andreika-git/hellen-one/modules/readme.md

This folder contains KiCAD footprints/gerbers/PDFs which hellen-one framework would merge into your frame design.

See https://github.com/andreika-git/hellen-one/wiki for module documentation
