andreika-git/hellen-one/modules/wbo/readme.md

[Source files](../../kicad/modules/hellen1-wbo)

## Changelog

0.6:
  - removed external MOSFET
  - reduced 3mm length
  - removed BIG thermal via
  - SOT-223 MOSFET

0.4:
  - two side assembly
  - BUG: CANH/CANL traces are flipped

0.3: 
  - MOSFET through-hole option 
  - https://github.com/andreika-git/hellen-one/blob/master/modules/wbo/wbo-0.3-migration.png remove one track and refill zones
     
0.3 v2:
  - 1mm vias under MOSFET for hand soldering

## Hardware Index
