andreika-git/hellen-one/modules/power_12and5V/readme.md

See https://github.com/andreika-git/hellen-one/wiki/module-power12-and-5

0.3
	- Vbat reverse diode on RTC LDO output

0.2
	- diodes silk fix
	- VIGN LED fix
