andreika-git/hellen-one/modules/power12/readme.md

See [power_12and5V](../power_12and5V) for a more integrated option.
