andreika-git/hellen-one/modules/vr-discrete/readme.md

See https://github.com/andreika-git/hellen-one/wiki/module-vr-discrete

[Source files](../../kicad/modules/hellen1-vr-discrete)
