andreika-git/hellen-one/modules/power5/0.2/power5-pcb3d.pdf

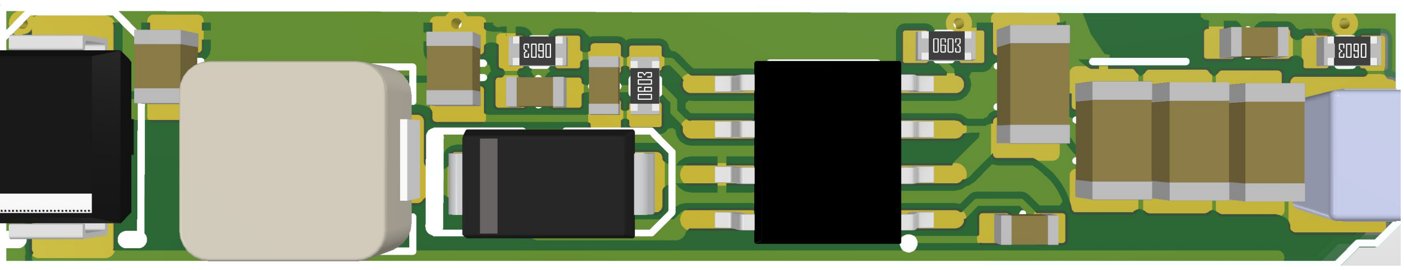
[picture p2: figure]
