andreika-git/hellen-one/modules/lin/0.1/lin-pcb3d.pdf

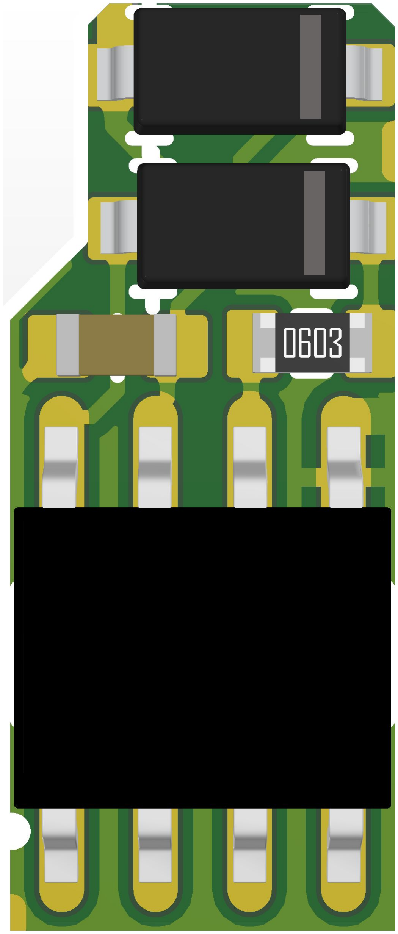
[picture p3: figure]
