andreika-git/hellen-one/modules/vr-max9924/0.1/vr-max9924-BOM.csv

Comment | Designator | Footprint | LCSC Part #
1n | C771 | C0603 | C1588
100n | C772 | C0603 | C14663
22u | C773 | C0603 | C59461
LED-GREEN-0603 | D771 | LED-0603 | C72043
Module:vr-max9924/0.1 | M771 | vr-max9924
4.7k | R771 | R1206 | C17936
4.7k | R772 | R1206 | C17936
4.7k | R773 | R1206 | C17936
4.7k | R774 | R1206 | C17936
DNP | R775 | R0603
10k | R776 | R0603 | C25804
10k | R777 | R0603 | C25804
MAX9924UAUB+ | U771 | MSOP-10_3x3mm_P0.5mm | C143633
