andreika-git/hellen-one/modules/knock/0.2/knock-BOM.csv

Comment | Designator | Footprint | LCSC Part #
100n | C470 | C0402 | C307331
3.3n | C471 | C0402 | C26404
330p | C472 | C0402 | C13533
47p | C473 | C0402 | C1567
680p | C474 | C0603 | C1630
Module:knock/0.2 | M470
470k | R470 | R0402 | C25790
100k | R471, R473 | R0402 | C25741
12k | R472 | R0402 | C25752
33k | R474 | R0402 | C25779
LMV321IDBVR | U470, U471 | SOT23-5 | C7972
