andreika-git/hellen-one/modules/sd/0.1/sd-BOM.csv

Comment | Designator | Footprint | LCSC Part #
22u | C450, C451 | C0603 | C59461
Molex MicroSD 47219-2001 | J450 | SDAMB-012 | C164170
Hellen One : microSD Module interface | M450
33k | R450 | R0603 | C4216
