andreika-git/hellen-one/modules/lin/0.1/lin-BOM.csv

Comment | Designator | Footprint | LCSC Part #
100n | C440 | C0603 | C14663
B5819W | D440, D441 | SOD-123 | C8598
Hellen One : LIN Module interface | M440
1k | R440 | R0603 | C21190
TJA1021T/20/CM | U440 | SO8 | C128810
