andreika-git/hellen-one/tests/boards.EXAMPLE/hellen1test-a/frame/1test-BOM.csv

Comment | Designator | Footprint | LCSC Part #
Module:can/0.1 | M1 | can
Pad | P1 | PAD-TH
Pad | P2 | PAD-TH
Pad | P3 | PAD-TH
Pad | P4 | PAD-TH
Pad | P5 | PAD-TH
Pad | P6 | PAD-TH
Pad | P7 | PAD-TH
