andreika-git/hellen-one/tests/gerber/hellen1test.csv

Comment | Designator | Footprint | LCSC Part #
Module-can-0.1 | M1 | hellen-one-can-0.1:can
Pad | P1 | hellen-one-common:PAD-TH
Pad | P2 | hellen-one-common:PAD-TH
Pad | P3 | hellen-one-common:PAD-TH
Pad | P4 | hellen-one-common:PAD-TH
Pad | P5 | hellen-one-common:PAD-TH
Pad | P6 | hellen-one-common:PAD-TH
Pad | P7 | hellen-one-common:PAD-TH
