andreika-git/hellen-one/modules/uaefi/0.2/uaefi-BOM.csv

Comment | Designator | Footprint | LCSC Part #
Conn_01x05_Pin | J801 | Molex_SPOX_5267-05A_1x05_P2.50mm_Vertical | C492404
Conn_01x03_Pin | J802 | 1x3_2.54 | C49257
Conn_02x02_Odd_Even | J803 | 2x2_2.54 | C492419
Conn_02x02_Odd_Even | J804 | 2x2_2.54 | C492419
Conn_02x02_Odd_Even | J805 | 2x2_2.54 | C492419
Conn_02x02_Odd_Even | J806 | 2x2_2.54 | C492419
Conn_02x02_Odd_Even | J807 | 2x2_2.54 | C492419
Conn_02x02_Odd_Even | J808 | 2x2_2.54 | C492419
Conn_02x02_Odd_Even | J809 | 2x2_2.54 | C492419
Conn_02x02_Odd_Even | J810 | 2x2_2.54 | C492419
Conn_02x02_Odd_Even | J811 | 2x2_2.54 | C492419
Conn_02x02_Odd_Even | J812 | 2x2_2.54 | C492419
Conn_02x02_Odd_Even | J813 | 2x2_2.54 | C492419
Conn_02x02_Odd_Even | J814 | 2x2_2.54 | C492419
Conn_02x02_Odd_Even | J815 | 2x2_2.54 | C492419
Conn_02x02_Odd_Even | J816 | 2x2_2.54 | C492419
Module:uaefi/0.2 | M801 | uaefi
Conn_01x01_Pin | P801 | 1x1 | C81276
Conn_01x01_Pin | P802 | 1x1 | C81276
Conn_01x01_Pin | P803 | 1x1 | C81276
Conn_01x01_Pin | P804 | 1x1 | C81276
Conn_01x01_Pin | P805 | 1x1 | C81276
RT-01T-1.0B | P806 | RT-01T-1.0B | C265321
RT-01T-1.0B | P807 | RT-01T-1.0B | C265321
RT-01T-1.0B | P808 | RT-01T-1.0B | C265321
RT-01T-1.0B | P809 | RT-01T-1.0B | C265321
RT-01T-1.0B | P810 | RT-01T-1.0B | C265321
RT-01T-1.0B | P811 | RT-01T-1.0B | C265321
RT-01T-1.0B | P812 | RT-01T-1.0B | C265321
RT-01T-1.0B | P813 | RT-01T-1.0B | C265321
RT-01T-1.0B | P814 | RT-01T-1.0B | C265321
RT-01T-1.0B | P815 | RT-01T-1.0B | C265321
RT-01T-1.0B | P816 | RT-01T-1.0B | C265321
RT-01T-1.0B | P817 | RT-01T-1.0B | C265321
RT-01T-1.0B | P818 | RT-01T-1.0B | C265321
RT-01T-1.0B | P819 | RT-01T-1.0B | C265321
RT-01T-1.0B | P820 | RT-01T-1.0B | C265321
RT-01T-1.0B | P821 | RT-01T-1.0B | C265321
RT-01T-1.0B | P822 | RT-01T-1.0B | C265321
RT-01T-1.0B | P823 | RT-01T-1.0B | C265321
RT-01T-1.0B | P824 | RT-01T-1.0B | C265321
RT-01T-1.0B | P825 | RT-01T-1.0B | C265321
RT-01T-1.0B | P826 | RT-01T-1.0B | C265321
RT-01T-1.0B | P827 | RT-01T-1.0B | C265321
RT-01T-1.0B | P828 | RT-01T-1.0B | C265321
RT-01T-1.0B | P829 | RT-01T-1.0B | C265321
RT-01T-1.0B | P830 | RT-01T-1.0B | C265321
RT-01T-1.0B | P831 | RT-01T-1.0B | C265321
RT-01T-1.0B | P832 | RT-01T-1.0B | C265321
RT-01T-1.0B | P833 | RT-01T-1.0B | C265321
RT-01T-1.0B | P834 | RT-01T-1.0B | C265321
RT-01T-1.0B | P835 | RT-01T-1.0B | C265321
RT-01T-1.0B | P836 | RT-01T-1.0B | C265321
RT-01T-1.0B | P837 | RT-01T-1.0B | C265321
RT-01T-1.0B | P838 | RT-01T-1.0B | C265321
RT-01T-1.0B | P839 | RT-01T-1.0B | C265321
RT-01T-1.0B | P840 | RT-01T-1.0B | C265321
RT-01T-1.0B | P841 | RT-01T-1.0B | C265321
RT-01T-1.0B | P842 | RT-01T-1.0B | C265321
RT-01T-1.0B | P843 | RT-01T-1.0B | C265321
RT-01T-1.0B | P844 | RT-01T-1.0B | C265321
RT-01T-1.0B | P845 | RT-01T-1.0B | C265321
RT-01T-1.0B | P846 | RT-01T-1.0B | C265321
RT-01T-1.0B | P847 | RT-01T-1.0B | C265321
RT-01T-1.0B | P848 | RT-01T-1.0B | C265321
RT-01T-1.0B | P849 | RT-01T-1.0B | C265321
RT-01T-1.0B | P850 | RT-01T-1.0B | C265321
RT-01T-1.0B | P851 | RT-01T-1.0B | C265321
RT-01T-1.0B | P852 | RT-01T-1.0B | C265321
RT-01T-1.0B | P853 | RT-01T-1.0B | C265321
RT-01T-1.0B | P854 | RT-01T-1.0B | C265321
RT-01T-1.0B | P855 | RT-01T-1.0B | C265321
RT-01T-1.0B | P856 | RT-01T-1.0B | C265321
RT-01T-1.0B | P857 | RT-01T-1.0B | C265321
RT-01T-1.0B | P858 | RT-01T-1.0B | C265321
RT-01T-1.0B | P859 | RT-01T-1.0B | C265321
RT-01T-1.0B | P860 | RT-01T-1.0B | C265321
RT-01T-1.0B | P861 | RT-01T-1.0B | C265321
RT-01T-1.0B | P862 | RT-01T-1.0B | C265321
RT-01T-1.0B | P863 | RT-01T-1.0B | C265321
RT-01T-1.0B | P864 | RT-01T-1.0B | C265321
RT-01T-1.0B | P865 | RT-01T-1.0B | C265321
RT-01T-1.0B | P866 | RT-01T-1.0B | C265321
RT-01T-1.0B | P867 | RT-01T-1.0B | C265321
RT-01T-1.0B | P868 | RT-01T-1.0B | C265321
RT-01T-1.0B | P869 | RT-01T-1.0B | C265321
RT-01T-1.0B | P870 | RT-01T-1.0B | C265321
RT-01T-1.0B | P871 | RT-01T-1.0B | C265321
RT-01T-1.0B | P872 | RT-01T-1.0B | C265321
RT-01T-1.0B | P873 | RT-01T-1.0B | C265321
