andreika-git/hellen-one/kicad/models/DPAK-5.STEP

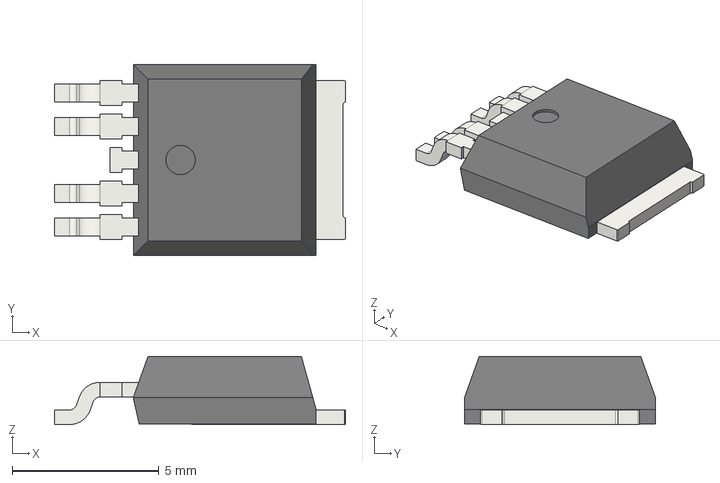
[picture p6: CAD file, 2022-02-14]
kicad/models/DPAK-5.STEP
9.90 x 6.50 x 2.32 mm
