andreika-git/hellen-one/kicad/models/SOT-23.STEP

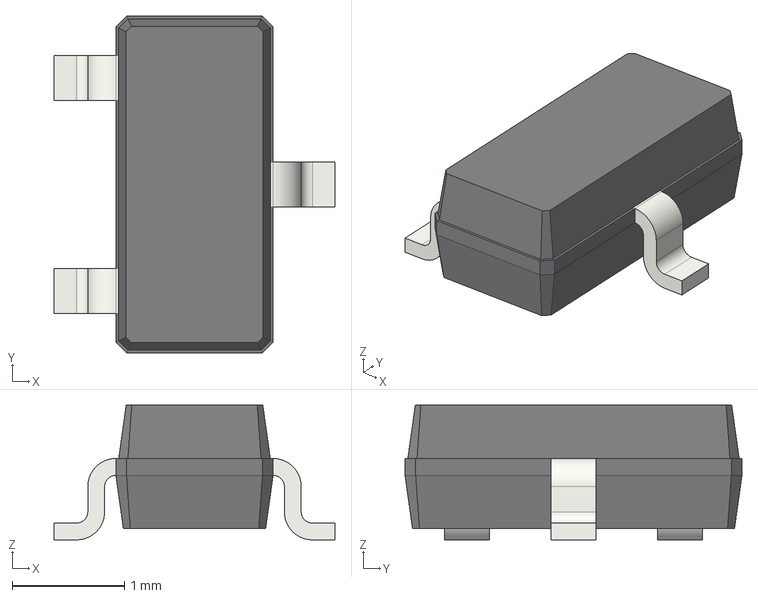
[picture p7: CAD file, 2021-12-24]
kicad/models/SOT-23.STEP
2.50 x 3.00 x 1.20 mm
