andreika-git/hellen-one/kicad/models/DPAK.STEP

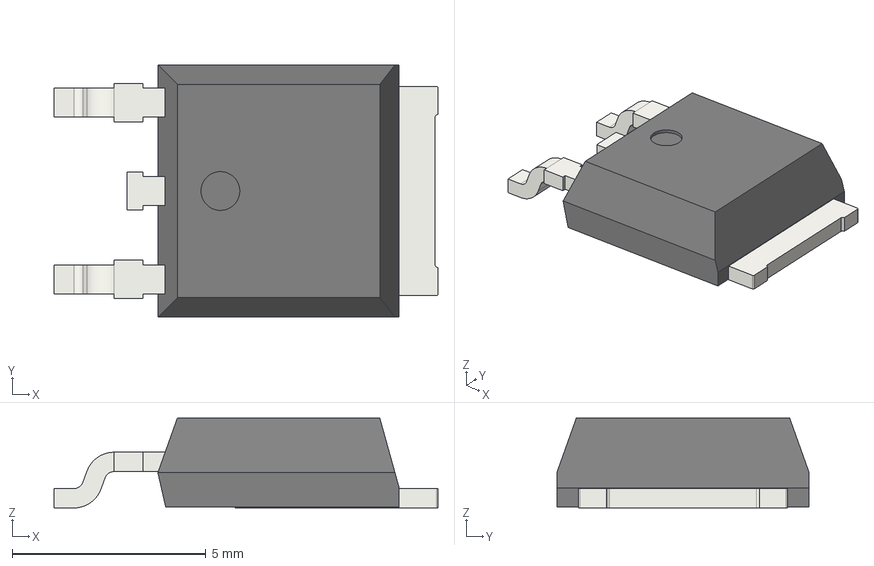
[picture p8: CAD file, 2021-12-24]
kicad/models/DPAK.STEP
9.90 x 6.50 x 2.32 mm
