andreika-git/hellen-one/kicad/models/PG-DSO-8.STEP

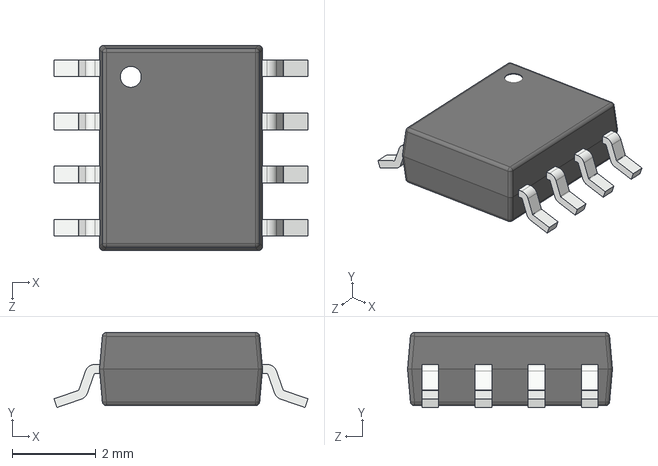
[picture p9: CAD file, 2021-12-20]
kicad/models/PG-DSO-8.STEP
6.07 x 1.79 x 4.90 mm
