andreika-git/hellen-one/kicad/models/PinHeader_2x05_P1.27mm_Vertical_SMD.STEP

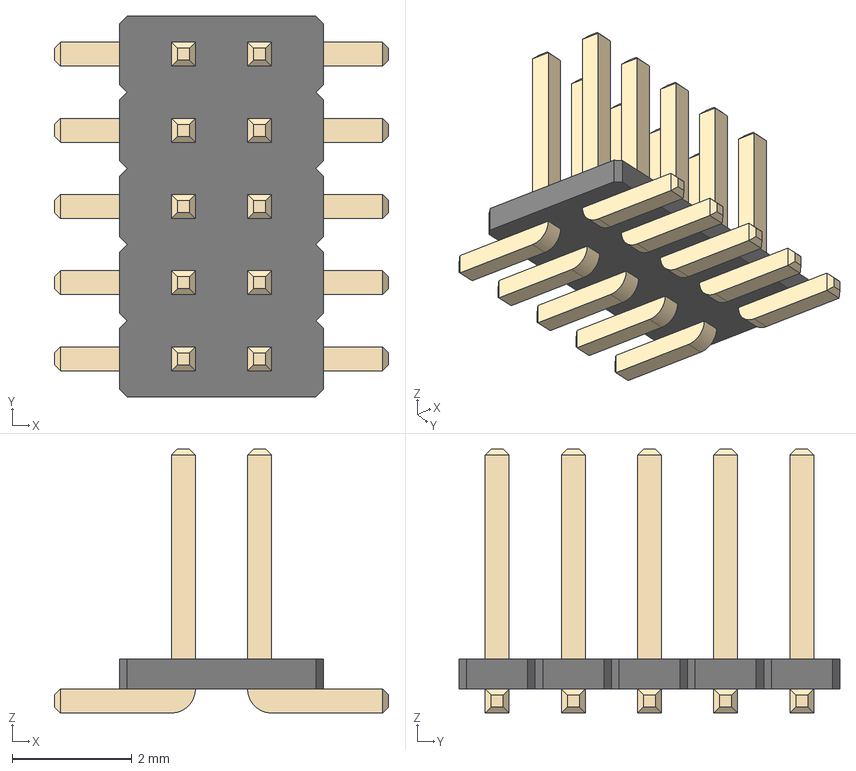
[picture p11: CAD file, 2021-12-20]
kicad/models/PinHeader_2x05_P1.27mm_Vertical_SMD.STEP
5.57 x 6.35 x 4.40 mm
