andreika-git/hellen-one/kicad/models/PinHeader_1x06_P2.54mm_Vertical.STEP

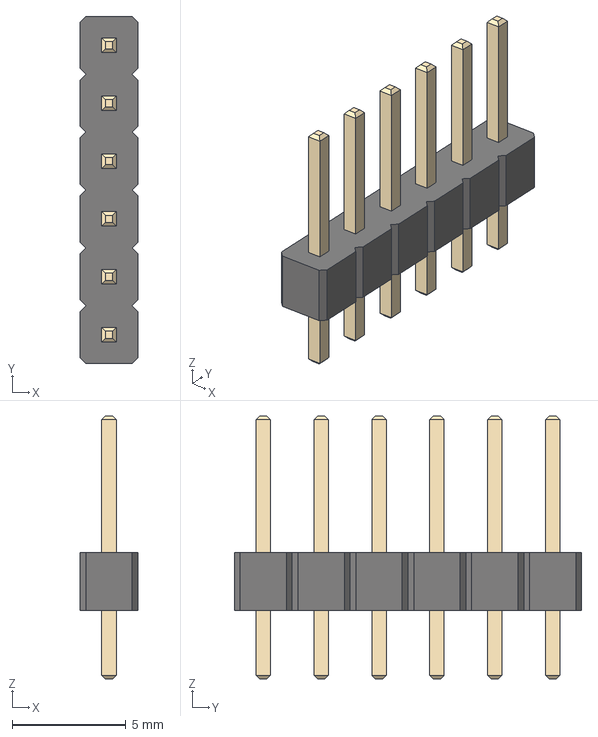
[picture p12: CAD file, 2021-12-20]
kicad/models/PinHeader_1x06_P2.54mm_Vertical.STEP
2.54 x 15.2 x 11.5 mm
