andreika-git/hellen-one/kicad/models/MPXH6400A.STEP

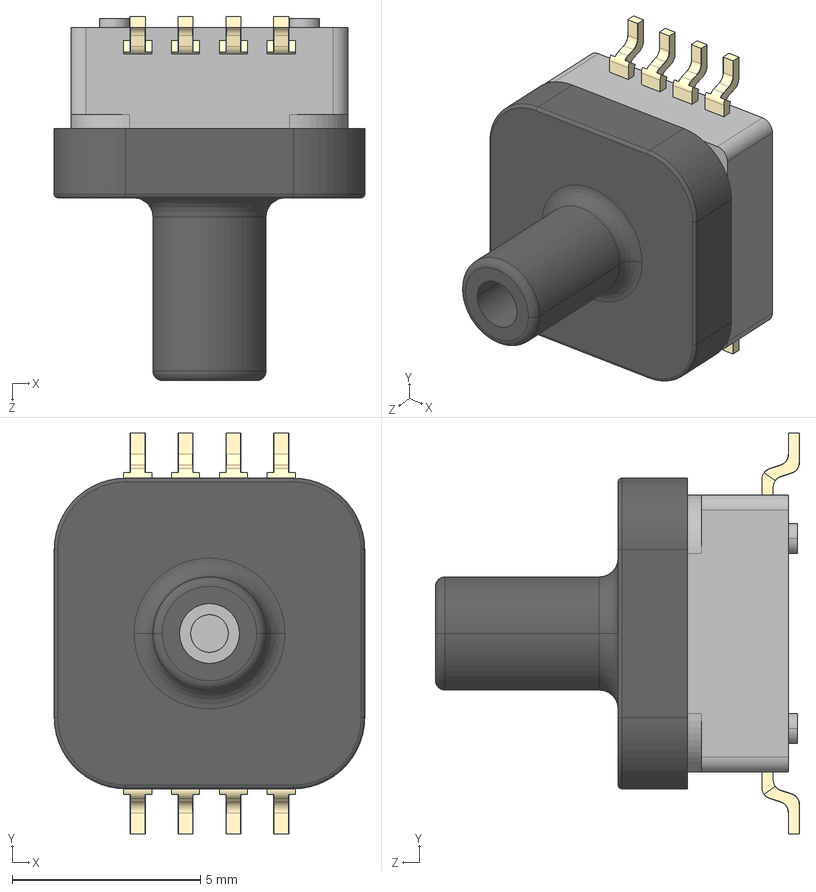
[picture p13: CAD file, 2021-12-20]
kicad/models/MPXH6400A.STEP
8.25 x 10.7 x 9.67 mm
User Library-ZlozenieMPXH6400A_Komin
User Library-ZlozenieMPXH6400A_podstawa
User Library-ZlozenieMPXH6400A_NOGA x 8
