andreika-git/hellen-one/kicad/models/USB-Mini-B-Horizontal.STEP

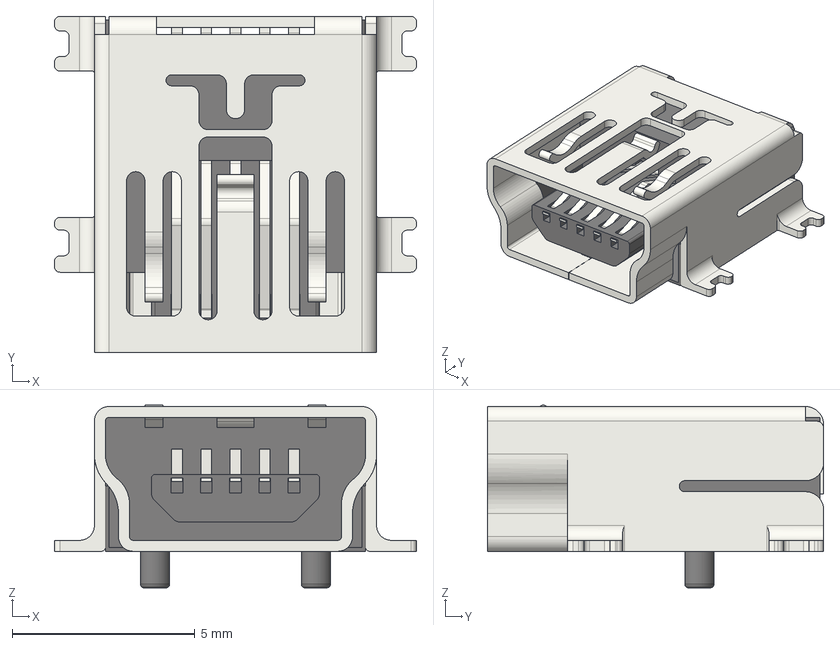
[picture p14: CAD file, 2021-12-19]
kicad/models/USB-Mini-B-Horizontal.STEP
9.90 x 9.20 x 5.00 mm
