andreika-git/hellen-one/kicad/models/SOD123F.STEP

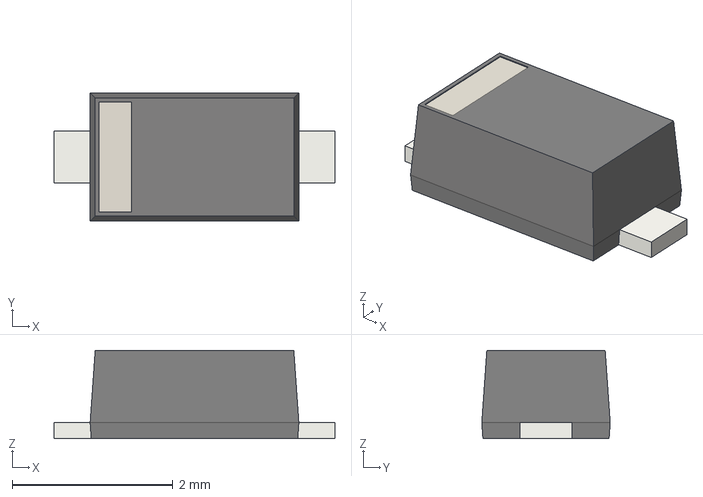
[picture p15: CAD file, 2021-09-09]
kicad/models/SOD123F.STEP
3.50 x 1.60 x 1.10 mm
