andreika-git/hellen-one/kicad/models/DO-214AA(SMB).STEP

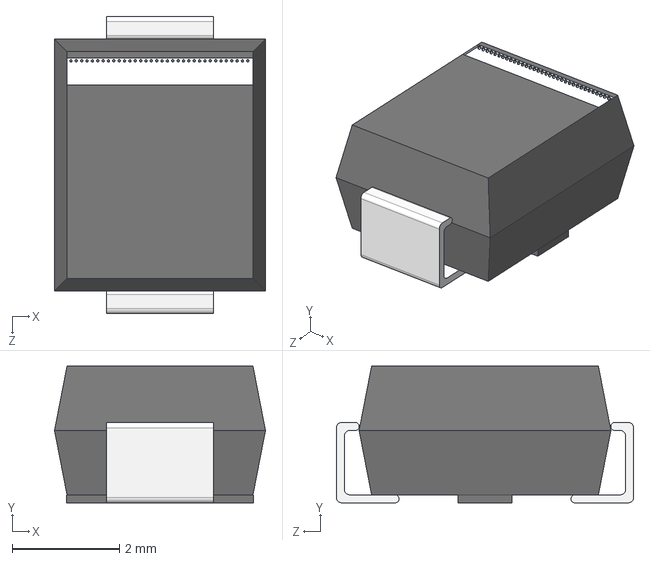
[picture p16: CAD file, 2021-05-19]
kicad/models/DO-214AA(SMB).STEP
3.94 x 2.55 x 5.55 mm
