andreika-git/hellen-one/kicad/models/0603 cap.STEP

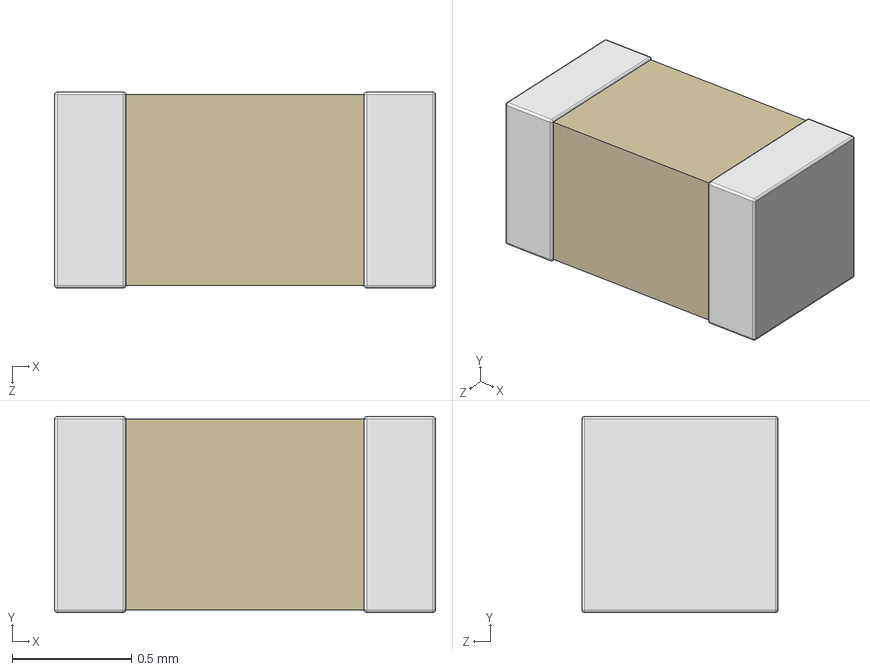
[picture p17: CAD file, 2021-05-19]
kicad/models/0603 cap.STEP
1.60 x 0.824 x 0.824 mm
