andreika-git/hellen-one/kicad/models/SOIC16 narrow.STEP

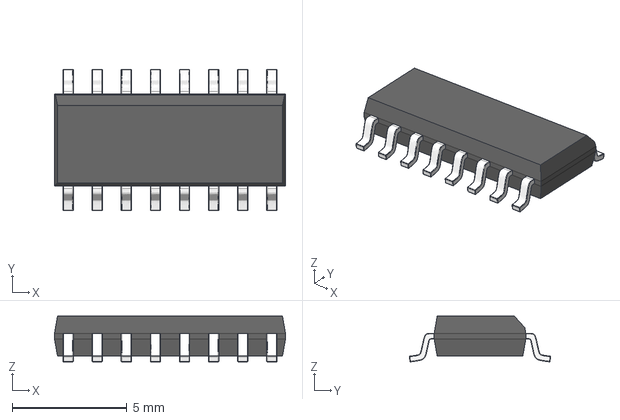
[picture p18: CAD file, 2021-05-19]
kicad/models/SOIC16 narrow.STEP
10.1 x 6.16 x 2.00 mm
