andreika-git/hellen-one/kicad/models/sot-23-6.stp

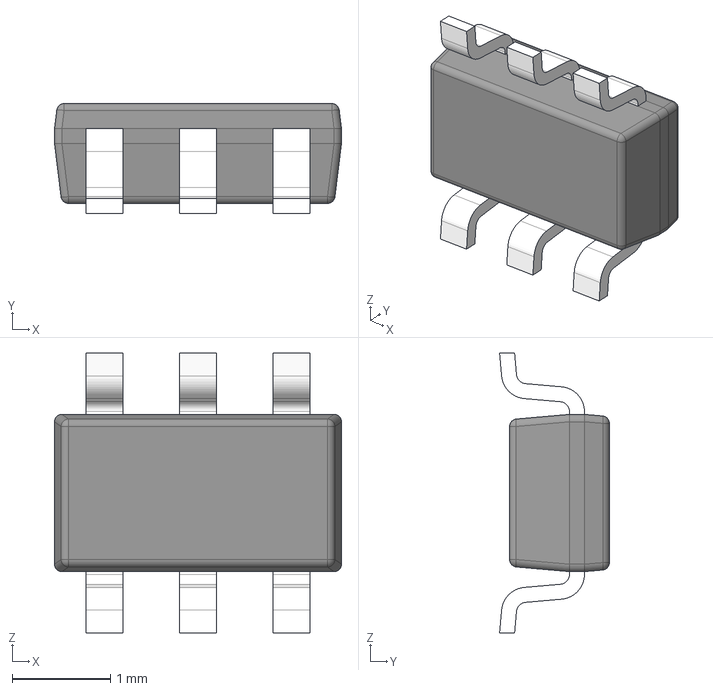
[picture p19: CAD file, 2021-05-19]
kicad/models/sot-23-6.stp
2.92 x 1.12 x 2.84 mm
BODY_MF06A
LEAD_MF06A x 6
