andreika-git/hellen-one/kicad/models/LED0805-YELLOW.STEP

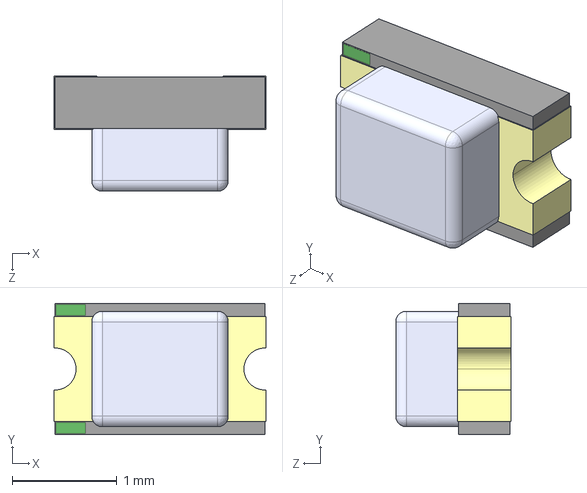
[picture p20: CAD file, 2021-05-19]
kicad/models/LED0805-YELLOW.STEP
2.02 x 1.25 x 1.10 mm
