andreika-git/hellen-one/kicad/models/DO-215AD.stp

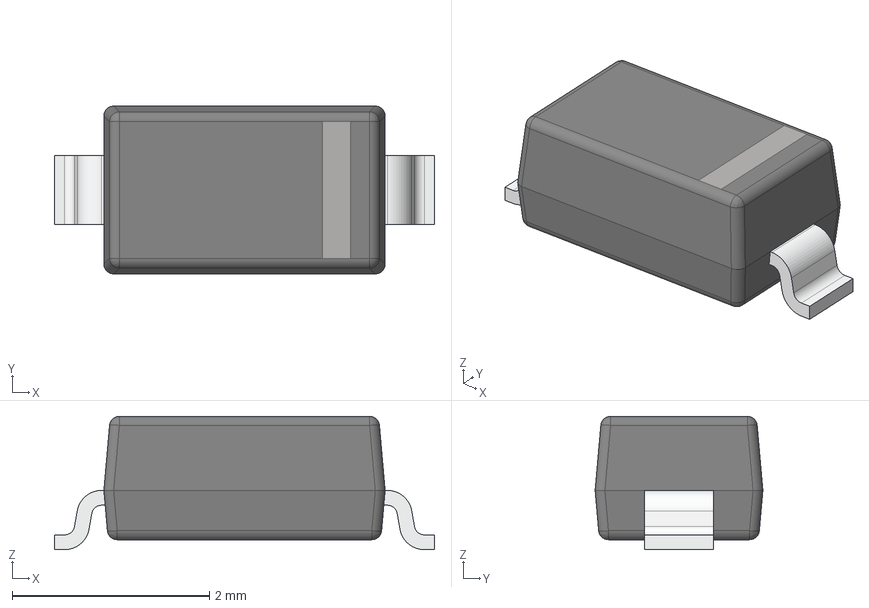
[picture p21: CAD file, 2021-05-19]
kicad/models/DO-215AD.stp
3.85 x 1.70 x 1.35 mm
