andreika-git/hellen-one/kicad/models/1206 resistor.STEP

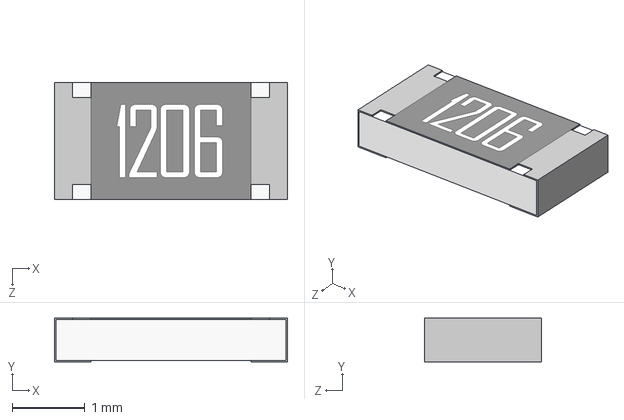
[picture p22: CAD file, 2021-05-19]
kicad/models/1206 resistor.STEP
3.20 x 0.6 x 1.60 mm
