andreika-git/hellen-one/kicad/models/CAY16-F4.STEP

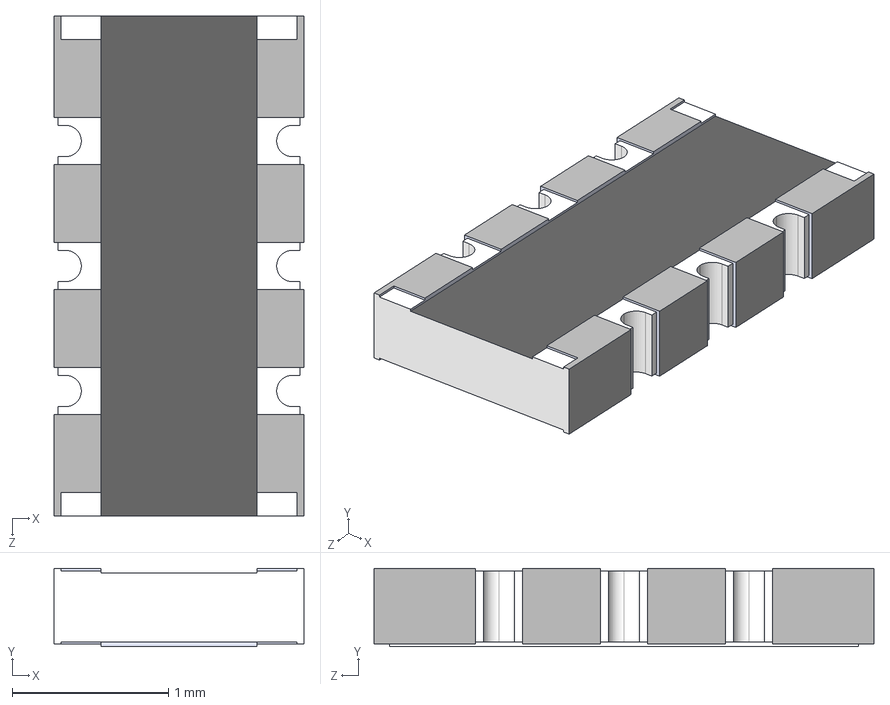
[picture p23: CAD file, 2021-05-19]
kicad/models/CAY16-F4.STEP
1.60 x 0.5 x 3.20 mm
