andreika-git/hellen-one/kicad/models/MPX4250AP.STEP

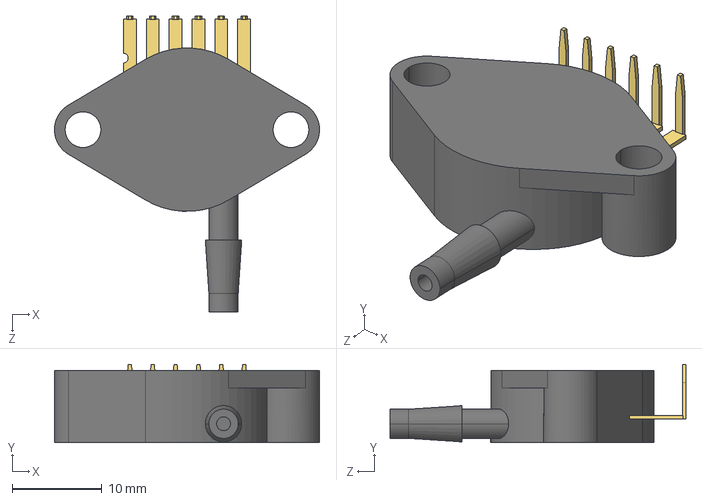
[picture p24: CAD file, 2021-05-19]
kicad/models/MPX4250AP.STEP
29.5 x 8.72 x 32.9 mm
