andreika-git/hellen-one/kicad/models/SOD323F.STEP

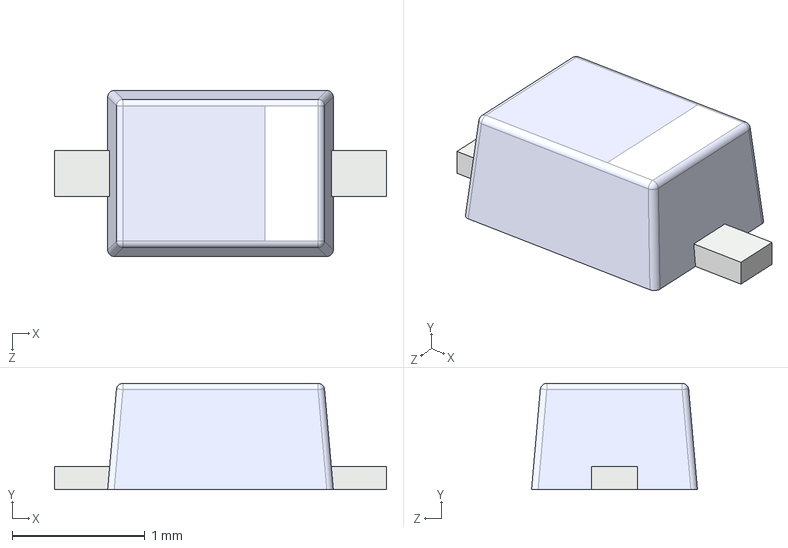
[picture p25: CAD file, 2021-05-19]
kicad/models/SOD323F.STEP
2.50 x 0.8 x 1.25 mm
