andreika-git/hellen-one/kicad/models/SOIC08 narrow.STEP

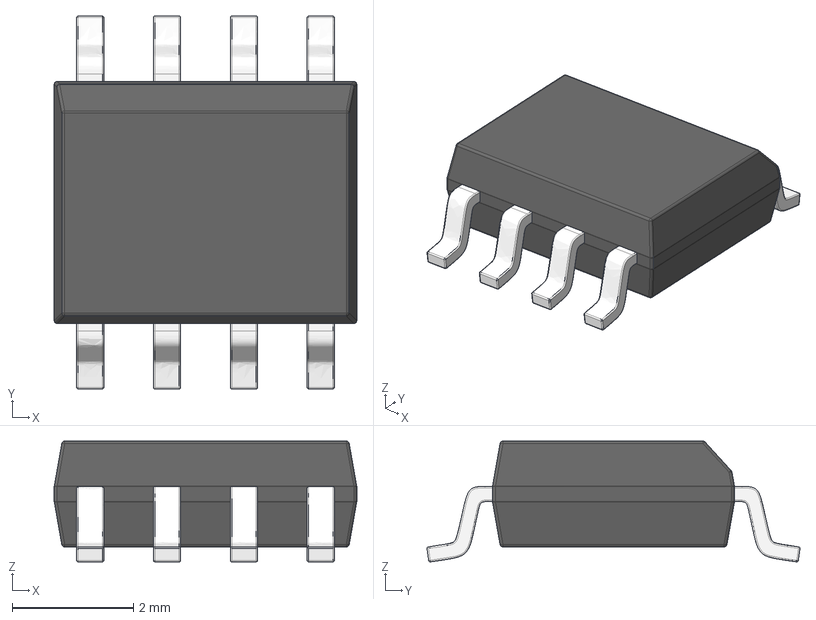
[picture p26: CAD file, 2021-05-19]
kicad/models/SOIC08 narrow.STEP
5.00 x 6.16 x 2.00 mm
