andreika-git/hellen-one/kicad/models/USB-B-Vertical.step

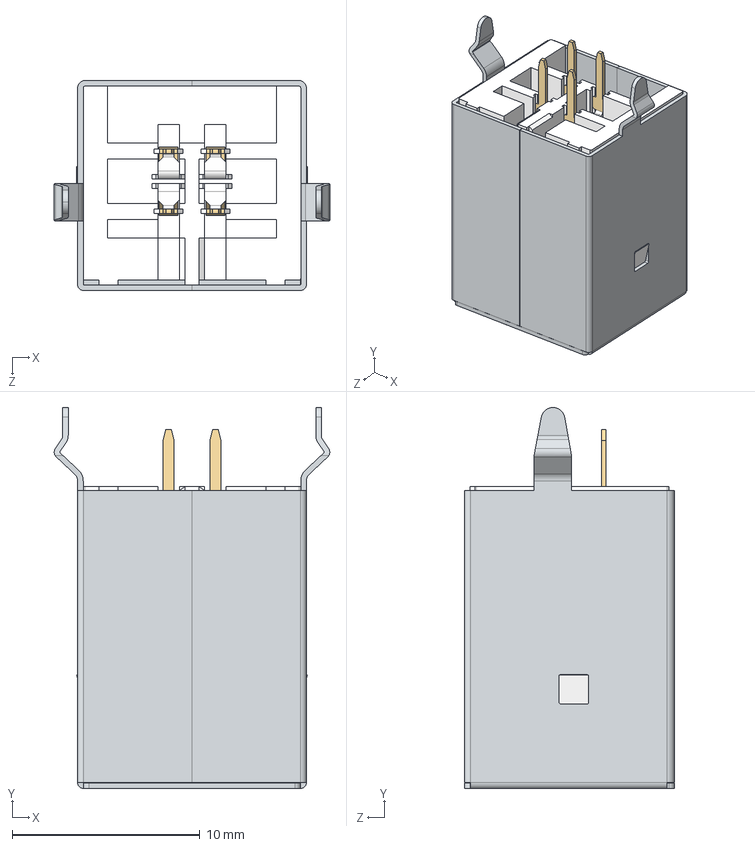
[picture p27: CAD file, 2021-05-19]
kicad/models/USB-B-Vertical.step
14.7 x 20.3 x 11.2 mm
DEFAULT-0.STEP
DEFAULT-1.STEP x 2
DEFAULT-2.STEP x 2
DEFAULT-3.STEP
