andreika-git/hellen-one/kicad/models/0603 resistor.STEP

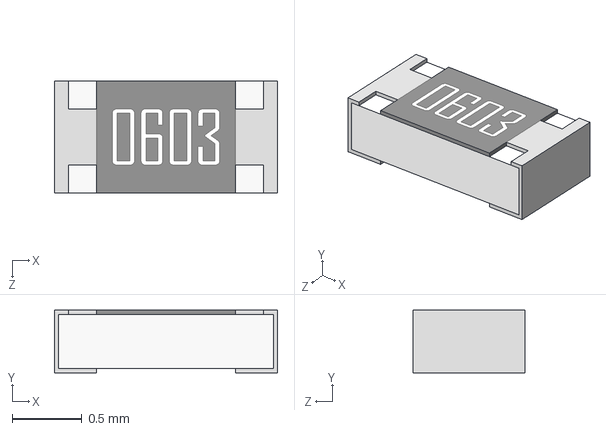
[picture p28: CAD file, 2021-05-19]
kicad/models/0603 resistor.STEP
1.60 x 0.45 x 0.8 mm
