andreika-git/hellen-one/kicad/models/0805 cap.STEP

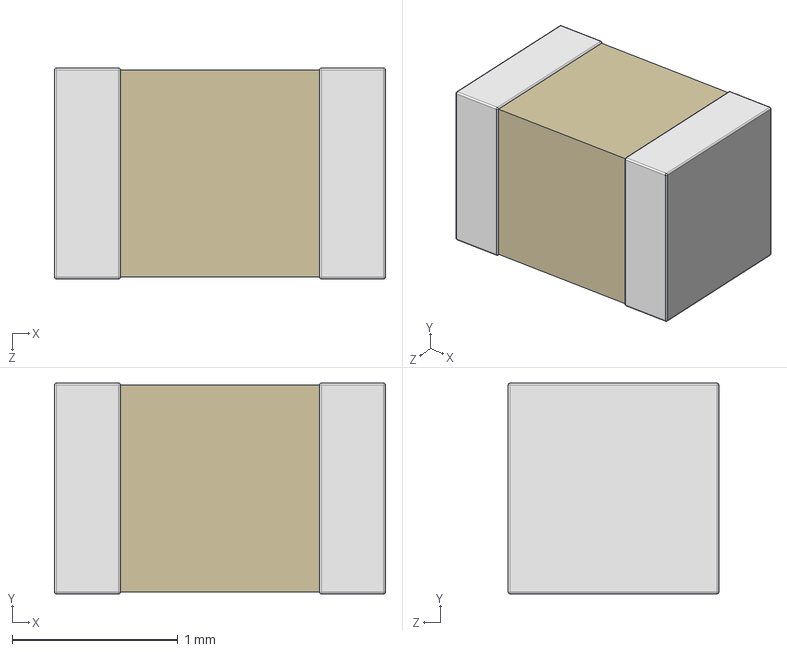
[picture p29: CAD file, 2021-05-19]
kicad/models/0805 cap.STEP
2.00 x 1.27 x 1.27 mm
