andreika-git/hellen-one/kicad/models/0805 resistor.STEP

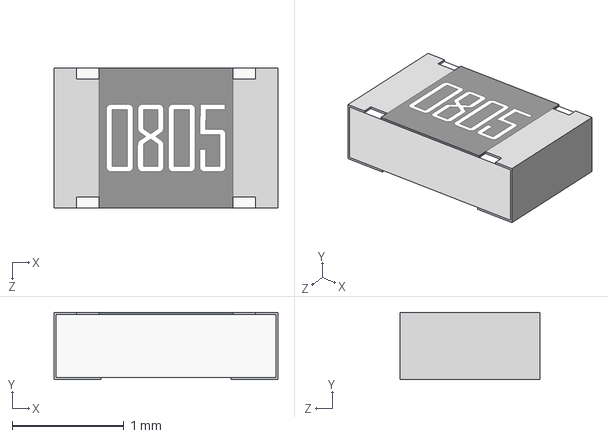
[picture p30: CAD file, 2021-05-19]
kicad/models/0805 resistor.STEP
2.00 x 0.6 x 1.25 mm
