andreika-git/hellen-one/kicad/models/0402 resistor.STEP

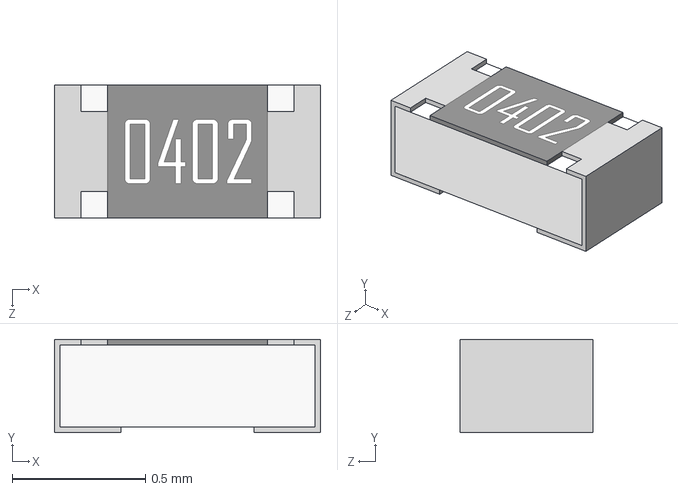
[picture p31: CAD file, 2021-05-19]
kicad/models/0402 resistor.STEP
1.00 x 0.35 x 0.5 mm
