andreika-git/hellen-one/kicad/models/SKRKAHE020.STEP

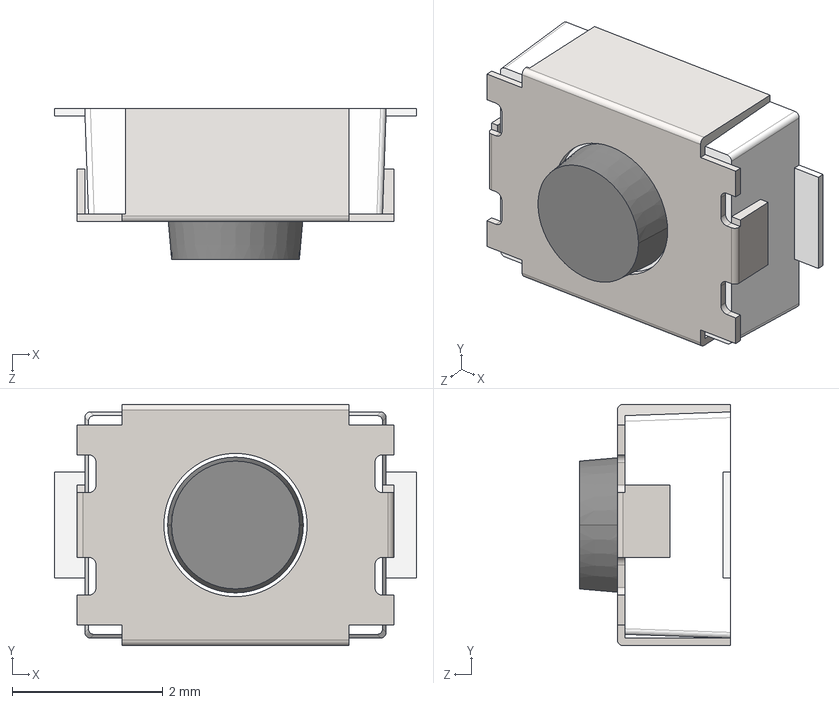
[picture p32: CAD file, 2021-05-19]
kicad/models/SKRKAHE020.STEP
4.80 x 3.20 x 2.00 mm
