andreika-git/hellen-one/kicad/models/SOT-363.STEP

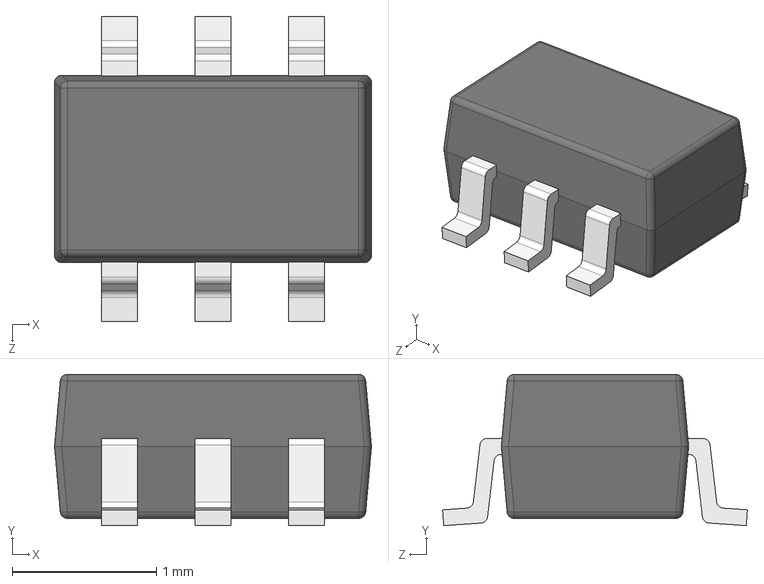
[picture p33: CAD file, 2021-05-19]
kicad/models/SOT-363.STEP
2.20 x 1.05 x 2.12 mm
