andreika-git/hellen-one/kicad/models/SOT-223.STEP

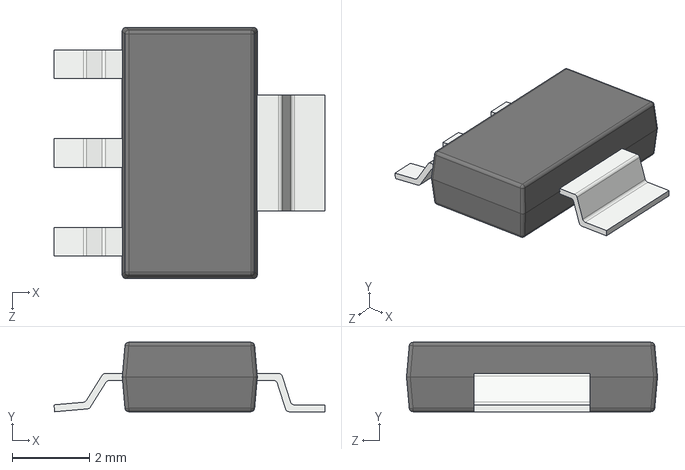
[picture p34: CAD file, 2021-05-19]
kicad/models/SOT-223.STEP
7.02 x 1.80 x 6.50 mm
