andreika-git/hellen-one/kicad/models/TSSOP14.STEP

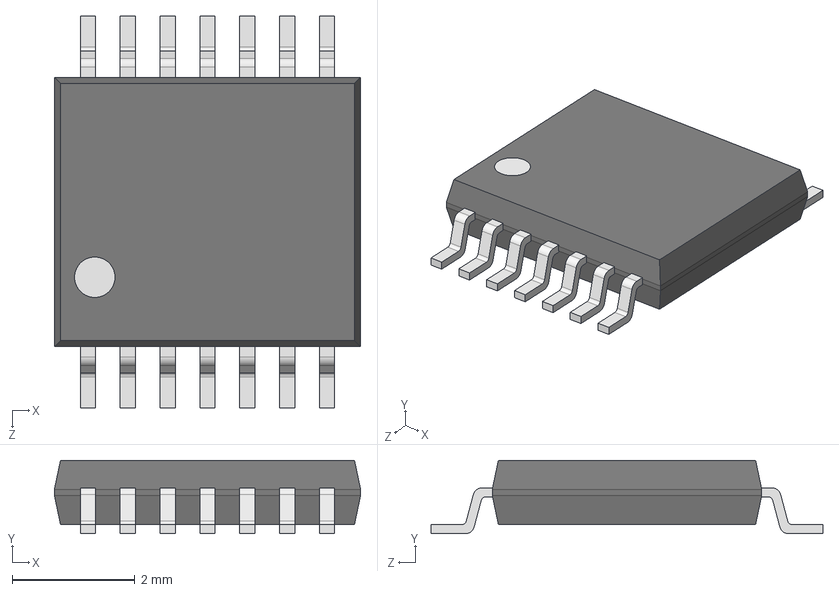
[picture p35: CAD file, 2021-05-19]
kicad/models/TSSOP14.STEP
5.00 x 1.20 x 6.40 mm
User Library-TSSOP-14__X2_041A043E0440043F04430441_X0_
User Library-TSSOP-14__X2_041C04350442043A0430_X0_
User Library-TSSOP-14__X2_041D043E0436043A0430_X0_ x 7
