andreika-git/hellen-one/kicad/models/PowerSO20.STEP

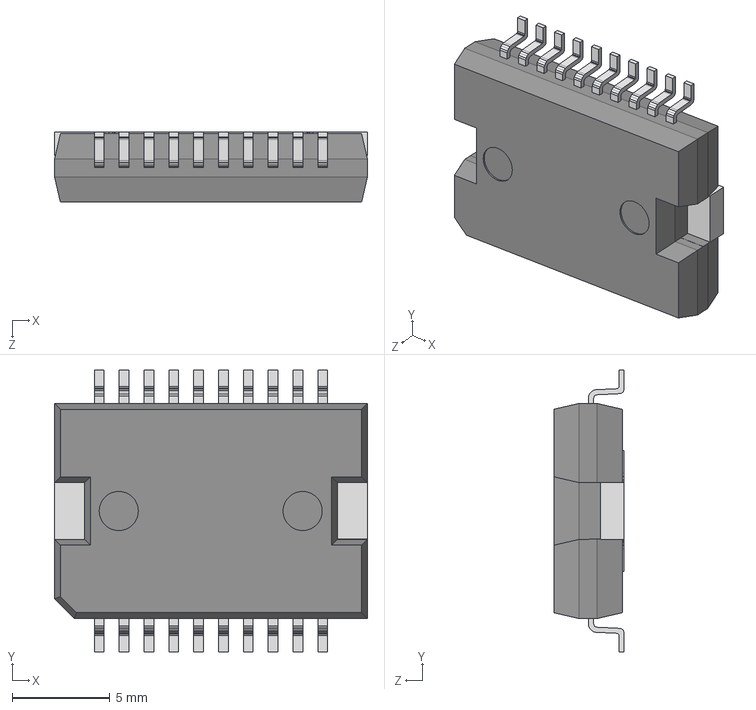
[picture p36: CAD file, 2021-05-19]
kicad/models/PowerSO20.STEP
16.0 x 14.4 x 3.60 mm
Fusion_(Solid)
Fusion001_(Solid)
