andreika-git/hellen-one/kicad/models/LGA-12-2x2x0_9.STEP

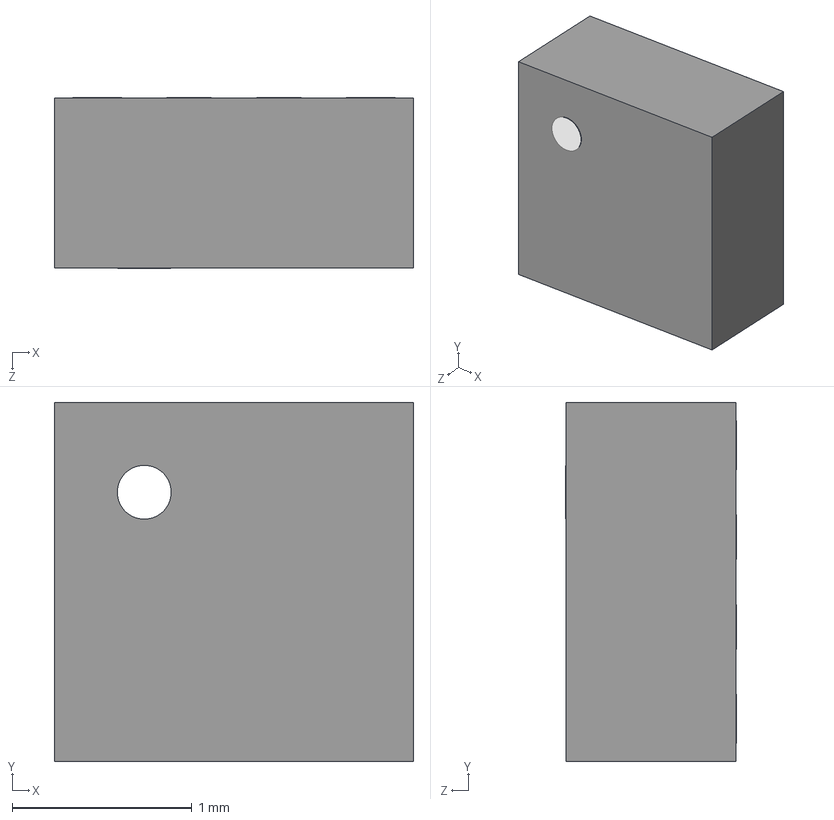
[picture p37: CAD file, 2021-05-19]
kicad/models/LGA-12-2x2x0_9.STEP
2.00 x 2.00 x 0.955 mm
