andreika-git/hellen-one/tests/boards.EXAMPLE/hellen1test-a/board/hellen1test-a.png

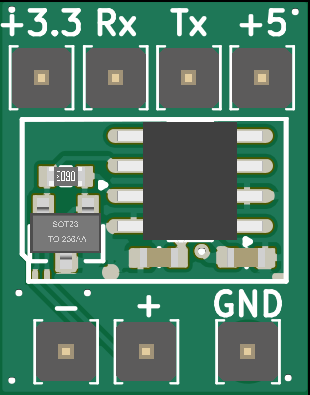
tests/boards.EXAMPLE/hellen1test-a/board/hellen1test-a.png
