andreika-git/hellen-one/tests/boards.EXAMPLE/hellen1test-a/board/misc/hellen1test-a-bottom.png

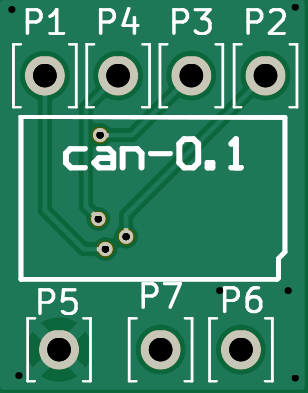
tests/boards.EXAMPLE/hellen1test-a/board/misc/hellen1test-a-bottom.png
