andreika-git/hellen-one/(threads)

Thread 1 (2021-02-16):

DFU does not work on a brand new board

rusefillc, 2021-02-16:
See https://rusefi.com/forum/viewtopic.php?p=39808#p39808 for a theory

rusefillc, 2021-02-16:
@andreika-git is there a resistor we can remove from hellen72b to try the fix? would it be a useful test?

andreika-git, 2021-02-16:
The only fix for Hellen72b I can think of is to carefully cut a trace between A22 and PB2 here:
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

andreika-git, 2021-02-16:
The solution for the next module rev: add a track jumper to the MCU module near the R128 to connect A22 and PB2 only for H7 configs. (AUX3 (A22) input cannot have a pull-up because it causes a conflict with BOOT1 on PB2 (COMP1_INP on H7))

Also, for the next Hellen72 revision we can optimize the input connections even further:
IN_CLUTCH -> RES3 (free EXTI5 and use EXTI8)
IN_EGR -> AUX3 (move from ADC3 to ADC12)
IN_NEUTRAL -> SENS3 (use EXTI5)
IN_FUEL_LEVEL -> AUX2 (move from ADC3 to ADC12)

andreika-git, 2021-02-23:
Added a tiny jumper resistor to the MCU module (not populated by default):
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

Closed 2021-03-04.

Thread 2 (2021-02-16):

power off issues including ULN2003 flyback diode: parasitic power from main relay

andreika-git, 2021-02-16:
Problem statement: Unlike TLE6240 and other smart low-side drivers with active clamp protection, ULN2003 has a simple internal flyback diode connected to an external +12V power line. When the ECU power is off, the voltage is still present on the main relay coil (connected to the battery) and thus the V12PROT bus is powered via the flyback diode, causing parasitic power for ECU and also triggering the main relay.
The output module needs to be corrected to solve this issue.

The solution for the next revision: use an additional TVS for clamping the ULN2003 instead of the ECU power.

The temporary solution for Hellen72b:
1) Remove R314 (0.1 Ohms 1206) - to disconnect V12P from V12PROT:
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

2) Remove R310 and R312 - to disconnect push-pull drivers from V12PROT:
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

3) Connect these two pads to +12V - to reconnect the power of push-pull drivers:
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

rusefillc, 2021-02-17:
things are better but still three issues, @stefansf FYI

1) https://youtu.be/OEqeKp4ilVw blink if #3 plugged after #2

2) things light up BRIGHT if #2, #4, #3 inserted & ignition turned on

3) ECU does not turn off on ignition OFF

andreika-git, 2021-02-17:
Hellen72b has an additional issue with D49, you need to remove it too:
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

rusefillc, 2021-02-17:
coil LEDs are ON when they should not be?
ECU does not turn off

https://youtu.be/yGyNm7tmKyg

https://youtu.be/wGY7qok-m8o

https://youtu.be/YMbyt41SUfI

rusefillc, 2021-02-23:
Also related or different issue: random shut-off situation

1) turn IGN on, turn off within next few seconds: ECU shuts down instantaniously

2) turn IGN on, turn of after more than few seconds (still no cranking): ECU takes some time to shut off

3) major cranking attempts / after engine was running: ECU does not turn off

all these tests turning ON and OFF was happening with PC disconnected. there was some hot PC plugging and unplugging in test #3

rusefillc, 2021-05-19:
Done?

Closed 2021-05-19.

Thread 3 (2021-02-17):

hellen72: RED and BLUE LEDs on MCU module constantly ON

rusefillc, 2021-02-17:
With wrong MRE firmware RED "critical" was not ON

With proper Hellen firmware red and blue LEDs are constantly ON while TS and console shows no critical error?

andreika-git, 2021-02-17:
All 4 LEDs work in inverted mode. When the pin is "0", the LED is on.

rusefillc, 2021-02-17:
is that a feature or a bug?

andreika-git, 2021-02-17:
It's more like a taste preference. Or "holy war" :)
It origins from old TTL logic gates, where source current has higher limits than sink current, also it slightly offloads the mcu power and makes it less noisy (the "load" current flows only to the ground).

rusefillc, 2021-02-17:
I hope that's not insanity

rusefillc, 2021-02-18:
fixed in SW

Closed 2021-02-18.

Thread 4 (2021-02-19):

Testing: push-pull outputs as alternator and tachometer on Hellen72

andreika-git, 2021-02-19:
We need to test if current push-pull outputs capable of driving Miata alternator and tachometer.
For Hellen72b, we need a jumper wire for that test:
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

Thread 6 (2021-02-19):

Testing: OUT_COIL_A|B|1|2 as ETB (and EGR Valve on Hellen72)

andreika-git, 2021-02-19:
We need to test whether high-power push-pull drivers are capable of:
1) driving an external ETB (this is needed for future boards, not Hellen72, but we can test it on the current hw)
2) driving the Miata's EGR Valve solenoids.
  * Note that for EGR Valve the coil LEDs are "inverted"
  * Also we need to find a better name for the outputs instead of just "COIL" to avoid confusing with ignition coils. Maybe "solenoid"?

andreika-git, 2021-05-29:
https://youtu.be/CDnJQ1TCQ6s

mck1117, 2021-05-29:
Not sure I love the little heat sink, but it does work.

Thread 7 (2021-02-19):

More testing for VR sensor

andreika-git, 2021-02-19:
We need to find the way to continue testing of Hellen inputs for VR sensors (not only Hall). Needed by future boards, not Hellen72. We know that it works, but more thorough testing won't hurt.
Also we need to determine if we can process 2 VR sensors simultaneously (requires some fw coding).

Thread 9 (2021-02-19):

Test mini-USB adapter board for Hellen72

andreika-git, 2021-02-19:
We have an alternative USB routed for a small adapter board near the main ECU connector. We need to test it:
- does it fit at all?
- does it work?
- can we still use both USB connectors or they interfere with each other?

rusefillc, 2021-02-20:
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

rusefillc, 2021-02-20:
@andreika-git what do you mean "can we still use both USB connectors or they interfere with each other?"

two cables into same PC? two cables at the same time into different PCs?

andreika-git, 2021-02-20:
Not two cables, but just one cable into any of two connectors without desoldering them

rusefillc, 2021-02-20:
that works

Closed 2021-02-20.

Thread 10 (2021-02-21):

3D Render drama: kicad VRML not happy with AD VRML

rusefillc, 2021-02-21:
https://github.com/rusefi/hellen121vag/tree/main/boards/hellen121vag-a/board is affected

rusefillc, 2021-05-16:
@andreika-git says that this is about NodeJS and VRML file sizes and maybe else

Thread 11 (2021-02-21):

andreika-iBom issue with Hellen121

rusefillc, 2021-02-21:
JS issue?

Actually depends on #10

rusefillc, 2021-02-21:
See https://github.com/andreika-git/hellen-boards/blob/master/create_hellen121vag.sh

rusefillc, 2021-05-05:
https://github.com/andreika-git/hellen-one/blob/master/bin/gen_iBOM.py can handle Altium Designed gerbers but things go south the moment we have some kicad gerbers

https://rusefi.com/docs/ibom/hellen72b-ibom.html was happy until kicad WBO was added https://rusefi.com/docs/ibom/hellen72-c-ibom.html

Closed 2021-05-19.

Thread 12 (2021-02-21):

kicad version of the logo

rusefillc, 2021-02-21:
https://rusefi.com/forum/viewtopic.php?p=39595#p39595 shows the logo

https://github.com/rusefi/hellen121vag/tree/main/boards/hellen121vag-a/board does not show the logo since it was not converted yet

rusefillc, 2021-02-21:
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

rusefillc, 2021-02-21:
@andreika-git do we have any vector source file?

Closed 2021-05-19.

Thread 13 (2021-03-03):

create WBO module

rusefillc, 2021-03-03:

rusefillc, 2021-03-08:
@andreika-git please provide a status update

andreika-git, 2021-03-09:
Status update: The initial files for the WBO module were generated and uploaded to the repo.
Also we need to create AD symbol+footprint for this module.
Also we need to add it to _any_ board and test if it merges correctly.
Finally, we'll need to test it on a real hw.

andreika-git, 2021-03-21:
Exported CPL coords for WBO module are wrong (non-zero offset).

andreika-git, 2021-03-21:
Fixed in Kicad by doing this:
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

Closed 2021-05-19.

Thread 14 (2021-03-04):

create MAX992x module

rusefillc, 2021-03-04:
We need a single channel VR decoder module based on MAX992x

Let's reuse a piece of https://github.com/mck1117/proteus/ if MAX9924 or Frankenso is MAX9926 as a reference schematics

rusefillc, 2021-03-04:
@andreika-git  shall we name this module 'vr-max9924" or something else?

andreika-git, 2021-03-04:
I think we should name it "vr".
We will have 2 options for vr sensors: the built-in one already used in Hellen81 (tested on a real car, but needs more testing) and this new module "vr", that's enough IMHO.

rusefillc, 2021-03-04:
there is a chance of 9926 later if we need dual channel VR
how do we distinguish between MAX and adc-based?

andreika-git, 2021-03-04:
1) Then why not use 9926 instead of 9924 in "vr" module and make it dual-channel by default, like it was in many previous boards (Frankenso, Prometheus)?
2) Or we can use two 9924 modules for 2 channels
3) adc-based means no "vr" modules, and max-based means "vr" module - it's easy to distinguish

andreika-git, 2021-03-04:
Frankenso schematic:
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

rusefillc, 2021-03-04:
Let's go with 9926

rusefillc, 2021-03-08:
@andreika-git what is the status of this issue?

rusefillc, 2021-03-09:
https://github.com/andreika-git/hellen-one/commit/1248a41075824e934b88539bab09130ec319cad4 could be related

andreika-git, 2021-03-09:
The vr module was created (https://github.com/andreika-git/hellen-one/commit/1248a41075824e934b88539bab09130ec319cad4) but not used in any of the boards yet, and neither verified nor tested.

Closed 2021-03-15.

Thread 15 (2021-03-07):

random notes about LS pinout

rusefillc, 2021-03-07:
I am not sure you have the LS gen3 stuff entirely right.

10:42
I know there are 3.5 incompatible ECMs.
New

Matthew Kennedy  10:45 PM
But most of them are nearly the same, no?

Dave B.  10:48 PM
97-98 LS1 (oddball, shitty, DBC only)
99-02 LS1/truck (12880411 512k PCM, both DBW and DBC, "red-blue" ECM named after connectors.  These were very popular for swaps because all ECMs were electrically identical and could be adapted for either an idle valve or DBW throttle body with nothing more than a software change)
03-08 LS/truck (there are 3 different model ECMs there, don't know part numbers off head.  one has drivers for IAC, one has H bridge for DBW, one has both sets of drivers.  You must be much more careful when swapping these ECMs because of hardware differences.  Known as "blue-green" ECMs after connector colors)
10:48
I am POSITIVE that #1, 2 and 3 represent three incompatible pin arrangements
10:49
I am relatively certain that 1, 2, and 3 also use 3 different keyed connectors which prevent a #1 harness plugging into a #2 ECM and vise versa

Matthew Kennedy  10:49 PM
I thought that some ecus were missing some hw, but were the same
10:49
The green plug ones are different
10:49
But all blue/red ones are the same pinout

Dave B.  10:49 PM
green plugs have same PCB with 3 different BOMs
10:50
blue-red are all 100% identical inside
10:50
the pinouts are the same within each group
10:50
just some will use pins 1223455 for iac and others will use 12432453252 for Dbw

Matthew Kennedy  10:51 PM
I thought some blue red were missing the iac chip if they came on a truck with the external throttle module

Dave B.  10:51 PM
the IAC+DBW "green plug" ECM is the universal swapper.  It can be used in any green plug harness
10:52
AFAIK, the green are the only ones that sometimes have missing hardware.  Blue-red are 100% universal, at least the 12880411 part number is
10:53
Gen4 LS has E38 and E67 but pinouts are pretty much identical among all use cases of each ECM
10:53
and also crossover usage for v6 applications

Thread 16 (2021-03-12):

Module rotation

andreika-git, 2021-03-12:
Some boards may require module rotation. We need to implement it in our board merging script (see gerbmerge: *rotated90)

andreika-git, 2021-03-21:
https://github.com/andreika-git/hellen-one/commit/8dc935c2d491ab26e5ff0778f1e41fcedcf005dd

andreika-git, 2021-03-21:
It seems that module rotation now works for WBO gerbers!
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

Still need to implement VRML rotation, though.

rusefillc, 2021-04-11:
The critical part of this change is done, VRML is not on the critical path

Closed 2021-04-11.

Thread 17 (2021-03-21):

Non-consistent comments and footprints for AD and Kicad modules

andreika-git, 2021-03-21:
We need more consistency for footprint names and values (comments) for the same components.
For example, currently we have "R0603" footprint for most modules but "Resistor_SMD:R_0603_1608Metric" for WBO.
Or we have a 0603 red LED (LCSC #: C2286), which is "0603-Red" or "RED" or "LED-RED". We need to make sure it's the same part all over.

andreika-git, 2021-03-21:
Now we have a mechanism to solve this issue: hellen-one/kicad/footprints.csv
At least no more conflicts with WBO module for now.

Thread 18 (2021-03-21):

power5-0.2 module wrong gerbers (top layer) after merge

andreika-git, 2021-03-21:
Somehow gerbmerge doesn't work for 0.2 version of power5 module:
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

andreika-git, 2021-03-22:
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

Closed 2021-03-22.

Thread 19 (2021-03-22):

chip shortage

rusefillc, 2021-03-22:
We have three tracks to address chip shortage risk

0) panic buy at least some chips?

1) develop a F469 version of module: support F469 pinpout hoping that STM32F469IIT6 is more available due to smaller demand

2) develop 144 version of module: STM32F429ZGT6 is a bit more available _so far_

3) GD does not have 176 produces, GD 144 availability is extremely low :(

144 availability
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

GD

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

rusefillc, 2021-03-22:
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

rusefillc, 2021-03-23:
H743 could be the winner

https://octopart.com/search?q=STM32H743IIT6

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

rusefillc, 2021-03-25:
Minor update:

STM32F429IIT6 down 20%
STM32F469IIT6 down 0%, i.e. no one uses those? :)

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

STM32H743IIT6 availability way down

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

rusefillc, 2021-03-25:
https://jlcpcb.com/parts/componentSearch?searchTxt=stm32%20144

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

rusefillc, 2021-03-25:
Dave says https://www.win-source.net/hot-sales-and-eol-components-stm32f429zgt6.html

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

rusefillc, 2021-03-25:
Mouser has 144 pin chip

STM32F429ZGT6TR
https://www.mouser.com/ProductDetail/STMicroelectronics/STM32F429ZGT6TR?qs=5aG0NVq1C4wyZFvgyK4GFw%3D%3D

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

rusefillc, 2021-03-27:
JLC 176 change: less F4 a bit H7

https://jlcpcb.com/parts/componentSearch?searchTxt=stm32%20176

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

rusefillc, 2021-03-28:
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

rusefillc, 2021-04-10:
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

rusefillc, 2021-04-10:
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

rusefillc, 2021-04-13:
great news
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

rusefillc, 2021-04-14:
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

rusefillc, 2021-04-14:
I forgot about another option @andreika-git

https://jlcpcb.com/parts/componentSearch?searchTxt=stm32%20208

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

rusefillc, 2021-04-16:
yday @andreika-git has photoshopped H7 availability but JLC tells us otherwise today

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

rusefillc, 2021-04-16:
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

rusefillc, 2021-04-19:
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

rusefillc, 2021-04-19:
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

rusefillc, 2021-04-19:
Well, even 208 goes down pretty quickly :(

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

rusefillc, 2021-04-21:
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

rusefillc, 2021-04-22:
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

rusefillc, 2021-04-23:
And price tripling has started :)

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

rusefillc, 2021-04-27:
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

rusefillc, 2021-04-29:
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

rusefillc, 2021-05-05:
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

still no 208

rusefillc, 2021-05-08:
Minor 176 availability increase

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

@andreika-git we have 208 back in stock!

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

rusefillc, 2021-05-20:
A lot of 144, a bit of 208 and

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

rusefillc, 2021-06-15:
oh boy :(

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

rusefillc, 2021-06-15:
144 same BAD

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

rusefillc, 2021-06-15:
208 is the winner today

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

rusefillc, 2021-06-17:
I've ordered x5 Nissan and 176 is down to qty 44. We have to start monitoring daily @BeerMoneyMotorsports

rusefillc, 2021-06-18:
:(

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

rusefillc, 2021-06-18:
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

rusefillc, 2021-06-19:
#70 created

rusefillc, 2021-06-24:
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

rusefillc, 2021-06-24:
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

rusefillc, 2021-06-24:
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

rusefillc, 2021-08-07:
back in stock!

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

rusefillc, 2021-08-24:
Got some 176 chips for $56.25 per piece :(

rusefillc, 2021-11-06:
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

rusefillc, 2021-11-07:
puff reminds about

https://jlcpcb.com/parts/componentSearch?isSearch=true&searchTxt=GD32

rusefillc, 2021-12-28:
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

rusefillc, 2022-02-01:
mixed news

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

rusefillc, 2022-03-31:
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

but

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

rusefillc, 2022-03-31:
144 is doing pretty well

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

rusefillc, 2022-04-06:
-100 is better today

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

rusefillc, 2022-05-15:
a few LOLs in the 176 department

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

BeerMoneyMotorsports, 2022-07-07:
i wish all were this cheap

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

Thread 23 (2021-04-09):

schematics usability

rusefillc, 2021-04-09:
its hard for me to read hellen schematics

i am not 100% sure i van explain why but i know its harder than others

andreika-git, 2021-04-24:
As for PDF text replacements.
https://stackoverflow.com/questions/41769120/search-and-replace-for-text-within-a-pdf-in-python
I've tried it, and it kinda works... but net names are weirdly encoded: OUT_INJ5 is "NLOUT0INJ5", OUT_IO10 is "NLOUT0IO10" (yes, two zero characters) - so that all underscores are completely messed up! Maybe it's some sophisticated glyph mapping, maybe it's PyPDF2 bug or else, I don't know...
For now, it doesn't seem to be easy...

Thread 24 (2021-04-10):

Minor Bike Shed Improvement: command line gerber export?

rusefillc, 2021-04-10:
How much effort is it to export gerbers from KiCAD 5.99+ via command line?

chuckwagoncomputing, 2021-04-10:
https://electronics.stackexchange.com/questions/390135/command-line-interface-for-kicad

rusefillc, 2021-04-16:
I believe that the 7 step manual https://github.com/andreika-git/hellen-one/wiki/kicad-export-frame tells us that we really should automate the process

I've contributed first 20 bytes need help moving this forward

https://github.com/rusefi/hellen121vag/blob/main/boards/hellen121vag-a/kicad6/export_gerbers.py
https://github.com/rusefi/hellen121vag/blob/main/boards/hellen121vag-a/kicad6/step_0_export_gerbers.sh

chuckwagoncomputing, 2021-04-23:
https://github.com/JoanTheSpark/kicad-tools-1/blob/master/plot-pcb.py

Timbelom, 2021-06-02:
Two pieces of valuable info at
https://forum.kicad.info/t/command-line-to-plot-pdf/4779/11

1) there are demo scripts in kicad install folder
2) there is an example of a script which plots multiple layers while iterating over an array of parameters

Timbelom, 2021-06-02:
more examples of gerbers export https://gist.github.com/spuder/4a76e42f058ef7b467d9

Timbelom, 2021-06-02:
https://kicad-python.readthedocs.io/en/latest/ hehe

rusefillc, 2021-06-12:
@mck1117 @dron0gus can you help please? that's an important one for Hellen

chuckwagoncomputing, 2021-06-22:
Is anyone working on this? If not, I'll dig in.

rusefillc, 2021-06-22:
@chuckwagoncomputing please please please dig into! No one is working on this.

chuckwagoncomputing, 2021-06-23:
OK so the Gerbers, drill files, and VRML look like they'll be easy. I think the BOM should be easy too. I'm not sure yet about the PDF. One script I found used xdotool to automate it, as there isn't a python library to do it.

chuckwagoncomputing, 2021-06-23:
https://docs.kicad.org/doxygen-python/
https://github.com/obra/kicad-automation-scripts
https://github.com/INTI-CMNB/KiBot

rusefillc, 2021-06-23:
lets start by having 80% of the value with 20% of the effort?

chuckwagoncomputing, 2021-07-24:
https://github.com/INTI-CMNB/KiBot/issues/78

rusefillc, 2021-08-19:
@Come1LLF00 can you please start downloading https://kicad-downloads.s3.cern.ch/windows/nightly/kicad-msvc.r23615.dfacac5eb6-x86_64.exe from https://kicad-downloads.s3.cern.ch/index.html?prefix=windows/nightly/

rusefillc, 2021-08-19:
C:\Program Files\KiCad\5.99\share\kicad\demos\python_scripts_examples\gen_gerber_and_drill_files_board.py

chuckwagoncomputing, 2023-03-15:
I've made some progress:
https://github.com/chuckwagoncomputing/hellen121vag/tree/export-script
I added some scripts that I suppose should end up in this repo once they're fully working.
https://github.com/chuckwagoncomputing/hellen121vag/blob/export-script/export.sh
https://github.com/chuckwagoncomputing/hellen121vag/blob/export-script/fill-zones.py
https://github.com/chuckwagoncomputing/hellen121vag/blob/export-script/export-vrml.py
They produce all the correct files now, but I'm not sure yet if they produce them correctly.
This requires Kicad 7.0.1. I'm using kicad-cli, which was introduced in 6.99/7, and one of the necessary flags was broken until 7.0.1.

chuckwagoncomputing, 2023-03-17:
Current status is: wait for https://gitlab.com/kicad/code/kicad/-/merge_requests/1562 to be accepted and released.

rusefillc, 2023-03-17:
Wow.

chuckwagoncomputing, 2023-03-17:
Fun fact, in Gitlab, CI jobs for merge requests run on whatever runners the requester has set up.
Kicad self-hosts runners that build in about 10 minutes. (probably because they don't do a full rebuild)
The default Gitlab runners seem to take somewhere close to three hours. When creating a merge request, one of the stated prerequisites is to increase the build time limit in the settings of your for to >3h, from the default 1h.

chuckwagoncomputing, 2023-03-22:
Kicad change has been merged, should come out in 7.0.2 which is scheduled to be released April 13.

rusefillc, 2023-03-22:
@chuckwagoncomputing I would say proper location for those is not in the individual board repo but in the toolset hellen-one repo, something like hellen-one/kicad/bin?

chuckwagoncomputing, 2023-03-22:
Yes, there are nightly KiCad builds. However, I think we should wait to transition to KiCad 7 until 7.0.2 is available as a stable release.

I've put the scripts in hellen-one/bin
https://github.com/chuckwagoncomputing/hellen-one/tree/export-scripts/bin

Should I PR now? It shouldn't hurt anything having the scripts present.

rusefillc, 2023-03-22:
Yes happy to merge as is

rusefillc, 2023-06-01:
@chuckwagoncomputing looks like KiCad Stable Release Current Version: 7.0.5

Still very interested in all this!

chuckwagoncomputing, 2023-06-02:
Why does the create-board.yaml workflow use a Docker image, and should the new scripts be run in the same Docker container?

rusefillc, 2023-06-02:
@chuckwagoncomputing docker was a wah to address fragile setup - without it we were in dependencies management hell.

I would like to have scripts run both ways: no docker so that we can test and troubleshoot and docker for... actually not sure if we need docker for export phase maybe we fire docker only for Gerber merge later

chuckwagoncomputing, 2023-06-03:
Well apparently my change is somehow not in the release version of Kicad. I don't know what's up with that.

rusefillc, 2023-06-08:
Could be up a month or more until next 7 release :( see https://www.kicad.org/blog/

@chuckwagoncomputing has been added as a collaborator with write permissions on the https://github.com/rusefi/build_support/ repository.

@chuckwagoncomputing shall we push any nightly into usefi/build_support/ or else if that would help to move forward?

rusefillc, 2023-07-13:
https://github.com/andreika-git/hellen-one/issues/307 created to discuss that specific detail

rusefillc, 2023-07-13:
https://github.com/andreika-git/hellen-one/issues/308 created for a usability improvement

rusefillc, 2023-07-15:
FYI, low priority: trying to use the script just to export gerbers and got seg fault invalid input parameters https://github.com/rusefi/rusefi-hardware/actions/runs/5559501944/jobs/10155684390

rusefillc, 2023-07-23:
I forgot about BOM https://github.com/andreika-git/hellen-one/issues/313

rusefillc, 2023-07-23:
> BOM

https://github.com/andreika-git/hellen-one/issues/313

rusefillc, 2023-08-02:
@chuckwagoncomputing FYI usability improvement ask #317 - not really important but might be an easy fix

rusefillc, 2023-08-02:
@chuckwagoncomputing one more #320

Thread 26 (2021-04-10):

h64 CPL rotation

rusefillc, 2021-04-10:
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

andreika-git, 2021-04-11:
https://github.com/andreika-git/hellen-one/commit/6ed466df55011effc9942c4281bbaf00b0e35188
https://github.com/andreika-git/hellen-one/commit/46ce17a2ef54e39abf2cab8c6a52183a04fd5818

It's better now but still needs more thorough check:
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

When reloaded, it shows overlay with the board image, but with some vertical offset:
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

The whole component layer is shifted:
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

I don't know whether it's the JLC's bug or our bug...

Also the USB connector is shifted horizontally (upper corner) - possibly wrong CPL origin set in the Kicad footprint.

andreika-git, 2021-04-11:
Status update:
- gerber viewer coordinate test shows there's no noticeable vertical offset. Assuming that's JLC's bug
- USB connector footprint (Hellen-one-common Kicad lib) has wrong origin: it uses 1st pad center instead of component centroid.

Closed 2021-04-11.

Thread 27 (2021-04-10):

JLC op-amp options

rusefillc, 2021-04-10:
@mck1117 says LMV324 is NOT an acceptable substitute for the mcp6004 since output won't go below 50mv or above 4.45 volts

meanwhile the MCP6004 on an older board will go all the way down to ~2mV, and all the way up to ~15mV of the high rail

TP6004 similar to the MCP6004.  6mv at the low end, 8mv at the high end

rusefillc, 2021-12-27:
C50282 MCP6004T-I/ST was in stock I got some into parts library

https://jlcpcb.com/parts/componentSearch?searchTxt=C50282

Closed 2023-07-23.

Thread 28 (2021-04-11):

DC motor driver JLC options

rusefillc, 2021-04-11:
https://jlcpcb.com/parts/componentSearch?searchTxt=motor%20drivers%20STMICROELECTRONI

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

L6234PD013TR C77581 has 4K stock
is any of the other L6xxx pin compatible to increase our changes?

rusefillc, 2021-04-11:
L6234PD013TR is triple 5A
not pin compatible with L6205 double

rusefillc, 2021-04-16:
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

rusefillc, 2021-04-16:
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

rusefillc, 2021-07-08:
We have success with what we use on VAG and Nissan

Closed 2021-07-08.

Thread 29 (2021-04-15):

208 pin MCU module with SDRAM

rusefillc, 2021-04-15:
#19 shows some 208 pin availability

https://docs.rs-online.com/b72f/0900766b815247be.pdf shows https://www.digikey.com/en/products/detail/issi-integrated-silicon-solution-inc/IS42S16400J-7TL/2708623 54-TSOP (0.400", 10.16mm Width)

rusefillc, 2021-04-16:
One of the tactical reasons for SDRAM would be #19

rusefillc, 2021-06-16:
@andreika-git says not for NB1 but ship shortage is pushing us.

rusefillc, 2021-06-27:
I can think of three approaches as long as JLC assembled only one side of the PCB:

1) 100% JLC assembled MCU module with both 208 and RAM on same side - largest footprint most incompatible with our designs

2) only RAM on the back if that makes tracking and/or footprint side fundamentally smaller

3) compatible with 176 Hellen MCU module footprint by means of placing a lot of stuff on the back side of the module

rusefillc, 2021-08-07:
Random reference
[SK-STM32F429_746_V2A.pdf](https://github.com/andreika-git/hellen-one/files/6949518/SK-STM32F429_746_V2A.pdf)

rusefillc, 2021-08-07:
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

Thread 30 (2021-04-20):

h72 LEDs as reference resistor values

rusefillc, 2021-04-20:
all red are perfect
all blue are perfect
all white are too bright need to get much dimmer
12v green is OK-ish, maybe just a bit dimmer please?
3 and 5v greens are too bright, needs to get much dimmer

rusefillc, 2021-04-20:
https://youtu.be/RHhSn1nypz4

Qwerty-OFF, 2021-05-01:
Calculated values

GREEN:
12 V - 5.1 kOhm
5 V - 1.6 kOhm
3.3 V - 750 Ohm

WHITE:
12 V - 19 kOhm
5 V - 5 kOhm
3.3 V - 1.6 kOhm

rusefillc, 2021-06-16:
@andreika-git please move to wiki

andreika-git, 2021-06-16:
Please elaborate - these R values are for 0603 LEDS or 0805 LEDs? They have different Vdrop/intensity.

rusefillc, 2021-06-16:
@Qwerty-OFF please move content to https://github.com/andreika-git/hellen-one/wiki

rusefillc, 2021-10-16:
See also https://github.com/rusefi/hellen154hyundai/issues/33

rusefillc, 2021-10-16:
See also https://github.com/rusefi/hellen154hyundai/issues/34

rusefillc, 2022-04-24:
@Qwerty-OFF status update: nissan rev C

WBO module red is perfect reference point

top side of board red is brighter than WBO module red, could be reduced to WBO level of red

green ones at test point are EXTREMELY bright, needs major reduction

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

Qwerty-OFF, 2022-08-22:
|LED|3v3|5v|12v|Status|
|---|---|---|---|---|
|GREEN 0805 (C2297)|5.1k|20k|100k|Need to check on Hyundai 154|
|RED 0603 (C2286)|1k|   |   |   |
|TBD|   |   |   |   |

Thread 31 (2021-04-21):

h72 schematics usability

rusefillc, 2021-04-21:
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

That's very confusing.

Do we have two different "in_knock" here - module internal "in_knock" pad and h72 frame "in_knock" net?

If those are in fact two different entities having same name I would suggest to change the naming convention to avoid the confusion. I like the "raw" for inputs from connector, maybe "mcu_knock" for all nets between MCU and modules?

andreika-git, 2021-04-21:
IMHO this should belong to https://github.com/rusefi/hellen72/issues/

rusefillc, 2021-04-21:
I bet that's a hellen-one pattern not an issue specific to any board

andreika-git, 2021-04-23:
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

rusefillc, 2021-04-23:
👍

Closed 2021-06-16.

Thread 32 (2021-04-24):

WBO module needs SWD exposed as side pads on the module

rusefillc, 2021-04-24:
very few people have TC2030 plug

to increase usability we would need SWD as a 2.54mm header

we do not want to add  2.54mm header on the WBO module due to space constraints, we want SWD exposed as side pads on the module so that specific board could do whatever

rusefillc, 2021-04-24:
not sure how standard is this https://wiki.paparazziuav.org/wiki/STLink

rusefillc, 2021-04-24:
https://github.com/rusefi/hw_microRusEfi/raw/master/compatible_ST-LINK_V2.jpg is the fake v2 we use on microRusEFI

mck1117, 2021-04-24:
Do we need availability? 99% of people with MRE/Proteus don't have any programmer. We only need programming interface for "factory programming"

rusefillc, 2021-04-24:
A number of boards are open source, also while 042 is poorly available there is too much of a chance of units shipped without 042

rusefillc, 2021-05-19:
Done

Closed 2021-05-19.

Thread 33 (2021-04-27):

Dinput4 merge problem

Qwerty-OFF, 2021-04-27:
hellen121vag board:
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

Dinput4 gerber:
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

andreika-git, 2021-04-30:
The problem was in the module outline layer (.GM15), it was not big enough to keep all gerber objects inside.
Please re-run the create script for all boards using dinput4.

Closed 2021-04-30.

Thread 34 (2021-04-29):

CAN wbo trick did not work

rusefillc, 2021-04-29:
BeerMoney reports that WBO stm32 does not talk to main stm32 until can driver is desoldered

once can driver is desoldered CAN communication is happy

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

mck1117, 2021-04-30:
CAN trick *did* work, it just doesn't work if you also try and connect a real CAN bus to the same fake-CAN bus.

Closed 2023-07-23.

Thread 35 (2021-04-30):

module name and version silkscreen

rusefillc, 2021-04-30:
While top side of all modules is pretty busy we have the rear side very very empty

Shall we name and version all modules on the back of the PCB?

rusefillc, 2021-05-19:
@andreika-git poke :)

andreika-git, 2021-05-19:
How do we implement this? We don't want to increase the revision number for all the modules just for that, right?

rusefillc, 2021-05-19:
correct, no rev change for silk change

rusefillc, 2021-06-16:
Let's at least start. Shall we get this done for first three modules?

andreika-git, 2021-06-23:
TODO:
- vr-discrete
- wbo

Thread 36 (2021-04-30):

alternatives to QMA7981 accelerometer

rusefillc, 2021-04-30:
QMA7981 not in stock

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

is KXTJ3-1057 or KX023-1025 pin compatible?

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

not sure if LIS2DW12TR is compatible pinout

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

andreika-git, 2021-04-30:
LIS2DW12TR is used for Hellen81a and Hellen72d

Closed 2021-04-30.

Thread 37 (2021-04-30):

USB does not connect with just three wires

rusefillc, 2021-04-30:
I am trying to get a SBC talking to Hellen72 and H64

I have a spliced mini USB cable with GND/D+/D- no VSS

that works with this exact cable and this SBC nanopi taking to an MRE

does not work with H72 in Miata or H64 on a bench

Could this be a HW or SW problem?

rusefillc, 2021-04-30:
I do see
```
// Ignore USB VBUS pin (we're never a host, only a device)
#define BOARD_OTG_NOVBUSSENS TRUE
```

in some hellen config files

rusefillc, 2021-05-02:
MRE
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

rusefillc, 2021-05-02:
Hellen
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

rusefillc, 2021-05-02:
Not a schematics issue - just got nanopi to talk to hellen64

rusefillc, 2021-05-02:
looks like it's about nanopi start-up issues totally not a hellen issue

Closed 2021-05-02.

Thread 38 (2021-05-03):

high side outputs current limiting resistor

rusefillc, 2021-05-03:
Do we need more current limiting resistors to increate the changes of survival in case of output short to GND or 5v or 12v?

Thread 39 (2021-05-04):

NB2 tach HW magic. Maybe related to alternator.

rusefillc, 2021-05-04:
Someone please write this up?

rusefillc, 2021-05-04:
CrazyStriker says remove Q313, R313 and D304

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

rusefillc, 2021-05-05:
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

rusefillc, 2021-05-05:
Q313 removal has returned tachometer into my life

https://youtu.be/WFEwe_KtHW4

Qwerty-OFF, 2021-05-05:
Maybe fix protection like it made in power12 module?
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

mck1117, 2021-05-05:
Either fix it like that, or just remove it entirely.  I don't understand the reasoning to keep it around if the one in power12 exists too.

Closed 2021-06-16.

Thread 40 (2021-05-05):

diode for vvt and idle outputs

rusefillc, 2021-05-05:
Matthew Kennedy  4:48 AM
wait, vvt uses a single auips2041?

andreika  4:49 AM
yes

Matthew Kennedy  4:49 AM
did we quantify how much current the vvt solenoid pulls

CrazyStriker  4:49 AM
With clamping diode?

Matthew Kennedy  4:49 AM
no diode

andreika  4:49 AM
yes we did but I don't remember the numbers

Matthew Kennedy  4:49 AM
it needs one

CrazyStriker  4:50 AM
Oh shit
4:50
I see 1.4 amps continuous operation for the driver

Andrey  4:50 AM
vvt resistance was 7?

Matthew Kennedy  4:50 AM
yeah, that's what I saw
4:50
14 volts 7 ohms -> 2 amps
4:51
add that to the list of "did we even try"

andreika  4:51 AM
what's the duty cycle for vvt?

Matthew Kennedy  4:52 AM
iirc around 50% will hold cam position
4:52
then advance/retard either side

CrazyStriker  4:52 AM
That would explain why some chips whine

Matthew Kennedy  4:52 AM
what else is powered by your fuel pump relay

andreika  4:52 AM
then vvt should be fine

Matthew Kennedy  4:52 AM
is that also the vvt by chance?

CrazyStriker  4:52 AM
34% for hold and +-15% dynamic
4:53
The FP relay only powers FP
4:53
VVT goes through main relay

Matthew Kennedy  4:53 AM
ok
4:53
it probably does need the diode though
4:53
it active clamps, but that's very different for a fine-control solenoid like this

CrazyStriker  4:53 AM
It definitely needs the diode. It has been specified since frankenso

andreika  4:53 AM
AUIPS2041 has a pretty decent active clamp, I tried to kill it but couldn't

CrazyStriker  4:54 AM
Diode for VVT and idle valve

Matthew Kennedy  4:54 AM
@andreika the point is not that you'll hurt the chip (I don't think it will), but that you want nice linear current control

CrazyStriker  4:54 AM
At the cost of diodes it doesn't hurt to put on a big one. I did for the NB2 PnP board

Matthew Kennedy  4:54 AM
active clamp's job is to collapse the field as fast as possible
4:54
we want to maintain field as long as possible

andreika  4:56 AM
good point. Maybe we should add it
4:57
And for idle solenoid too, yep

CrazyStriker  4:59 AM
If you can put one on next rev it would be cool, for idle too

andreika  5:00 AM
sure

CrazyStriker  5:00 AM
In the meantime I can bodge one big unit on each
5:00
Between +12 and output

CrazyStriker, 2021-05-07:
Temporary bodge

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

I can confirm IAC and VVT are now working as expected

Closed 2021-06-16.

Thread 41 (2021-05-06):

Hellen64 No Silkscreen ID for jumpers

BeerMoneyMotorsports, 2021-05-06:
Previously the MRE48 pnp and Hellen72 had Jumper IDs printed on the board for quick and Easy Identification. H64 does not have those. Picture below is example.

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

Qwerty-OFF, 2021-05-06:
Designators is disabled in the export settings guide. We need to add silk manually or enable designators
https://github.com/andreika-git/hellen-one/wiki/kicad-export-frame
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

rusefillc, 2021-07-08:
I assume this is done

Closed 2021-07-08.

Thread 42 (2021-05-06):

don't use LEDs as a pullup

mck1117, 2021-05-06:
If you want an LED and a pullup, wire both.  Do not rely on the LED as a pullup.  Using the LED in series with the pullup may not have the desired effect.

For example, in the VR module:

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

andreika-git, 2021-05-06:
We do not rely on LED resistors for pull-ups. We do have pull-ups in both input and dinput4 modules (for all required inputs including VR):
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

mck1117, 2021-05-06:
Then what's going on in the VR module?

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

andreika-git, 2021-05-06:
What exactly is wrong in the VR module? The "true" pull-up resistors are not in the VR module, they are in the input module because the VR module is not the only source of VR signal - Hellen One has a working software VR processing capability.

mck1117, 2021-05-06:
> The "true" pull-up resistors are not in the VR module

this is antithetical to the whole point of a modular design

> VR module is not the only source of VR signal

If you are suggesting connecting more than one source to the same net (then connecting to a single MCU pin), why? We can switch inputs in software.  One source.  One sink.  One pullup, located on the schematic of the SOURCE.

> Hellen One has a working software VR processing capability

I'll believe it when I see it

mck1117, 2021-05-13:
this has now caused confusion in #49 - this module really does need internal pullup so that use of an extra module isn't needed.

Closed 2021-05-06.

Thread 43 (2021-05-06):

[power5] revise input capacitors

mck1117, 2021-05-06:
At 50-60% of the rated voltage (12-15v on a 25v rated cap), a typical x5r/x7r ceramic loses 50-70% of the rated capacitance.  That means the spec'd 40uF ends up closer to 10-15uF.

One of the following needs to happen:
- Replace ceramics with a single aluminum polymer electrolytic (bonus: the ESR will probably reduce conducted emissions)
- Add significantly more capacitors to have enough capacitance when at 12-15v.

As an aside, 25v rated caps really aren't appropriate here.  A load dump could result in more than that (even with the clamping circuits in place), and the failure mode of ceramics is generally to fail short, which will cause secondary failures.

andreika-git, 2021-05-06:
We do not use 25v rated caps, we do use 50v rated caps:  CL31A106KBHNNNE 10uF 50V 1206 (C13585).
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

mck1117, 2021-05-06:
Ah, ok, I was looking at the wrong BOM line.  Even then - it still loses ~25% of the capacity at 12-15v, so it's still worth adding one or two more caps.

Closed 2021-05-06.

Thread 44 (2021-05-06):

[output] clamp V12FLYBACK to supply rail

mck1117, 2021-05-06:
Clamping energy should be dumped back to the supply rail.   Dumping it in to a TVS is asking for the TVS to overheat and fail, which then leaves them unclamped, which will cause the driver chip to fail.

andreika-git, 2021-05-06:
How exactly we should dump the energy back to the supply rail? We already had it connected to the supply rail for Hellen72 rev.A - it was an obvious but *wrong* solution.
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

mck1117, 2021-05-06:
Why was it a wrong solution? Dump it back to the main relay switched pin.

andreika-git, 2021-05-06:
It's wrong because we have a situation when the voltage is present on output pins through the relay coils ("hot at all times"), but not on the board power rail (the ignition is turned off). So we had a parasitic power through the flyback diode.

mck1117, 2021-05-06:
why is there a connection between the main relay supply pin (switched by the main relay) and input to the regulator?

mck1117, 2021-05-06:
Actually, why not dump back in to the 12V_PERM net? That's not switched anyway, so it's guaranteed to be unable to keep the ECU on.

andreika-git, 2021-05-06:
Because one of the use-case configurations is to power the ecu board from the main relay supply (eg. finish some work even after the ignition switch is off).
Yes, we can add a diode to 12V_PERM, but it's not a universal solution (and thus unsafe): 12V_PERM is not guaranteed to be present on all car pinouts.

mck1117, 2021-05-06:
> but it's not a universal solution (and thus unsafe)

therefore the solution shouldn't be inside the module - the module should expose as its API a pin for "this pin may need the car's implementation to sink current", which could be a diode to some supply pin, or could be a TVS.

Closed 2021-05-06.

Thread 45 (2021-05-06):

[sd] add decoupling cap for SD card

mck1117, 2021-05-06:
SD card should have a decoupling cap across the power rails near the socket.  I've heard stories (not our boards) of people having SD card unreliability due to no decoupling caps near the card.

andreika-git, 2021-05-06:
We already have more than enough decoupling caps for the sd card on the sd module:
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

mck1117, 2021-05-06:
Apparently my eyes can't read the monochrome schematics from Altium.

22u is pretty big.  Absolutely worth replacing one of the 22u with a 1u or even 100n.

Closed 2021-05-06.

Thread 46 (2021-05-06):

consider revising vbat supply

mck1117, 2021-05-06:
2 problems observed:

1. the zener diode based shunt regulator isn't particularly accurate, since the current passed is relatively low.  The chosen zener is specified at 5mA - while the stm32's vbat pin draws 3 orders of magnitude less current.  This is probably actually okay, since the STM32's vbat pin operates at 1.65-3.3 volts.
2. Since it is a simple zener-based shunt, the power consumption is very high for a standby circuit.  Typical industry standby current for an ECU is on the order of 50-100uA.  The current standby circuit draws several times more than this: 280uA estimated, 296uA measured on h72b at 12.5 volts supply.

Both the accuracy and power consumption can be solved by using a standard linear regulator instead, essentially all of which have a quiescent current consumption far less than 100uA.  The STM32 only draws 5-10uA for the RTC, a rounding error compared to the shunt.

Switching to a proper regulator will also allow for eliminating the relatively large and expensive 100uF tantalum capacitor.

Closed 2021-05-24.

Thread 47 (2021-05-06):

h72 fails short circuit at 22v supply

mck1117, 2021-05-06:
Some background:
- I once saw 19 volts on a real car with a failing alternator.
- Three additional volts is not out of the question.

I connected h72b to a bench supply (with current limiting set to ~1A), and slowly increased the supply voltage.  At around 22 volts, I heard a pop, and the supply went in to limiting.  Turning the voltage down, the resistance of the fault was on the order of 0.5-0.7 ohm.  Removed the TVS, TVS measured fine.  Removed one of the crowbar mosfets, worked fine.  Removed the other, short circuit!

Last time we visited load dump protection, you said:

> This is a basic built-in solution which protects only from “Test B" (ISO 16750-2), i.e. with centralised load dump suppression.

But test B specifies 35 volts for 10-100ms.  So does Hellen expect to survive 16750-2 test B or not?

ps: did that issue get deleted? I still have it in email 🙂

rusefillc, 2021-05-06:
h72c uses a PS much closer to proteus

mck1117, 2021-05-06:
> h72c uses a PS much closer to proteus

yes - the power5 module should be ok, the problematic crowbar is in the power12 module, which is essentially the same between b and c

rusefillc, 2021-05-06:
> ps: did that issue get deleted? I still have it in email 🙂

old issue was removed while this hellen-one repository was re-created. @mck1117 please copy-paste anything useful from https://github.com/andreika-git/hellen-one-old/issues/3

Qwerty-OFF, 2021-05-06:
It seems the Hellen 72 does not contain a fuse. Since a limited current PSU was used, the 5 amp fuse would not blow even if it was installed. The transistor will work as a zener diode dissipating power P = (Vin-20V) * I, i.e. about 2W in the above situation. This is a lot for the sot-23 case.

We have the following solutions:
- Do nothing, assuming the faulty alternator is supplying enough current to blow the fuse (and add the fuse to h72).
- Replace the protective transistor with a more powerful and heat-intensive one, so that the fuse burns out earlier than the transistor.
- Implement non-"crowbar" overvoltage protection.

If we want to pass the test described above, we must select one of the first two options. If we really want to survive a faulty generator, the last option is most likely worth choosing.

mck1117, 2021-05-06:
> The transistor will work as a zener diode dissipating power P = (Vin-20V) * I, i.e. about 2W in the above situation.

It's even worse than this.  At 22v the drop thru the tvs is ~19 volts plus the plain reverse protection diode, leaving ~2 volts on the gate of the transistor - according to the datasheet that's enough to support 15-20 amps of drain current, more like 350 watts peak.  A SOT23 will tolerate 2W for a pretty long time - the AO3400 is even rated for that dissipation for multiple seconds.  But at 350 watts, the limit is something like 10 microseconds (though 350 watts is also awfully close to the "never exceed for any period of time" dissipation).

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

> Replace the protective transistor with a more powerful and heat-intensive one, so that the fuse burns out earlier than the transistor.

yes, this is what I was getting at - paralleling mosfets doesn't really work (variation in gate voltage means a single transistor takes the full hit), so the mosfet will weld itself in to a short long before a 3/5/10 amp fuse pops.  It will then blow the fuse, but is still shorted.  Replace the fuse, ECU is still shorted.

As for what solution to implement:  The power12 module already has a TVS rated for 1500 watts peak, which is PLENTY of power to pop probably even a 20 or 30 amp fuse.  With the revised power5 module tolerant of up to 40v input, it's fine to just remove the crowbar entirely.

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

It is designed to tolerate massive single-event pulses, like the one required to blow a fuse.  At the same 350 watts, the maximum pulse is tens of milliseconds - plenty of time to blow a fuse.

Qwerty-OFF, 2021-05-07:
Output module contains RZ7899 (25V max), TC4427 (22V max) and high-side:
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
Did I understand correctly that this high-side should not survive more than 12V?

Closed 2021-05-24.

Thread 49 (2021-05-06):

PWM vr-interface module

rusefillc, 2021-05-06:
Let's try https://github.com/mck1117/vr-interface as an untested-on-real-vehicle alternative to MAX9926 VR conditioner

Is that vr-interface large enough for a module or do we copy/paste it as is?

rusefillc, 2021-05-06:
@mck1117 would you be interested to practice your Hellen module skills?

mck1117, 2021-05-06:
I think it warrants a module, yes.  Go ahead and assign to me.

rusefillc, 2021-05-06:
I am hoping that we are 1 week from sending hellen-mercedes to the fab. I guess technically we can totally skip PWM vr-interface in rev A but see what you can do please?

mck1117, 2021-05-11:
yes, that looks OK to me.  The unwritten (in the schematic) part of the NOR gate that we need is that it must allow you to sink current out of the input pins - using the diode from GND -> input.  However, the replacement chip allows this in the datasheet, so everything looks OK.

rusefillc, 2021-05-13:
@mck1117 which of the three outputs do we want to feed into Hellen?

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

mck1117, 2021-05-13:
"Output" = digital output, conditioned VR signal, actual trigger input.
"Analog out" = if we want an oscilloscope trace of the trigger
"Thresh in" = pwm output from stm32

rusefillc, 2021-05-13:
sounds like "Analog out" is good to have a via on the PCB for just in case but not route to MCU

mck1117, 2021-05-13:
I want to route it to ADC3 so we can do this: http://www.maxxecu.com/webhelp/settings-diagnostics-trigger_oscilloscope.html

rusefillc, 2021-05-13:
The knock ADC3? :)

mck1117, 2021-05-13:
Yes, that ADC3 🙂

We don't ever need knock and trigger scope at the same time.  Trigger scope with some free revving to check the trigger threshold, then knock once you're actually driving around.

rusefillc, 2021-05-13:
@Qwerty-OFF @andreika-git  ^^^

Qwerty-OFF, 2021-05-13:
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
Is it ok?

mck1117, 2021-05-13:
@andreika-git does `vr-0.1` need external pullup resistor? This is exactly the confusion in #42.

mck1117, 2021-05-17:
@andreika-git ping

andreika-git, 2021-05-17:
>
> Is it ok?

Yes, it's ok, no additional pullups needed.

mck1117, 2021-05-17:
No pullup or not? Because in #42 you said the VR module requires an external pullup.

andreika-git, 2021-05-17:
I didn't say anything about "external" pullup. I said that the required pullup for crank-vr input is already in the respective module. No additional pullups required for the schematics done by @Qwerty-OFF.

rusefillc, 2021-05-19:
Created!

Closed 2021-05-19.

Thread 50 (2021-05-07):

H64 NA6 VIGN input wrong

BeerMoneyMotorsports, 2021-05-07:
The current H64 board uses pin 1C as the input for VIGN.  1C is a 12v starter signal which means it only has voltage in the starting position.  We need to utilize 1B which is ignition acc, on and start,  I have tested it with 1A as well but that leaves the board powered at all times.

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

Closed 2021-05-25.

Thread 51 (2021-05-11):

Hellen64 wrong voltage for Tach Out pullup

BeerMoneyMotorsports, 2021-05-11:
miata requires 12v pullup for tachout to function as it should.  Currently the board is applying 5v as shown below. We have a good square wave but is low voltage.

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

Closed 2021-05-25.

Thread 52 (2021-05-11):

Hellen64 TPS jumpers

BeerMoneyMotorsports, 2021-05-11:
Hellen 64 has two ways to get TPS input depending on model year.  When upgrading the 90-93 manual trans cars to VTPS, in the current format it prompts you to install R25 which is for Injector 4.  This would seem to show that the ecu would need to use that for the tps input.  That will not work as the sequential injection upgrade is common and needed.  There should be a jumper to select between 3M or 3L for tps input.  3L is the factory wire for the TPS and is traditionally used for VTPS applications.  Connecting 3M to 3L with a jumper is needed as drawn below.  For 90-93 manual with VTPS, remove jumper for 3M and keep Jumper for 3L

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

BeerMoneyMotorsports, 2021-05-11:
90-93 Manual Trans VTPS pinout
1N- 5v
3L- tps sig
3C- GND

Remove R11, leave R10
remove R22(10k) and put in a jumper(this should proved +5v to 1N, correct?)
Remove R47
Leave new Jumper that will be added from 3L to tps IN.

Closed 2021-05-25.

Thread 54 (2021-05-14):

which Honda first Hellen Honda

rusefillc, 2021-05-14:

rusefillc, 2021-05-14:
Dave is this relevant for us?
1.5L

JHMEG854х0Sхххх94

https://auto.ria.com/auto_honda_civic_29783131.html

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

blundar, 2021-05-15:
88-91
92-95
96-98
99-01
Those are all going to be very common in terms of sensors but there are 4 independent pinouts (two of which share the same connector)
92-95 is arguably the "gold standard" but no one in their right mind cares about a 1.5 non vtec

rusefillc, 2021-05-15:
@blundar woukd that 1.5 non Vtec be 95% same hw as whatever people care about?

blundar, 2021-05-15:
mostly.

Thread 55 (2021-05-15):

H72: confirm that we have jumpers/vias for Lewis J

rusefillc, 2021-05-15:
This could be a matter of adding more of h72 repurposing documentation since that clearly lacks at the moment

Lewis J  11:26 PM
I've got the 4.9 already in
I do have some weird OEM wiring repurposes... For example, two of the stock MAF eires are now the boost control solenoid

11:29
Front narrowband O2 sensor wires are becoming ign 3&4, rear is becoming flex fuel, and maybe the weird EGR sensor thing will be repurposed for ethrottle wiring

Closed 2021-06-16.

Thread 56 (2021-05-19):

Wbo index hardware selection

rusefillc, 2021-05-19:
We need to sync up module with https://github.com/mck1117/wideband/issues/11 changes to get different pull-up/down on wbo 1 and 2

mck1117, 2021-05-28:
I would recommend not putting pullup/down inside the module, but instead just breaking out the SEL1/SEL2 pins to the module API.  That way, the board can just wire a trace to vcc/gnd/float to select ID of each wideband on the board.

Thread 61 (2021-05-28):

Make all modules 4 layer compatible

rusefillc, 2021-05-28:
Two sided modules should have prohibition in middle layers

Single sided modules are probably fine as is

rusefillc, 2021-08-19:
we have a couple of 4 layer boards now

Closed 2021-08-19.

Thread 63 (2021-05-28):

opamps should prefer MCP6004

mck1117, 2021-05-28:
TSSOP14 opamps should prefer MCP6004T-I/ST (C50282) over LMV324, as the DC performance of the MCP is better.  In particular, the LMV can't get within ~0.5v of the positive rail, which is required for some OEM TPS sensors (et al)

rusefillc, 2021-06-21:
See #27

rusefillc, 2021-07-08:
We need new revisions of both Hellen MCU 144 and 176 with C398929 and LMV324 completely wiped out TODAY

Very disappointing that we have not handles this better and now we have at least 10 boards full of LMV324, this was very preventable.

andreika-git, 2021-07-08:
https://github.com/andreika-git/hellen-one/commit/6e68005fa9b13a718671ad632f19f5b2b39c0ed1

andreika-git, 2021-07-29:
Another advantage is that MCP6004T can withstand up to -1V negative input, but LMV324 is limited to only -0.2V, which is less than SRV05-4 limiter can guarantee. LMV324 saturates output for even slightly negative input voltages.

mck1117, 2021-07-29:
lmv even saturates the output with 0v input

Closed 2021-07-08.

Thread 66 (2021-06-14):

Dangerous module pads

Qwerty-OFF, 2021-06-14:
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
Most of the modules pads are opened from the solder mask for debugging purposes. It seems that the solder can short the contact pad of the IC and the pad of the module.

Thread 67 (2021-06-16):

Injector Driver - yet another option is out of stock

rusefillc, 2021-06-16:
AUIPS2041L $3 very little availability

ZXMS6005SGTA C174042 good option is out of stock

is BSP76E6433_C152392 an option or too slow?

@mck1117 @andreika-git

mck1117, 2021-06-16:
ouch

I /think/ that should be ok, if a little slow

rusefillc, 2021-06-17:
@blundar what's your take on https://datasheet.lcsc.com/lcsc/1810172210_Infineon-Technologies-BSP76E6433_C152392.pdf as injector driver?

rusefillc, 2021-06-20:
@mck1117 says he is aware of more legit options

rusefillc, 2021-08-19:
1000 purchased for NRS

rusefillc, 2021-11-07:
#111

rusefillc, 2022-01-01:
is IRF7301TRPBF a good chip for us? we have not used this pinout so far but on the bright side very available

https://octopart.com/search?q=IRF7301TRPBF&currency=USD&specs=0

blundar, 2022-01-01:
That looks like a standard, unprotected MOSFET.  It's not a protected
driver and shouldn't be used as such.  Depending on use case, may or may
not be fine.

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

blundar, 2022-01-01:
If you're not going to be using a protected driver, I'd be looking at more
like 50-100Vds rated parts and adding an active clamp circuit to the base
of the FET with clamp voltage 2/3 to 3/4 the rated Vds.  If you need short
circuit protection, you'd also need to additionally either add a shunt
resistor or use the Rds(on) of the FET in addition to a current sense
amplifier.
-D

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

Closed 2021-08-19.

Thread 70 (2021-06-19):

mcu 100

rusefillc, 2021-06-19:
would 100 lqfp stm32 be enough for Miata NA6? NB1?

rusefillc, 2021-06-21:
@andreika-git from pinout perspective would LQFP-100 be enough for Hellen-NA6? Hellen-NB2? 121-Volkswagen with up to 8 cylinders?

Thread 71 (2021-06-20):

What chips should go into NRS

rusefillc, 2021-06-20:
We need National Rusefi Stockpile

Just ordered x25 of STM32F427ZIT6 since newark still had some stock

what are the next chips to go into NRS?

injector driver? what PN from mouser digiket?
what else is weird and will get harder to get?

rusefillc, 2021-06-20:
See #19

andreika-git, 2021-06-20:
**Short list:**
STM32F042K6T6 (C69216)
LMR14030SDDAR (C182078)
AP2337SA-7 (C150497)
AUIPS2041LTR (C113610)
BTS3028SDR (C112639)
L6205PD (C36543)
LPS25HBTR (C87898)
***

**Long list (sorted by JLC stock):**
LIS2DW12TR (C189624) 111
TJA1051T/3/1J (C38695) 631
PESD1CAN (C343993) 798
AD8628ARTZ (C29309) 1114
SMCJ30A (C310046) 1315
MCP6004T-I/ST (C50282) 1925
TC4427AEOA713 (C20551) 2162
REF3033AIDBZR (C36658) 3741
MIC5205-3.3YM5 (C37970) 3953
RZ7899 (C92373) 16298
PSM712-LF (C32677) 28098
XC6206P332MR (C5446) 25601

rusefillc, 2021-06-20:
I am super confused

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

rusefillc, 2021-06-20:
@andreika-git @qwerty-off LMR14030SDDAR is less available but is LMR14030SSQDDAQ1 is more available

what's the difference?

Qwerty-OFF, 2021-06-21:
ISL9V3040S3S (coil IGBT)
MAX9926 (VR)

rusefillc, 2021-08-10:
ordered LMR14030SDDAR  and ISL9V3040S3S

rusefillc, 2022-03-04:
@andreika-git @Qwerty-OFF I've just ordered some BM2LC105FJ-CE2

those are compact two channel injector drivers could be useful on our smaller boards like Harley or alpha etc

Thread 72 (2021-06-20):

Chip Shortage: Transceiver CAN

rusefillc, 2021-06-20:
TJA1051T/3/1J https://lcsc.com/product-detail/CAN-ICs_NXP-Semicon-TJA1051T-3-1J_C38695.html says bye-bye

@mck1117 says MCP2551T-I/SN https://jlcpcb.com/parts/componentSearch?isSearch=true&searchTxt=C49558

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

rusefillc, 2021-06-20:
@mck1117 is mcp2551 pin compatible?

rusefillc, 2021-06-20:
@andreika-git @qwerty-off

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

rusefillc, 2021-06-20:
@mck1117 says
C49558 That's what's on latest proteus
Works fine
Used to have tja

Qwerty-OFF, 2021-06-21:
The MCP2551 has no Vio pin. Is our STM32 5V-tolerant on CAN_RX pin?

mck1117, 2021-06-21:
yes

Closed 2021-08-19.

Thread 75 (2021-06-26):

JLCPCB fab drama: hardware arcs vs software arcs

rusefillc, 2021-06-26:
TODO follow up with kicad forum/issue tracker else

rusefillc, 2021-06-26:
Random links

https://forum.kicad.info/t/jlcpcb-gerber-preview-issue/20524
https://lists.launchpad.net/kicad-developers/msg15258.html

rusefillc, 2021-06-26:
So far Vlad was unable to produce a small/minimal PCB which breaks JLCPCB. As of today it looks like total count/total size or else matters, this is less of a functional bug more like performance issue / timeout issue / overflow.

Thread 76 (2021-06-28):

AP2331W-7 alternatives

rusefillc, 2021-06-28:
U103 is AP2337SA-7 or AP2331W-7

I have the last 62 available for sale on this small green Earth.

Are there alternatives?

rusefillc, 2021-06-28:
Merc uses two "U103, U480"
H72 NB2 uses same two

rusefillc, 2021-06-29:
@andreika-git please clarify
```
AP233* is not required, it's optional. The board runs just fine without it.
let's confirm that this applies to both part numbers since some board have two of it
```

andreika-git, 2021-06-29:
U103 (mcu) AP233* is not required, it's optional. The only reason for AP233* is to have a "close-to-5V voltage" when powered from USB-only. Otherwise we have a diode D101 which is a backup replacement in case of AP233* is not populated, but at the cost of voltage drop. The same applies to U480 (stlink) and D480 backup.
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

rusefillc, 2021-06-29:
@mck1117 would be interested to find an alternative part anyway just for fun?

Thread 77 (2021-06-30):

No R7 on hellen nissan ibom

rusefillc, 2021-06-30:
Some resistors are missing on nissan https://rusefi.com/docs/ibom/hellen121nissan-b-ibom.html

See https://github.com/rusefi/hellen121nissan-issues/issues/3

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

Thread 78 (2021-07-11):

issues with Kicad BOM plugin and DNPs

rusefillc, 2021-07-11:
What is the root cause of https://github.com/rusefi/hellen121vag/issues/36?

rusefillc, 2021-07-11:
@qwerty-off FYI

rusefillc, 2021-10-01:
Poke @andreika-git how is this related https://github.com/rusefi/hellen121vag/issues/36 ?

Thread 79 (2021-07-11):

inconsistent DFU

rusefillc, 2021-07-11:
We have reports of two or three kinds of Hellen boards failing to reboot into DFU via "reboot_dfu" command

Same reboot to DFU procedure could be initiated by rusEFI console using "Program" button while "Automatic DFU" is selected

This issue is NOT about "reset" or "PROD" button, the scope of this issue is ONLY software-based reboot to DFU

Steps to reproduce:
1) have a Hellen board with 407 chip
2) have Hellen board with 407 blink blue LED
3) connect via USB
4) hit "automatic DFU" in rusEFI console

expected result: DFU process starts

actual result: board reboots into normal operation

BeerMoneyMotorsports, 2021-07-11:
Auto DFU tests USB power only

H72c w/F429- Pass-5 Fail- 0
H64a w/F407- Pass-0 Fail- 5
H64b w/f407- Pass-1 Fail- 4

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

BeerMoneyMotorsports, 2021-07-11:
H72c
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

H64a
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

H64b
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

rusefillc, 2021-07-11:
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

not hellen with old 407 SW dfu jump works!

that's inconclusive

i also have 2nd 176 407 from same pack of samples

that opens many possibilities but i would compare designs arounds caps etc before we go swapping parts

maybe up some caps?

@dron0gus

mck1117, 2021-07-12:
With the PROG button held (ie, MCU always enters system ROM at reset), the reset line is triggering every exactly 1 second, so something is triggering a hardware reset after ~1 second

Reset is low, not reset is high:

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

The large period at the left is me pressing the physical reset button, then the ~1 second spaced blips are the MCU resetting itself.

mck1117, 2021-07-12:
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

mck1117, 2021-07-12:
When attaching a debugger to a completely blank chip when boot looping the bootloader, it says the software reset bit is set in RCC register CSR.

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

mck1117, 2021-07-12:
Here are an old MRE (f407), f4 disco, and hellen probed at the OSCOUT (PH1) pin:

hellen:

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

microRusEfi:

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

F4 discovery:

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

rusefillc, 2021-07-12:
OMG

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

rusefillc, 2021-07-12:
```
I replaced $0.2 part with a "crystal and caps" that is guaranteed to oscillate well within the allotted time (edited)
the bootloader waits 800us for the clock to start
if the clock doesn't start in 800us, it triggers a system reset
our clock is locking in ~900us or so
```

mck1117, 2021-07-12:
The above photo is injecting an 8mhz sine wave in to the OSC_IN pin - so that we can guarantee the "crystal" will have locked

mck1117, 2021-07-12:
Evidently the F42x bootloader waits longer, because on a random proteus board it takes even longer, but the bootloader still works perfectly

mck1117, 2021-07-12:
With the F407 discovery's oscillator transplanted on to the hellen121a PCB:

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

andreika-git, 2021-07-12:
There are some JLC drop-in alternatives to consider:
* C122522
* C172361
* C111120
* C90881

andreika-git, 2021-07-12:
Here's a similar topic already discussed:
https://community.st.com/s/question/0D53W000004lc5NSAQ/dfu-over-usb-not-working-hse-not-detected

mck1117, 2021-07-12:
This will add support for alternate crystal speeds without different firmware: https://github.com/rusefi/rusefi/pull/2952

rusefillc, 2021-07-12:
520-200-12-30-AEM-TR

rusefillc, 2021-07-12:
Maybe this is linked to the embedded bootloader version:

V3 on STM32F407 and STM32F401
V7 on STM32F427
V9 on STM32F446

Check AN2606 for details

https://www.st.com/resource/en/application_note/cd00167594-stm32-microcontroller-system-memory-boot-mode-stmicroelectronics.pdf

rusefillc, 2021-07-12:
digikey stuff in stock

H130A-8.000-8-2030-TR‎ 8 MHz
‎2845-WTL5G60390VH-ND‎ 8 MHz
535-9105-1-ND (20 MHz ESR 30 Ohm)
CTX1436CT-ND (16 MHz, ESR 40 Ohm)
644-1037-1-ND (16 MHz, ESR 120 Ohm)

mck1117, 2021-07-12:
Ordered a stack of 16 and 20MHz options from digikey, will test soon on 121vw

rusefillc, 2021-07-14:
@BeerMoneyMotorsports please order qty 20 of

ABM3-20.000MHZ-B2-T  535-9105-1-ND 20 MHz ESR 30 Ohm

I believe that we have major improvement in Hellen72 rev D behavior

rusefillc, 2021-07-15:
@mck1117 says that 20MHz crystal ABM3-20.000MHZ-B2-T starts in ~250us

looks like minimal fix for Hellen MCU is to jump from 8MHz to 20MHz and move on?

@andreika-git @mck1117

Closed 2021-08-19.

Thread 80 (2021-07-16):

SPI vs SPI1

rusefillc, 2021-07-16:
we have an inconsistency:

SPI2 and SPI3 have "2" and "3" on both sides of N9 and N20

but SPI1 is "SPI1_SCK" on the left while "SPI_SCK" on the right, without "1"

I believe it would be better to rename SPI_SCK to SPI_SCK1 and same for MISO and MOSI

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

rusefillc, 2021-07-16:
Somewhat of a different note - wat about CS which I assume are "chip select"? those should not really be linked to specific SPI since those are 100% flexible and could be use for any SPI device?

rusefillc, 2021-07-16:
related to #23?

Thread 81 (2021-07-23):

Dual CAN hardware

rusefillc, 2021-07-23:
which Hellen board would have two CAN routed to stm32

rusefillc, 2021-07-23:
See also https://github.com/mck1117/atlas/issues/16

rusefillc, 2021-10-06:
Hellen-154-Hyundai has dual CAN

Closed 2021-10-06.

Thread 82 (2021-08-06):

VAG ibom rendering issue

rusefillc, 2021-08-06:
good example https://rusefi.com/docs/ibom/hellen81-a-ibom.html rendered from https://github.com/andreika-git/hellen81/
good example

problem statement https://rusefi.com/docs/ibom/hellen121vag-b-ibom.html

just a theory: kicad export VRML - maybe in case of large connector we have broken zero point reference and we have offsets drama?

ibom-data folder the NOT kicad folders maybe we are not handling great? maybe improvements for error handling?

andreika-git, 2021-09-13:
We have a temporary solution for the "component offset" drama:
https://github.com/andreika-git/hellen-one/commit/5dd37131639f241db01b9e4a0ce3106a9ebd4e90

rusefillc, 2021-09-14:
We are affected by KiCAD VRML export ignoring "do not show 3D model"

IMHO the proper thing to do would be to create an issue at https://gitlab.com/kicad/code/kicad/-/issues

@andreika-git can you please create an issue at https://gitlab.com/kicad/code/kicad/-/issues let's see how that goes

andreika-git, 2021-09-14:
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

andreika-git, 2021-09-14:
Do we need to check on more recent Kicad version?
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

rusefillc, 2021-09-14:
https://gitlab.com/kicad/code/kicad/-/issues/9166

andreika-git, 2021-09-14:
Here's why the h128merc board image is dark:
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

rusefillc, 2023-03-07:
Let's revisit with KiCAD 7?

andreika-git, 2023-03-20:
Changed board thickness to 1.6 mm hoping to resolve the issue.

Thread 83 (2021-08-12):

explicit success or failure last line message

rusefillc, 2021-08-12:
```
Traceback (most recent call last):
  File "bin/process_board.py", line 289, in <module>
    append_bom(module_path + "/" + module_name + "-BOM.csv", board_bom, module_suffix)
  File "bin/process_board.py", line 143, in append_bom
    des = row[1]
IndexError: list index out of range
All done!
```

we need explicit success or failure last line message

andreika-git, 2021-09-22:
Done.

Closed 2021-09-22.

Thread 86 (2021-08-14):

better error handling:

rusefillc, 2021-08-14:
need explicit "unknown component" error?

```* G?
Traceback (most recent call last):
  File "./bin/copy_from_Kicad.py", line 157, in <module>
    if bom[des]:
KeyError: 'G?'```

rusefillc, 2021-08-14:
#83

Thread 87 (2021-08-14):

better error handling: out of bounds

rusefillc, 2021-08-14:
See #83
```
Traceback (most recent call last):
  File "bin/process_board.py", line 289, in <module>
    append_bom(module_path + "/" + module_name + "-BOM.csv", board_bom, module_suffix)
  File "bin/process_board.py", line 143, in append_bom
    des = row[1]
IndexError: list index out of range
```

Thread 93 (2021-09-19):

Something about GND

rusefillc, 2021-09-19:
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

Qwerty-OFF, 2021-09-19:
We need to reduce the chance of a human error. It is necessary to prevent the user from routing tracks inside the modules where it is unallowable. It is necessary to add GND pads or configure the keepout zones so that the user cannot make a mistake that the DRC will miss in the frame.

It can also be combined with the modification of modules for 4 layers, where on the inner layers there will be GND pads and a polygon.

Thread 94 (2021-09-21):

Better error handling of specific case

rusefillc, 2021-09-21:
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

У меня падает replace. Кажется проблема в частичном совпадении десигнатора. Я меняю U3, но есть еще куча строк типа MMCU3. Если строки с MMCU3 удалить из файлов вручную replace работает. Попробовать можно в 88бмв
"MMCU","MMCU3","Connector_PinHeader_1.00mm:PinHeader_1x01_P1.00mm_Vertical",""
"MMCU","MMCU30","Connector_PinHeader_1.00mm:PinHeader_1x01_P1.00mm_Vertical",""
"MMCU","MMCU31","Connector_PinHeader_1.00mm:PinHeader_1x01_P1.00mm_Vertical",""
"MMCU","MMCU32","Connector_PinHeader_1.00mm:PinHeader_1x01_P1.00mm_Vertical",""
"MMCU","MMCU35","Connector_PinHeader_1.00mm:PinHeader_1x01_P1.00mm_Vertical",""
"MMCU","MMCU38","Connector_PinHeader_1.00mm:PinHeader_1x01_P1.00mm_Vertical",""
"MMCU","MMCU40","Connector_PinHeader_1.00mm:PinHeader_1x01_P1.00mm_Vertical",""
и
"LIS2DW12TR","U3","hellen-one-common:LGA-12_2x2mm_P0.5mm","C189624"

Closed 2021-09-21.

Thread 97 (2021-09-28):

WBO module: through-hole option for MOSFET

rusefillc, 2021-09-28:
JLC does not have SMD WBO MOSFET options, let's make module dual-option with through-hole

@mck1117 FYI if you would be interested to back-port into original module

rusefillc, 2021-09-28:
closed by https://github.com/andreika-git/hellen-one/commit/fbb81e625d6785b877d6fde05a8ff4b707ec4615

rusefillc, 2021-09-28:
VNP28N04-E (C263002) is a candidate

mck1117, 2021-09-29:
euh, I don't really like through hole.  Big vibration problems with a TO220 flapping around.

Closed 2021-09-28.

Thread 101 (2021-10-09):

L6205N PowerDIP not PowerSO

rusefillc, 2021-10-09:
We have exhausted L6205PD stock at JLCPCB
While I am trying to snatch remaining tube packaged L6205PD we have to consider the L6205N PowerDIP option for two reasons

1) JLCPCB might be able to acquire L6205N for us
2) if not, PowerDIP would be 400 times simpler to solder on US soil

See https://datasheet.lcsc.com/lcsc/1810241722_STMicroelectronics-L6205PD013TR_C36543.pdf

rusefillc, 2021-10-09:
@blundar @mck1117 @andreika-git opinions?

blundar, 2021-10-09:
When you have shit to deal with, remember that it is s fertilizer and plant
crops.

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

andreika-git, 2021-10-09:
@andreika-git suggests real-life testing on a prototype board

rusefillc, 2021-10-09:
wow mouser has a few of EVAL6205N

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

blundar, 2021-10-10:
Thermal performance is going to be shit compared to powerso.  They do make
heatsinks that can be used, both clip on and glue on.  Id probably
recommend a thermal adhesive for this because vibration.  The #1 case where
problems will occur is not a current RE test vehicle: centrifugal blower
(vortec and procharger) at medium (25-50%) throttle with a large throttle
plate.  In this murder case, you have the worst case high velocity airflow
and the case where you’re trying to maintain a steady throttle with strong
forces (from air velocity).  You’re going to be at significant duty for
sustained periods of time.  Duty x time = thermal load.

I’m 100% convinced you will be able to make this chip run an ETB.  You’re
going to run into trouble on the endurance race.  You’re going to run into
trouble with demanding ETB applications like my 102mm TB + D1sc SC
nightmare example.  Does this matter for what you’re going to use it for?
Maybe.  If you want help torturing your evaluation boards appropriately,
lmk.

Dave

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

Thread 102 (2021-10-09):

ethernet module or reference

rusefillc, 2021-10-09:
We struggle with physical access to USB on the PCB and USB is not great for harsh automotive in terms of EMI noises

Ethernet would be something we can expose on the OEM connector with a much higher level of confidence

Thread 111 (2021-11-07):

BSP75N C114056  SOT-223 POWER DISTRIBUTION SWITCHES ROHS

rusefillc, 2021-11-07:
is BSP75N  an option for us as injector driver?

is it compatible with current injector driver?

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

there are four related lines

https://jlcpcb.com/parts/componentSearch?isSearch=true&searchTxt=BSP75N

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

rusefillc, 2021-11-07:
@andreika-git @mck1117 @qwerty-off?

rusefillc, 2021-11-07:
We've mentioned BSP76 previously but not BSP75N

rusefillc, 2021-11-07:
look they even say solenoid!

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

rusefillc, 2021-11-07:
low current rating? :(

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

mck1117, 2021-11-07:
That's too low for an injector or VVT.

rusefillc, 2022-03-17:
https://github.com/andreika-git/hellen-one/wiki/module-output#parts-options

Closed 2022-03-17.

Thread 112 (2021-11-07):

linux: false "Library ffi NOT FOUND" due to missing pkg-config

rusefillc, 2021-11-07:
Do we depend on pkg-config without checking that dependency?

under linux/debian I get
```

debian@debian:~/hellen121vag$ ./step3_create_hellen121vag.sh
Hellen-One: Starting a board creation...
Checking dependencies...
Checking the environment...
* linux environment detected!
Checking the Python version...
* Python 2.7.16 detected!
Updating git submodules for scripts...
Checking the Python modules...
* Checking Python module 'simpleparse': OK
* Checking Python module 'contextlib2': OK
* Checking Python module 'PyPDF2': OK
* Checking Python module 'configparser': OK
* Checking Python module 'gerber': OK
* Checking Python module 'cairocffi': ERROR!
  Python module 'cairocffi' is required and NOT found!
* Checking ffi...
Error! Library ffi NOT FOUND!
Do you want to install 'libffi-devel' now? (Press 1 or 2)
```

while I actually have the package
```
debian@debian:~/hellen121vag$ sudo apt-get install libffi-dev
Reading package lists... Done
Building dependency tree
Reading state information... Done
libffi-dev is already the newest version (3.2.1-9).
0 upgraded, 0 newly installed, 0 to remove and 60 not upgraded.
```

I was reading implementation and noticed that pkg-config was mentioned
```
debian@debian:~/hellen121vag$ pkg-config
-bash: pkg-config: command not found
```

I've installed it manually and things got a bit better I was able to move one step forward

rusefillc, 2021-11-07:
I've at least made it report
```
* Missing pkg-config
* TODO auto-install that dependency!
```

Thread 114 (2021-11-07):

"Do you want to download and install it now?" without stating WHAT

rusefillc, 2021-11-07:
At some point check_all suggested to install something without calling it by name?

```
debian@debian:~/hellen-one$ bin/check_all.sh
Checking the environment...
* linux environment detected!
Checking the Python version...
* Python 2.7.16 detected!
Updating git submodules for scripts...
Checking the Python modules...
* Checking Python module 'simpleparse': OK
* Checking Python module 'contextlib2': OK
* Checking Python module 'PyPDF2': OK
* Checking Python module 'configparser': OK
* Checking Python module 'gerber': OK
* Checking Python module 'cairocffi': ERROR!
  Python module 'cairocffi' is required and NOT found!
* Checking ffi...
* Library ffi FOUND!
* Checking cairo...
* Library cairo FOUND!
Do you want to download and install it now? (Press 1 or 2)
1) Yes
2) No
#? 1
Collecting cairocffi
  Downloading https://files.pythonhosted.org/packages/62/be/ad4d422b6f38d99b09ad6d046ab725e8ccac5fefd9ca256ca35a80dbf3c6/cairocffi-0.9.0.tar.gz (84kB)
    100% |████████████████████████████████| 92kB 3.9MB/s
Collecting cffi>=1.1.0 (from cairocffi)
  Downloading https://files.pythonhosted.org/packages/26/28/fb01ff898aa7c93e4774799b3dc0a3693cfee48c5ea4e524ce30e6b10e7e/cffi-1.15.0-cp27-cp27mu-manylinux1_x86_64.whl (393kB)
    100% |████████████████████████████████| 399kB 2.9MB/s
Collecting pycparser (from cffi>=1.1.0->cairocffi)
  Downloading https://files.pythonhosted.org/packages/62/d5/5f610ebe421e85889f2e55e33b7f9a6795bd982198517d912eb1c76e1a53/pycparser-2.21-py2.py3-none-any.whl (118kB)
    100% |████████████████████████████████| 122kB 6.9MB/s
Building wheels for collected packages: cairocffi
  Running setup.py bdist_wheel for cairocffi ... done
  Stored in directory: /home/debian/.cache/pip/wheels/3a/2e/92/89e9dcce600a1a78bebe571fdd096669cba354b29c5e1140b9
Successfully built cairocffi
Installing collected packages: pycparser, cffi, cairocffi
Successfully installed cairocffi-0.9.0 cffi-1.15.0 pycparser-2.21
* Checking Python module 'cairocffi': OK
* Checking Python module 'gzip': OK
Checking if Node.js is installed...
Error! This script requires Node.Js installed in PATH!
Please download and install it from here: https://nodejs.org/en/download/
debian@debian:~/hellen-one$

```

Thread 118 (2021-11-23):

resistors around TC4427

rusefillc, 2021-11-23:
there is an opinion that more resistors are needed to save stm32

https://github.com/rusefi/rusefi/issues/3558

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

rusefillc, 2021-11-23:
we suspect that this board had wild alternator spikes due to bad PID settings this might have contributed to problem

rusefillc, 2021-11-25:
@mck1117 do we have similar RC on any other HW?

mck1117, 2021-11-25:
Proteus and MRE both have it on their ignition/pushpull outputs.

mck1117, 2021-11-25:
Actually I take that back - Proteus/MRE have pulldown resistors on the input side, but no series resistor.  They do, however, have a resistor on the output, also absent from Hellen.

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

andreika-git, 2021-11-26:
All Hellen boards also have pull-down resistors:
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
But no series resistors.

andreika-git, 2021-11-26:
Done: output-0.3
https://github.com/andreika-git/hellen-one/commit/520bed03c96fdb8829f21b9a2b18f8b3528e3318
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

Closed 2021-12-02.

Thread 119 (2021-12-02):

do we survive 5va output power to GND?

rusefillc, 2021-12-02:
See https://github.com/rusefi/rusefi/issues/3559

rusefillc, 2021-12-02:
First order of business is to document current state on MCU module wiki page?

rusefillc, 2021-12-03:
I have about 400 of TLS115D0EJXUMA1

let's please move to TLS115D0EJXUMA1 those are cheap and very resilient

rusefillc, 2021-12-13:
Documented on https://github.com/andreika-git/hellen-one/wiki/module-mcu#supply-output

rusefillc, 2022-01-07:
at this point we do NOT have a unified hellen solution - we simply slap TLS115 on all boards individually. maybe that should be revisited but that's the way it is right now

@beermoneymotorsports FYI

rusefillc, 2022-01-07:
reopening:

@andreika-git what do you think about adding TLS115 on the back of MCU module to make a uniform fix for more of hellen boards?

andreika-git, 2022-01-07:
> reopening:
>
> @andreika-git what do you think about adding TLS115 on the back of MCU module to make a uniform fix for more of hellen boards?

Adding TLS115 on the back is hard on its own, but also it requires some additional conditions:
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
Two more capacitors - hand soldering on the back side?
And +12V source which is unobtainable inside the mcu module.

Maybe we can just try replacing the L101 inductor with a resettable PTC 0805 fuse. For example, SMD0805-050_C66452, which has 0.5A hold current rating and low enough resistance - 0.15 Ohms (but only 6V rated, which is fine for normal operation as +5V power line, but maybe not good enough for "shorting to +12V" protection). Maybe I could even try to fit a larger 1206 footprint instead of 0805 (which gives us even better PTC fuses), but I'm not sure.

Closed 2021-12-13.

Thread 120 (2021-12-02):

do we survive 5va output power to +12v?

rusefillc, 2021-12-02:
See https://github.com/rusefi/rusefi/issues/3559

rusefillc, 2021-12-13:
Documented on https://github.com/andreika-git/hellen-one/wiki/module-mcu#supply-output

Closed 2021-12-13.

Thread 121 (2021-12-13):

module-power12 protection documentation

rusefillc, 2021-12-13:
something like or better than https://github.com/andreika-git/hellen-one/wiki/module-mcu#supply-output for https://github.com/andreika-git/hellen-one/wiki/module-power12

Qwerty-OFF, 2021-12-13:
### Inputs

V12_RAW:

- more than 24V may damage module (24V rated internal fuse for 12V output)
- more than 30V blows external fuse or damage module (need experiment, seems we need fast fuse)
- reverse polarity blows external fuse or damage module (need experiment, seems we need fast fuse)

V12_PERM:

- more than 40V may damage module
- reverse polarity protected

IN_VIGN:

- up to 60V
- reverse polarity protected

V5:

- more than 20V may damage module (is it problem? used only inside board)
- reverse polarity protected

### Outputs

V12:

- has no short circuit protection for IN_VIGN->V12 path (is it problem? used only inside board)
- has no overvoltage protection (maximum of V12_RAW and IN_VIGN)
- back-feed protected

VBAT:

- has no short circuit protection (is it problem? used only inside board)
- back-feed protected

VIGN:

- protected logic output
- weak back-feed if applyed voltage to this pin (is it problem? used only inside board)

Thread 123 (2021-12-17):

Flex input

rusefillc, 2021-12-17:
We need flex input on Hellen board

rusefillc, 2021-12-17:
https://github.com/rusefi/rusefi/wiki/Flex-Fuel says "we expect pull up on ECU"
@mck1117 @BeerMoneyMotorsports please spell out resistor range and voltage on https://github.com/rusefi/rusefi/wiki/Flex-Fuel

rusefillc, 2021-12-17:
@BeerMoneyMotorsports does any specific revision of any specific Miata boards support Flex already?

We shall put an explicit note on the PDF if we do!

BeerMoneyMotorsports, 2021-12-18:
Miata models that support Flex input.  To note, this has only been confirmed on the 90-95.  We need users to confirm functionality on the other boards.

Model-- Header Pin    --    MCU     -- Resistor pullup
90/95 -- 2L(In Digital) -- GPIOF_3   -- 2.7k to 5v
96/97 -- 4B(In Digital) -- GPIOE_12 -- ?? to 5v
99/00 -- 4B(In Digital) -- GPIOE_12 -- ?? to 5v

96-00 uses pullup through the digital module.  i cannot identify what resistors are in use.
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

rusefillc, 2021-12-18:
@andreika-git let's put a note at least on 90-95 schematics?

Thread 124 (2021-12-21):

CAM mode for module-vr-discrete

rusefillc, 2021-12-21:
@mck1117 says there is an untested selectable pullup (ie, we can turn it off via another gpio)

@mck1117 can you provide a relevant snip?

@mck1117 what's the way to proceed in your opinion?

rusefillc, 2021-12-21:
Matthew Kennedy  11:20 PM
so cam vs vr

11:20
I think we probably could (edited)
11:20
the VR interface doesn't care
11:20
the problem would come with the pullup resistor used for digital input

andrey  11:46 PM
on 2chan we can have a dip switch
11:46
on other stuff we can solder a resistor

Matthew Kennedy  11:46 PM
I don't like solder

andrey  11:46 PM
define "problem" i guess

Matthew Kennedy  11:46 PM
I designed for atlas an unproven selectable pullup (ie, we can turn it off via another gpio)

andrey  11:47 PM
how do we want to proceed?
11:47
breadboard test?

Matthew Kennedy  11:47 PM
it SHOULD work
11:47
I did ltspice test
11:47
which I probably trust

rusefillc, 2021-12-21:
https://github.com/rusefi/alphax-2chan/issues/9

mck1117, 2021-12-21:
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

mck1117, 2021-12-21:
When PULL_EN is high, IN1 is pulled up to V_PULLUP via the 2.7k resistor.  When PULL_EN is low, Q1002 goes open circuit and disconnects the pullup.

We would need a separate digital input circuit (series R, clamp diodes, etc) attached to the VR+/VR- pins (two digital inputs possible per VR!), with this circuit replacing the plain pullup resistor.

andreika-git, 2021-12-21:
That's exactly the same method we discussed yesterday with Andrey, but we talked about selectable 5v/12v pullups for tachometer!

Are you sure that the separate digital input would be required, and there is no way to use the vr-discrete as a "pass-through"  for hall sensors (with an external disconnectable pull-up)? I mean, we already used MAX992x as a pass-through for halls, right?

mck1117, 2021-12-21:
Max992x as a pass through had some quirks, particularly with the capacitor across the inputs having the potential to cause a bounce in the output on an edge. This has the same risk. It's better to use the proven digital input circuitry instead of trying to pass through the analog VR front end. It's so cheap and so little area.

andreika-git, 2021-12-22:
> We would need a separate digital input circuit (series R, clamp diodes, etc) attached to the VR+/VR- pins (two digital inputs possible per VR!), with this circuit replacing the plain pullup resistor.

We need to select the series resistance so that it wouldn't clamp the vr signal below zero. If the resistance isn't big enough, then the signal may become unsymmetrical... @mck1117 Do you think 20k is enough?

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

mck1117, 2021-12-22:
VR module already has its own clamps.

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

Since it's a "true" differential input, R758 pictured will pull both inputs (weakly) toward VCC/2, preventing asymmetric clipping.

mck1117, 2021-12-22:
tl;dr a single 10k will be just fine.  We could even use VR+ and VR- *both* as digital inputs.

mck1117, 2021-12-22:
Also, just to confirm, those buffers should be a 74*HC*2G17, not 74*LVC*2G17, since only the HC is specified for both input diodes.

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

andreika-git, 2021-12-22:
> tl;dr a single 10k will be just fine.
The IN_CRANK+ is unclamped yet, and can potentially have big voltage spikes.. Do you think that one 1206 resistor voltage rating (200V) is enough? Maybe it's still more safe to put them two in series (4.7k+4.7k)

> We could even use VR+ and VR- _both_ as digital inputs.
Yes, but not on my current project - I'm afraid the board is too small to fit another disconnectable pullup circuitry for the second input...

> Proteus uses the 'HC2G17, and has been tested
Yep, Hellen uses it too.

mck1117, 2021-12-22:
> The IN_CRANK+ is unclamped yet, and can potentially have big voltage spikes

Huh? It's clamped inside the VR module already. A single 1206 is plenty. I've never seen more than tens of volts on a VR.

andreika-git, 2021-12-22:
Did you see the reference schematics for MAX992x?
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
Did you see the schematics of the Frankenso?
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
Did you see the schematics of the vr module?
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

The signal is clamped inside the vr-discrete module, but that's after the R752&R753 resistors, not before.
Let me also quote the Infineon paper (eg. for TLE4922): "_The output voltage of a VR-sensor can range from only a few Millivolts going up **to several hundreds of Volts** depending on air gap and tooth-frequency in front of the sensor._ "

Thread 125 (2021-12-27):

stop mode considerations

rusefillc, 2021-12-27:
Placeholder for MCU wake up hardware changes if any would be required

Placeholder for overall low current consumption stop mode on Hellen if any would be required overall

rusefillc, 2021-12-27:
As of today I have not seen stop/wake up in software unfortunately

rusefillc, 2021-12-27:
turn off BT module?
turn off IAT/CLT/TPS sensors +5v? Looks like at 1K per sensor that's 5mA per sensor?

NMSTEC, 2021-12-29:
Have entire 5v/12v rail shutdown completely anyway upon sleep. Only communication is required anyway during ign off.

Thread 126 (2021-12-31):

TJR1443 schematics

rusefillc, 2021-12-31:
TJR1443
https://octopart.com/search?q=TJR1443&currency=USD&specs=0
is the best of available transceivers with wake-up feature, we shall try it on some of our designs

rusefillc, 2021-12-31:
Do we have space on alpha-x? Maybe on back side since that's a one-time test?

andreika-git, 2022-01-01:
Maybe we can try TJR1442AT first? It's the same [TJR114x family](https://www.nxp.com/products/interfaces/can-transceivers/can-with-flexible-data-rate/automotive-can-fd-transceiver-family:TJA144x), but in a SO8 package - pin compatible with our existing CAN module.

rusefillc, 2022-01-01:
https://octopart.com/search?q=TJR1442AT&currency=USD&specs=0 shows no availability comparing with https://octopart.com/search?q=TJR1443&currency=USD&specs=0

rusefillc, 2022-01-08:
@andreika-git can we test TJR1443 on alphax-4chan?

Thread 128 (2022-01-04):

input module symbol usability

rusefillc, 2022-01-04:
can we add any useful info right on input module on top page of schematics like

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

for instance resistor values. Do we use same value for all pull-downs? Do we always use same value for all pull-ups?

andreika-git, 2022-01-04:
Explain this:
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

andreika-git, 2022-01-07:
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

Thread 129 (2022-01-14):

alphax-2 chan ibom issue

rusefillc, 2022-01-14:
https://rusefi.com/docs/ibom/alphax_2ch-a-ibom.html is not well at least in terms of jumpers and Q* in the corner

rusefillc, 2022-01-14:
Side note https://gitlab.com/kicad/code/kicad/-/issues/10427

andreika-git, 2022-01-15:
Some improvements were made: https://github.com/rusefi/alphax-2chan/commit/abc5a8ebcc6c41277835404d8beb879a369020f5
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
But still the "pcb" mode needs a solution for wrong VRML export...

andreika-git, 2022-01-15:
These commits contain the fix:
https://github.com/rusefi/alphax-2chan/commit/92fd5b5673dd5f4d12652d63d3fbda9657d96fd1
https://github.com/rusefi/alphax-2chan/commit/91e5ef016314e5647f6cc83b78ca2cee16ba263e
https://github.com/rusefi/alphax-2chan/commit/e9ce4495ee0449a3d88da4ec8a895c0278310a68
https://github.com/andreika-git/hellen-one/commit/f4a77038f289d80cee1175e8621dbb18583f7e1a
https://github.com/andreika-git/hellen-one/commit/87ed08e89f21c9c0805b78007eb04ac6608884f4
https://github.com/andreika-git/hellen-one/commit/15edebca0159f1d3145b61e1e0d41f87b1c1dd0e
https://github.com/andreika-git/hellen-one/commit/fcb62a786cf2ece60d0c5d966575e693b0ccbd8e
https://github.com/andreika-git/hellen-one/commit/8a70b219a5906cba4a520e92416ce6ff446d2ccc
https://github.com/andreika-git/hellen-one/commit/8cc300512e82af056219ab5d529753e834c27296

rusefillc, 2022-01-29:
progress was made

Closed 2022-01-29.

Thread 130 (2022-01-14):

Migrate to python 3+

rusefillc, 2022-01-14:
We have https://www.kicad.org/blog/2021/12/KiCad-6.0.0-Release/ which uses Python 3

rusefillc, 2022-01-14:
Depends on https://github.com/rusefi/gerbmerge/issues/3

Thread 131 (2022-01-16):

MCU module documentation - LED

rusefillc, 2022-01-16:
i was wondering about LED placement on real PCB and I have no idea what sources of info would be available to me

anyway on the schematics

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

is there any meaning to this order? would it be an improvement for order of LEDs on the schematics to correlate with physical world order?

Thread 132 (2022-01-17):

MCU module needs note about UART8

rusefillc, 2022-01-17:
We have UART8 at least on MCU144 and UART8 is not present at least on stm32f40x not sure about stm32f42x

we need at least a warning right on MCU module symbol

rusefillc, 2022-05-17:
Done see https://github.com/rusefi/alphax-2chan/issues/21#issuecomment-1041841754

Thread 133 (2022-01-17):

UART1 shall we rename to UART8?

rusefillc, 2022-01-17:
mcu module is specific to stm32 MCU

In my opinion it's confusing to refer to UART8 as UART1 for whatever numbering logic

on this snipped names on left and right should be same
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

rusefillc, 2022-01-17:
I see some similarity to #134

Thread 135 (2022-01-26):

JLC is not happy with ign8

abelom, 2022-01-26:
See https://github.com/rusefi/hellen128merc-issues/issues/51 there is a report of single holes becoming slightly offset pairs of holes

rusefillc, 2022-05-17:
@andreika-git was this fixed by https://github.com/andreika-git/hellen-one/commit/8024162d1d9963e9ef1200ac4bfcfc9189046d0e ?

andreika-git, 2022-05-17:
Yes

Closed 2022-05-17.

Thread 138 (2022-02-14):

Can we power VR discrete from sensor supply +5VA

rusefillc, 2022-02-14:
Since we control +5VA for low consumption sleep would the simplest way to sleep VR discrete be powering it off +5VA?

rusefillc, 2022-02-14:
@mck1117

mck1117, 2022-02-17:
DO NOT power any internal devices off of the external 5V sensor supply bus.  Remember, the external 5v sensor bus has the design specification of allowing short circuits to any external voltage on a car.

rusefillc, 2022-02-17:
@mck1117 says "vr discrete requirement is 5v does not go above 5v"

@andreika-git i think we have the case of me failing to be the messenger. I strongly suspect that at the moment my not great questions is causing @mck1117 not to answer the real question you are after.

@andreika-git would you like to ask a better specific question?

rusefillc, 2022-02-17:
@mck1117 says "the 5v rail does not need to be super duper mega accurate, using a second tls115 for internal 5v things would be fine"

rusefillc, 2023-01-28:
8chan has two different tls115

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

Closed 2023-01-28.

Thread 139 (2022-02-17):

Simplify MCU power supply architecture

mck1117, 2022-02-17:
The MCU module should have the following external power supply pins:
- 5V MCU supply input - powers MCU analog and digital
- V5A "aux" supply input - powers anything not-MCU
- V33 - 3.3v output from MCU module's regulator, supplied via 5V

Internal to MCU module:
- VCC -> 3.3v regulator generates MCU supply voltage
- VCC -> 3.3v reference chip (REF3033 or similar) generates voltage for VREF+. These references are not only more accurate than the regulators we use now, but are also far more stable over temperature changes, since we could realistically see -20 to +70 C
- 3.3v -> 3.3va ferrite bead powers MCU analog rail (not separate regulator)
- V5A powers opamps
- Retain existing VBUS -> VCC architecture

Rough list of changes:
- Remove U111, move L101 ferrite to between 3v rails instead of 5v.
- Do NOT internally power V5A rail, this allows us to turn off opamps externally.
- On "normal" boards, connect V5A to 5V externally.
- On "low power aware" boards, connect V5A to a separate supply that we can turn off at our leisure.

Why?
- More precise 3.3v reference improves analog accuracy and stability
- Using the same regulator for 3v and 3v_analog ensures meeting STM32's power sequencing requirements (today, if 5va is powered externally from a separate regulator, you _will_ violate the power sequencing and risk undefined behavior or damage)
- Externally split rails means it's simpler to do "low power" boards that need to turn off non essential logic

mck1117, 2022-03-17:
@andreika-git the change to use a polyfuse on the mcu module is not good - it means its now easier to exceed the maximum ratings for the STM32.

It doesn't allow a difference in voltage between VDD and VDDA, which is now possible if an external fault causes the polyfuse to trip.

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

Not to mention that losing the VDDA rail will cause the main PLL to unlock, halting the stm32.

mck1117, 2022-03-17:
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

rusefillc, 2022-10-17:
@Qwerty-OFF just a FYI

rusefillc, 2022-10-17:
We have REF3033 on WBO shall we reuse? https://github.com/andreika-git/hellen-one/issues/189

mck1117, 2022-10-17:
@rusefillc we should do it the other way around, put a ref3x33 in the MCU module, then have an INPUT on the wbo module to use the same reference as MCU

rusefillc, 2022-10-17:
Yes absolutely. But in boring real life https://github.com/andreika-git/hellen-one/issues/189 has a chance to happen much sooner.

rusefillc, 2022-12-05:
@Qwerty-OFF it's probably just a bit late to ask about this one?

rusefillc, 2022-12-07:
@Qwerty-OFF says that we have at least three separate reasons to change

* 3.3 precision
* shutdown of op-amps
* fewer components

Since mm-0.1 seems ready my proposal is to implement this ticket within mm-0.2 later this month

mck1117, 2022-12-07:
Yes - those are all good reasons. The opamps right now I think are most why the the "sleep" current is so high.

dron0gus, 2022-12-07:
Few thoughts:
I use 2.5V as ADC reference voltage. Just because 5 / 2.5 = 2, while 5 / 3.3 = 1.51(51). I use same 0.5% resistors in top and bottom half of divider between OpAmps and MCU.
I use -0.6V and 5.5V to supply OpAmp. Not to care how good and linear OpAmps when close to rails. LM7705 for -0.6V and TLE7368E's 5.5V pre-regulator. If you going to have separate controllable supply for OpAmps 5.5V is reasonable.

For analog input diagnostic we should reserve some top ADC values for "short to battery" detection. On Subaru's stock ICU analog inputs have both pull-up and pull-down. Pull-up is something standard 1K and pull-down is hundreds of KOhm. So when sensor is disconnected ADC will see something < 5.0V, bit still out of valid range. And while it is short to battery ADC will see max possible value. This will need some additional support from SW.

mck1117, 2022-12-08:
> Not to care how good and linear OpAmps when close to rails.

The MCP6004/TP6004 are very good down to below 10mv. No sensors I've ever seen go below ~0.2v, so short to ground detection is easy enough. I've never seen it not work on any existing rusEFI board that uses 0v negative amp supply with MCP600x/TP600x. We had a batch accidentally made with LMV324, and those certainly had problems with both rails.

> For analog input diagnostic we should reserve some top ADC values for "short to battery" detection.

We could, yes, but I'm not sure of the value. I think the "separate opamp supply" is actually the "everything but MCU supply", so it probably does have to be 5.0v, not 5.5v/6v.

Besides, do we think there is additional value in detecting "short to 5v" vs "short to 12v"? We can detect that there is _some_ problem either way.

dron0gus, 2022-12-09:
> Besides, do we think there is additional value in detecting "short to 5v" vs "short to 12v"? We can detect that there is _some_ problem either way.

AFAIR none of stock ECU differ short to +12 and short to +5. So everything close to max ADC value is short to battery.
I'll measure pull-up and pull-down on stock Subaru ECU on temperature and MAF inputs and get back.

Qwerty-OFF, 2022-12-27:
@mck1117 please check
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

mck1117, 2022-12-29:
That schematic looks OK to me. Is there a pulldown on PWR_EN? Reminder that the STM32 is effectively under reset while asleep, so the pins could be floating, and static will build up and turn on the aux rails.

rusefillc, 2023-02-11:
Status update: I have https://github.com/rusefi/rusefi/wiki/Hellen-125-Honda-K board based on https://github.com/andreika-git/hellen-one/tree/master/modules/mega-mcu144/0.2 in my hands!

Current state https://github.com/rusefi/hellen125honda-issues/issues/19 and now seems like great time to ask if any software was expected :)

Let's document key points at https://github.com/andreika-git/hellen-one/wiki/module-mega-mcu https://github.com/andreika-git/hellen-one/wiki/module-power12-and-5

like what is PG_5VP? etc

Thread 142 (2022-03-12):

MCU144 schematics usability

rusefillc, 2022-03-12:
on real board blue and yellow are on the edges with red and green in the middle

order of colors on PCB should match order of colors on schematics which it does not at the moment

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

rusefillc, 2022-03-12:
let's fix without MCU module version increase

Thread 143 (2022-03-12):

why is FATAL led green on mcu144 boards?!

rusefillc, 2022-03-12:

rusefillc, 2022-03-12:
PDF says
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

rusefillc, 2022-03-12:
https://rusefi.com/docs/ibom/alphax_2ch-b-ibom.html

ibom says D104 is D104 and D103 is red

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

rusefillc, 2022-03-12:
while we are fixing this I suggest usability improvement:

instead of LED1-4 let's have LEDR LEDG LEDB LEDY

rusefillc, 2022-03-12:
@andreika-git what's your take on this issue? does it look like schematics is wrong while ibom is right?

andreika-git, 2022-03-13:
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

Both the schematics and iBOM are correct. The label positions on schematics are confusing: a designator is on top of a component and value is on bottom.

rusefillc, 2022-03-13:
green LED was a SW issue https://github.com/rusefi/rusefi/commit/9de0c10f24f9f587f0179a4230439f8a1fd08144

Thread 144 (2022-03-14):

outputs using BM2LC105FJ-C

rusefillc, 2022-03-14:
between https://support.jlcpcb.com/article/192-how-to-use-jlcpcb-global-sourcing-parts-service and sometimes availability of BM2LC105FJ-C on mouser what is level of effort to create a compatible version of outputs using BM2LC105FJ-C?

rusefillc, 2022-03-14:
@andreika-git shall I ask one of the freelancers?

it's kind of low priority while BM2LC105FJ-C stock is low on mouser. mouser stock is low because I've consumed it before I've learned about https://support.jlcpcb.com/article/192-how-to-use-jlcpcb-global-sourcing-parts-service

rusefillc, 2022-03-14:
We can revision once those 5000 arrive in stock if Beer is tired of soldering outputs

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

rusefillc, 2023-02-09:
Duplicate #190

rusefillc, 2024-01-28:
BM2LC120FJ-C or BM2LC105FJ-C

Thread 145 (2022-03-23):

Combined footprint for both kinds of TLS115

rusefillc, 2022-03-23:
is it possible to combine TSON-10 TLS115D0LDXUMA1 and SOIC-8 TLS115B0EJXUMA1?

that would be beneficial in current chip shortage times - I can hand solder my SOIC-8 stock while waiting for JLC to get  TSON-10 parts

andreika-git, 2022-03-24:
P.S. https://github.com/andreika-git/hellen-one/blob/master/kicad/footprints/PG-TSON-10-2.kicad_mod

rusefillc, 2022-03-24:
But we can probably use TSON-sized thermal-pad for both? @mck1117 opinions?

I agree that we can manually manage between batches but shared footprint is so much easier on humans!

andreika-git, 2022-03-24:
The SOIC package itself (which is actually "PG-DSO-8 EP" not SOIC) has the big-sized thermal pad on its bottom with would overlay and short the pads of TSON.

mck1117, 2022-03-24:
I would not try to do shared footprint. The pins of the smaller footprint nearly (or do) overlap the exposed pad on the larger footprint - so you'd short out every pin by installing the larger chip.

We can always just put two footprints next to each other...

Closed 2022-12-27.

Thread 149 (2022-04-07):

Improve D420 silkscreen

rusefillc, 2022-04-07:
let's see what could be done about https://github.com/rusefi/alphax-2chan/issues/49

Thread 150 (2022-04-16):

Do we have a problem with gerbers?

rusefillc, 2022-04-16:
low6
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

@mck1117 points at the flipped (?) SD card module
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

this is the low6 net highlighted

that via is INSIDE the sd card module
the thick blue outline is the SD card module
a module that brings along its own full ground plane on the back layer
I bet $1 every other via inside that module is also shorted to ground
including your 3.3v rail

Thread 151 (2022-04-16):

input module footprint/revision inconsistency (internal layers affected!)

andreika-git, 2022-04-16:
We have two versions of input module footprints which belong to the same module revision 0.1, and they are used on numerous Hellen boards.
Some boards use older 2-layer footprint version (input-0.1):
- all Miata boards (including newest hellen72_NB2-e)
- hellen121nissan
But some use newer footprints with "In1.Cu" "In2.Cu" zone exclusions, and can be used in multilayer boards, BUT they still have the same revision 0.1! For example:
- hellen121vag
- hellen88bmw
- hellen128mercedes

rusefillc, 2022-04-16:
What's the way forward? Shall we have a proper 0.2 with definitive number of layers?

Thread 152 (2022-04-16):

Additional frame module constrain validation

rusefillc, 2022-04-16:
For instance frames are not allowed to have vias in specific regions, we shall automatically validate

rusefillc, 2022-05-17:
https://github.com/rusefi/alphax-4chan/commit/b8a7da921f2a3ee6e8ca3c3e1cee54d0250cf79e would be a test case

Thread 154 (2022-05-08):

Schematic note about CAN2

rusefillc, 2022-05-08:
Some of SPI pins have secondary role of CAN2

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

let's add a note right on the kicad symbol to reflect that fact more or less in the uart8 note style

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

Thread 155 (2022-05-12):

We have to rename a lot on input module. A, D, A+D note for kicad MCU symbol

rusefillc, 2022-05-12:
Let's add A, D or A+D which we see on the left as helper right into official MCU module symbol, on the right of the image

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

no need for index in A
we need index into D to avould EXTI implementation detail overlap

since gerbers and copper does not change we can update MCU module without version increment

rusefillc, 2022-08-23:
https://github.com/rusefi/hellen154hyundai/ is now getting same as E67 treatment and this is already very confusing

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

We need to coordinate this change with #175

rusefillc, 2022-08-24:
let's rename *SENS* to
something like IN_DIGITAL_1-2-3-4

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

let's rename IN_CRANK/CAM/VSS to IN_AN_DIG_*? IN_A_D_*?
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

andreika-git, 2022-10-01:
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

andreika-git, 2022-10-01:
https://github.com/andreika-git/hellen-one/commit/7977543e78785a68ced2b9ec68c9ae680e402bd6

rusefillc, 2022-10-03:
@andreika-git i think we can use same treatment for more pins - while we do not need it for ALL pins, we need options still to allow crank and cam on unusual pins in order to free up analog

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

rusefillc, 2022-11-10:
That's PF11 is it? is it digital-only?

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

andreika-git, 2022-11-10:
> That's PF11 is it? is it digital-only?

It's digital-only for F429 (EINT11):
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

rusefillc, 2022-11-10:
Progress!

where is it analog? looks like it's digital only on F407? Is it analog on F7 or H7?

once/if we correct the note I suggest we copy the note to the symbol same was as we have uart8 note

rusefillc, 2024-12-22:
@Qwerty-OFF мы видимо унаследовали этот нюанс в mega-mcu? дырочки для логического анализатора должны быть по уму на digital-but-not-analog каналах?

Qwerty-OFF, 2024-12-22:
У нас есть несколько дырочек в ММ. Для всех-всех каналов места не хватит

Thread 156 (2022-05-16):

E67 step3 fails

rusefillc, 2022-05-16:
[err.txt](https://github.com/andreika-git/hellen-one/files/8701691/err.txt)
[log.txt](https://github.com/andreika-git/hellen-one/files/8701692/log.txt)

rusefillc, 2022-05-16:
```
rusefi@DESKTOP-57S88S8:~/hellen-gm-e67$ pip3 freeze | grep ca
backcall==0.1.0
cairocffi==1.3.0
macaroonbakery==1.3.1
pycairo==1.16.2
pymacaroons==0.13.0
rusefi@DESKTOP-57S88S8:~/hellen-gm-e67$
```

rusefillc, 2022-05-16:
```
* Checking module dependencies: jpeg
* Checking jpeg...
* Library jpeg FOUND!
* Checking Python module 'cairocffi': ERROR!
  Python module 'cairocffi' is required and NOT found!
* Checking module dependencies: ffi and cairo
* Checking ffi...
* Library ffi FOUND!
* Checking cairo...
* Library cairo FOUND!
Do you want to download and install it now? (Press 1 or 2)
1) Yes
2) No
#? 1
* Found python-dev on /usr/include/python3.8
* Installing python module cairocffi using pip 20.0.2 from /usr/lib/python3/dist-packages/pip (python 3.8) and gcc version 9.3.0 (Ubuntu 9.3.0-17ubuntu1~20.04) ...
Processing /home/rusefi/.cache/pip/wheels/f3/97/83/8022b9237866102e18d1b7ac0a269769e6fccba0f63dceb9b7/cairocffi-1.3.0-py3-none-any.whl
Requirement already satisfied: cffi>=1.1.0 in /home/rusefi/.local/lib/python3.8/site-packages (from cairocffi) (1.15.0)
Requirement already satisfied: pycparser in /home/rusefi/.local/lib/python3.8/site-packages (from cffi>=1.1.0->cairocffi) (2.21)
Installing collected packages: cairocffi
Successfully installed cairocffi-1.3.0
* Checking Python module 'cairocffi': OK
* Checking module dependencies: ffi and cairo
* Checking ffi...
* Library ffi FOUND!
* Checking cairo...
* Library cairo FOUND!
* Checking Python module 'gzip': OK
* Checking Python module 'ModernGL': OK
* Checking module dependencies: GL
All checks done!
Processing Hellen board...
Removing old files of the board...
Creating hellen-gm-e67-a...
* appending the CPL with offset (0,0)...
* (skipping M1)ssed...
* (skipping M2)
* (skipping M3)
* (skipping M4)
* (skipping M5)
```

rusefillc, 2022-05-16:
```
Please install it manually using your package manager!
debian@debian:~/hellen-gm-e67$ ./step3_create_hellen-gm-e67.sh
Hellen-One: Starting a board creation...
Checking dependencies...
Checking the environment...
* linux environment detected!
Checking the Python version...
Error! Python 3.5 or later is required. It should be installed and added to the PATH!
Do you want to install 'python3' now? (Press 1 or 2)
1) Yes
2) No
#?

```

rusefillc, 2022-05-16:
this tells me that we need #159

rusefillc, 2022-08-23:
i guess that's taken care of by Docker?

Closed 2022-08-23.

Thread 157 (2022-05-16):

3.5 or 3.8?

rusefillc, 2022-05-16:
```
git clone --recurse-submodules https://github.com/rusefi/alphax-2chan.git
cd alphax-2chan
```

rusefillc, 2022-05-16:
```
debian@debian:~/hellen-gm-e67$ ./step3_create_hellen-gm-e67.sh
Hellen-One: Starting a board creation...
Checking dependencies...
Checking the environment...
* linux environment detected!
Checking the Python version...
Error! Python 3.5 or later is required. It should be installed and added to the PATH!
Do you want to install 'python3' now? (Press 1 or 2)
1) Yes
2) No
#? 1
Reading package lists... Done
Building dependency tree
Reading state information... Done
The following packages were automatically installed and are no longer required:
  accountsservice bolt distro-info-data espeak-ng-data fonts-dejavu fwupd fwupd-amd64-signed gedit-plugins-common gir1.2-accountsservice-1.0 gir1.2-atspi-2.0 gir1.2-caribou-1.0 gir1.2-dazzle-1.0 gir1.2-gck-1 gir1.2-gcr-3 gir1.2-gdm-1.0
  gir1.2-ggit-1.0 gir1.2-gmenu-3.0 gir1.2-gnomebluetooth-1.0 gir1.2-grilo-0.3 gir1.2-gucharmap-2.90 gir1.2-ibus-1.0 gir1.2-mediaart-2.0 gir1.2-mutter-3 gir1.2-nm-1.0 gir1.2-nma-1.0 gir1.2-notify-0.7 gir1.2-packagekitglib-1.0
  gir1.2-polkit-1.0 gir1.2-rb-3.0 gir1.2-rsvg-2.0 gir1.2-totem-1.0 gir1.2-totemplparser-1.0 gir1.2-upowerglib-1.0 gir1.2-vte-2.91 gir1.2-wnck-3.0 gnome-session-bin gnome-session-common gnome-shell-common gnome-software-common
  libaccountsservice0 libappstream-glib8 libblkid-dev libbrlapi0.6 libcairo-script-interpreter2 libcaribou-common libcaribou0 libdotconf0 libespeak-ng1 libexpat1-dev libfontconfig1-dev libfreetype6-dev libfwupd2 libgcab-1.0-0 libgdm1
  libgit2-27 libgit2-glib-1.0-0 libgnome-menu-3-0 libgpod-common libgpod4 libgucharmap-2-90-7 libhttp-parser2.8 libibus-1.0-5 liblirc-client0 liblouis-data liblouis17 liblzo2-2 libmbedcrypto3 libmbedtls12 libmbedx509-0 libmount-dev
  libmtp-common libmtp-runtime libmtp9 libpcaudio0 libpcre16-3 libpcre3-dev libpcre32-3 libpcrecpp0v5 libpixman-1-dev libpng-dev libpng-tools libpython3-dev libpython3.7-dev libselinux1-dev libsepol1-dev libsgutils2-2 libsmbios-c2
  libsonic0 libspeechd2 libtss2-esys0 libtss2-udev libwnck-3-0 libwnck-3-common libxcb-render0-dev libxcb-shm0-dev libxext-dev libxmlb1 libxrender-dev libxres1 libyelp0 libzeitgeist-2.0-0 python-apt-common python-pip-whl python3.7-dev
  sound-icons speech-dispatcher speech-dispatcher-audio-plugins speech-dispatcher-espeak-ng switcheroo-control tpm2-abrmd tpm2-tools uuid-dev x11proto-xext-dev xbrlapi xwayland yelp-xsl
Use 'sudo apt autoremove' to remove them.
Suggested packages:
  python3-doc python3-tk python3-venv
The following NEW packages will be installed:
  python3
0 upgraded, 1 newly installed, 0 to remove and 4 not upgraded.
Need to get 61.5 kB of archives.
After this operation, 191 kB of additional disk space will be used.
Get:1 http://debian.uchicago.edu/debian buster/main amd64 python3 amd64 3.7.3-1 [61.5 kB]
```

rusefillc, 2022-05-16:
prior to that push ^^^

```
Please install it manually using your package manager!
debian@debian:~/hellen-gm-e67$ ./step3_create_hellen-gm-e67.sh
Hellen-One: Starting a board creation...
Checking dependencies...
Checking the environment...
* linux environment detected!
Checking the Python version...
Error! Python 3.5 or later is required. It should be installed and added to the PATH!
Do you want to install 'python3' now? (Press 1 or 2)
1) Yes
2) No
#?

```

rusefillc, 2022-05-16:
@andreika-git I took the liberty to make a trivial change

Closed 2022-05-16.

Thread 158 (2022-05-16):

3.5 or 3.8?

rusefillc, 2022-05-16:
```
Please install it manually using your package manager!
debian@debian:~/hellen-gm-e67$ ./step3_create_hellen-gm-e67.sh
Hellen-One: Starting a board creation...
Checking dependencies...
Checking the environment...
* linux environment detected!
Checking the Python version...
Error! Python 3.5 or later is required. It should be installed and added to the PATH!
Do you want to install 'python3' now? (Press 1 or 2)
1) Yes
2) No
#?

```

Closed 2022-05-16.

Thread 161 (2022-05-18):

Actually use Docker

rusefillc, 2022-05-18:
Current status: we have self-contained docker sets up all dependencies and runs a functional test see happy https://github.com/andreika-git/hellen-one/blob/master/.github/workflows/test-check-all.yaml

Next step: we need some sort of file integration/mount external file system/volume in order to invoke https://github.com/rusefi/alphax-2chan/blob/main/step2_copy.sh and https://github.com/rusefi/alphax-2chan/blob/main/step3_create_board.sh within docker maybe using https://github.com/andreika-git/hellen-one/blob/master/step2-run-docker.sh

ZHoob2004, 2022-05-18:
https://github.com/ZHoob2004/alphax-2chan/commit/7b87e7bb00ba92284ece0bde7cd8459fdaad8c2e

example implementation to use existing container as a build tool

In short, it mounts alphax-2chan at /alphax-2chan in the container then uses the --entrypoint parameter to run either bash or python depending on the task required

[step1_build_hellen-one_docker.sh](https://github.com/ZHoob2004/alphax-2chan/blob/main/step1_build_hellen-one_docker.sh) could be removed if we push hellen-one to docker hub. (like using GHA)

In that case, later commands would need minor revision to use (for example) andreika/hellen-one instead of the locally tagged builds

rusefillc, 2022-05-18:
thank you @ZHoob2004 !!!

rusefillc, 2022-05-21:
Wow, just wow.

Closed 2022-05-21.

Thread 163 (2022-05-18):

option not to render 3D

rusefillc, 2022-05-18:
At the moment docker fails to render 3D

between all the papercuts of 3D can we please have a configuration option not to render 3D?

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

rusefillc, 2022-05-19:
Life is pain so for right now we can disable ibom as well since it's broken anyway

rusefillc, 2022-05-21:
abort since works on docker with frame buffer https://github.com/andreika-git/hellen-one/commit/7ef7b566ddc6f19a3a39695ce322ff604ca7e039

Closed 2022-05-21.

Thread 165 (2022-05-21):

Hellen MCU VR test plan

rusefillc, 2022-05-21:
What's the simpest way to try hellen mcu VR without a complete hellen ECU on the vehicle? Maybe toggling output on VR front change?

andreika-git, 2022-06-15:
Maybe hellen88bmw?
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

Thread 166 (2022-06-06):

typo? high1 shared pin with what low?

rusefillc, 2022-06-06:
https://github.com/andreika-git/hellen-one/wiki/module-output

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

andreika-git, 2022-06-06:
Fixed:
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

Closed 2022-06-06.

Thread 167 (2022-06-10):

TLS115 is important but chip shortage is forcing us to have both packages supported

rusefillc, 2022-06-10:
Right now TLS115D0LDXUMA1 in TSON-10 package is more available than TLS115D0EJXUMA1 in PG-DSO-8 package

flexibility of ordering is desired, please investigate if a hellen module for just one part with two variations is a way to achieve

rusefillc, 2022-06-11:
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

rusefillc, 2022-07-25:
See https://github.com/andreika-git/hellen-one/commit/0fe5bfe417e1f6757a138ce7c60db6277b0a5df2

rusefillc, 2022-08-23:
Looks like we are just handling this manually for now and hellen module is not needed?

@Qwerty-OFF any opinions?

Qwerty-OFF, 2022-08-23:
Not much work here, perhaps we should make a double-sided hellen module in which two footprints will be compactly combined.

rusefillc, 2022-08-23:
I like this idea!

hand-assembled SOIC should be on the back and TSON-10 should be on top side

Thread 168 (2022-06-18):

huge via for WBO mosfet chip

rusefillc, 2022-06-18:
Same as https://github.com/rusefi/hellen88bmw-issues/issues/48 etc etc

let's assume that it's a safe change and adjust gerbers WITHOUT increasing module version

Qwerty-OFF, 2022-06-19:
Updated WBO. Let's close the ticket after the successful export of bmw88.

Closed 2022-12-27.

Thread 170 (2022-07-24):

vr-discrete says MAX9142ESA+T is no more

rusefillc, 2022-07-24:
https://github.com/andreika-git/hellen-one/wiki/module-vr-discrete is asking for MAX9142ESA+T which seems to no longer exists

do we have JLC or findchips.com alternatives in stock? would we have to adjust gerbers for an alternative part?

rusefillc, 2022-07-24:
@Qwerty-OFF can you please help?

@mck1117 FYI

rusefillc, 2022-07-24:
Actually I can totally order more just not on JLC, so the priority goes down - still, would be nice to find a JLC alternative even if that would mean gerber adjustment

Qwerty-OFF, 2022-07-24:
@mck1117 please check
TLV3202AIDR_C129325
TLV3702ID_C133808 (too slow?)

rusefillc, 2022-07-25:
@mck1117 says

TLV3202 looks ok

TLV3702 is too slow

Closed 2022-07-25.

Thread 171 (2022-07-26):

Expose more stm32 pins on mcu-144

rusefillc, 2022-07-26:
How come we have a few unconnected pins

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

rusefillc, 2022-07-26:
@andreika-git can you please remind? is this related to 2 layer limitation of the module or else?

andreika-git, 2022-07-30:
> @andreika-git can you please remind? is this related to 2 layer limitation of the module or else?

Related to very dense component layout and lots of vias (which are pass-through all layers).
4 layers version *could* possibly help to expose some of the hidden pins, but no guarantees...

rusefillc, 2022-07-30:
https://github.com/rusefi/alphax-4chan/issues/51

rusefillc, 2022-10-05:
[8chan ](https://github.com/rusefi/alphax-8chan/issues/22) is asking for this change on MCU 0.7

andreika-git, 2022-10-20:
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

The new exposed pins are:
- IO5 = PG15
- IO6 = PD8
- IO7 = PF15
- IO8 = PE10
- IO9 = PF2 (not recommended! reserved for future Board-ID expansion)

Currently all 144 pins are used!

The mcu-0.7 module (176-pin) was also modified to support the new symbol/footprint (and the same pins).

rusefillc, 2022-10-20:
or even remove it from footprint?

Closed 2022-10-20.

Thread 173 (2022-07-31):

Fun ticket to track mc33810 availability

rusefillc, 2022-07-31:
mouser has some but not many

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

newark has just recieved a shipment?!

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

rusefillc, 2022-07-31:
also digikey has it and JLC is happy to solder for us

@eldominio @dron0gus @andreika-git I wonder if we should use this one on 8chan?!

rusefillc, 2022-08-19:
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

rusefillc, 2022-10-12:
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

rusefillc, 2022-11-23:
@dron0gus says to use FGD3440G2-F085

rusefillc, 2023-02-02:
by the way М74 CAN uses that chip

rusefillc, 2023-11-16:
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

Thread 175 (2022-08-06):

double-sided version of input module

rusefillc, 2022-08-06:
problem statement: fit more stuff by using double-sided assembly

would input module be most space reduction with least effort by going double sided?

rusefillc, 2022-08-24:
@Ringenium is working on this

Closed 2022-12-27.

Thread 176 (2022-08-06):

double-sided version of WBO with integrated CAN and option for external REF

rusefillc, 2022-08-06:
problem statement: fit more stuff by using double-sided assembly

WBO always goes with CAN

https://github.com/andreika-git/hellen-one/tree/master/kicad/modules/hellen1-wbo
combined with CAN transiever - see for instance https://github.com/rusefi/hellen154hyundai/
See https://github.com/andreika-git/hellen-one/tree/master/modules/can/0.1

can we reduce combined space by going double-sided?

Qwerty-OFF, 2022-08-06:
Without changes in WBO module it is impossible, bottom side occupied by tracks.

rusefillc, 2022-08-06:
Right, i mean to change the module

Qwerty-OFF, 2022-08-07:
Is only CAN move to bottom or other WBO components also for minimization?

rusefillc, 2022-08-07:
any component where it's reasonable for electrical reasons could go on the back side in order to reduce total rectangle size

@mck1117 FYI

mck1117, 2022-08-08:
do we want to change random things, or seek some stability in the world?

rusefillc, 2022-08-08:
@mck1117 please reduce noise.

if are looking for a clarification on reasons beyond what should already be available to you and obvious please just ask explicitly.

rusefillc, 2022-10-12:
@Nadezhda-n можешь попробовать?

rusefillc, 2022-10-17:
See also https://github.com/andreika-git/hellen-one/issues/189

rusefillc, 2022-10-24:
@Nadezhda-n получается первый шаг - это к kicad схеме WBO добавить AD схему CAN?

Nadezhda-n, 2022-10-25:
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
We need to add CANL, CANH, CANVIO on the module

Nadezhda-n, 2022-10-27:
ok
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

Closed 2022-12-27.

Thread 177 (2022-08-06):

double-sided version of output module

rusefillc, 2022-08-06:
problem statement: fit more stuff by using double-sided assembly

would output module be most space reduction with least effort by going double sided?

rusefillc, 2022-08-24:
@Ringenium is working on this

Thread 179 (2022-09-01):

JLC has touched outputs a bit

rusefillc, 2022-09-01:
JLC has moved a few parts on the outputs module maybe gaps are too tight maybe they see alternative placement as a safer option?

I think it's worth checking at https://github.com/rusefi/hellen154hyundai/tree/main/boards/hellen154hyundai-c.fab/board "before" / "after" images

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

Thread 180 (2022-09-01):

placement file generator should fail instead of producing invalid file

rusefillc, 2022-09-01:
https://github.com/rusefi/hellen-gm-e67/ rev B board is invalid because of https://github.com/rusefi/hellen-gm-e67/issues/81

Current behavior: hellen framework has successfully generated a partial placement file https://github.com/rusefi/hellen-gm-e67/blob/main/boards/hellen-gm-e67-b.fab/board/hellen-gm-e67-b-CPL.csv - all the components below R54 in BOM are missing in placement file :(

Expected behavior: hellen framework should fail to generate board when PCB has components not present in schematics

rusefillc, 2022-09-02:
Let's test on e67

so test of this #180 depends on #181

andreika-git, 2022-09-10:
Now the board files won't be created if any of the designators are absent.
Also added an error message:

"Error! Designator XXX was not found in the BOM file!
Error: Process completed with exit code 2."

rusefillc, 2022-10-23:
Not sure if related but still some issues on E67 https://github.com/andreika-git/hellen-one/issues/191

Closed 2022-09-10.

Thread 182 (2022-09-07):

Analog Switch $

rusefillc, 2022-09-07:
2chan order
C87403
NC7SB3157P6X

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

rusefillc, 2022-09-07:
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

rusefillc, 2022-09-07:
oh https://github.com/rusefi/alphax-4chan/issues/28

rusefillc, 2022-09-07:
Sounds like C213161 is much cheaper

Closed 2022-09-07.

Thread 183 (2022-09-07):

DC-DC cost reduction

rusefillc, 2022-09-07:
At the moment we use extended part C187824 for $2 that's the 5th most expensive components on some boards (well, it's also only $2 with one per board so low priority)
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

Would basic TPS54331DR C9865 https://jlcpcb.com/partdetail/TexasInstruments-TPS54331DR/C9865 $0.3 get the job done or is it inferior in any way we care about?

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

Thread 185 (2022-10-11):

Супермодуль

Qwerty-OFF, 2022-10-11:
Что сложить в супермодуль:
- mcu
- input  (и светодиоды индицирующие состояния входов?)
- ignition (и его светодиоды?)
- can
- sd наверно тоже всегда должен быть?
- засунуть туда же барометр и акселерометр?
- кнопки boot и reset чтобы больше не помнить о том, что их нужно ставить
- может быть еще и dinpu4, если вдруг покажется что у нас есть много места

Посмотрел на мультиплексирование аналоговых входов в 8chan, это уже обдуманное решение что нужно три мультиплексора 2:1? В природе существуют другие варианты, в том числе когда сразу несколько мультиплексоров в одной микросхеме чуть-чуть экономят место.

По поводу формы, размещения падов модуля и всего такого:
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
1, 2. - пады от модулей input и ign должны быть со стороны основного разъема
3. CAN и возможно SD въезжают внутрь супермодуля, почти все hellen платы скомпонованы как на этой картинке, соответственно высоту супермодуля можно увеличивать вплоть до суммы высот input + mcu + sd. За счет двухстороннего монтажа должно получиться сэкономить высоту. В 2chan и 4chan по высоте сейчас влезет только супермодуль размером input + mcu.
4. Пады которые предназначаются для модуля output можно сдвинуть немного ниже, чтобы соединяющие линии шли горизонтально, а не по диагонали как на картинке.
5. Все прочие пады вынести в сторону правого нижнего угла (stlink, "лишние" ноги для прототипирования, шины spi и i2c), либо верхнего правого угла (горстку ног для подключения ETB, USB, может еще что-то). Нижнюю сторону хочется освободить от падов вообще, чтобы смело размещать под ней всякие вещи типа зоны прототипирования, WBO и т.п.
В общем и целом расстановка на платах hellen выглядит так, что у нас мало места по вертикали и чуть больше по горизонтали, т.е. приоритетно уменьшать сначала высоту, а потом ширину.
Само собой это просто хотелки, а не требования, надо смотреть насколько грустно будет делать трассировку.

Другие идеи не касающиеся непосредственно супермодуля:
- объединить Power12, Power5 и TLS115 в одном модуле, кажется по одиночке они нигде не встречаются;
- двухсторонний output, в котором пады будут расположены чуть более удобно (сейчас часть падов предназначенных для основного разъема смотрит в сторону mcu)
- подумать о желании сделать двухсторонние WBO+CAN, VR-discrete, knock, что-нибудь еще

rusefillc, 2022-10-12:
* Внешний st-link в реальности не использовался ни разу вообще, TC2030 в кризисной ситуации хватит

* двухсторонние WBO+CAN
* VR-discrete
* knock

точно хочется и видимо стоит начинать просить Надю попробовать

Qwerty-OFF, 2022-10-12:
Кстати, можно компоненты размера 0603 менять на 0402 в тех местах где их точно никто и никогда не трогает паяльником вручную.

rusefillc, 2022-11-11:
Новая версия списка

* mcu
* aux mux
* input без светодиодов
* can
* sd
* кнопка boot точно
* dinpu4, в котороый нужно добавить https://github.com/andreika-git/hellen-one/issues/193 и тестовые площадки
* тестовые площадки?

* кнопка reset под вопростом
* барометр и акселерометр точно нет
* ignition всё-таки нет

rusefillc, 2022-11-14:
@Qwerty-OFF точно без VR и точно без защиты от высокого напряжение

rusefillc, 2022-11-26:
Secret preview

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

rusefillc, 2023-02-09:
@qwerty-off time to close?

Closed 2023-05-05.

Thread 187 (2022-10-12):

Double-sided hellen1-vr-discrete

rusefillc, 2022-10-12:
Take https://github.com/andreika-git/hellen-one/tree/master/kicad/modules/hellen1-vr-discrete module style

re-trace as 4 layer double sided assembly rectangle

create matching footprint

rusefillc, 2022-10-18:
@mck1117 if you are available to have a look https://github.com/Nadezhda-n/hellen-one/tree/master/kicad/modules/hellen1-vr-discrete

rusefillc, 2022-10-18:
@Qwerty-OFF says

Двухсторонние модули будут четырехслойные, один из внутренних слоев нужно полностью залить землей и не использовать под другую трассировку. Пусть это будет первый внутренний слой. Второй внутренний слой тоже залить землей, при желании можно убрать туда часть трассировки (например питание +5 и vref) если это позволит уменьшить габариты модуля или сделать лучше и красивее. В модулях мы максимально боремся за уменьшение размеров, чтоб потом счастливо ими пользоваться.

Можно заглянуть сюда https://jlcpcb.com/capabilities/pcb-capabilities и увидеть там что можно использовать отверстия 0.2/0.45, проводники 0.1, может быть еще что-то полезное. Злоупотреблять таким хождением по краю не надо, но там где это полезно стоит пользоваться.

Светодиод D751 отправить на верхнюю сторону.

У входных цепей VR- и VR+ нужно сделать зазор 0.4мм до всего вокруг

0.4mm around VR lines is about 100ish Volts on these line in theory

rusefillc, 2022-10-18:
Еще надо постараться поставить конденсаторы по питанию рядом с теми микросхемами с которыми они нарисованы на схеме

Closed 2022-12-17.

Thread 189 (2022-10-17):

WBO two modules to reuse voltage reference REF3033

rusefillc, 2022-10-17:
C130016 is one of the most expensive chips, when we have dual WBO can we share one REF3033 for two modules?

rusefillc, 2022-10-17:
@mck1117 opinions?

mck1117, 2022-10-17:
Sure, break out the vref pin to the module outside, tie them together, and omit all but one module's REF3x33.  BTW, REF3333 will also work in place of REF3033.

rusefillc, 2022-12-09:
@Qwerty-OFF @Nadezhda-n I assume we have not done that yet? Is this a quick change to make to include into 8chan?

With MegaModule only MM would have REF while all WBO would not have REF.

Nadezhda-n, 2022-12-09:
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

Closed 2022-12-09.

Thread 191 (2022-10-23):

ibom issue with GM-E67

rusefillc, 2022-10-23:
hellen-gm-e67-c-ibom.html does not handle R65 as expected

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

rusefillc, 2022-11-02:
@andreika-git at the moment we read packages from static folder in hellen-one

maybe smaller effort change: can you please hard-code a couple of more well-known folders like most usual kicad6 library or private libabry?

maybe better change: can you please allow adding package folders via replacement configuration file similar to how we include  board ID file dynamically?

Thread 192 (2022-11-02):

ibom nissan

rusefillc, 2022-11-02:
https://rusefi.com/docs/ibom/hellen121nissan-d-ibom.html

rusefillc, 2022-11-02:
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

rusefillc, 2022-11-02:
compare with much less broken https://rusefi.com/docs/ibom/hellen154hyundai-c-ibom.html

rusefillc, 2022-11-02:
@Qwerty-OFF

```
* Reading ./ibom-data/BATTERY-2032.kicad_mod
* Reading ./ibom-data/C0805.kicad_mod
* Reading ./ibom-data/C0603.kicad_mod
* Reading ./ibom-data/SOD-323.kicad_mod
* Reading ./ibom-data/LED-0603.kicad_mod
* Reading ./ibom-data/LED-0805.kicad_mod
* Reading ./ibom-data/SOD-123.kicad_mod
* Reading ./ibom-data/PAD-1206-PAD.kicad_mod
* Reading ./ibom-data/Off_Road_Disclaimer.kicad_mod
* Error! Footprint NOT FOUND! Skipping G1
* Reading ./ibom-data/LOGO.kicad_mod
* Error! Footprint NOT FOUND! Skipping G2
* Reading ./ibom-data/LOGO.kicad_mod
* Error! Footprint NOT FOUND! Skipping G3
* Reading ./ibom-data/PROTO_AREA.kicad_mod
* Error! Footprint NOT FOUND! Skipping G4
* Reading ./ibom-data/PROTO_AREA.kicad_mod
* Error! Footprint NOT FOUND! Skipping G5
* Reading ./ibom-data/PROTO_AREA.kicad_mod
* Error! Footprint NOT FOUND! Skipping G6
* Reading ./ibom-data/PROTO_AREA.kicad_mod
* Error! Footprint NOT FOUND! Skipping G7
* Reading ./ibom-data/PROTO_AREA.kicad_mod
* Error! Footprint NOT FOUND! Skipping G8
* Reading ./ibom-data/Jack_3.5mm_PJ-3250-5A.kicad_mod
* Reading ./ibom-data/PinHeader_1x04_P2.54mm_Vertical.kicad_mod
* Error! Footprint NOT FOUND! Skipping J7
* Reading ./ibom-data/PinHeader_1x04_P2.54mm_Vertical.kicad_mod
* Error! Footprint NOT FOUND! Skipping J8
* Reading ./ibom-data/Molex_SPOX_5267-05A_1x05_P2.50mm_Vertical.kicad_mod
* Error! Footprint NOT FOUND! Skipping J9
* Reading ./ibom-data/PinHeader_1x06_P2.54mm_Vertical.kicad_mod
* Reading ./ibom-data/XH-8A_SMD.kicad_mod
* Error! Footprint NOT FOUND! Skipping J16
* Reading ./ibom-data/XH-8A_SMD.kicad_mod
* Error! Footprint NOT FOUND! Skipping J18
* Reading ./ibom-data/USB_B_OST_USB-B1HSxx_Horizontal.kicad_mod
* Error! Footprint NOT FOUND! Skipping J20
* Reading ./ibom-data/Molex_Mini-Fit_Jr_5566-12A_2x06_P4.20mm_Vertical.kicad_mod
* Error! Footprint NOT FOUND! Skipping J21
* Reading ./ibom-data/368255-2.kicad_mod
* Error! Footprint NOT FOUND! Skipping P1
* Reading ./ibom-data/PAD-TH.kicad_mod
* Reading ./ibom-data/SOT-23.kicad_mod
* Reading ./ibom-data/DPAK.kicad_mod
* Reading ./ibom-data/PAD-0805-PAD.kicad_mod
* Reading ./ibom-data/R0603-4.kicad_mod
* Reading ./ibom-data/R0603.kicad_mod
* Reading ./ibom-data/SMD-2_2.9x3.9x1.7.kicad_mod
* Reading ./ibom-data/SO20POWER.kicad_mod
* Reading ./ibom-data/SO8.kicad_mod
* Reading ./ibom-data/LGA-12_2x2mm_P0.5mm.kicad_mod
* Error! Footprint NOT FOUND! Skipping U3
* Reading ./ibom-data/HLGA-10L.kicad_mod
* Error! Footprint NOT FOUND! Skipping U4
* Reading ./ibom-data/TSON-10.kicad_mod
* Error! Footprint NOT FOUND! Skipping U6
* Reading ./ibom-data/C1206.kicad_mod
* Reading ./ibom-data/SOT23-5.kicad_mod
* Reading ./ibom-data/SMC.kicad_mod
* Reading ./ibom-data/F1206.kicad_mod
* Error! Footprint NOT FOUND! Skipping F410
* Reading ./ibom-data/SMA.kicad_mod
* Reading ./ibom-data/L1210.kicad_mod
* Reading ./ibom-data/SOP8.kicad_mod
* Reading ./ibom-data/SMB.kicad_mod
* Reading ./ibom-data/MWSA0503.kicad_mod
* Reading ./ibom-data/SOT23-6.kicad_mod
* Reading ./ibom-data/R0805.kicad_mod
* Reading ./ibom-data/F1206.kicad_mod
* Error! Footprint NOT FOUND! Skipping F300
* Reading ./ibom-data/SOIC16.kicad_mod
* Reading ./ibom-data/SOT-223.kicad_mod
* Reading ./ibom-data/TSSOP24.kicad_mod
* Reading ./ibom-data/SMD1206.kicad_mod
* Reading ./ibom-data/SMD2012.kicad_mod
* Reading ./ibom-data/TSSOP14.kicad_mod
* Reading ./ibom-data/SMD5032.kicad_mod
* Reading ./ibom-data/LQFP144.kicad_mod
* Reading ./ibom-data/SDAMB-012.kicad_mod
* Reading ./ibom-data/HDR2x5-F-TH-SMD.kicad_mod
* Error! Footprint NOT FOUND! Skipping P480
* Reading ./ibom-data/C0402.kicad_mod
* Reading ./ibom-data/R0402.kicad_mod
* Reading ./ibom-data/TSOT23-5.kicad_mod
* Reading ./ibom-data/LQFP32.kicad_mod
* Reading ./ibom-data/SOT-23-3.kicad_mod
* Error! Footprint NOT FOUND! Skipping U603
* Reading ./ibom-data/SOT-23-3.kicad_mod
* Error! Footprint NOT FOUND! Skipping U603_2
* Skipping DNP component: DISCLAIMER
* Skipping DNP component: LOGO
* Skipping DNP component: LOGO
* Skipping DNP component: PROTO_AREA
* Skipping DNP component: PROTO_AREA
* Skipping DNP component: PROTO_AREA
* Skipping DNP component: PROTO_AREA
* Skipping DNP component: PROTO_AREA
* Skipping DNP component: Conn_01x01
* Skipping DNP component: Conn_01x01
* Skipping DNP component: Conn_01x01
* Skipping DNP component: Conn_01x01
* Skipping DNP component: Conn_01x01
* Skipping DNP component: Conn_01x04
* Skipping DNP component: Conn_01x04
* Skipping DNP component: Conn_01x05_Male
```

Thread 194 (2022-11-03):

WBO STM32 GPIO for GND routing

Qwerty-OFF, 2022-11-03:
@mck1117
We connected two unused GPIO pins (PF0, PF1) to ground to improve the routing.
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

mck1117, 2022-11-03:
Looks OK to me. Those pins are already configured to be floating by the software.

rusefillc, 2022-11-03:
@Qwerty-OFF let's add a comment on the schematic clarifying why GND

Qwerty-OFF, 2022-11-10:
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

Closed 2022-11-10.

Thread 197 (2022-11-11):

Merge Power12, Power5 и TLS115

rusefillc, 2022-11-11:
TLS115 minor drama:

please use PG-DSO-8 version of TLS115

rusefillc, 2022-11-16:
@Nadezhda-n let's actually ask @Qwerty-OFF to take care of the  PG-DSO-8 version of TLS115 part since that's not a module

rusefillc, 2022-11-16:
https://github.com/rusefi/alphax-4chan кажется использует обе версии? у нас фокус на PG-DSO-8

Closed 2022-12-17.

Thread 198 (2022-11-12):

R132 is tricky let's persist knowledge

rusefillc, 2022-11-12:
@andreika-git
Он для более правильного делителя напряжения, чтобы центральный уровень (2.5В) после делителя был на уровне центра

Есть это CRANK "сырой" VR, то тогда это важно. А если это выход с модуля vr-discrete, то тогда всё равно

Резистор хорош именно там где сейчас, потому что у нас есть программный детектор VR-сигнала, который и аналоговый, и цифровой (переключается)

Qwerty-OFF, 2022-11-12:
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

Closed 2022-11-12.

Thread 200 (2022-11-20):

Megamodule: SENT considerations around MCU

rusefillc, 2022-11-20:
https://en.wikipedia.org/wiki/SENT_(protocol) is the future, while it's pretty far Hellen should definitely support at least one input maybe two

on the software side at the moment we use STM32 ICU (input capture unit) of TIMER, ChibiOS limitation is that we can only use channels 1 and 2

At the moment the only proven hardware combination is MRE with C54 removed see https://github.com/rusefi/rusefi/tree/master/firmware/hw_layer/drivers/sent

rusefillc, 2022-11-20:
@dron0gus FYI

https://github.com/rusefi/rusefi/pull/4270

rusefillc, 2022-11-20:
following pins where channel is 0 or 1 are best candidates. Not sure why A5 is not on the list but this list is probably mostly correct

```
static expected<stm32_pwm_config> getConfigForPin(brain_pin_e pin) {
	switch (pin) {
#if STM32_PWM_USE_TIM1
	case Gpio::A8:  return stm32_pwm_config{&PWMD1, /*channel*/0, /*AF*/1};
	case Gpio::A9:  return stm32_pwm_config{&PWMD1, /*channel*/1, /*AF*/1};
	case Gpio::A10: return stm32_pwm_config{&PWMD1, 2, 1};
	case Gpio::A11: return stm32_pwm_config{&PWMD1, 3, 1};

	case Gpio::E9:  return stm32_pwm_config{&PWMD1, 0, 1};
	case Gpio::E11: return stm32_pwm_config{&PWMD1, 1, 1};
	case Gpio::E13: return stm32_pwm_config{&PWMD1, 2, 1};
	case Gpio::E14: return stm32_pwm_config{&PWMD1, 3, 1};
#endif
#if STM32_PWM_USE_TIM2
	case Gpio::A15: return stm32_pwm_config{&PWMD2, 0, 1};
	case Gpio::B3:  return stm32_pwm_config{&PWMD2, 1, 1};
	case Gpio::B10: return stm32_pwm_config{&PWMD2, 2, 1};
	case Gpio::B11: return stm32_pwm_config{&PWMD2, 3, 1};
#endif
#if STM32_PWM_USE_TIM3
	case Gpio::B4:  return stm32_pwm_config{&PWMD3, 0, 2};
	case Gpio::B5:  return stm32_pwm_config{&PWMD3, 1, 2};

	case Gpio::C6:  return stm32_pwm_config{&PWMD3, 0, 2};
	case Gpio::C7:  return stm32_pwm_config{&PWMD3, 1, 2};
#endif
#if STM32_PWM_USE_TIM4
	case Gpio::B6:  return stm32_pwm_config{&PWMD4, 0, 2};
	case Gpio::B7:  return stm32_pwm_config{&PWMD4, 1, 2};
	case Gpio::B8:  return stm32_pwm_config{&PWMD4, 2, 2};
	case Gpio::B9:  return stm32_pwm_config{&PWMD4, 3, 2};

	case Gpio::D12: return stm32_pwm_config{&PWMD4, 0, 2};
	case Gpio::D13: return stm32_pwm_config{&PWMD4, 1, 2};
	case Gpio::D14: return stm32_pwm_config{&PWMD4, 2, 2};
	case Gpio::D15: return stm32_pwm_config{&PWMD4, 3, 2};
#endif
#if STM32_PWM_USE_TIM5
	case Gpio::A0:  return stm32_pwm_config{&PWMD5, 0, 2};
	case Gpio::A1:  return stm32_pwm_config{&PWMD5, 1, 2};
	case Gpio::A2:  return stm32_pwm_config{&PWMD5, 2, 2};
	case Gpio::A3:  return stm32_pwm_config{&PWMD5, 3, 2};
#endif
#if STM32_PWM_USE_TIM8

#if !STM32_PWM_USE_TIM3
	// If TIM3 is not used, put these pins on TIM8 instead..
	// See https://github.com/rusefi/rusefi/issues/639
	// See https://github.com/rusefi/rusefi/pull/3032
	case Gpio::C6:  return stm32_pwm_config{&PWMD8, 0, 3};
	case Gpio::C7:  return stm32_pwm_config{&PWMD8, 1, 3};
#endif

	case Gpio::C8:  return stm32_pwm_config{&PWMD8, 2, 3};
	case Gpio::C9:  return stm32_pwm_config{&PWMD8, 3, 3};
#endif
#if STM32_PWM_USE_TIM9
	case Gpio::E5:  return stm32_pwm_config{&PWMD9, 0, 3};
	case Gpio::E6:  return stm32_pwm_config{&PWMD9, 1, 3};
#endif
	default: return unexpected;
	}
};
```

Qwerty-OFF, 2022-11-20:
Supported inputs:
AUX2
AUX4
O2S
O2S2
Supported outputs:
OUT_IO2
OUT_IO12
OUT_PWM1
OUT_PWM2
OUT_PWM3
OUT_PWM8
Other supported IO:
SPI3_CS

rusefillc, 2022-11-20:
Let's only mark on the symbol to see which ones are ICU, looks like we have options for later

Thread 207 (2022-12-03):

mcz33810 module

rusefillc, 2022-12-03:
Definitely no IGBT on-board, maybe provisions for external?

rusefillc, 2022-12-03:
@dron0gus my KIT33810EKEVME order from 10 days ago is in a very unclear state :(

@dron0gus can you cut relevant portion of your PDF to give @Nadezhda-n a head start?

See also https://github.com/rusefi/rusefi-hardware/tree/main/quad-igbt

dron0gus, 2022-12-04:
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

rusefillc, 2022-12-05:
@dron0gus Question on C5 see https://github.com/rusefi/rusefi-hardware/issues/159#issuecomment-1336579958

rusefillc, 2023-02-02:
Depends on https://github.com/rusefi/kicad6-libraries/issues/9

rusefillc, 2023-02-09:
Oh this one is used by https://github.com/mck1117/atlas

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

rusefillc, 2023-11-16:
depends on https://github.com/rusefi/rusefi-hardware/issues/255

Thread 209 (2022-12-05):

CPL format check

rusefillc, 2022-12-05:
At the moment we fail to handle the following CPL file https://github.com/andreika-git/hellen-one/blob/master/modules/vr-discrete/0.2/vr-discrete-CPL.csv

```
Designator,Val,Package,Mid X,Mid Y,Rotation,Side
C752,470n,C_0402_1005Metric,-13.750000,4.850000,180.000000,bottom
C753,100n,C_0402_1005Metric,-13.725000,2.925000,0.000000,bottom
C755,1u,C_0402_1005Metric,-11.725000,8.050000,0.000000,bottom
```

with
```
3 parts processed...
4 parts processed...
  ** Inserting Module:vr-discrete/0.2 into M8...
  ** adding vr-discrete_2/0.2 on Top, coords: 0.2905511811023622", 2.977952755905512" (7.38 mm, 75.64 mm)
* appending the CPL with offset (7.38,75.64)...
Traceback (most recent call last):
  File "bin/process_board.py", line 321, in <module>
    append_cpl(module_path + "/" + module_name + "-CPL.csv", board_cpl, x, y, rot, isBottom, module_suffix)
  File "bin/process_board.py", line 126, in append_cpl
    cx = float(cxmm.replace("mm", ""))
ValueError: could not convert string to float: '470n'
ABORTING!
Error: Process completed with exit code 3.
```

question: should we fail with a message "Val column not supported" or "Please have exactly columns X, Y, Z" or shall we simply handle this CPL?

rusefillc, 2022-12-05:
@Nadezhda-n please match https://github.com/andreika-git/hellen-one/blob/master/modules/vr-discrete/0.1/vr-discrete-CPL.csv

rusefillc, 2022-12-06:
Looks great!

``Error! Wrong format of CPL file modules/vr-discrete/0.2/vr-discrete-CPL.csv``

Thread 224 (2022-12-07):

vr discrete .wrl file

rusefillc, 2022-12-07:
https://github.com/andreika-git/hellen-one/tree/master/kicad/modules/hellen1-vr-discrete/gerber has new wrl under one name

https://github.com/andreika-git/hellen-one/tree/master/modules/vr-discrete/0.2 does not have new file but has old file with a different name

do we have one or two issues here?

Thread 229 (2022-12-07):

2chan job did not fail but no PNG

rusefillc, 2022-12-07:
```
* Skipping DNP component: Conn_01x01
* Skipping DNP component: Conn_01x01
* Skipping DNP component: Conn_01x01
* Skipping DNP component: 33311-24AW-2
* Skipping DNP component: JDY-33
* Compressing the data...
* Adding the pcb image...
* Adding the BOM data...
* Writing the output BOM file...
Done!
Cleaning up...
Creating a zip-archive with gerbers...
Board processing done!
All done!
```

https://github.com/rusefi/alphax-2chan/actions/runs/3643069574/jobs/6150887711

https://github.com/rusefi/alphax-2chan/tree/main/boards/alphax_2ch-e/board

rusefillc, 2022-12-09:
not an issue, looks like the file did in fact just not change

Closed 2022-12-09.

Thread 233 (2022-12-10):

three pad jumper

rusefillc, 2022-12-10:
We have a footprint for 0R resistor and two holes for wires

We have multiple cases where only one of two fuses or only one of two 0R jumpers could be populated

Can we have a three pad reusable component for those cases?

three pads in line would probably not be useful since usually alternative sources are on same side and shared output is on the other side

shall we do 90 degrees angles three pads?

rusefillc, 2022-12-10:
https://github.com/rusefi/rusefi/wiki/Hellen121VAG#vehicle-specific-jumpers is a typical example

rusefillc, 2022-12-10:
problem statement:

* space usage
* safety - making sure only one connection is happening not both

Thread 237 (2022-12-13):

WBO-0.4

Qwerty-OFF, 2022-12-13:
@Nadezhda-n
Сборка 8chan сломалась из-за R620 в wbo-0.4
`* Error! Comment mismatch for the part #C17168: 0 != DNP`
Поломка происходит когда в проекте есть компоненты с одинаковым LCSC кодом и разным поле Value.

Переходное отверстие земли попадает на дорожку WBO- при слиянии герберов, нужно исправить:
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

rusefillc, 2022-12-15:
Fixed by https://github.com/andreika-git/hellen-one/pull/239

Closed 2022-12-15.

Thread 238 (2022-12-13):

VR-discrete 0.2 Gerber edge

Qwerty-OFF, 2022-12-13:
@Nadezhda-n В герберах непонятный прямоугольник вокруг модуля
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

rusefillc, 2022-12-15:
https://github.com/andreika-git/hellen-one/pull/242

rusefillc, 2022-12-15:
> Получается, что это лишнее

спасибо сделал https://github.com/andreika-git/hellen-one/issues/243

Closed 2022-12-15.

Thread 240 (2022-12-14):

SDIO not SPI SD card for mm-0.2

rusefillc, 2022-12-14:
@Qwerty-OFF how much pin conflict would be get if we switch SD card from SPI interface to SDIO interface?

Sample board with SDIO see https://rusefi.com/forum/download/file.php?id=4174

Qwerty-OFF, 2022-12-15:
Сломается:

- OUT_IO5 идущий на output, его сможем заменить свободным IO-выводом,
- также придется использовать SPI3_MOSI что лишит нас всего SPI3
- OUT_PWM5, возможно можно починить так как от SPI3 освободится нога с TIM2_CH1 если его можно использовать

Если использовать 4х-битный SDIO потратится еще:

- пара ног от SPI3
- OUT_PWM4, свободных аппаратных PWM для его замены не нашел

Thread 243 (2022-12-15):

Root cause of VR-discrete 0.2 Gerber edge maybe documentation issue?

rusefillc, 2022-12-15:
See https://github.com/andreika-git/hellen-one/issues/238#issuecomment-1353523007

Nadezhda-n, 2022-12-15:
Полагаю, что для модулей это не нужно, но, на самом деле, не понимаю, зачем это нужно для любых других плат :)
А так, да "Root cause of VR-discrete 0.2 Gerber edge maybe documentation issue?" - прямоугольник на всех герберах и есть край модуля, на пред версии, как и в других платах, его нет :)

Qwerty-OFF, 2022-12-15:
Кикад когда-то переименовал эту галочку с "не рисовать край платы на всех слоях" на "рисовать край платы на всех слоях". Видимо из-за этого возникла путаница. В руководстве по сути все правильно, но не соответствует свежему кикаду.
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

Nadezhda-n, 2022-12-16:
> Кикад когда-то переименовал эту галочку с "не рисовать край платы на всех слоях" на "рисовать край платы на всех слоях". Видимо из-за этого возникла путаница. В руководстве по сути все правильно, но не соответствует свежему кикаду. 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

Ха-ха
Спасибо :)

Closed 2022-12-17.

Thread 244 (2022-12-15):

Explicit error in case of duplicated designator

rusefillc, 2022-12-15:
Hellen-one automation should fail if for instance two R100 are present between frame and modules

Thread 245 (2023-01-03):

VR discrete issues

mck1117, 2023-01-03:
https://github.com/rusefi/rusefi/issues/4874
https://github.com/rusefi/rusefi/issues/4922
and maybe https://github.com/rusefi/alphax-4chan/issues/84

Seems that TLV3202 instead of MAX9142 has slightly different behavior, and is susceptible to oscillation on the falling edge that can cause an early falling edge.

In bench testing, adding a 10nF capacitor across pins 4-5 (pin 5 to ground) solves the issue, but further testing required.  @ElDominio is going to try it on his real engines that have this issue.

mck1117, 2023-01-03:
The bodge I did on the bench:
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

ElDominio, 2023-01-05:
Would I not have to put on at pin3 too? Since I see we're putting a cap across 2IN+ and GND, wouldn't one be needed between 1IN+ and GND too? just for my info

rusefillc, 2023-01-05:
@Qwerty-OFF can you help with ^^^?

ElDominio, 2023-01-05:
Yaris with 10nf cap across 4 and 5 still has issues

ElDominio, 2023-01-05:
[changingtocamactivewithinvertyaaris.zip](https://github.com/andreika-git/hellen-one/files/10355843/changingtocamactivewithinvertyaaris.zip)

I changed from not using cam to using cam

rusefillc, 2023-01-05:
@ElDominio please clarify

"VR discrete issue" not resolved
or
"VR discrete issue" impossible to test because of CAM issue
or
"VR discrete issue" resolved, now separate issue?

mck1117, 2023-01-05:
he forgot to add a second cap to the cam channel, and is going to test on a rev E so he can get an SD log

ElDominio, 2023-01-06:
Yaris
RevE with 10nF capacitors on TLV3202

[OsciLogandNormalLogwithcapsRevE.zip](https://github.com/andreika-git/hellen-one/files/10356445/OsciLogandNormalLogwithcapsRevE.zip)
[re_15.zip](https://github.com/andreika-git/hellen-one/files/10356446/re_15.zip)

ElDominio, 2023-01-06:
![Uploading q4{840dbaa} (dc2579a1-796f-45ee-a709-273b7efd75f1 id=0x7f0a0401 tag=BaseCommentFragment) …]()

mck1117, 2023-01-06:
Cap seems to have made an improvement to crank signal:

before on left, after on right

Left has very not-50% duty cycle, falling edge comes very soon after rising edge. Right has near 50/50 duty, which is expected for VR signal with many teeth (like a 36-2 crank)

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

rusefillc, 2023-01-06:
https://github.com/andreika-git/hellen-one/issues/247 for actual change

let's start by improving newer 2 sided version? we might end up making improved one sided version as well I guess

ElDominio, 2023-01-22:
We might need another cap according to @mck1117 , @rusefillc . Pending testing

mck1117, 2023-01-22:
> We might need another cap according to @mck1117 , @rusefillc . Pending testing

the updated schematic has both caps, like the original little test board I did

Closed 2023-01-22.

Thread 246 (2023-01-05):

power_12and5V/0.1 blue LEDS are too bright

rusefillc, 2023-01-05:
All three blue LEDS are too bright

https://github.com/andreika-git/hellen-one/tree/master/modules/power_12and5V/0.1

can we please drop current by 50% with a replacement file to begin with on whatever board we fabricate next?

Closed 2023-01-18.

Thread 247 (2023-01-06):

vr-discrete 0.4: Add 10nF between GND and 2IN+

rusefillc, 2023-01-06:
Please take vr-discrete)/0.4 add one capacitor and make that vr-discrete)/0.3 (yes, we are skipping 0.3 for now we might use 0.3 for same fix for single sided design later)

See #245 for details, we need one capacitor added to schematics and gerbers

rusefillc, 2023-01-06:
@Nadezhda-n can you take care of this?

mck1117, 2023-01-06:
I am not yet 100% sure that’s the only change required to fix issues. We can go ahead and draft the change, but don’t commit to that yet.

mck1117, 2023-01-07:
Go ahead and add a cap between pin 2 and ground (in addition to pin 5). I've never seen it happen on the top half, but it's theoretically susceptible to the same oscillation.

mck1117, 2023-01-07:
WAIT a second, those caps were already present on the original design, why did they disappear on the hellen module!?!?!

Little test board I made:

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

Hellen module:

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

notice C9/C10 are exactly what we need to add, but were already there

rusefillc, 2023-01-07:
hellen1-vr-discrete is one of the few kicad-based modules https://github.com/andreika-git/hellen-one/tree/master/kicad/modules

rusefillc, 2023-01-22:
@mck1117 please review and confirm if we can fab a batch of boards

mck1117, 2023-01-22:
0.4 schematic looks OK

Closed 2023-01-22.

Thread 248 (2023-01-07):

What's up with pattern of inverted ETB using TLE9201?

rusefillc, 2023-01-07:
See https://github.com/rusefi/hellen154hyundai/issues/65

Now looks like 8chan pos/neg is flipped over https://github.com/rusefi/rusefi/wiki/Vault-Of-Electronic-Throttle-Bodies-ETB pos/neg at least on Nissan ETB

rusefillc, 2023-01-07:
@mck1117 any chance you could have a look?

Thread 249 (2023-01-09):

Reflect substitutions in schematics

rusefillc, 2023-01-09:
mcu module says stm32h743zit while in reality we often assemble stm32f407zgt

Would be great for PDF to reflect actual part number not the original dream part number

Thread 250 (2023-01-10):

A8 intake runner position

rusefillc, 2023-01-10:
@Qwerty-OFF definitely please add a resistor

Tommy is that a switch or analog position? Do we even care for A8 input?

rusefillc, 2023-01-10:
sorry wrong repo

Closed 2023-01-10.

Thread 251 (2023-01-10):

Any chance to make WBO module less weird?

rusefillc, 2023-01-10:
4.9 heater wires are "heater+" and "12 raw" is not that a bit confusing?

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

Snippet of https://github.com/rusefi/rusefi_documentation/blob/master/Hardware/Hellen/hellen125honda-a-schematic.pdf

https://github.com/andreika-git/hellen-one/tree/master/modules/wbo/0.4

rusefillc, 2023-01-10:
@mck1117 @dron0gus any ideas for at least footprint comments to reduce confusion?

rusefillc, 2023-01-11:
Let's make a compatible wbo-0.4 change by adding kicad notes to the symbol:

"LSU_H-" add blue note "power GND"
"GND" add blue note "analog/digital"
"LSU_H+" add blue note "heater negative"

Qwerty-OFF, 2023-01-11:
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

Closed 2023-01-18.

Thread 254 (2023-02-01):

mm-0.2 vs mcu-0.7

rusefillc, 2023-02-01:
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
vs
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

we need to sync up and create the best of both worlds

rusefillc, 2023-02-01:
https://github.com/andreika-git/hellen-one/wiki/module-input is relevant

all three sources are missing on ADC3 usage

rusefillc, 2023-02-01:
@Qwerty-OFF please definitely add EXTI indices into mm-0.2 assuming no one has used mm-0.2 yet

@Qwerty-OFF please add small "adc3" note on relevant pins probably "RES"?

Thread 256 (2023-02-09):

Which way to output

rusefillc, 2023-02-09:
There are at least five paths with output module. Maybe with some integrated LEDs?

* dual side current module
* dual side VND10 would be a crazy option but technically an option
* #144 same package as Proteus there are at least five compatible part numbers
* mcz33810 #207 @dron0gus
* TLE9104 does it have diagnostics? this was the dream for https://github.com/mck1117/atlas @mck1117

rusefillc, 2023-03-26:
for TLE9104 we have https://github.com/mck1117/tle9104-breakout

rusefillc, 2023-10-31:
see also https://github.com/andreika-git/hellen-one/issues/332

Thread 257 (2023-02-11):

mm-0.2 let's dim 3.3v green led by 50+%

rusefillc, 2023-02-11:
Green LED is too bright

let's update BOM without generating new revision

Qwerty-OFF, 2023-02-15:
Done https://github.com/andreika-git/hellen-one/commit/832095bea0c7edab5b63eab13c20408b72367d12

Closed 2023-02-15.

Thread 258 (2023-02-11):

power12and5 let's dim 5v blue

rusefillc, 2023-02-11:
5v is _really_ bright let's dim by 75+%

12v is OK as is

let's update BOM without new revision

rusefillc, 2023-02-13:
Let's actually decide which single LED stays on the power12_5, do we ever have only one emitting light while the other one does not?

rusefillc, 2023-02-14:
PS: just realized that power12_5 has _four_ LEDs and I have three of these on?

Qwerty-OFF, 2023-02-15:
Fixed https://github.com/andreika-git/hellen-one/commit/9e7d30611dde93a8cf39684edd4c8146ee5485af

> PS: just realized that power12_5 has four LEDs and I have three of these on?

5VP disabled by PWR_EN

Thread 262 (2023-02-22):

Both mm boards have SD not working

rusefillc, 2023-02-22:
2chan has mm-01 I have one in NJ https://github.com/rusefi/alphax-2chan/issues/84
honda k has mm-02 I have a couple not yet burned in NJ https://github.com/rusefi/hellen125honda-issues/issues/28

rusefillc, 2023-02-24:
@Qwerty-OFF could the issue be about pull-ups? One level is different between working 4chan and non working 2 chan

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

rusefillc, 2023-02-24:
@Qwerty-OFF @andreika-git looks like it's CS pin which is different

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

rusefillc, 2023-02-24:
Time to hook logic analyzer to CS, MOSI and CSK

rusefillc, 2023-02-24:
4chan just to confirm that toolset works

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

rusefillc, 2023-02-24:
Nothing on 2chan
not a single wire shows expected stuff

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

rusefillc, 2023-02-26:
@dron0gus says https://github.com/rusefi/rusefi/issues/5134

@dron0gus says https://github.com/rusefi/ChibiOS/commit/fd3770d71d6b9dae6185ff7ad32746e88a0a8f1d

rusefillc, 2023-02-26:
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

rusefillc, 2023-02-26:
@timbelom please remove U1001 accelerometer

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

rusefillc, 2023-02-27:
4chan firmware on rusEFI brain board

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

rusefillc, 2023-02-27:
same board now 2chan
it's a software problem reproducible without real hardware

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

rusefillc, 2023-02-27:
update: oh damn I have progress

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

rusefillc, 2023-02-27:
```
2023-02-27_11_38_11_503: EngineState: MMC CS PB6
2023-02-27_11_38_11_504: EngineState: SD enabled=Yes status=MMC_CONNECT_FAILED
2023-02-27_11_38_11_505: EngineState: SD SPI_DEVICE_1 mosi=PB5
2023-02-27_11_38_11_506: EngineState: SD SPI_DEVICE_1 miso=PB4
2023-02-27_11_38_11_514: EngineState: SD SPI_DEVICE_1 sck=PB3
2023-02-27_11_38_11_514: EngineState: confirmation_sdinfo:6
```

rusefillc, 2023-02-27:
PROGRESS

have SD card working on a 2chan board with https://github.com/rusefi/rusefi/commit/326d8d98a424a7054b9c9f99b50ba31f39ce8441 and accelerometer removed

rusefillc, 2023-02-27:
it's a pile of issues is it?

https://github.com/rusefi/rusefi/issues/5136

rusefillc, 2023-02-27:
Fixed https://github.com/rusefi/rusefi/commit/74748f4897dba6b0ed9eac44c5adc91005d98ebb

Closed 2023-02-27.

Thread 266 (2023-02-27):

4chan ibom issues - VR not happy on PCB view

rusefillc, 2023-02-27:
https://rusefi.com/docs/ibom/alphax_4ch-f-ibom.html

two pictures are offset
R753_2 is shifted against both pictures

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

andreika-git, 2023-03-01:
Something wrong with VRML export of vrdiscrete-0.4. Maybe the origin coordinates were wrong. We need to re-export VRML with zero origin.

Closed 2023-04-03.

Thread 267 (2023-02-27):

power12_5 has VIGN led issue

rusefillc, 2023-02-27:
expected:
four LEDs are not annoyingly bright

actual result: VIGN led seems to be off or very very very very dim

Qwerty-OFF, 2023-02-27:
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

Thread 268 (2023-03-14):

Explicitly spell out low side driver large tab flexibility or lack of flexibility

rusefillc, 2023-03-14:
хочется чётко задокументировать на https://github.com/andreika-git/hellen-one/wiki/module-output, какие варианты мы поддерживаем

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

потому что например в наличии дешёвый ZXMS6005DGTA (мы ранее использовали ZXMS6005SGTA)

andreika-git, 2023-03-14:
Done

Closed 2023-03-14.

Thread 269 (2023-03-15):

A dream: split framework and rusEFI application

rusefillc, 2023-03-15:
https://github.com/andreika-git/hellen-one is an amazing tool which should not be so tightly coupled with rusEFI specific application it deserves to fly on it's own!

rusefillc, 2023-03-15:
@chuckwagoncomputing that's one of the things from the phone call

Thread 271 (2023-03-15):

Give unique URL to each specific BOM line

rusefillc, 2023-03-15:
See https://github.com/openscopeproject/InteractiveHtmlBom/issues/206 for problem statement

Somewhat related to https://github.com/andreika-git/hellen-one/issues/270

Thread 275 (2023-03-20):

Automation to catch board thickness issues

rusefillc, 2023-03-20:
Human error like #82 keeps happening

Is it cheap to add safeguard at least for kicad boards at least with kicad?

Thread 280 (2023-03-31):

DNP CAN terminator on WBO

rusefillc, 2023-03-31:
when do we _EVER_ need 120R on hellen-one WBO module?!

rusefillc, 2023-04-01:
@Nadezhda-n 120R between CANH and CANL please leave footprint but mark DNP so that BOM for module does not have it

rusefillc, 2023-04-08:
@Qwerty-OFF are we good to close?

Qwerty-OFF, 2023-04-08:
Yes

Closed 2023-04-08.

Thread 282 (2023-03-31):

backup kicad source while processing stuff

rusefillc, 2023-03-31:
we already have per-revision boards which is kind of replacing git/git tag

for usability can we please copy source kicad files into same export folder effectively making a shortcut for tagging?

open question if that's a great or horrible idea :)

Thread 285 (2023-04-03):

single wire VR/Hall solution

rusefillc, 2023-04-03:
* same wire should support both Hall and VR input
* VR negative wires should not be needed, signal GND crimped at ECU should be sufficient for VR negative

rusefillc, 2023-04-19:
source for inspiration or not https://speeduino.com/forum/viewtopic.php?t=4954?

rusefillc, 2023-05-20:
Random honda schematics from the 90s https://github.com/rusefi/rusefi_documentation/blob/master/OEM-Docs/Honda/bomarc-services-p28.pdf

Thread 287 (2023-04-03):

Full skip of BOM lines without JLC PN

rusefillc, 2023-04-03:
https://github.com/rusefi/hellen125honda-issues/issues/41 U2 is populates while
```
"BTS4175SGA","U2","SO8",""
```

looks like such lines should not be in BOM at all

rusefillc, 2023-04-03:
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

rusefillc, 2023-04-03:
could also be https://github.com/rusefi/hellen121vag/issues/79

andreika-git, 2023-04-05:
If we skip BOM lines without JLC PN, then iBOM will be missing these lines! If we really want it, then we need separate BOM files for JLC and iBOM (and an additional script to create the truncated file). If we want to leave the JLC BOM file name as is (eg. hellenxxx-x-BOM.csv), then we need to come up with a name for the 'compete' iBOM file. Any ideas?

rusefillc, 2023-04-05:
Great point!

Let's keep current file as is and have a script to produce new BOM-JLC file?

andreika-git, 2023-04-05:
OK, we'll create a new board/xxx-BOM-JLC.csv file and move the current file to board/misc/xxx-BOM.csv

andreika-git, 2023-04-06:
Done

Closed 2023-04-06.

Thread 288 (2023-04-04):

JLC does not like our back side placement

rusefillc, 2023-04-04:
looks like all 4chan and honda with two side assembly rear placement is always off

First thing first: is the issue on our end or JLC end?

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

rusefillc, 2023-04-04:
Actually looks like JLC issue since things are good on other JLC screens

Closed 2023-04-04.

Thread 289 (2023-04-15):

Do we need VR neg or could it be signal GND?

rusefillc, 2023-04-15:
What if we wire VR neg of https://github.com/andreika-git/hellen-one/tree/master/modules/vr-discrete to sensor GND? would that break anything?

the potential value is to reduce pin requirment

Thread 291 (2023-05-09):

double-sided version of ign module

rusefillc, 2023-05-09:
4chan rev G for instance uses two ign modules would it help to have those double-sided?

rusefillc, 2023-05-09:
Если будет очень нужно их можно собирать двухсторонними на плате из отдельных компонентов.

Как модуль точно нет, потому что пропадут зазря полезные внутренние слои.

Если мы когда-то перейдем на новые ключи, которым не нужно 5В для управления, эти модули тоже будут не нужны

Thread 292 (2023-05-10):

power module: Шелкография диодов

Qwerty-OFF, 2023-05-10:
например огромный D418 - нужно разобраться, как китацйы вообще допускают варинт его припаять наоборот.

* Сделать шелкографию понятную JLC
* отдельный вопрос что у нас в файлах ориентации, возможно нужно будет отдельно разбираться в JLC ориентации, чтоб они просто никогда ничего не крутили вообще. https://github.com/andreika-git/hellen-one/issues/294

Qwerty-OFF, 2023-07-30:
В power-модуле шелкографию диодов починил

Closed 2023-07-30.

Thread 293 (2023-05-11):

Try to warn if there are multiple parts with the same value and footprint but different PN#

andreika-git, 2023-05-11:
First, let's just warn about it, and then decide if we want to treat it as an error and abort...

andreika-git, 2023-05-18:
Done!

(See https://github.com/rusefi/alphax-4chan/issues/139 as an example)

Closed 2023-05-18.

Thread 294 (2023-05-11):

kicad vs jlcpcb orientation

rusefillc, 2023-05-11:
let's revisit orientation drama

rusefillc, 2023-05-11:
https://forum.kicad.info/t/is-there-a-simple-way-to-update-all-my-footprints-to-use-the-jlcpcb-orientations/38931

rusefillc, 2023-05-12:
most recent example: on 4chan rev G question was if D418 was placed right or not

Qwerty-OFF, 2023-05-16:
https://github.com/matthewlai/JLCKicadTools/tree/master уже живет внутри Hellen-one https://github.com/andreika-git/hellen-one/tree/master/bin/jlc_kicad_tools

У нас есть БД с поворотами для футпринтов, проблема в том что разные компоненты с одним и тем же футпринтом требуют разный поворот. Т.е. увидим ту же историю что здесь https://github.com/matthewlai/JLCKicadTools/issues/28

Нужно знать как компонент лежит в ленте, а значит такой словарик нужно вести не для футпринтов, а для LCSC-кодов компонетов

rusefillc, 2023-05-16:
внезапно! новая проблема https://github.com/andreika-git/hellen-one/issues/296

ну и пинганул товарищей в https://github.com/matthewlai/JLCKicadTools/issues/28

Qwerty-OFF, 2024-05-29:
Работает и выглядит очень полезным и нужным

Thread 295 (2023-05-16):

Mega-mcu144 (0.1-0.4): wrong partnumber for 10k resistor

andreika-git, 2023-05-16:
C11616 instead of C25744

https://github.com/andreika-git/hellen-one/commit/4b77ad9d21666b3cd91e542e3dc999dc61a85707

Qwerty-OFF, 2023-05-16:
Полный список подверженных резисторов:
* R124, R126, R132, R135, R136, R137, R138, R139, R228, R229, R230, R231, R232, R233, R234, R235, R246, R247, R248, R249, R250, R251, R252, R253 - это подтяжки в input. На конкретных платах они могли быть изменены на другие номиналы с помощью replace-механизма. В случае сомнений в работе какого-либо входа ММ нужно смотреть PN соответствующей подтяжки в БОМ на конкретную плату.
* R102 - не дающий подпитывать цепь питания USB от 5V малым током
* R103 - подтяжка SPI2, заменить на 10k при использовании SPI2
* R105 - подтяжка SPI2, заменить на 10k при использовании SPI2
* R108 - подтяжка в цепи управления переключаемыми 5В. Заменить если есть подозрение что напряжение не отключается или отключается долго
* R109 - подтяжка в цепи управления переключаемыми 3.3В. Заменить если есть подозрение что напряжение не отключается или отключается долго
* R121 - подтяжка nReset. Есть встроенная в контроллере, вероятно все безопасно
* R127 - подтяжка boot0. Если вдруг контроллер входит в режим программирования, заменить
* R128 - подтяжка boot1
* R141 - подтяжка линии PWR_EN. Менять если не выключаются все питания, в том числе TLS115 в спящем режиме (когда нога контроллера висит в воздухе)
* R142 - подтяжка линии управления мультиплексорами. Если при переходе из "1" в "High-Z" мультиплексор не переключается в каналы аналогичные "0"

Qwerty-OFF, 2023-10-02:
Исправлено в 0.5

Closed 2023-10-02.

Thread 298 (2023-05-21):

megamodule-64

rusefillc, 2023-05-21:
получится ли
* can wakeup/sleep
* single or dual CAN bus?
* one uart for one LIN
в целом по входам - порядка 2chan плюс-минус?

Qwerty-OFF, 2023-05-21:
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
1x SWD (если шить через UART и забыть про TC2030, еще +2 IO)
2x CAN
1x USB
1x I2C
2x SPI (один можем обменять на 3 IO)
1x UART (есть возможность добавить один или два ценой по 2 IO)
1x WAKEUP
14x ADC/IO
12x IO (7 EINT)

В 2chan:
22x OUT
6x IN
12x ADC (из них 4 AUX)

Количество аппаратных ШИМ не отслеживал

Вывод: 40 полезных ног в 2chan, порядка 26-29 незадействованных ног в MM-64.

rusefillc, 2023-05-21:
1x SWD with TC2030
1x WAKEUP
2x CAN
1x USB

1x SENT input
2x UART
2x PWM?
14x ADC/IO
12x IO (7 EINT)
2x SPI
1x I2C (baro пока оставляем, но точно уже не монтируем. accel пока оставляем, но точно уже не монтируем)

Qwerty-OFF, 2023-05-21:
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
1x SWD
1x WAKEUP
2x CAN
1x USB
1x SENT input/DIN
2x UART
5x PWM OUT (один из них использует тот же таймер что и SENT)
4x OUT
14x ADC/DIN
1x ADC VIGN (если надо, "бесплатно" превращается в полноценный ADC/DIN, так как наше количество каналов ОУ кратно четырем)
2x SPI
1x I2C

*Можно превратить
1x SENT input/DIN
1x ADC
в
1x SENT input/ADC
1x PWM OUT

Qwerty-OFF, 2023-06-02:
1. Что делать с Board_id? Две ноги как раньше на это тратить не получается. Могу поставить I2C расширитель GPIO, как где-то когда-то пробовали раньше. Его лишние ноги можем использовать для решения проблем 2, 3, 4.
2. Если оставляем в модуле акселерометр, он потребует один пин CS. Избавляюсь от акселерометра?
3. SD карту оставляем? Тоже один пин CS.
4. На отладочные четыре светодиода не хватает ног.

rusefillc, 2023-06-03:
2. акселерометр точно убираем
3. SD карту оставляем
4. два отладочных светодиода - синий и красный
1. в таком варианте ^^^ хочется оставить просто двухногий Board_id всё-таки

Qwerty-OFF, 2023-06-05:
@rusefillc картинка для оценки получившегося количества периферии, жду отмашку делать так или менять что-нибудь
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

rusefillc, 2023-06-05:
@Qwerty-OFF красота!

rusefillc, 2023-06-05:
@Qwerty-OFF красота. Давай продолжать!

Closed 2023-06-09.

Thread 299 (2023-05-21):

megamodule-100

rusefillc, 2023-05-21:
* нет требования совместимости с mm-144
* hard-wired can wakeup
* незначительный акцент на уменьшение размера и цены: например 32 аналоговых канала нам точно не надо, что-то отрезать. или отрезать NC7SB3157P6X или для начала опцию изготовления без низ перемычкой. или возможно я зря усложняю
* или сразу смотреть на megamodule-64 https://github.com/andreika-git/hellen-one/issues/298

Thread 300 (2023-06-11):

power_12and5V: self-documentation on schematics

rusefillc, 2023-06-11:
* does power_12and5V has a "reverse polarity protection" group of components? can we mark relevant functional area?
* does power_12and5V has a "input filtering" group of components? can we mark relevant functional area?

rusefillc, 2023-06-11:
если только прояснение на схеме - то ревизию можно оставить как есть?

Qwerty-OFF, 2023-06-11:
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
Ревизию не менял

Closed 2023-06-11.

Thread 301 (2023-06-14):

Create new VR module using MAX9924

ElDominio, 2023-06-14:
@Qwerty-OFF

Original design considerations for the current VR module were, in order of importance:
1)  MAX9924 was not assembled by JLCPCB, and usually not stocked
2) Problems with compatibility with low-count triggers

I propose there be a VR module that uses MAX9924 since now problem (1) is not a factor, and (2) can still be handled by using this module in conjunction with the already-existing module for low count patterns (by having both modules on one board)

In my experience, MAX992x chips are very good at conditioning/producing a useable output with almost all triggers without the fuss of manual thresholds, and without the pains that we have been experiencing with the current module (sometimes needs caps? sometimes doesn't?)

If it has the same module-size as the current VR solution, would it not be a plug-and-play affair to use on the current line of Hellen ECU's? If so, can it be done?

@andreika-git

rusefillc, 2023-06-26:
@Qwerty-OFF see interesting note at https://rusefi.com/forum/viewtopic.php?p=47921#p47921 mostly FYI

rusefillc, 2023-07-23:
@Qwerty-OFF we've realized that we forgot about something:

vr-descrete allowed us to have VR or Hall using two pinout pins and one MCU pin. The current max9924 is a loss of functionality since it's ONLY VR. At least for smaller universal boards we require VR/Hall 2 pinout pins solution like brought up on https://github.com/rusefi/alphax-8chan/issues/113

ElDominio, 2024-02-23:
This was done! And I love 9924

Closed 2024-02-23.

Thread 304 (2023-07-11):

Nicer WBO pin names

rusefillc, 2023-07-11:
At the moment we have

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

Let's add some stuff from https://github.com/rusefi/rusefi/wiki/WBO#naming-convention

IP: let's add "Pump Current"
VM: let's add "virtual ground VS/IP"?
UN: let's add "sensor voltage VS"?

не меняя ревизию, оставим 0.5?

Thread 306 (2023-07-12):

create-board.yaml is being copy-pasted and that's not cool

rusefillc, 2023-07-12:
At the moment too many repos which use hellen-one framework are copy-pasting same create-board.yaml file

That's not ideal since even the create-board.yaml sometimes needs to be improved. Do we have any ways to reuse?

rusefillc, 2023-07-12:
@chuckwagoncomputing what is the right way?

I can only think of reducing the impact by merging four shell scripts into one .sh script - and even that would reduce usability

chuckwagoncomputing, 2023-07-13:
OK, now we've got only a tine create-board.yaml to copy-paste. I don't think we can do better than that.

Closed 2023-07-23.

Thread 307 (2023-07-13):

Command line gerber export touches project files

rusefillc, 2023-07-13:
https://github.com/rusefi/hellen88bmw/commit/6149333b9ca89f442df8c9704b6ae35eb649b11c has touched .kicad_pro file

Do we have any concerns or do we keep thing as is?

rusefillc, 2023-07-13:
One potentially negative consequence I can think of - at the moment we install _latest_ kicad thus at any moment of time fresh GHA might invoke latest and greatest and overwrite the file. This might well be bad timing forcing engineer to update his local install. @chuckwagoncomputing @Qwerty-OFF @andreika-git what do you think?

chuckwagoncomputing, 2023-07-13:
Yes this should be fixed

Closed 2023-07-13.

Thread 308 (2023-07-13):

Command line gerber export: take board name from revision

rusefillc, 2023-07-13:
Minor usability improvement is possible: instead of yaml file hard-coding board name, for instance hellen88bmw

revision.txt inside current folder like for instance https://github.com/rusefi/hellen88bmw/blob/main/revision.txt has ``BOARD_PREFIX=hellen
BOARD_SUFFIX=88bmw`` which together make desired board name

Closed 2023-07-13.

Thread 313 (2023-07-23):

Command line BOM export

rusefillc, 2023-07-23:
We have a lot of amazing around https://github.com/andreika-git/hellen-one/issues/24 we also need BOM export

See https://github.com/rusefi/hellen88bmw/tree/main/gerber for lonely old file

rusefillc, 2023-07-23:
@chuckwagoncomputing FYI

rusefillc, 2023-07-23:
> as there isn't a python library to do it
sad

rusefillc, 2023-07-26:
https://github.com/rusefi/alphax-2chan/commit/79b2e42ea629fc44c4b5fbc621b057ebb7b02188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 proves that we only have BOM

Closed 2023-07-26.

Thread 316 (2023-07-26):

gha-commit.sh twice within same action

rusefillc, 2023-07-26:
I would love to export & commit two different boards at https://github.com/rusefi/rusefi-hardware/

considering heavy kicad install it's tempting to pile both into same https://github.com/rusefi/rusefi-hardware/blob/main/.github/workflows/create-board.yaml

that would not be compatible with current gha-commit.sh approach to NOCOMMIT variable - at the moment gha-commit.sh does not account for previous invocations wanting to push anything

rusefillc, 2023-07-26:
@chuckwagoncomputing I guess I will flip from NOCOMMIT into YESCOMMIT in the 'headers: looks like something has changed' branch

Closed 2023-07-26.

Thread 317 (2023-08-02):

export.sh should print helpful message if aux_axis_origin is missing

rusefillc, 2023-08-02:
export.sh
```
echo Getting Drill/Place origin from PCB
X=$(grep "aux_axis_origin" "$PCB_FILE" | tr -s ' ' | cut -d ' ' -f 3)
Y=$(grep "aux_axis_origin" "$PCB_FILE" | tr -s ' ' | cut -d ' ' -f 4 | tr -d ')')
echo Export VRML using $X $Y
python "$DIR/export-vrml.py" "$PCB_FILE" "$X" "$Y" "gerber/$IN.wrl"
```
See https://github.com/rusefi/stim/actions/runs/5734128619/job/15539845060 which has failed

```
Export VRML using
Traceback (most recent call last):
  File "/home/runner/work/stim/stim/digital_inputs/../hellen-one/kicad/bin/export-vrml.py", line 8, in <module>
    x = float(sys.argv[2])
ValueError: could not convert string to float: ''
```

i.e. aux_axis_origin has produced empty $X $Y

rusefillc, 2023-08-02:
https://github.com/rusefi/stim/issues/21

Closed 2023-08-02.

Thread 318 (2023-08-02):

unclear failure

rusefillc, 2023-08-02:
https://github.com/rusefi/stim/actions/runs/5734374341/job/15540458399

```
* Checking Python module 'NumPy': OK
* Checking Python module 'cairocffi': OK
* Checking module dependencies: ffi and cairo
* Checking ffi...
* Library ffi FOUND!
* Checking cairo...
* Library cairo FOUND!
* Checking Python module 'gzip': OK
* Checking Python module 'simpleparse': OK
* Checking Python module 'PyVRML97': OK
All checks done!
Processing digital_inputs board...
_XSERVTransmkdir: ERROR: euid != 0,directory /tmp/.X11-unix will not be created.
Removing old files of the board...
Creating digital_inputsa-bom_replace_digital_inputs-a.csv...
* appending the CPL with offset (0,0)...
Traceback (most recent call last):
  File "bin/process_board.py", line 264, in <module>
    append_cpl(frame_path + "/" + frame_name + "-CPL.csv", board_cpl, "0", "0", "0", 0)
  File "bin/process_board.py", line 113, in append_cpl
    with open(src_fname, 'rt') as src_f, open(dst_fname, 'a') as dst_f:
FileNotFoundError: [Errno 2] No such file or directory: '/digital_inputs/boards/digital_inputsa-bom_replace_digital_inputs-a.csv/frame/a-CPL.csv'
ABORTING!
```

what is this about? can we have better failure message to help users like myself?

andreika-git, 2023-08-02:
That's about empty board suffix, which is passed as a command line argument, so the whole command line is parsed incorrectly (arguments shifted)

rusefillc, 2023-08-02:
@andreika-git thank you! let me work around it in https://github.com/rusefi/stim but we need to improve usability

Thread 320 (2023-08-02):

Drill files support inches same as PCB auto-converts to mm

rusefillc, 2023-08-02:
```
Reading data from inputs ...
Traceback (most recent call last):
  File "/usr/local/lib/python3.8/runpy.py", line 194, in _run_module_as_main
    return _run_code(code, main_globals, None,
  File "/usr/local/lib/python3.8/runpy.py", line 87, in _run_code
    exec(code, run_globals)
  File "/hellen-one/bin/gerbmerge/gerbmerge/__main__.py", line 5, in <module>
    gerbmerge.main()
  File "/hellen-one/bin/gerbmerge/gerbmerge/gerbmerge.py", line 845, in main
    sys.exit(merge(opts, args)) ## run germberge
  File "/hellen-one/bin/gerbmerge/gerbmerge/gerbmerge.py", line [371](https://github.com/rusefi/stim/actions/runs/5739866688/job/15556441792#step:8:372), in merge
    config.parseConfigFile(args[0])
  File "/hellen-one/bin/gerbmerge/gerbmerge/config.py", line 387, in parseConfigFile
    J.parseExcellon(fname)
  File "/hellen-one/bin/gerbmerge/gerbmerge/jobs.py", line 716, in parseExcellon
    raise RuntimeError("File %s units do match config file" % fullname)
RuntimeError: File /digital_inputs/boards/digital_inputs-a/frame/inputs.DRL units do match config file

Where was an ERROR executing the script! Code=1
ABORTING!
Error: Process completed with exit code 3.
```

https://github.com/rusefi/stim/actions/runs/5739866688/job/15556441792

rusefillc, 2023-08-02:
@chuckwagoncomputing can we improve the export script? Assuming this is all in fact about units can we override units during export? if it's not trivial to override units during export can we just fail sooner with a very clear message asking for specific setting in the project?

chuckwagoncomputing, 2023-08-05:
Looks like this error was ignored in the gerber parsing, but not in the drill file parsing.
https://github.com/andreika-git/gerbmerge/blob/43eb62470565f5f408cf8094047624bc43f90183/gerbmerge/jobs.py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

rusefillc, 2023-08-06:
@chuckwagoncomputing you mean "gerbermerg does automatic conversion" but drill processing does not do automation conversion not does it throw an error?

I'd say the nice way forward would be to attempt similar auto-conversion in drill processing?

rusefillc, 2023-08-08:
looks like this issue was about wrong/old files in the input folder

proper thing to do would be https://github.com/andreika-git/hellen-one/issues/321

Closed 2023-08-08.

Thread 323 (2023-08-13):

does mcu176 support STM32F469IGH6 or STM32F469IIH6

rusefillc, 2023-08-13:
176 package
386KB RAM
1 or 2MB flash

rusefillc, 2023-08-13:
Well real question if STM32F469 is pin compatible with F407 F429 and F7xx which we've used so far.

rusefillc, 2023-08-14:
https://github.com/andreika-git/hellen-one/issues/324

Closed 2023-08-14.

Thread 325 (2023-08-15):

mm-176

rusefillc, 2023-08-15:
let's move forward with mm for STM32F429IGT6 at least it has 256Kb

while we are testing all this hopefully we would grab some F7 maybe in October of 2023 https://www.mouser.com/ProductDetail/STMicroelectronics/STM32F746IGT6?qs=E2FFEhwHWtdruDtEH26%2FzQ%3D%3D

rusefillc, 2023-08-15:
No need in second CAN bus transiever on the main mm body

Closed 2023-10-02.

Thread 326 (2023-08-20):

MM100

Qwerty-OFF, 2023-08-20:
Из модуля торчит наружу:
8x IGN / 5В-выход для управления VND10
8x INJ / IO
8x PWM_OUT / IN
14x аналоговый вход (один из них превращается в CAN Wakeup)
2х цифровой вход через операционный усилитель (VSS, knock)
4х цифровой вход через триггер Шмидта
2x SPI / 8x IO / CAN2 + 2x IO + SPI
CAN
USB
I2C
2x UART / 4x IO
SWD
@rusefillc жду корректировок или одобрения

rusefillc, 2023-08-21:
@Qwerty-OFF а почему knock цифровой?
всё очень позитивно
SWD наружу на грани пользы, но вероятно мало влияет на всю картину, так что пусть торчит.

Qwerty-OFF, 2023-08-26:
Поправил, knock аналоговый, все остальное без изменений

Qwerty-OFF, 2023-08-26:
@Nadezhda-n сделал схему, можно трассировать. Футпринт модуля ММ100 нужно будет сделать по ходу работ. Цель запихнуть все это в минимальные возможные габариты

Qwerty-OFF, 2023-08-31:
@Nadezhda-n я добавил пару земляных отверстий в проекте чтоб починить DRC, подправил outjob.
Пофикси тут пад земли чтоб зазор по вертикали был 0.2мм
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
Все остальное выглядит хорошо

Nadezhda-n, 2023-09-01:
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

rusefillc, 2023-09-04:
@Qwerty-OFF надо заполнить https://github.com/rusefi/rusefi/commit/a1291cef18575ab7edc827957f991d7b20c49427 файлик теперь :)

Qwerty-OFF, 2023-10-02:
Сделано

Closed 2023-10-02.

Thread 327 (2023-08-21):

Scary ./kicad/pcbnew/pcbnew.cpp(322): assert "process" failed in Pgm().

rusefillc, 2023-08-21:
all export invocations print the same scary message

https://github.com/rusefi/stim/actions/runs/5914936626/job/16040725554

```
Export positions file
Loading board
Getting Drill/Place origin from PCB
Export VRML using 127 212
./kicad/pcbnew/pcbnew.cpp([32](https://github.com/rusefi/stim/actions/runs/5914936626/job/16040725554#step:5:33)2): assert "process" failed in Pgm().
Restore PCB backup
```

Shall we do something about it?

Thread 328 (2023-08-29):

check for date-only or version-only changes

rusefillc, 2023-08-29:
see https://github.com/rusefi/rusefi-hardware/commits/main ridiculous history

we should not update gerbers on .cpp file change but unclear how to accomplish? especially in case of PDF

but let's at least do something :) we have an attempt to fix https://github.com/andreika-git/hellen-one/commit/993eaa22c7dd3b47fb0a44d827fe98f49bb7c7c5

(cannot find original ticket)

Thread 331 (2023-09-08):

export gerbers did not update existing files at 8chan

rusefillc, 2023-09-08:
https://github.com/rusefi/alphax-8chan/commit/e93521e9ff9eba6deac3a09a2c835265715f2f6d has added some new files but has not updated existing files as expected

rusefillc, 2024-09-14:
Fixed or abandoned?

Closed 2024-09-14.

Thread 332 (2023-09-09):

AO3400A solenoid test

Qwerty-OFF, 2023-09-09:
Let's try to control solenoidы with any board with ao3400a, for example 4chan_h OUT_PUMP_RELAY.

rusefillc, 2023-10-31:
кстати потенциально незащищённые пины могут не пережить +12 вольт

Thread 333 (2023-09-10):

DNP пропадает из BOM, но не из CPL

rusefillc, 2023-09-10:
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

JLC заботятся теперь о нас еще больше. Когда позиция есть в CPL, но отсутствует в BOM, вылезает ошибка. Источник ситуации кажется механизм replace-файлов, когда элемент становится DNP он пропадает из BOM, но не из CPL

rusefillc, 2024-02-04:
@andreika-git @Qwerty-OFF верно ли, что приоритет очень низкий?

Qwerty-OFF, 2024-02-04:
Это было только про ругань jlc, так что совсем не критичное

Thread 334 (2023-09-11):

mm144 option to reuse yellow and green LED as GPIO

rusefillc, 2023-09-11:
do we have space to expose green and yellow LEDs as GPIO on the footprint if we DNP those LEDs?

Qwerty-OFF, 2023-09-11:
Yes

Closed 2023-10-02.

Thread 335 (2023-09-11):

mm100 option to reuse yellow and green LED as GPIO

rusefillc, 2023-09-11:
do we have space to expose green and yellow LEDs as GPIO on the footprint if we DNP those LEDs?

sibling of https://github.com/andreika-git/hellen-one/issues/334

Qwerty-OFF, 2023-09-11:
Yes

rusefillc, 2023-09-13:
@Qwerty-OFF let's do it!

Qwerty-OFF, 2023-10-02:
Done

Closed 2023-10-02.

Thread 337 (2023-10-08):

Error in gerber files with *rotated* modules on the bottom side

Qwerty-OFF, 2023-10-08:
In 8chan-b and 8-chan-c, the WBO modules are placed on the bottom side of the board. There are artifacts on the top and bottom layers in the resulting gerber files. It seems that the artifacts are related to some issue with processing the rounded pads.
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

andreika-git, 2023-10-10:
Fixed by https://github.com/rusefi/alphax-8chan/commit/2ebd618d90802731fe311708ef8f32424b1d1a04

andreika-git, 2023-10-10:
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

Closed 2023-10-10.

Thread 340 (2023-10-16):

improve silkscreen D418

rusefillc, 2023-10-16:
https://github.com/rusefi/alphax-2chan/issues/101
https://github.com/andreika-git/hellen-one/issues/292 уже есть - почему тогда жалоба в small-can-board rev A?

Qwerty-OFF, 2023-10-25:
Видимо все хорошо

Closed 2023-10-25.

Thread 341 (2023-10-25):

mm100 f7

rusefillc, 2023-10-25:
F7 gives us so much needed RAM
mm100 gives us size

how does https://jlcpcb.com/partdetail/Stmicroelectronics-STM32F765VGT6/C435845 look for mm100-f7?

Qwerty-OFF, 2023-10-25:
Looks good
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

Qwerty-OFF, 2023-10-25:
Done

rusefillc, 2023-11-22:
@Qwerty-OFF можно ли мне добавить в https://github.com/andreika-git/hellen-one/blob/master/modules/mega-mcu100-f7/readme.md файлик

* STM32F777VIT6
* STM32F767VIT6
* STM32F765VIT6

?

Qwerty-OFF, 2023-11-22:
Да, полный список пин-совместимых:
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

Closed 2023-10-25.

Thread 343 (2023-11-20):

better safe than sorry VND7NV04 on WBO

rusefillc, 2023-11-20:
https://github.com/mck1117/wideband/issues/174

Qwerty-OFF, 2023-12-02:
Fixed in BOM

rusefillc, 2023-12-02:
@dron0gus ты имеешь ввиду нам нужно менять схематику и добавлять транзистор изменения уровня с 3в на 5в? текущая схематика https://github.com/andreika-git/hellen-one/blob/master/modules/wbo/0.5/wbo-schematic.pdf

Qwerty-OFF, 2023-12-02:
VND10 не работает гарантированно от уровней 3.3В, VND7 работает чуть более гарантированно, теперь используем его

rusefillc, 2024-01-28:
https://github.com/rusefi/uaefi/issues/31

Thread 344 (2023-11-26):

3D issues and kicad path and hellen-one relative path in individual repo

rusefillc, 2023-11-26:
Too often we have issues with 3D files path

See bottom of https://github.com/andreika-git/hellen-one/commit/373cf7efdf87ee892e61a506ce7de16c251cdb20 as a way to address https://github.com/rusefi/alphax-8chan/issues/124

rusefillc, 2023-11-26:
```
 сделал https://github.com/andreika-git/hellen-one/commit/373cf7efdf87ee892e61a506ce7de16c251cdb20 (предпоследняя измененная строка) чтобы https://github.com/rusefi/alphax-8chan/issues/124. Суть в том что кикад который живет в actions не знает про нашу выдуманную переменную путей hellen-one-models, поэтому я написал путь относительно директории проекта. Это станет нашей реальностью или можно придумать более качественный костыль?
```

Thread 346 (2023-11-30):

power_12and5V-0.2 PDF should spell out long term range input

rusefillc, 2023-11-30:
power_12and5V-0.2 PDF should spell out what voltage we survive long term and what voltage we survive for how long in what duration of spikes.

I know this was mentioned before but I am failing to locate any relevant tickets or wiki pages :(

Thread 347 (2023-12-02):

разжёвывалки на схемы

rusefillc, 2023-12-02:
* [x] упомянуть "TC2030 connector" на WBO без изменения версии
* [x] упомянуть "TC2030 connector" на mcu144 без изменения версии
* [x] упомянуть кнопки boot/reset на mcu144 без изменения версии

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

Qwerty-OFF, 2023-12-02:
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

Closed 2023-12-02.

Thread 349 (2023-12-09):

Reading gerber file Error! Cannot parse position

rusefillc, 2023-12-09:
```
* Adding power_12and5V (modules/power_12and5V/0.1/power_12and5V-vrml.wrl) at (-145.275001,56.824999000000005), rot=0.0, invZ=1.0...
* Adding ign8 (modules/ign8/0.2/ign8-vrml.wrl) at (-107.[2265](https://github.com/dynfer/hellen-example/actions/runs/7152677941/job/19478270443#step:12:2266)88,122.01185699999999), rot=180.0, invZ=1.0...
* Adding vr-discrete (modules/vr-discrete/0.4/vr-discrete-vrml.wrl) at (-53.324999999999996,92.975), rot=180.0, invZ=1.0...
* Kicad VRML detected!
* Adding mega-mcu144 (modules/mega-mcu144/0.4/mega-mcu144-vrml.wrl) at (-85.774999,60.774998999999994), rot=90.0, invZ=1.0...
* Adding knock (modules/knock/0.2/knock-vrml.wrl) at (-57.875,101.82500100000001), rot=180.0, invZ=1.0...
* Adding ign8_2 (modules/ign8/0.2/ign8-vrml.wrl) at (-71.026588,122.711857), rot=180.0, invZ=1.0...
* Adding wbo (modules/wbo/0.3/wbo-vrml.wrl) at (-157.05,41.175), rot=0.0, invZ=1.0...
* Kicad VRML detected!
* Adding vr-discrete_2 (modules/vr-discrete/0.4/vr-discrete-vrml.wrl) at (-51.45750000000001,74.375), rot=180.0, invZ=1.0...
* Kicad VRML detected!
* Adding knock_2 (modules/knock/0.2/knock-vrml.wrl) at (-57.875,105.525001), rot=180.0, invZ=1.0...
Done!
Rendering a 3D-model of the board components...
* Reading /hellen-example/boards/dynfer_6ch-a/board/misc/dynfer_6ch-a-3D.wrl.gz...
* Decompressing GZip...
* Parsing the VRML data...
* Processing the data...
* Num.Vertices = 1022568 Num.Indices = 2574774
* AABB = [[-165.79999354    0.           -4.65940001]
 [   0.          162.80000229    3.26005991]]
* Rendering...
* Image size = 3917x3846
* Saving to /hellen-example/boards/dynfer_6ch-a/board/misc/dynfer_6ch-a-components.png...
* Done!
Creating a composite board image...
* Reading the pcb image...
* Reading the components image with offset (0,0)...
* Reading the outline image...
* Creating the final board image...
* Saving the board image...
* Done! Exiting...
Creating an interactive html BOM...
* Reading gerber file /hellen-example/boards/dynfer_6ch-a/board/gerber/dynfer_6ch-a.GKO...
* Format:  2 5 2 5
* Format:  2 5 2 5
Error! Cannot parse position ['-463386', '0162106']

Where was an ERROR executing the script! Code=1
ABORTING!
Error: Process completed with exit code 3.
```

https://github.com/dynfer/hellen-example/actions/runs/7152677941/job/19478270443

rusefillc, 2023-12-09:
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

Thread 351 (2023-12-11):

unintended *.kicad_pro push

rusefillc, 2023-12-11:
https://github.com/rusefi/alphax-4chan/commit/8476166bac3353b74402ee0bd9314262e6b2d569 should not have touched alphax_4ch.kicad_pro

We seem to have provisions to reset https://github.com/andreika-git/hellen-one/commit/4f721588cbf1433008ad28f0c210a3a5f508b45e

```
git reset HEAD *.kicad_pro
```

rusefillc, 2023-12-11:
do they not support wildcard?! or was it only older versions? https://stackoverflow.com/questions/4228100/git-i-want-to-unstage-all-files-matching-a-certain-pattern

rusefillc, 2023-12-11:
@chuckwagoncomputing wow

```
rusefi@DESKTOP-57S88S8:~/rusefi$ git status
On branch master
Your branch is up to date with 'origin/master'.

Changes not staged for commit:
  (use "git add <file>..." to update what will be committed)
  (use "git restore <file>..." to discard changes in working directory)
        modified:   README.md
no changes added to commit (use "git add" and/or "git commit -a")
rusefi@DESKTOP-57S88S8:~/rusefi$ git reset HEAD *.md
Unstaged changes after reset:
M       README.md
rusefi@DESKTOP-57S88S8:~/rusefi$ git reset HEAD *.md
Unstaged changes after reset:
M       README.md
```

rusefillc, 2023-12-11:
@chuckwagoncomputing wow

```
rusefi@DESKTOP-57S88S8:~/rusefi$ git restore *md
rusefi@DESKTOP-57S88S8:~/rusefi$ git status
On branch master
Your branch is up to date with 'origin/master'.
```

rusefillc, 2023-12-11:
revert instead of reset has fixed the issue

Closed 2023-12-11.

Thread 352 (2023-12-14):

Wiki link broken power5 module

dynfer, 2023-12-14:
When accessing the link we get the following error

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

https://github.com/andreika-git/hellen-one/wiki/module-power5

rusefillc, 2023-12-15:
@dynfer please clarify where did you find that https://github.com/andreika-git/hellen-one/wiki/module-power5 link?

dynfer, 2023-12-15:
> @dynfer please clarify where did you find that https://github.com/andreika-git/hellen-one/wiki/module-power5 link?

Its the link in the modules section on the main page of the wiki, also I've noticed the Power12and5 module is missing in the list where it does exists in the repository(readme.md)

rusefillc, 2023-12-15:
thank you should be better now

Closed 2023-12-15.

Thread 353 (2023-12-15):

mm100 and else too much SD capacitance C117, C123

rusefillc, 2023-12-15:
Исправлены BOM всех актуальных версий ММ на 1x10uF вместо 2x22uF
Не забыть починить в следующих ревизиях ММ:

- [x] 64
- [x] 100
- [x] 100f7
- [x] 144
- [x] 176

https://github.com/rusefi/hellen-112-17/issues/22
https://github.com/rusefi/hellen-112-17/issues/23

https://github.com/rusefi/uaefi/issues/25#issuecomment-1858605890

rusefillc, 2023-12-15:
снял два конденсатора - заработало. у меня 10 штук uaefi если нужна статистика, но что-то подозрение на проблему у нас

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

rusefillc, 2023-12-19:
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

Qwerty-OFF, 2023-12-19:
На линии 3.3В слишком большая емкостная нагрузка, стабилизатор уходит в защиту/перезапуск. Я повторил в мегамодулях модуль sd, в котором было 2 х 22 мкФ, если их убрать, все чинится. @andreika-git нет возражений если я в bom уменьшу эти конденсаторы и оставлю что-то около 10мкФ в сумме?

andreika-git, 2023-12-22:
https://resources.altium.com/p/how-to-design-microsd-power-circuits-without-destabilizing-on-board-voltage-supply

"The best value for a decoupling capacitor should exceed the total load capacitance and the capacitance between Vdd and Vss of the microSD card. In most cases, any values **above 45uF** will do."

andreika-git, 2023-12-22:
> @andreika-git нет возражений если я в bom уменьшу эти конденсаторы и оставлю что-то около 10мкФ в сумме?

Там большая ёмкость была не по моей прихоти, а согласно рекомендациям (см. коммент выше с примером рекомедации, но их таких много в других источниках). Идея, типа, в том, что с недостаточной ёмкостью, если вставить карту памяти "на горячую", то проц может перезагрузиться из-за скачка тока. Но, конечно, если выбирать между нестабильной работой в целом и броском при ините карты памяти, то придётся уменьшать ёмкость, да...

rusefillc, 2023-12-23:
@Qwerty-OFF need new PN for C117, C123

Qwerty-OFF, 2023-12-23:
> @Qwerty-OFF need new PN for C117, C123

Можешь убедиться что с одним снятым конденсатором все хорошо? Поставим 2x10 uF C77040. Либо один из тех двух сделаем DNP

Qwerty-OFF, 2023-12-23:
> @Qwerty-OFF need new PN for C117, C123

Можешь убедиться что с одним снятым конденсатором все хорошо? Поставим 2x10 uF C77040. Либо один из тех двух сделаем DNP

Нам критична установка флешки на горячую? Можно попробовать соорудить фильтр с катушкой. Хотя раньше оно же работало...

rusefillc, 2023-12-23:
> Можешь убедиться что с одним снятым конденсатором все хорошо?  Поставим 2x10 uF C77040. Либо один из тех двух сделаем DNP

да, с одним всё хорошо!

> Нам критична установка флешки на горячую?

вообще не критично

rusefillc, 2024-01-11:
placed an order with CL10A226MQ8NRNC C773 for C117,C123 and we are having the reboot issue

rusefillc, 2024-01-12:
> да, с одним всё хорошо!

похоже нет, не всегда всё хорошо с одним

Qwerty-OFF, 2025-05-03:
Кажется починил все актуальные модули и их проекты

Closed 2025-05-03.

Thread 355 (2023-12-22):

log of trivial parts shortages

rusefillc, 2023-12-22:
blue LED C72041
green LED C72043

rusefillc, 2023-12-22:
https://github.com/rusefi/hellen154hyundai/issues/110

rusefillc, 2024-01-19:
Texas Instruments SN74AHC1G02DBVR
Manufacturer
Texas Instruments
MFR.Part #
SN74AHC1G02DBVR
JLCPCB Part #
C7463
Package
SOT-23-5

Thread 356 (2023-12-26):

Перепутаны AUX3 и AUX4 в MM100, MM100-F7, MM144

Qwerty-OFF, 2023-12-26:
Вход ММ обозначенный как AUX4 внутри ММ переименовывается в AUX3 и наоборот, возникает путаница
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
Необходимо починить meta.h файлы, чтобы было соответствие правильных названий входов MM и пинов процессора, в следующих ревизиях исправить наименования на схемах так, чтобы meta.h и медь не изменились.

Closed 2024-01-02.

Thread 360 (2024-01-28):

output module weak low sides have no current limitation

rusefillc, 2024-01-28:
uln2003 would not survive short to +12v

rusefillc, 2024-02-17:
Marking https://github.com/andreika-git/hellen-one/wiki/module-output as deprecated

Thread 363 (2024-02-04):

hellen-one-kicad-bom-plugin.py doesn't know about "Exclude from BOM" option

andreika-git, 2024-02-04:
Something has changed in recent Kicad behavior around "Exclude from BOM" option and python scripts:
https://github.com/KiCad/kicad-source-mirror/commit/a1f796ffa0ce82689d9ef4a85ab3ec188ff360db

Thread 366 (2024-02-25):

uaefi footprint IGN output comment

rusefillc, 2024-02-25:
в районе IGN хочется подписать инструкцию модификации платы

что-то типа "logic level outputs by default
to control dumb coils remove XXX and populate YYY"

Qwerty-OFF, 2024-02-27:
В uaefi-c добавить подпись непосредственно на uaefi

Qwerty-OFF, 2024-02-27:
С двух сторон
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

Closed 2024-02-27.

Thread 368 (2024-02-27):

Always hot vs flyback diode

rusefillc, 2024-02-27:

Qwerty-OFF, 2024-02-27:
Как это было сделано на символе протеуса
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

rusefillc, 2024-02-28:
PS: @Qwerty-OFF может быть даже Proteus + текст?
"Flyback diodes for solenoids but not compatible with constantly powered actuators"

Qwerty-OFF, 2025-06-17:
На данный момент так:

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
Диоды есть в более глубоком листе схемы, я могу их вынести на внешний, чтоб было сразу видно. Или добавить картинку как протеусе на символ листа? HOT убираю и делаю сквозную нумерацию?

Thread 375 (2024-03-23):

hot VR for discrete

rusefillc, 2024-03-23:
See https://github.com/andreika-git/hellen-one/issues/374
See https://github.com/rusefi/uaefi/issues/57

Qwerty-OFF, 2024-03-27:
Появилась ревизия 0.5 с добавленным резистором

Closed 2024-03-27.

Thread 376 (2024-03-26):

TypeError: unsupported operand type(s) for &: 'float' and 'int'

rusefillc, 2024-03-26:
```
Job knock:
  Extents: (0,0)-(36614,[1299](https://github.com/rusefi/hellen154hyundai/actions/runs/8376474943/job/22937135774#step:13:1300)2)
  Size: 0.366140" x 0.129920"

Trimming Excellon data to board outlines ...
Trimming Gerber data to board outlines ...
Traceback (most recent call last):
  File "/usr/local/lib/python3.8/runpy.py", line 194, in _run_module_as_main
    return _run_code(code, main_globals, None,
  File "/usr/local/lib/python3.8/runpy.py", line 87, in _run_code
    exec(code, run_globals)
  File "/hellen-one/bin/gerbmerge/gerbmerge/__main__.py", line 5, in <module>
    gerbmerge.main()
  File "/hellen-one/bin/gerbmerge/gerbmerge/gerbmerge.py", line 845, in main
    sys.exit(merge(opts, args)) ## run germberge
  File "/hellen-one/bin/gerbmerge/gerbmerge/gerbmerge.py", line 408, in merge
    job.trimGerber()
  File "/hellen-one/bin/gerbmerge/gerbmerge/jobs.py", line 1184, in trimGerber
    self.trimGerberLayer(layername)
  File "/hellen-one/bin/gerbmerge/gerbmerge/jobs.py", line 1058, in trimGerberLayer
    newX, newY = geometry.rectCenter(newRect)
  File "/hellen-one/bin/gerbmerge/gerbmerge/geometry.py", line 280, in rectCenter
    if dx & 1:    # Odd width: center is (left+right)/2 + 1/2
TypeError: unsupported operand type(s) for &: 'float' and 'int'

Where was an ERROR executing the script! Code=1
ABORTING!
Error: Process completed with exit code 3.
```

rusefillc, 2024-03-26:
Некоторые куски гербера верхнего слоя меди подходят вплотную к границам модуля. Например, левый вертикальный пад 0.2х12.5 имеет нулевой зазор, и из-за конвертации из миллиметров в дюймы и погрешности арифметики он начинает "вылазить" за границы модуля на 0.000254 мм... Мы могли бы изменить формат работы с герберами на мм вместо дюймов, но у нас часть файлов в дюймах, а часть в мм, и потенциально могут вылезти проблемы в других модулях и фреймах... Или если бы Кикад умел экспортить герберы в дюймах, но он не умеет... Поэтому предлагаю обойтись малой кровью и либо немного увеличить границы модуля, либо чуть уменьшить/сдвинуть пады внутрь...

Qwerty-OFF, 2024-03-27:
Отодвинул на 0.01мм границы, теперь все работает

Thread 378 (2024-04-05):

The SN74 is a bus transceiver/level shifter not a gate driver

rusefillc, 2024-04-05:
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

[Rafael Matos](https://www.facebook.com/groups/938729756561668/user/100088293504989/) says

50ma per output is definitely not plenty at all to drive an IGBT for ignition either inside or outside the coil doesn't really matter an ISL9v3040s might use around 70ma with 5v on the gate, I have no questions about it turning ON I know it will drive, but its not reliable, i never seen an ignition driver circuit like this straight from a level shifter, all the ECU's I have ever owned/repaired/designed use very similar ignition driver circuits with a few small differences but same concept, after the level shifter it's always good practice to have some gate driver that can handle more current.
The SN74 is a bus transceiver/level shifter not a gate driver

rusefillc, 2024-04-05:
@dron0gus @andreika-git any opinions? we use SN74 on all recent mega-module designs

rusefillc, 2024-04-08:
originally reported at https://www.facebook.com/groups/rusEfi/permalink/1876919989409302/

rusefillc, 2024-04-09:
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

This is scope trace of trigger input and ign output .
Does anyone know how big the pullup is on the ign output?
Edit: this was WITH coil connected. Volt is same scale, red reaches 5v, blue only 2,5v.

rusefillc, 2024-04-09:
huh

https://www.nxp.com/docs/en/data-sheet/MC33810.pdf

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

dron0gus, 2024-04-09:
Do we sure that all smart coils have IGBTs as power switch? May be some have bipolar transistors or even darlington?
Looking at oscilogram from https://github.com/andreika-git/hellen-one/issues/378#issuecomment-2045234004 I suspect bipolar or gate protection. Fronts are sharp I see no other reason to stop on 2.5V, does not look like output stage overload.

Another note. MC33810 is good for on-board IGBTs and dump (two-wire) coils. Definitely not the best choice for driving smart coils - no feedback benefits, no diagnostic.

dron0gus, 2024-04-09:
High voltage NPN for ignition coil https://www.st.com/en/power-transistors/std901t.html
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

rusefillc, 2024-09-15:
Some suggestions at https://rusefi.com/forum/viewtopic.php?p=49945#p49945

rusefillc, 2025-03-30:
``the current UAEFI uses a TI SN74LVC4245APWR Logic Translator for U103. It is capable of sourcing and sinking 24 mA on the outputs. Spent some time and found a pin-compatible TI SN74LXCH8T245PWR capable of source/sink at 50 mA.``

https://www.rusefi.com/forum/viewtopic.php?p=50475#p50475

Thread 379 (2024-04-08):

VND10 not good for high current applications

rusefillc, 2024-04-08:
* chip shortage is over
* https://jlcpcb.com/parts/componentSearch?searchTxt=C2149912

VND has much higher on-state resistance and should be avoioded

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

Thread 380 (2024-04-09):

centralized BOM replacement

rusefillc, 2024-04-09:
all those green LED and zener diode shortages should be centrally managed in https://github.com/andreika-git/hellen-one/ not in individual repos

to have this reliable replacement files would have to be per-module?

Thread 381 (2024-04-09):

Too high resistance in the ignition circuit

Qwerty-OFF, 2024-04-09:
We started [adding](https://github.com/andreika-git/hellen-one/issues/361) protective fuses to the ignition control circuit. Since these fuses have resistance, the voltage to open the IGBT might be too low. https://github.com/andreika-git/hellen-one/issues/378#issuecomment-2043073951

To solve the problem, you can try replacing the fuse with a jumper.
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

Thread 385 (2024-04-16):

kicad 8 does not seem to work

rusefillc, 2024-04-16:
https://github.com/rusefi/alphax-4chan/ with https://github.com/andreika-git/hellen-one/pull/384 has failed

```
Plotted to 'gerber/alphax_4ch-B_Silkscreen.gbo'.
Plotted to 'gerber/alphax_4ch-F_Mask.gts'.
Plotted to 'gerber/alphax_4ch-B_Mask.gbs'.
Plotted to 'gerber/alphax_4ch-Edge_Cuts.gm1'.
Export drill file
Loading board
Created file 'gerber/alphax_4ch.drl'
Done.
Export positions file
Loading board
Getting Drill/Place origin from PCB
aux_axis_origin is missing in the PCB file
Error: Process completed with exit code [25](https://github.com/rusefi/alphax-4chan/actions/runs/8709991859/job/23890877698#step:6:26)5.
```

rusefillc, 2024-04-16:
@chuckwagoncomputing can you have a look? maybe hellen scripts were not compatible with https://github.com/andreika-git/hellen-one/pull/384/commits/1cc79bec8c438d7a05ef36f1a818c5a984a02696?

rusefillc, 2024-04-16:
@chuckwagoncomputing reverted 8 for now

chuckwagoncomputing, 2024-04-17:
Oh I think this happened because the workflow calls the scripts in the submodule, and the submodule wasn't updated.
I tried it on my branch, and it failed in a different way, not sure if Kicad 8 related.
```
copy_from_Kicad.py: Error! Designator [R15] was not found in the BOM file!
```

https://github.com/chuckwagoncomputing/alphax-4chan/actions/runs/8713580962/job/23902272004

rusefillc, 2024-04-17:
let's see https://github.com/rusefi/alphax-4chan/actions/runs/8715382463

rusefillc, 2024-04-17:
@chuckwagoncomputing note that R15 appears in .cvs https://github.com/rusefi/alphax-4chan/commit/ca2d9e57c714975391fb0aecbeb029a404c7210a

looks like DNP is handled differently or smth looks like we would need @andreika-git

rusefillc, 2024-09-14:
Kicad 8 seems to be happy these days

Closed 2024-09-14.

Thread 387 (2024-04-23):

Statistics says: by far most JLCPCB quality issues are around dual-size WBO module

rusefillc, 2024-04-23:
* most popular issue: f0 and f4 both take FW via TC2030 and both blink but no CANbus between those!
* less popular issue: f0 would not take FW via TC2030

rusefillc, 2024-04-23:
current revision 0.5
from qty 25 rev C boards I have at least two "both blink but no CANbus between those!"

rusefillc, 2024-04-24:
Maybe at least partially https://github.com/rusefi/uaefi/issues/61

Thread 389 (2024-05-26):

replacement "SMCJ30A","D418","SMC","C310046"

rusefillc, 2024-05-26:
https://github.com/andreika-git/hellen-one/blob/master/modules/power_12and5V/unified-replace-power-supply.csv is asking for D418 replacement

Thread 391 (2024-07-22):

no we do not support H7 at all

rusefillc, 2024-07-22:
Stm32H743zit6 should not be mentioned as any default on any 144 MCU or MM module

at this point let's go with F7 2MB as default, that's the most proper long term chip

STM32F767ZIT6 C90235

rusefillc, 2024-07-23:
@Qwerty-OFF no need to bump versions, let's just manually edit BOMs for recent versions of both mcu and mega

Qwerty-OFF, 2024-07-23:
Already fixed all BOM where I found H7

rusefillc, 2024-07-23:
@Qwerty-OFF я ошибся в описании

C90235 было правильно

STM32F767ZG не правильно

STM32F767ZI правильно

Closed 2024-07-24.

Thread 393 (2024-10-04):

hybrid jumper seems to be increasing risk of bad soldering job

rusefillc, 2024-10-04:
Looks like I have a board with BOTH
* fuse soldered poorly
* fuse blown

Looks like solder wants to leak into the unused hole?

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

Thread 395 (2024-10-30):

Replacement by LCSC code

Qwerty-OFF, 2024-10-30:
It's a lot of work to edit the replace file in many repositories every time a component runs out. I'd like to have one list where I can enter replacements by LCSC code, for example C362485 -> C112566, so that I can regenerate the BOM automatically before placing an order.
https://github.com/rusefi/hellen-112-mg1/issues/113
https://github.com/rusefi/hd81/issues/55

Thread 396 (2024-12-01):

module power12 and 5: mark optional VBAT components

rusefillc, 2024-12-01:
If 12_PERM/VBAT feature is not needed we can leave some components unpopulated

within this ticket can we just draw a rectangle with all the components not needed if 12_PERM/VBAT is not needed?

P4ulBr4ndt, 2024-12-02:
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
Schematic is nicely structured, therefore my guess is it's this simple.
DNP R410, D411, D412, D413, C413, U410, C410, C412

Thread 397 (2024-12-16):

TVS Diodes quality issues

rusefillc, 2024-12-16:
* not all C85364 behave the same
* bad PN https://jlcpcb.com/partdetail/Msksemi-SRV05_4_PT7/C6454456

https://github.com/rusefi/hellen154hyundai/issues/163

dron0gus, 2024-12-17:
Я думаю, приподнимается вся линия V5A.
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

А нужно ли вообще цеплять пин REF (5) SRV05-4 на линию V5A? У него внутри встроенный стабилитрон на 6.0В, пусть он работает.
V5A у нас делает TLS115 который не может сопротивляться повышению напряжения на своем же выходе из-за внешней зпитки. А запитка через 4.7К резистор будет (14-6)/4700 = 1.7 мА. Мы либо должны с учетом этого нагружать линию V5A тупо резистором либо использовать другой стабилизатор, либо отцепить все защитные цепи от этой линии (что кажется самым логичным).
Кстати аналогичная запитка будет и через pull-up резисторы по линиям всяких CLT, но замыкание такого входа уже не штаная ситуцая.

dron0gus, 2024-12-17:
Преложение выше не актуально. Внимательно посмотрел схему hellen модулей - внутренние +5V и выходящие наружу +5VAS это разные источники. Надо бы посмотреть что происходит со внутренними V5A (+5VP) и попробовать нагрузить их.

Qwerty-OFF, 2024-12-17:
Оставил картинку где смотреть тут https://github.com/rusefi/hellen154hyundai/issues/163#issuecomment-2549582150
Даже если V5A поднимается, это не должно бы приводить к поднятию остальных IO-линий

Thread 398 (2025-01-18):

RTC battery is drained

rusefillc, 2025-01-18:
@dron0gus says add a diode?

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

@dron0gu says maybe remove a diode?

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

rusefillc, 2025-01-18:
https://github.com/andreika-git/hellen-one/commit/c1a4955dffc6152309ed1d8d2e2cb981bbcdade4

dron0gus, 2025-01-19:
1N4148 has too high leakage current for this application.
With U410 LDO disconnected and no D107 STM32 consumes about 1.09 uA on Vbat input.
If 1N4148 is added on LDO output - current rises up to 1.9uA.
So reverse current through 1N4148 is 0.8 uA.
This is twice bigger than defined in DS. Fake part?

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

rusefillc, 2025-01-19:
progress see https://github.com/andreika-git/hellen-one/blob/master/modules/power_12and5V/readme.md

@dron0gus keeps suggesting something else

rusefillc, 2025-04-22:
fixed on 0.3 https://github.com/andreika-git/hellen-one/tree/master/modules/power_12and5V

Closed 2025-04-22.

Thread 399 (2025-01-19):

TVS drama

rusefillc, 2025-01-19:
```
8chan issues. Seems I have cross talk on a few analog inputs as well as some other weird behavior. For example, aux analog 1 (1A) mapped to MAP input reads raw MAP 0.00x volts with wire removed from socket. Measured voltage on wire with dmm, reads zero. Actual map sensor is not plugged into engine side of harness. So this all makes sense. If I insert the wire back into the connector at 1A, raw MAP reads some voltage, around 3 volts. Measuring terminal inside ECU case still shows 0.00x volts. And there is some cross talk on the TPS/PPS lines. Manually swing throttle body open, TPS reacts as normal, but one PPS channel tracks the TPS movement. Likewise, operate pedal and it tracks as normal but one TPS channel tracks the PPS.
```

rusefillc, 2025-01-19:
related to https://github.com/rusefi/hellen154hyundai/issues/163?

rusefillc, 2025-01-19:
@Qwerty-OFF can one just remove some of these SRV in case of emergency?

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

Qwerty-OFF, 2025-01-19:
Only if no voltage higher than 5V is applied to this srv05-4.
