andreika-git/hellen-one/tests/gerber/hellen1test.pdf

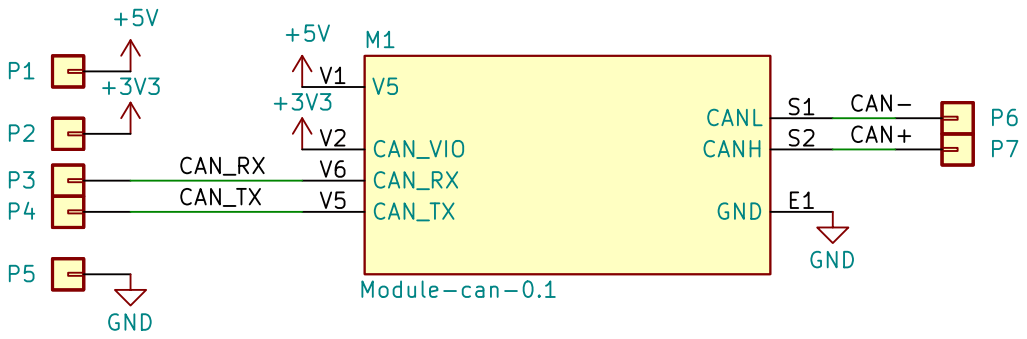
[picture p42: page 1]

File: hellen1test.kicad_sch Sheet: /
Id: 1/1 Title: Hellen-One Test Board
