andreika-git/hellen-one/modules/wbo/0.6/wbo-schematic.pdf

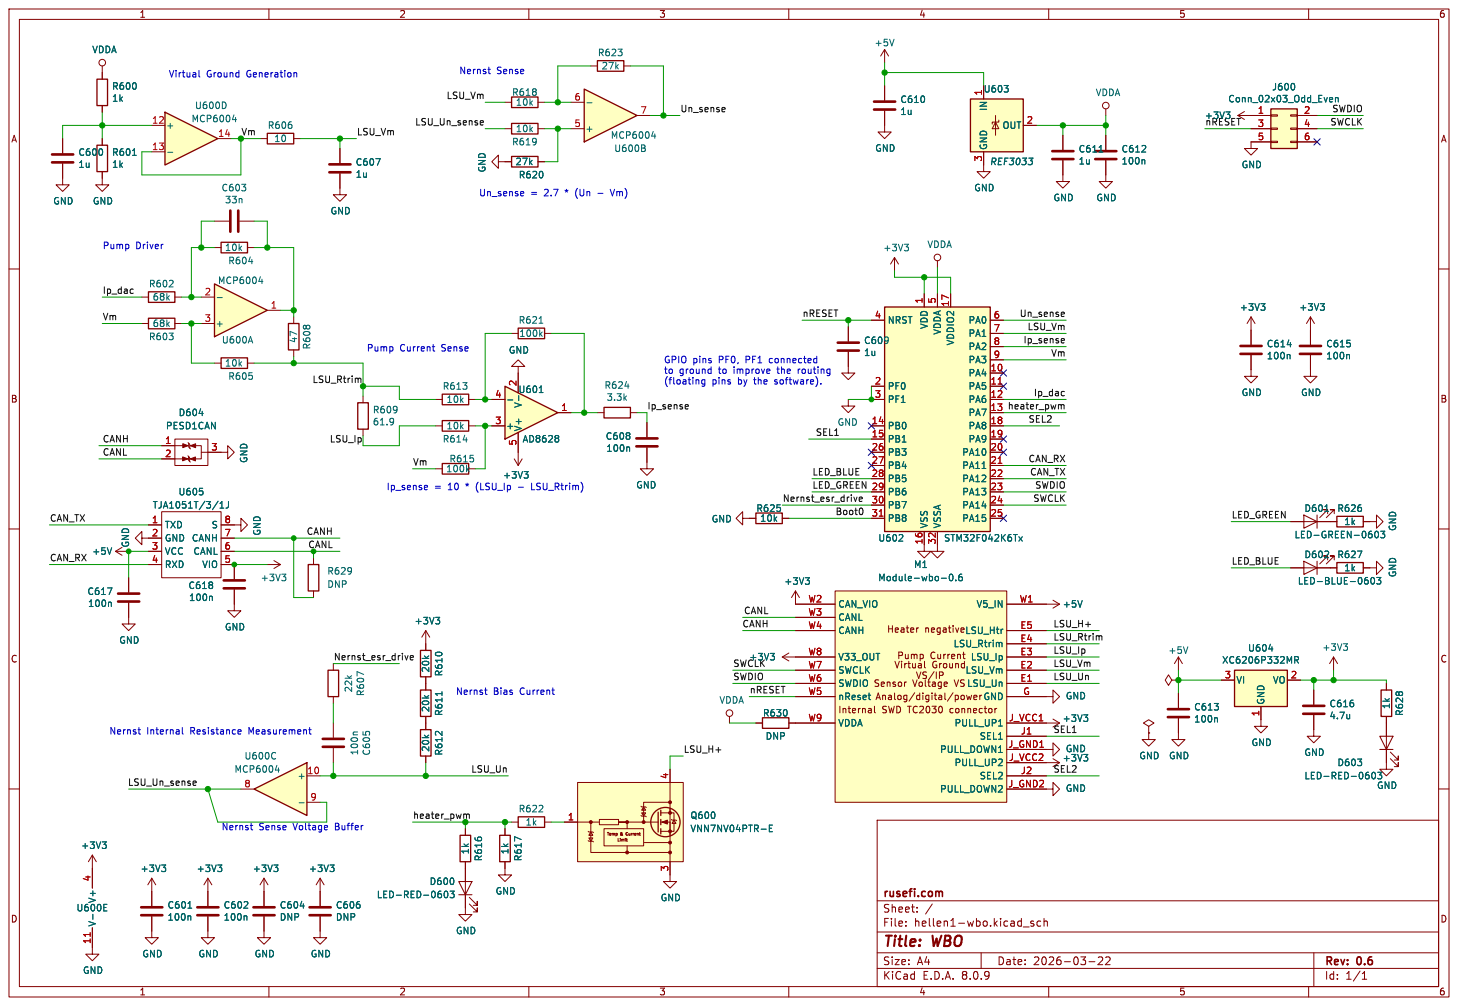
[picture p43: page 1]

1 PA4 10 PA5 11 PA6 12 PA7 13 PB0 14 PB1 15 VSS 16 VDDIO2 17 PA8 18 PA9 19 PF0 2 PA10 20 PA11 21 PA12 22 PA13 23 PA14 24 PA15 25 PB3 26 PB4 27 PB5 28 PB6 29 PF1 3 PB7 30 PB8 31 VSSA 32 NRST 4 VDDA

to ground to improve the routing

File: hellen1-wbo.kicad_sch Sheet: / rusefi.com
