andreika-git/hellen-one/modules/mega-mcu64/0.1/mega-mcu64-schematic.pdf

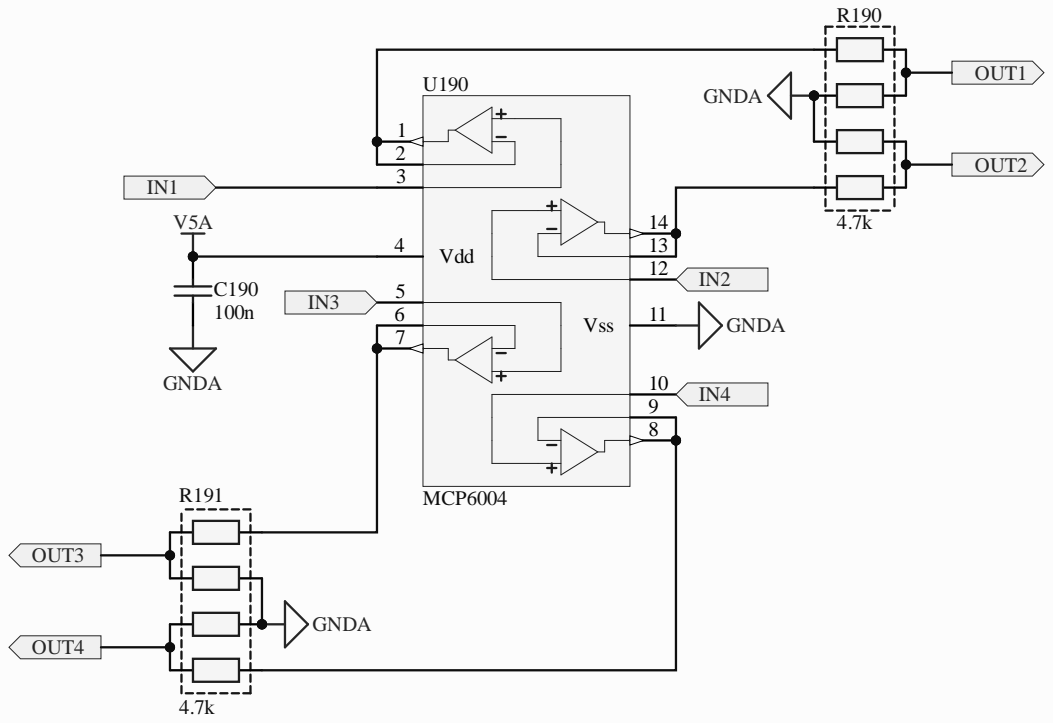
[picture p45: page 2]

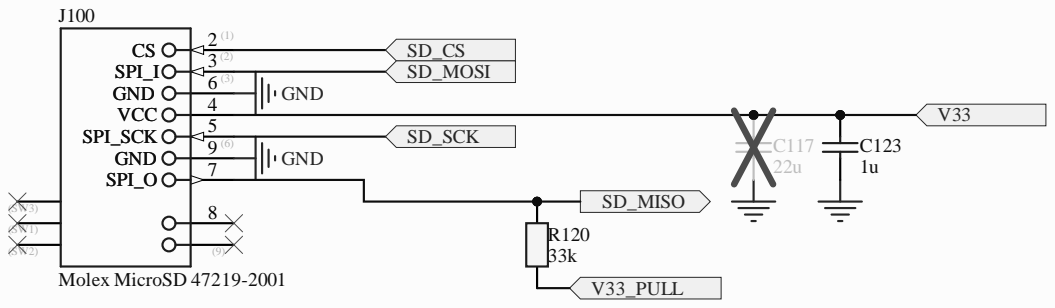
[picture p46: page 3]

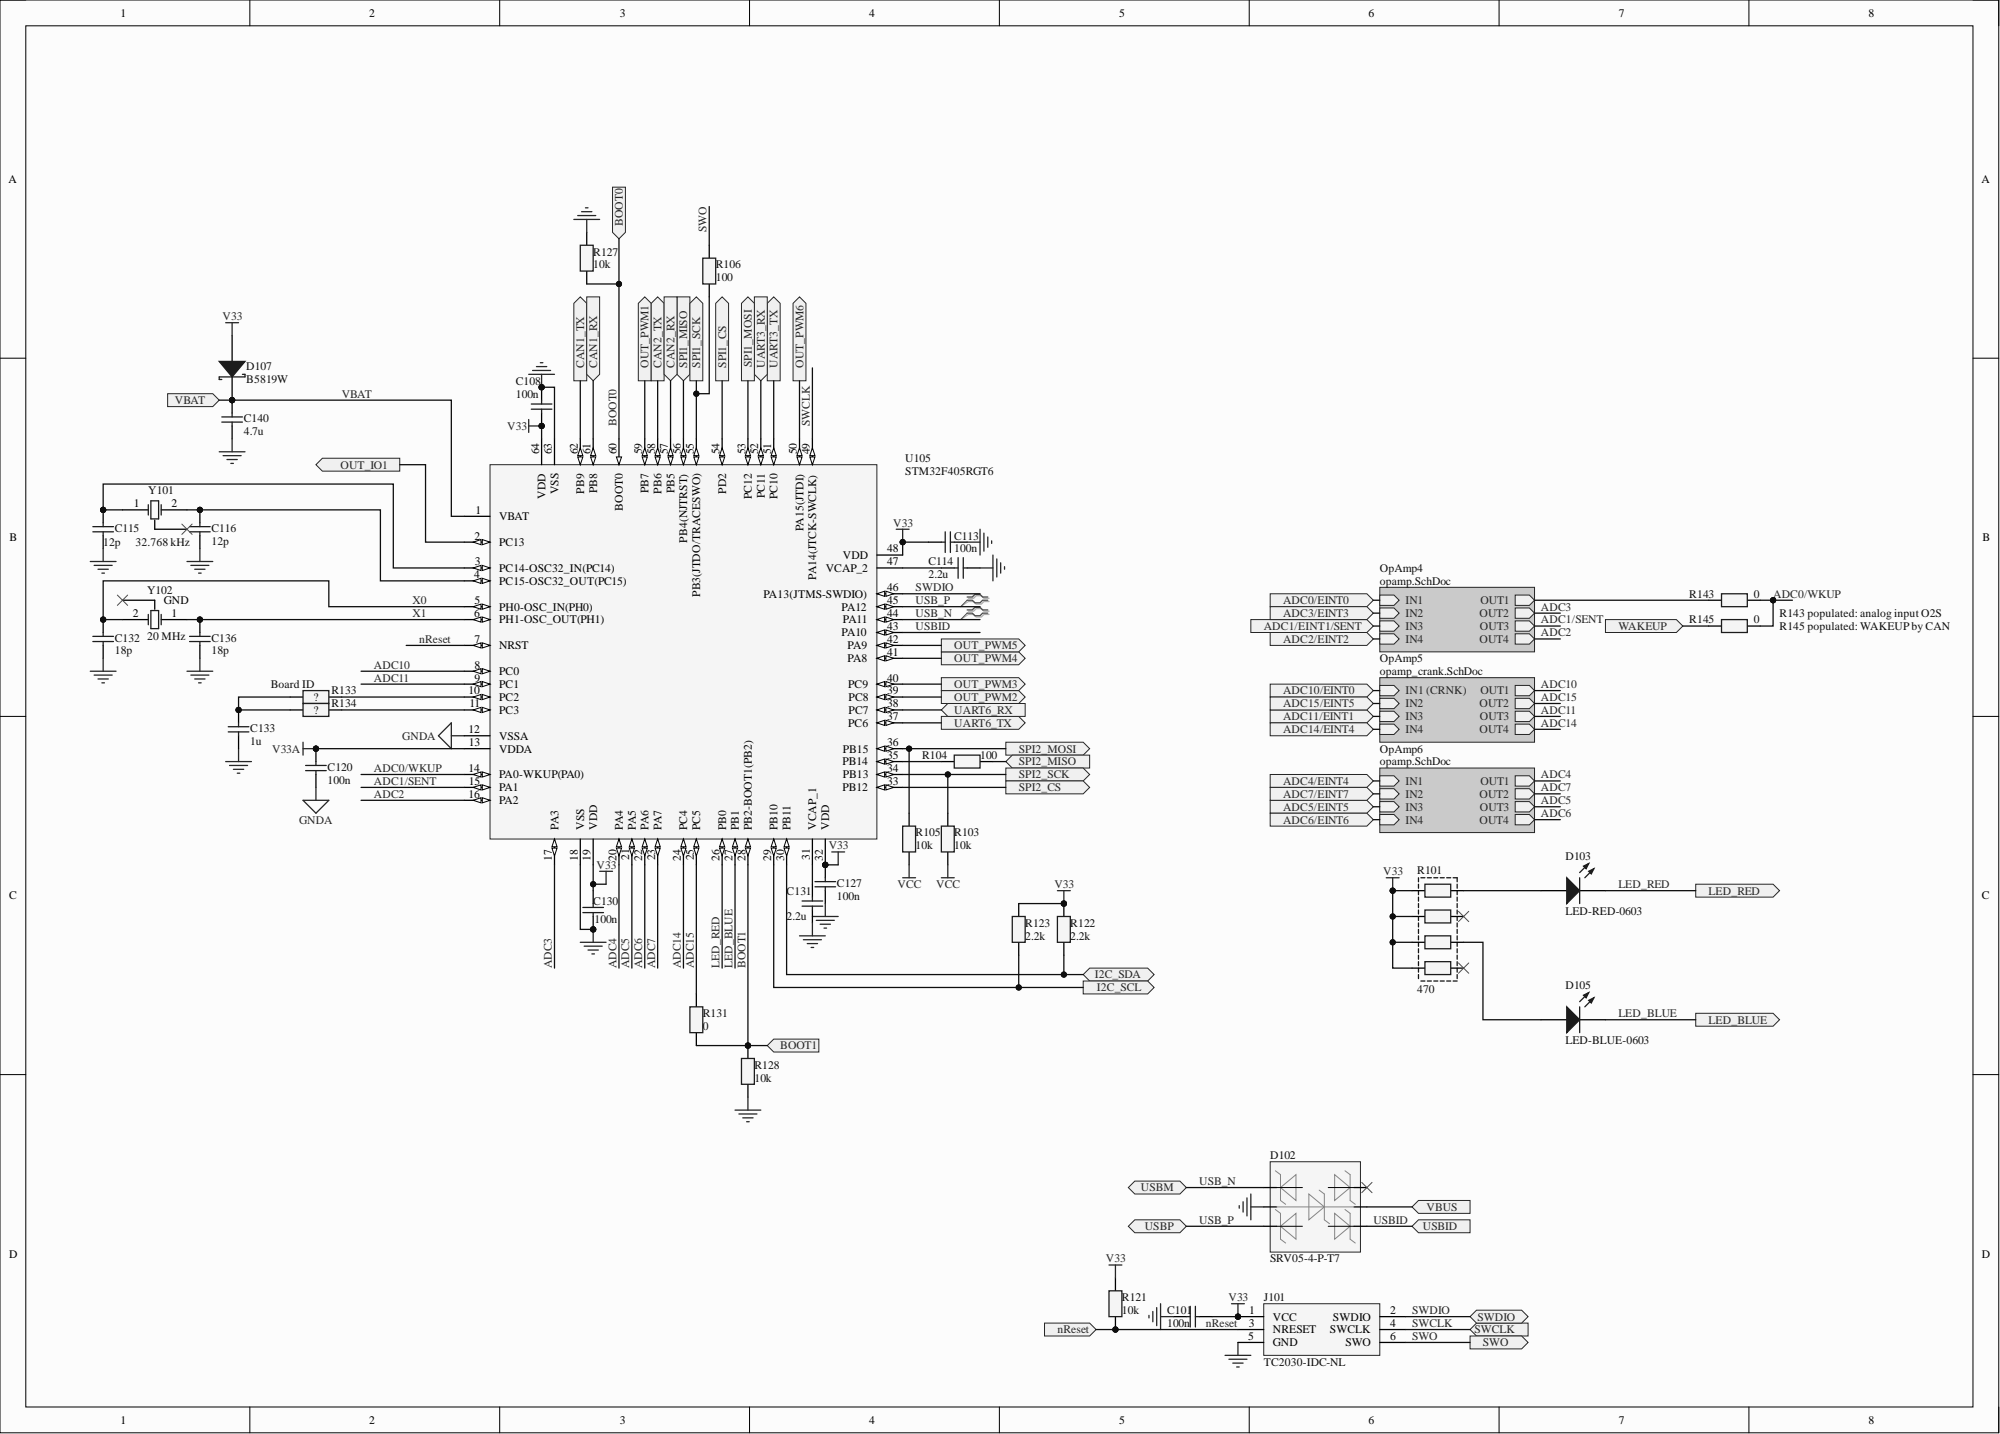
[picture p47: page 4]

PC15-OSC32_OUT(PC15) 4

Y102 | X0 | PH0-OSC_IN(PH0) 5

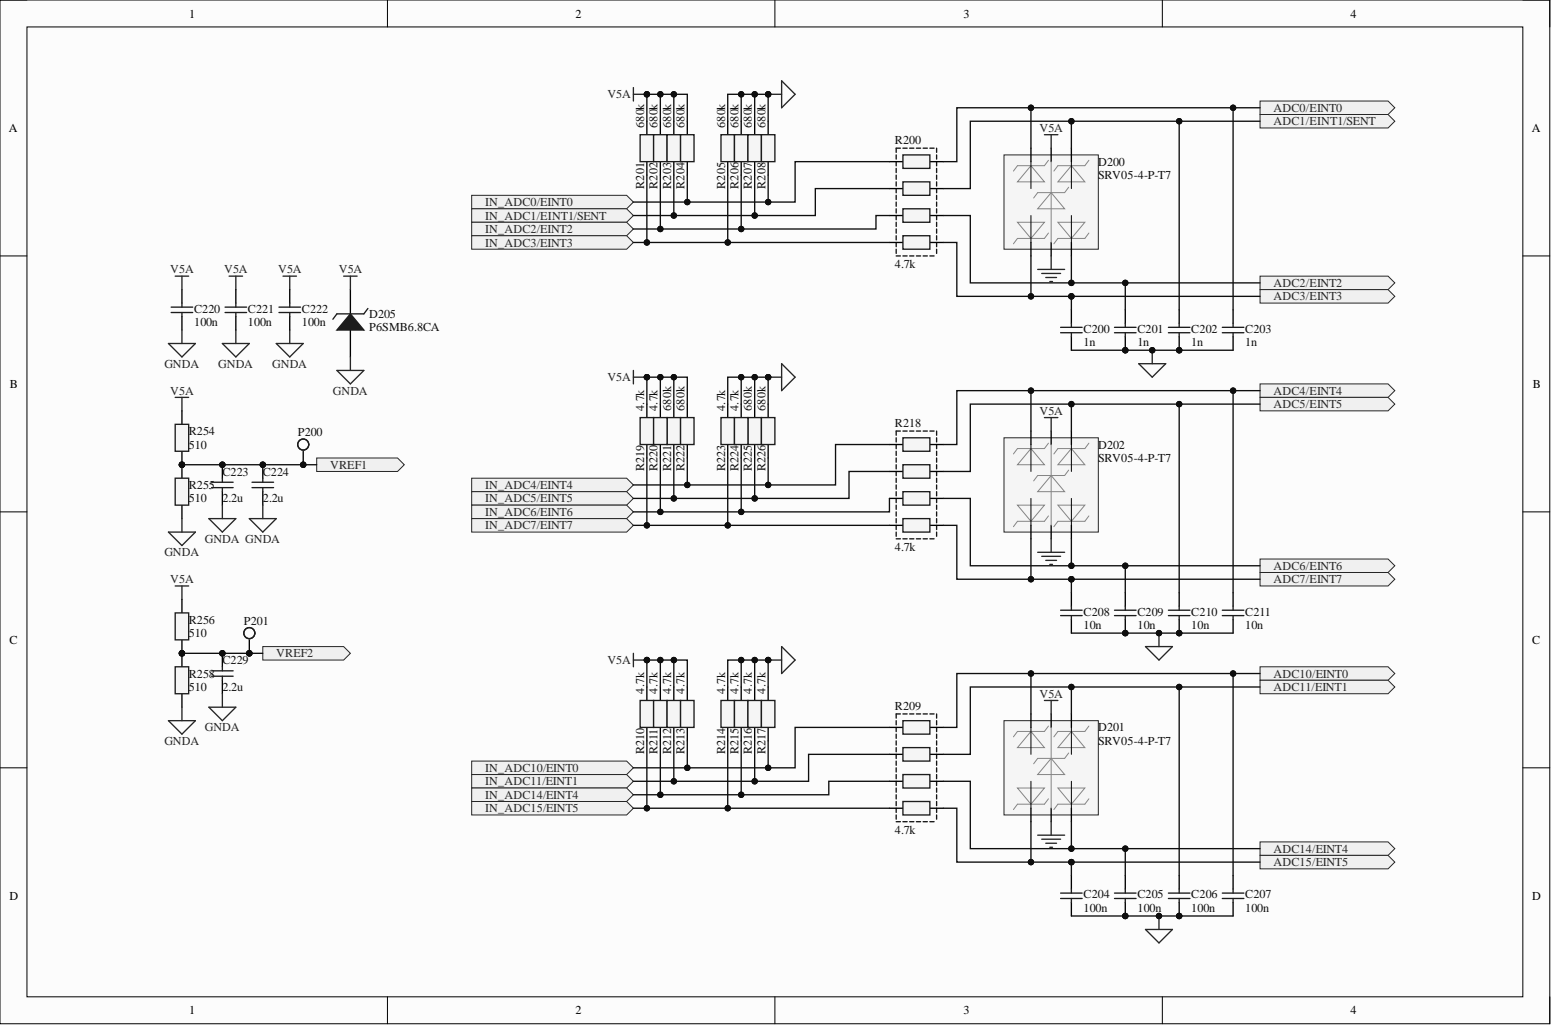
[picture p48: page 5]

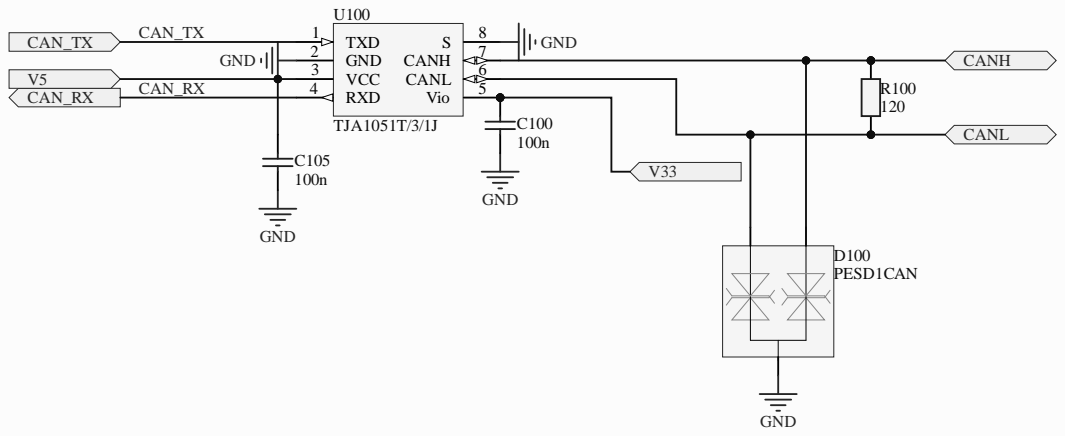
[picture p49: page 6]

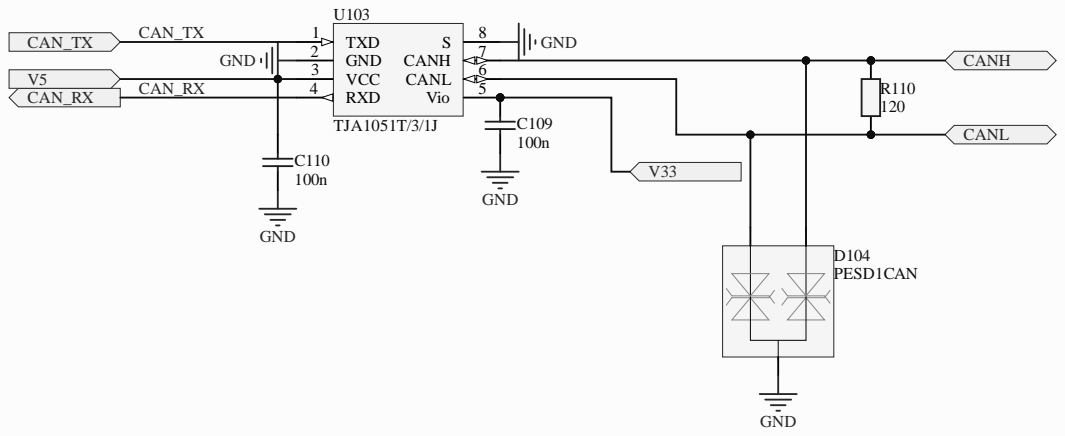
[picture p50: page 7]

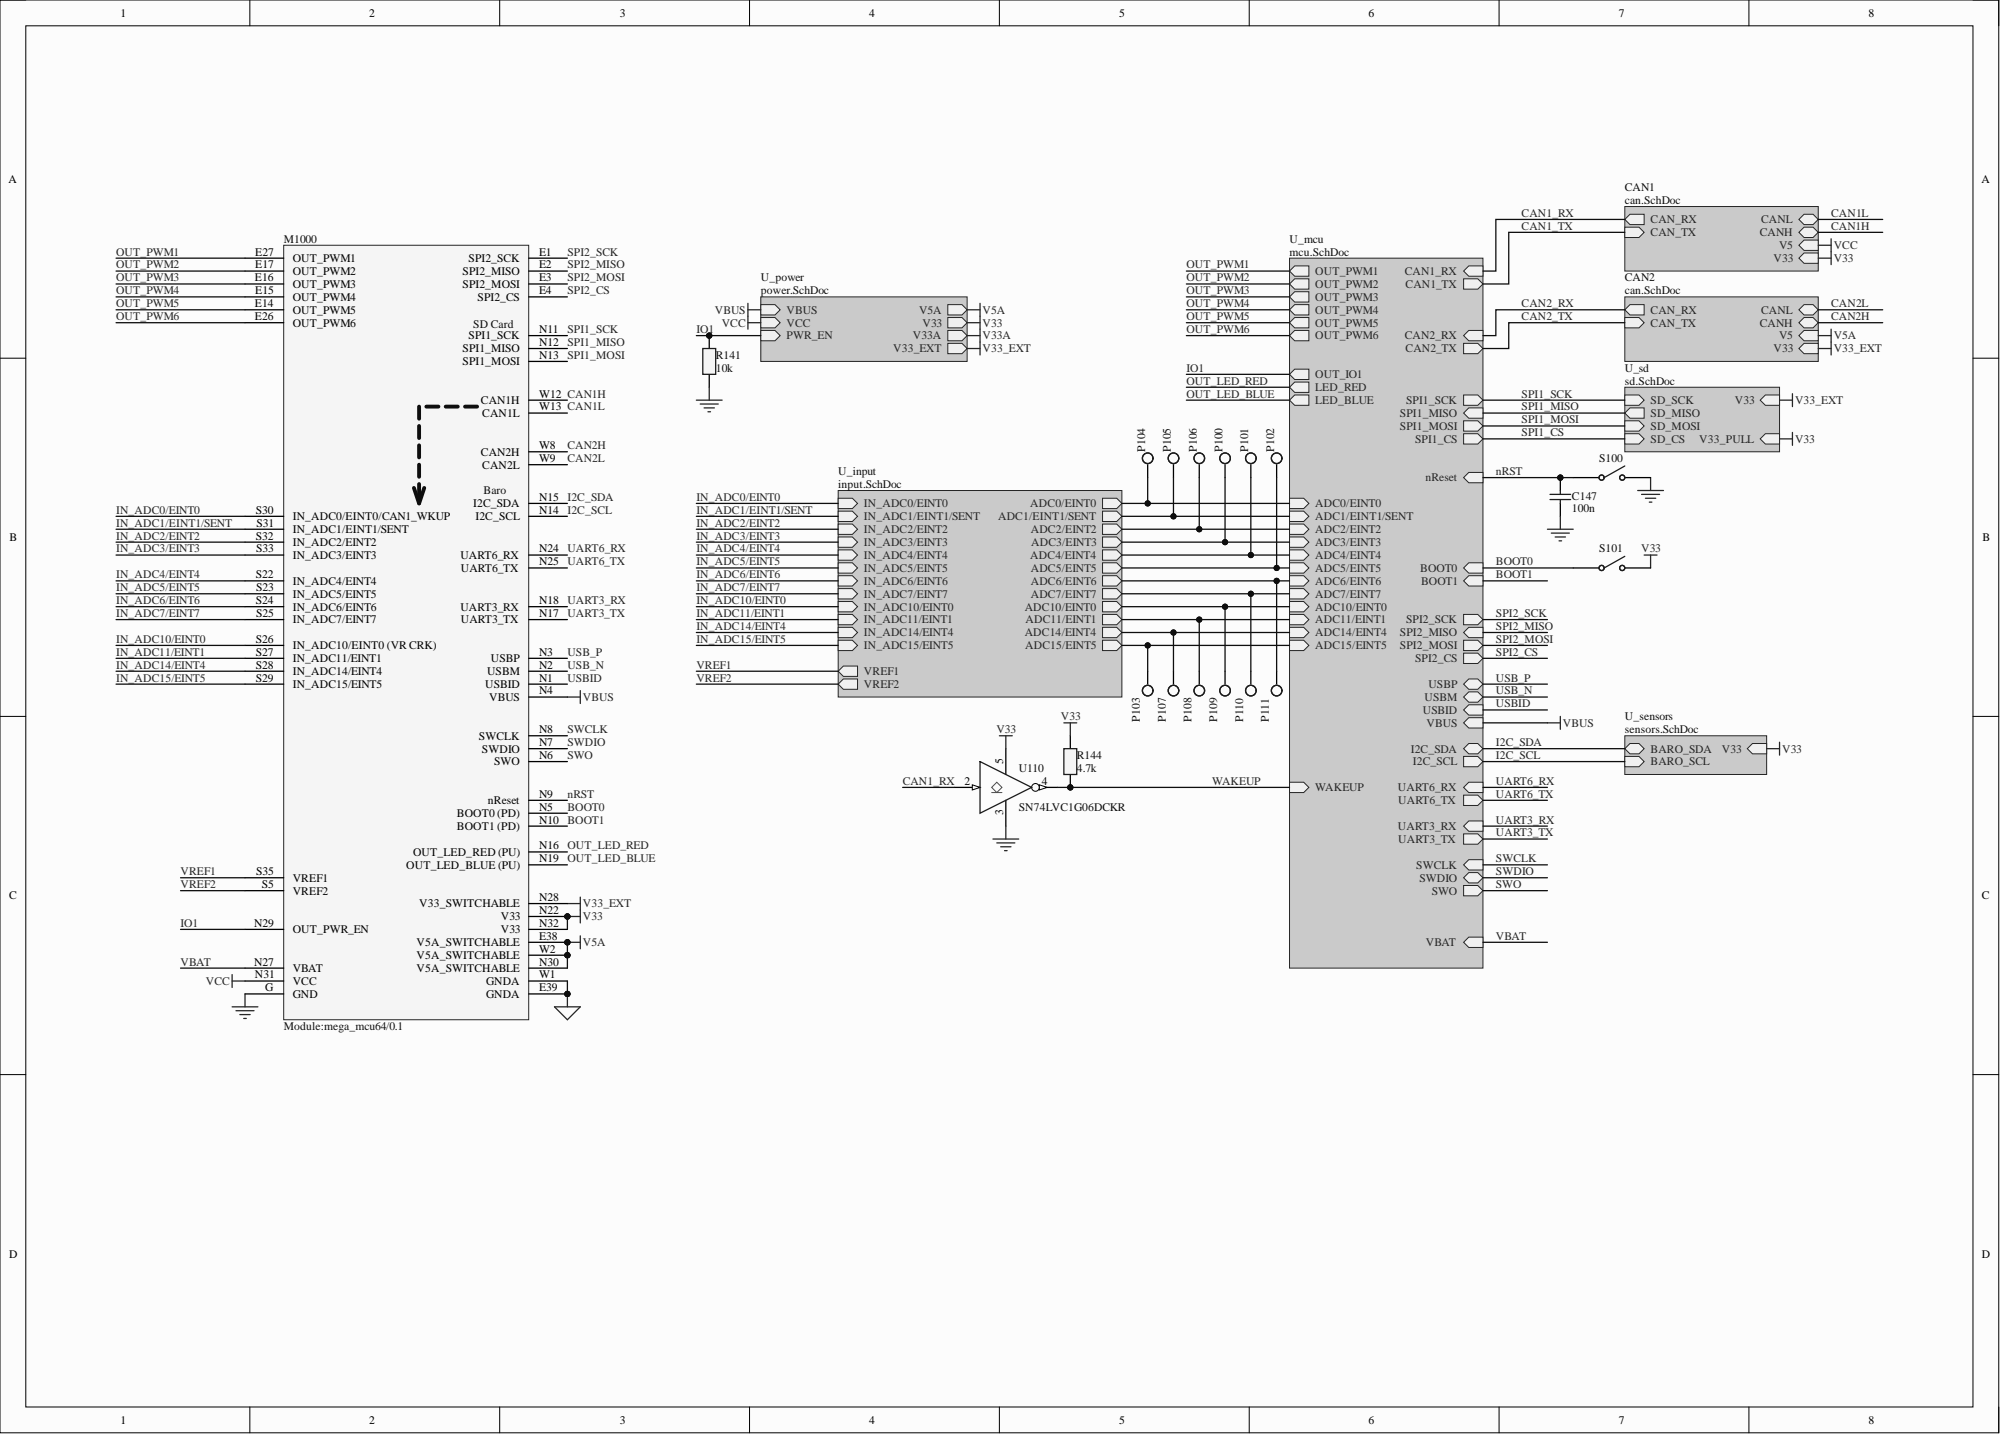
[picture p51: page 8]

USBM USBP USBID VBUS


More accurate threshold for "raw" connection of VR sensors

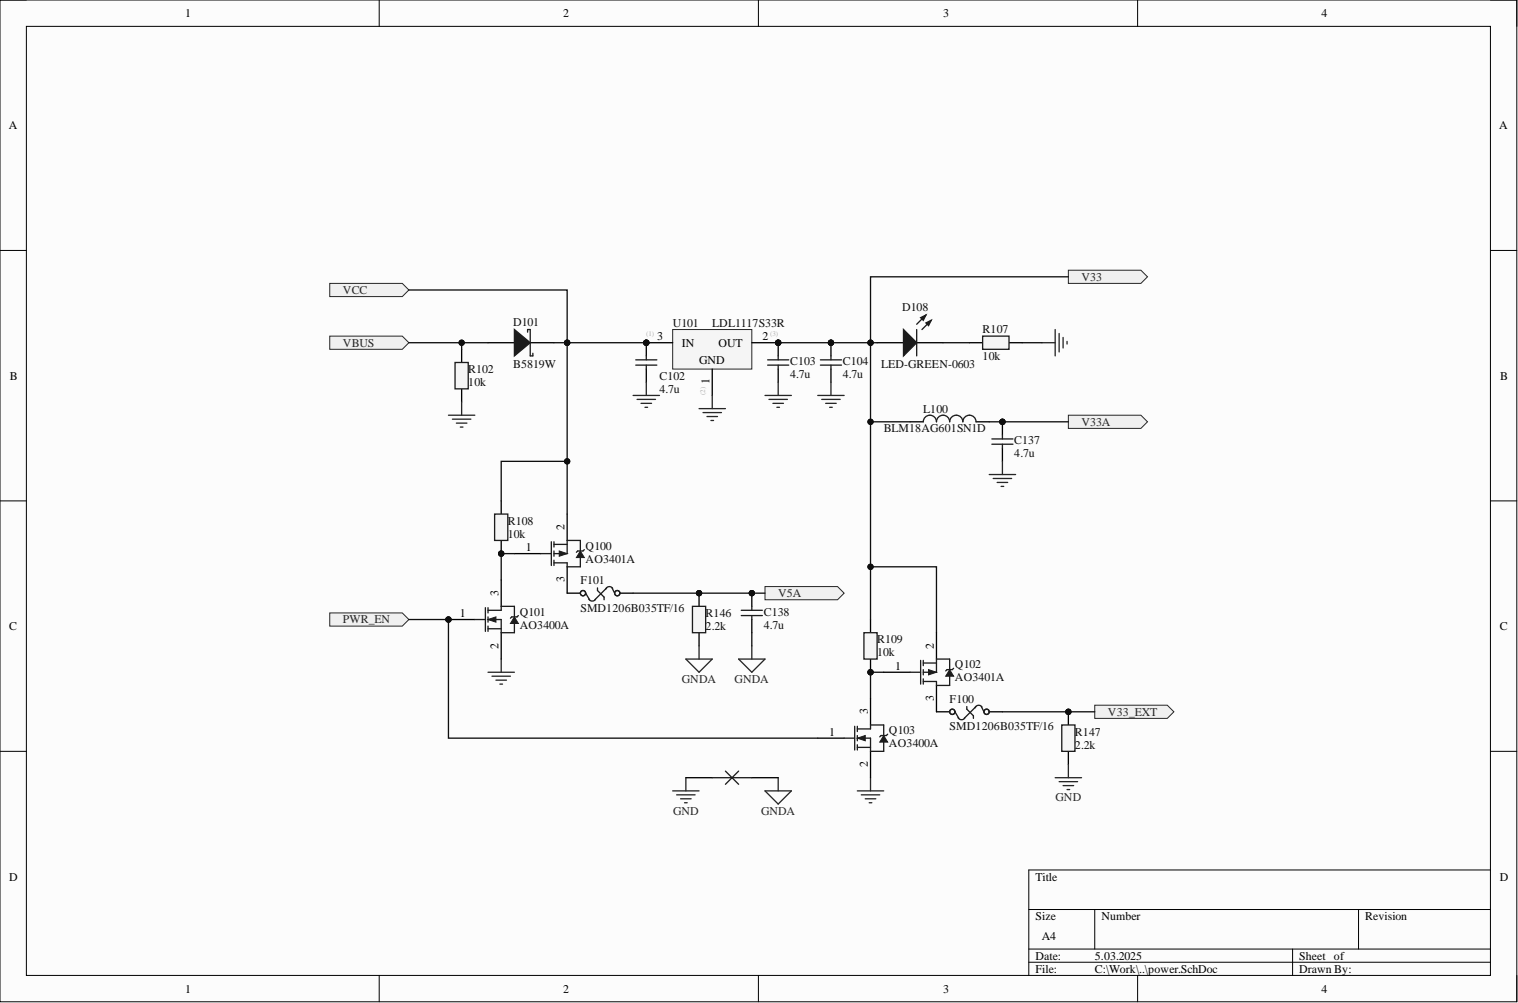
[picture p53: page 10]

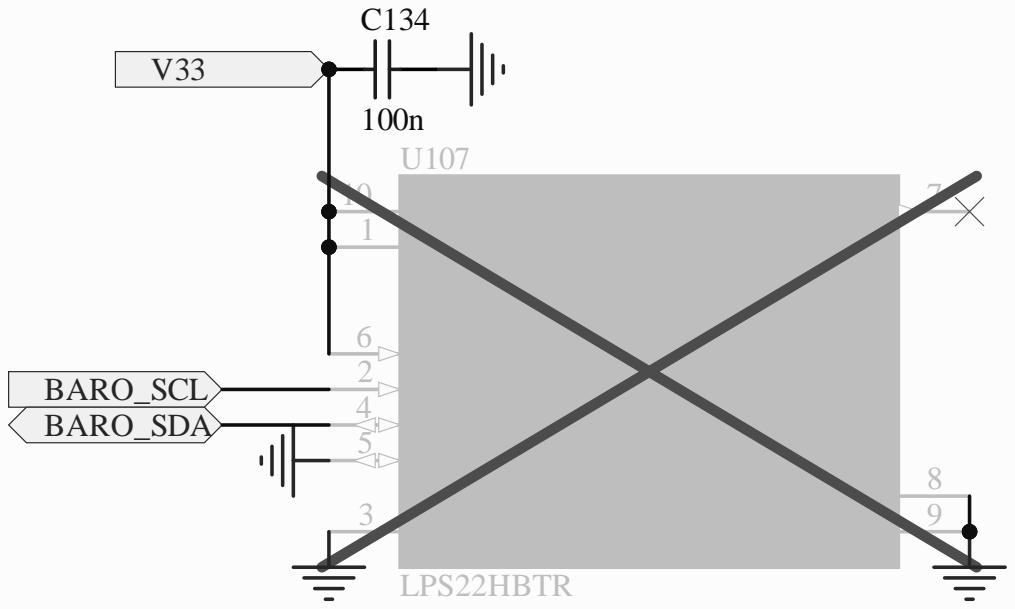
[picture p54: page 11]
