andreika-git/hellen-one/modules/mega-mcu100/0.3/mega-mcu100-schematic.pdf

R143 populated: analog input O2S
R145 populated: WAKEUP by CAN

*VIGN input is unprotected!
*A21 is duplicated for ADC and EINT


See pullups replacement file for actual values



See pullups replacement file for actual values



USBM USBP USBID VBUS


More accurate threshold for "raw" connection of VR sensors
