andreika-git/hellen-one/modules/power_12and5V/0.3/power_12and5V-schematic.pdf

Hellen One : Power-Module interface

Reverse polarity and overvoltage protection
F410 V12_RAW

OUT | 1 IN 8
EN 7
