andreika-git/hellen-one/modules/mcz33810/0.1/mcz33810-schematic.pdf

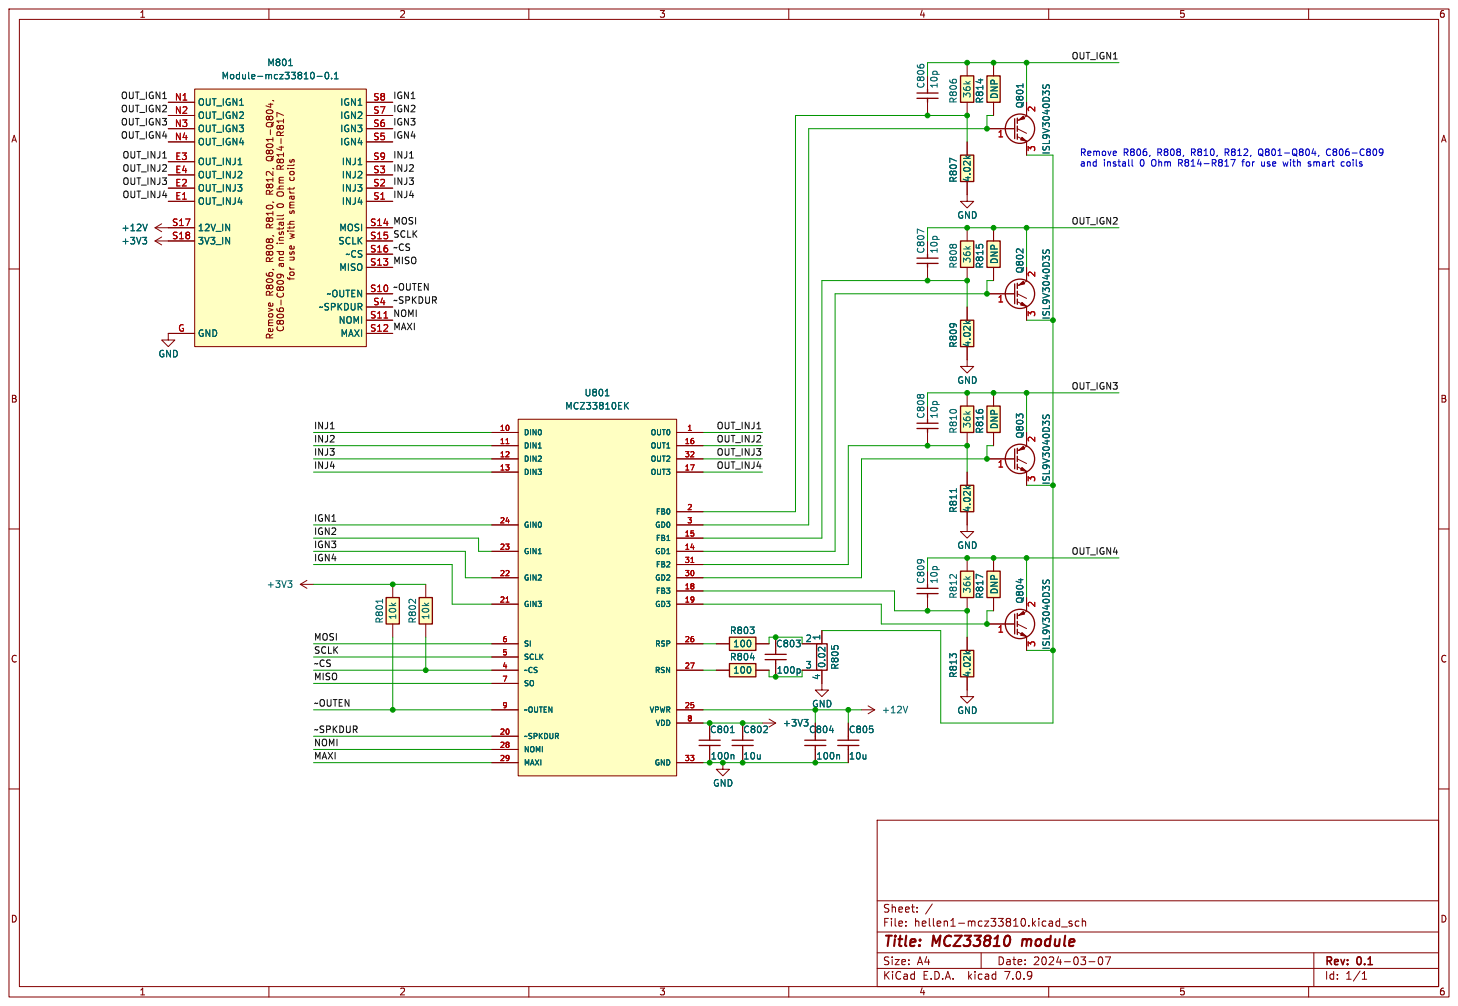
[picture p66: page 1]

C806-C809 and install 0 Ohm R814-R817 for use with smart coils GND G

IGN2
IGN3 SCLK MOSI
IGN4 NOMI MAXI ~SPKDUR MISO
