andreika-git/hellen-one/modules/vr-discrete/0.5/vr-discrete-schematic.pdf

Id: 1/1 Title: File: hellen1-vr-discrete.kicad_sch Sheet: /
