andreika-git/hellen-one/modules/vr-max9924/0.1/vr-max9924-schematic.pdf

File: hellen1-vr-max9924.kicad_sch Sheet: /
Id: 1/1 Title: VR MAX9924 module
