andreika-git/hellen-one/modules/uaefi/0.2/uaefi-schematic.pdf

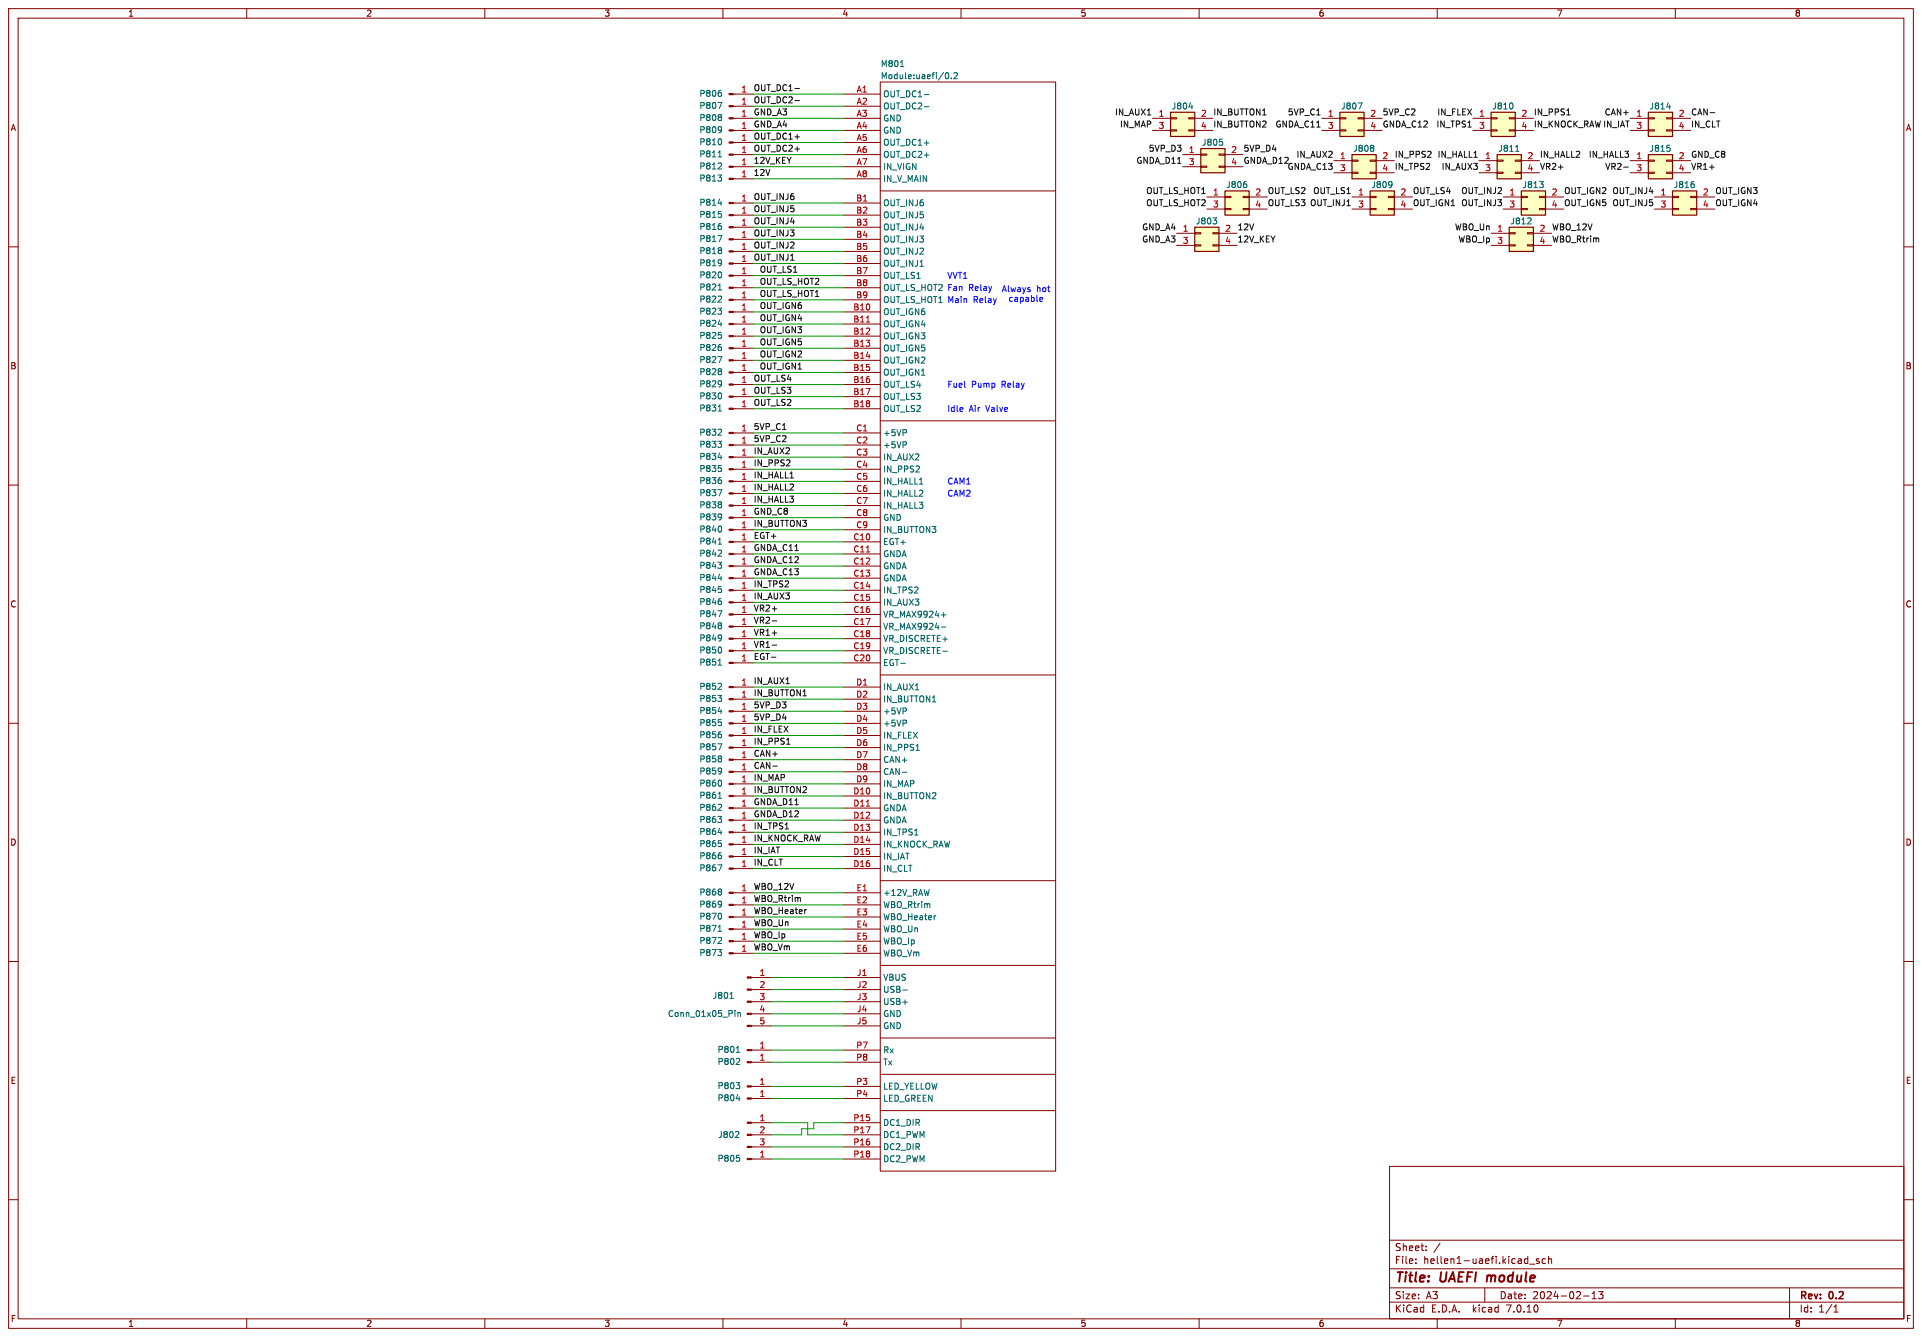
[picture p69: page 1]

IN_VIGN A7
Idle Air Valve Main Relay VVT1
capable CAM1 CAM2 Fan Relay Fuel Pump Relay

Id: 1/1 Title: UAEFI module
