andreika-git/hellen-one/modules/output/0.3/output-schematic.pdf

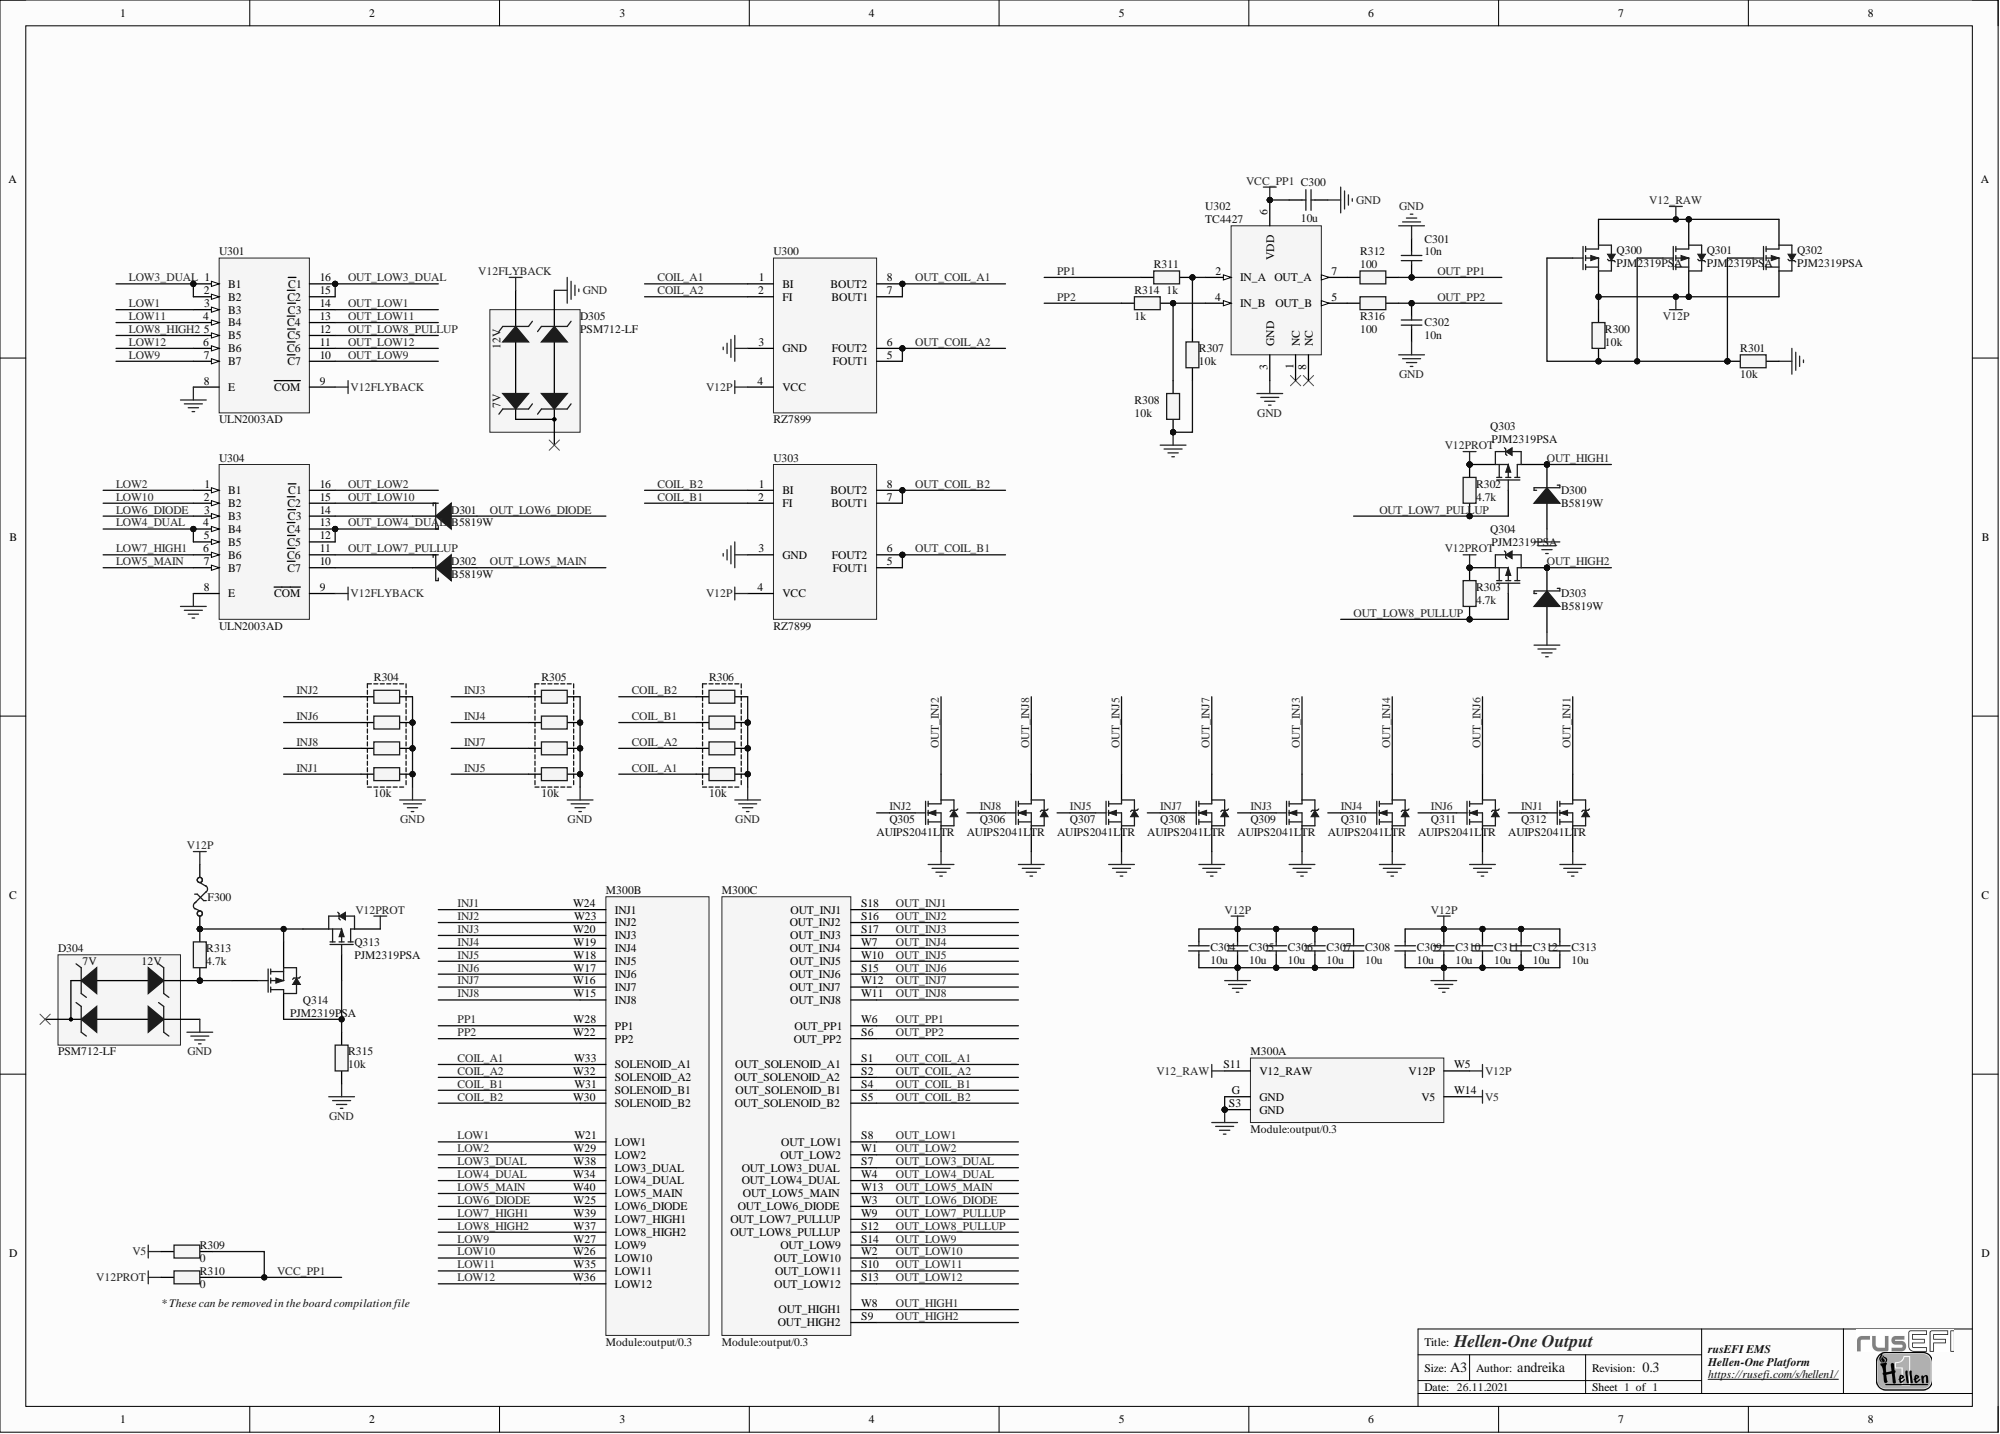
[picture p70: page 1]

* These can be removed in the board compilation file
