andreika-git/hellen-one/modules/vr/0.1/vr-schematic.pdf

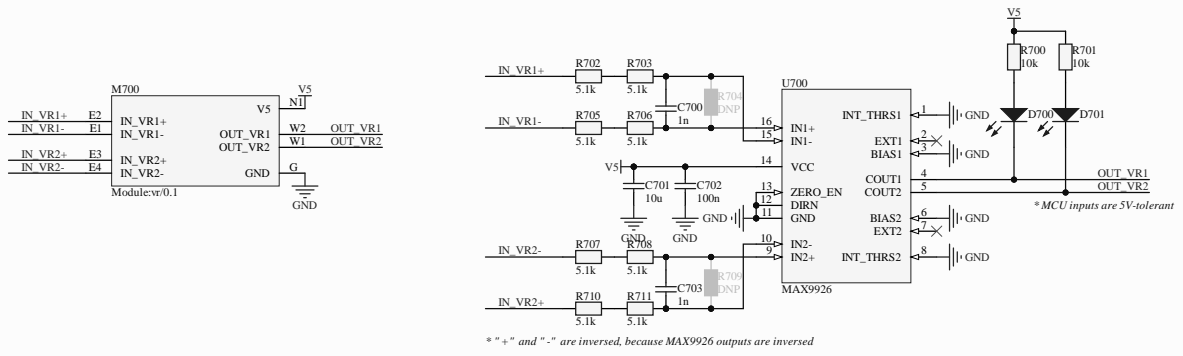
[picture p71: page 1]

* MCU inputs are 5V-tolerant

* " +" and " -" are inversed, because MAX9926 outputs are inversed
