andreika-git/hellen-one/tests/boards.EXAMPLE/hellen1test-a/board/hellen1test-a-schematic.pdf

D Date: 2022-05-17 KiCad E.D.A. kicad (6.0.1) Size: A4; Rev: A; GND E1 CANL S1 CANH S2 V5 V1 CAN_VIO V2 CAN_TX V5 CAN_RX V6 M1Module-can-0.1 +3V3 P2P3; GND; P7P6 CAN+ CAN- CAN_RX CAN_TX; https://rusefi.com/; https://github.com/andreika-git/hellen-one/wiki

File: hellen1test.kicad_sch Sheet: /
Id: 1/1 Title: Hellen-One Test Board

andreika; Size:; Author:; Date:; Revision:; Sheet; PESD1CAN; GND; CANH; CANL; TXD 1 GND 2 VCC 3; Vio; 5 RXD 4; 6 CANH; TJA1051T/3/1J; CANH CANL; CAN_TX; CAN_RX; CAN_VIO; CAN_VIO V2; S2 CANL; CAN_TX V5; CAN_RX V6; Module:can/0.1

Hellen-One CAN
Title:

rusEFI EMS
Hellen-One Platform
https://rusefi.com/s/hellen72
