andreika-git/hellen-one/kicad/modules/hellen1-vr-discrete/gerber/hellen1-vr-discrete.pdf

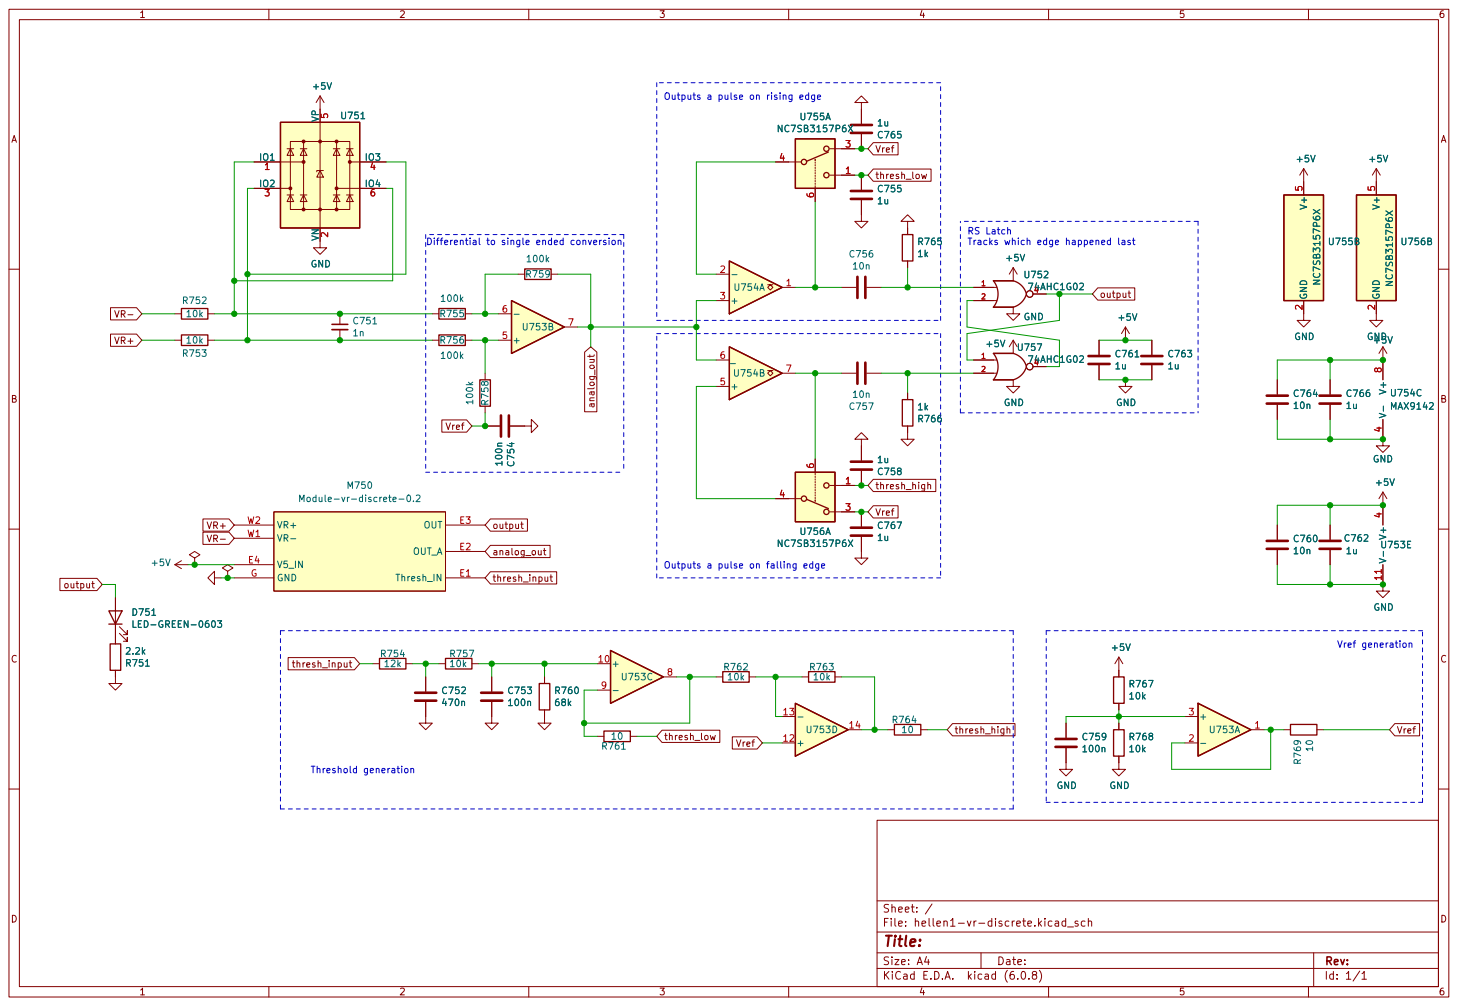
[picture p73: page 1]

Outputs a pulse on rising edge

Differential to single ended conversion

File: hellen1-vr-discrete.kicad_sch Sheet: /
Id: 1/1 Title:
