andreika-git/hellen-one/modules/mega-mcu144/0.7/mega-mcu144-schematic.pdf

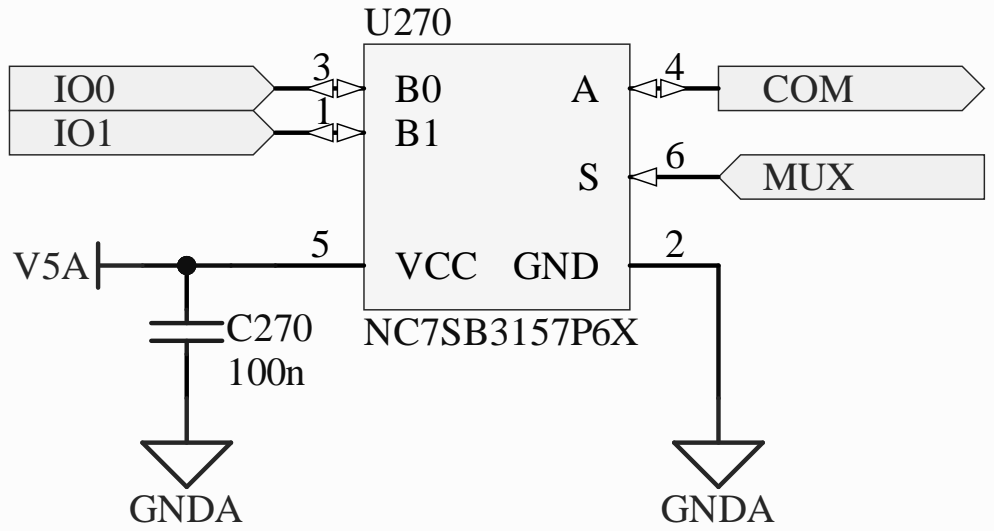
[picture p75: page 2]


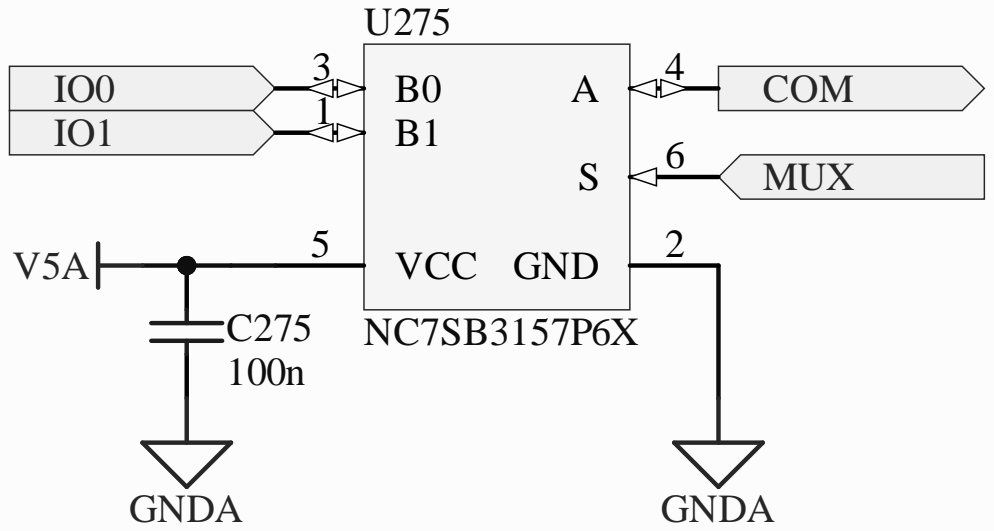
[picture p77: page 4]


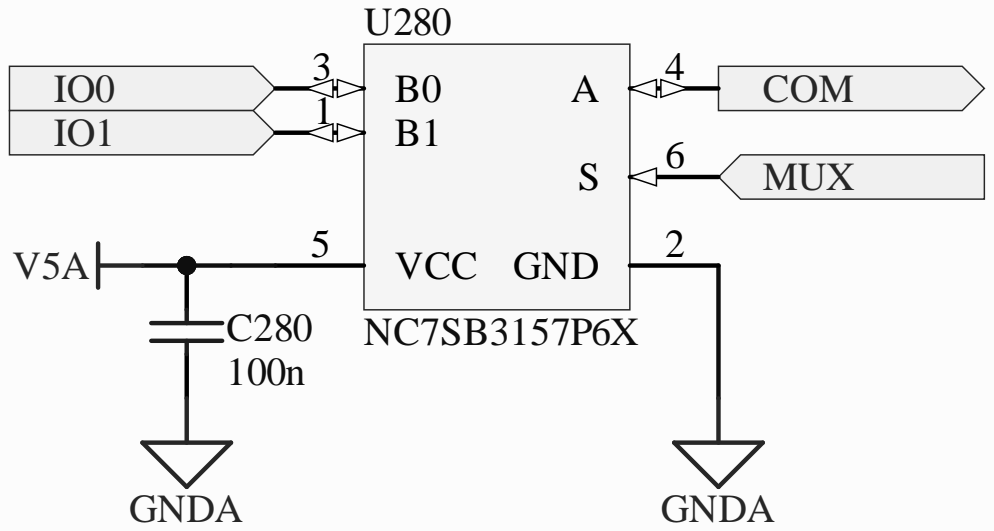
[picture p78: page 6]


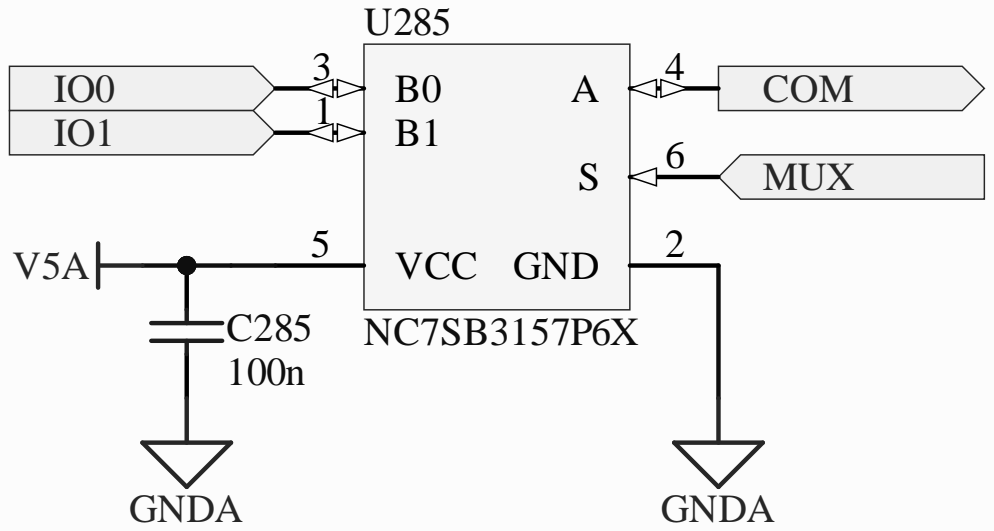
[picture p79: page 8]




R143 populated: analog input O2S
R145 populated: WAKEUP by CAN

D5 *D5 is digital-only on F429! (EINT11)

*VIGN input is unprotected!






USBM USBP USBID VBUS


More accurate threshold for "raw" connection of VR sensors
