andreika-git/hellen-one/modules/motor-driver/0.1/motor-driver-schematic.pdf

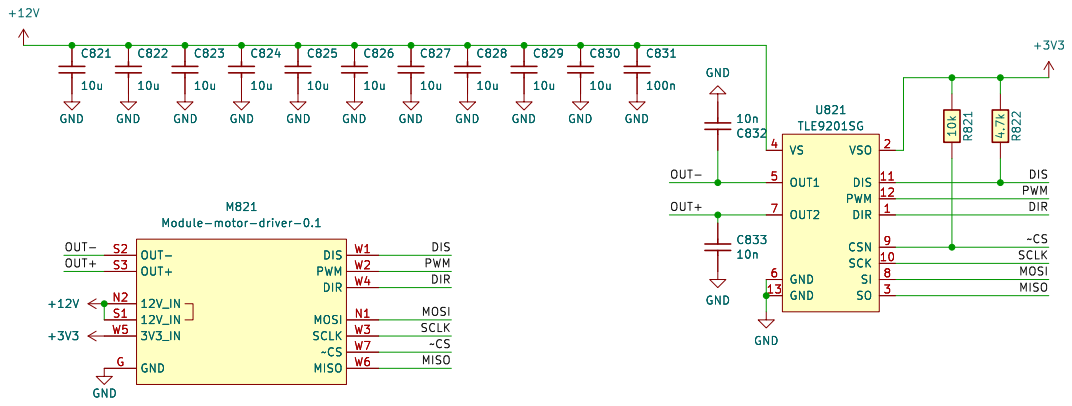
[picture p86: page 1]
