andreika-git/hellen-one/modules/vr-max9924/0.3/vr-max9924-schematic.pdf

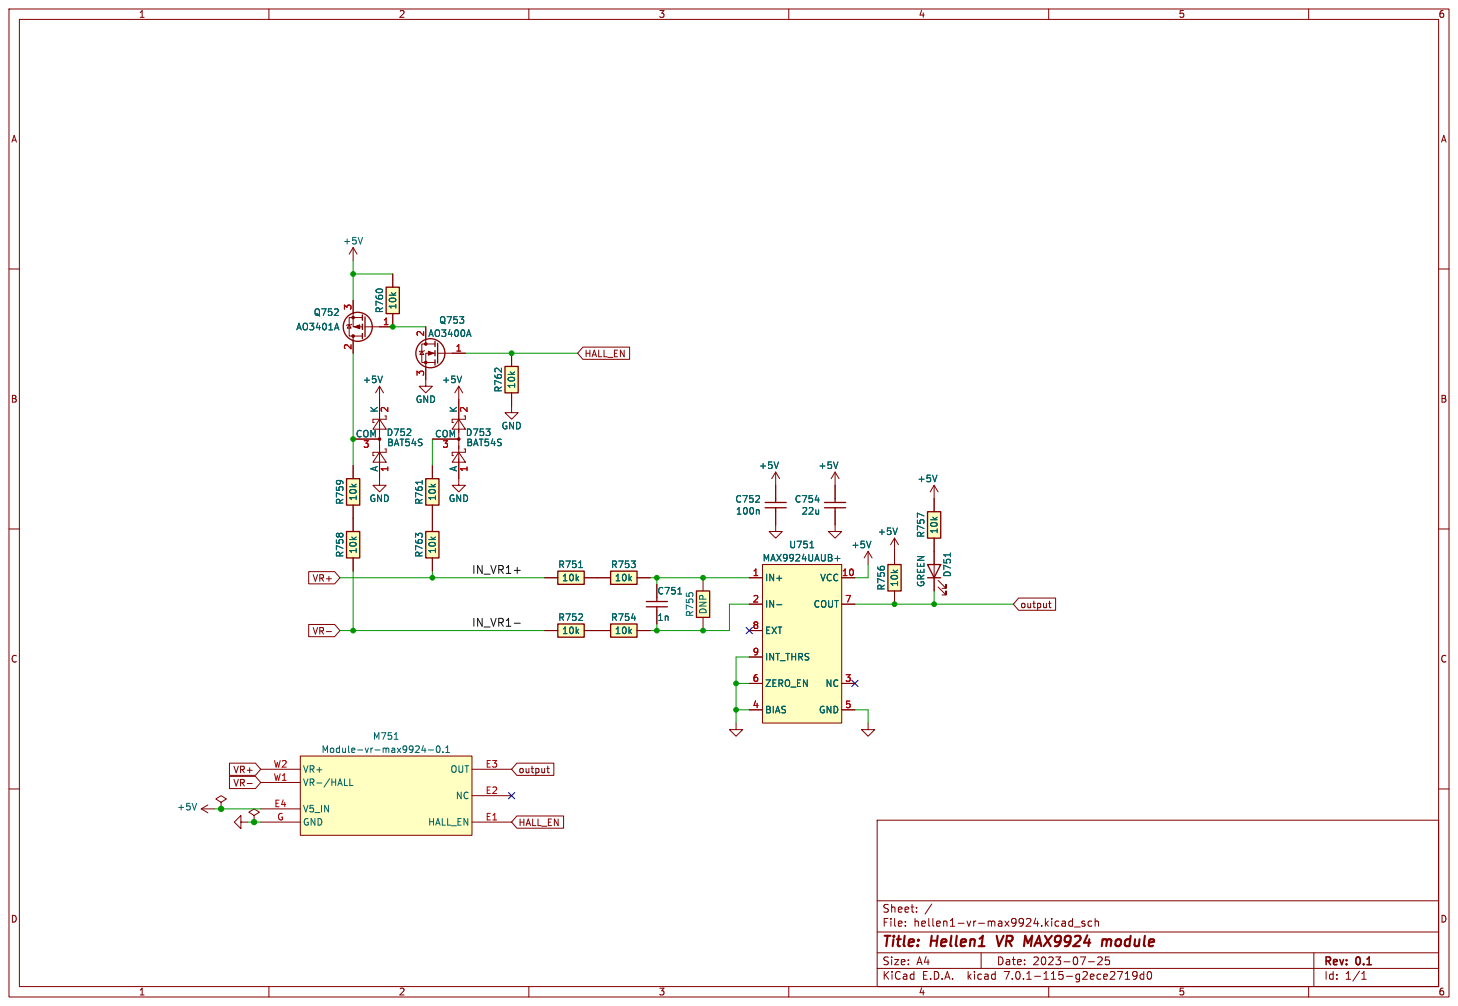
[picture p87: page 1]

Id: 1/1 Title: Hellen1 VR MAX9924 module
