andreika-git/hellen-one/modules/mcu/0.7/mcu-schematic.pdf

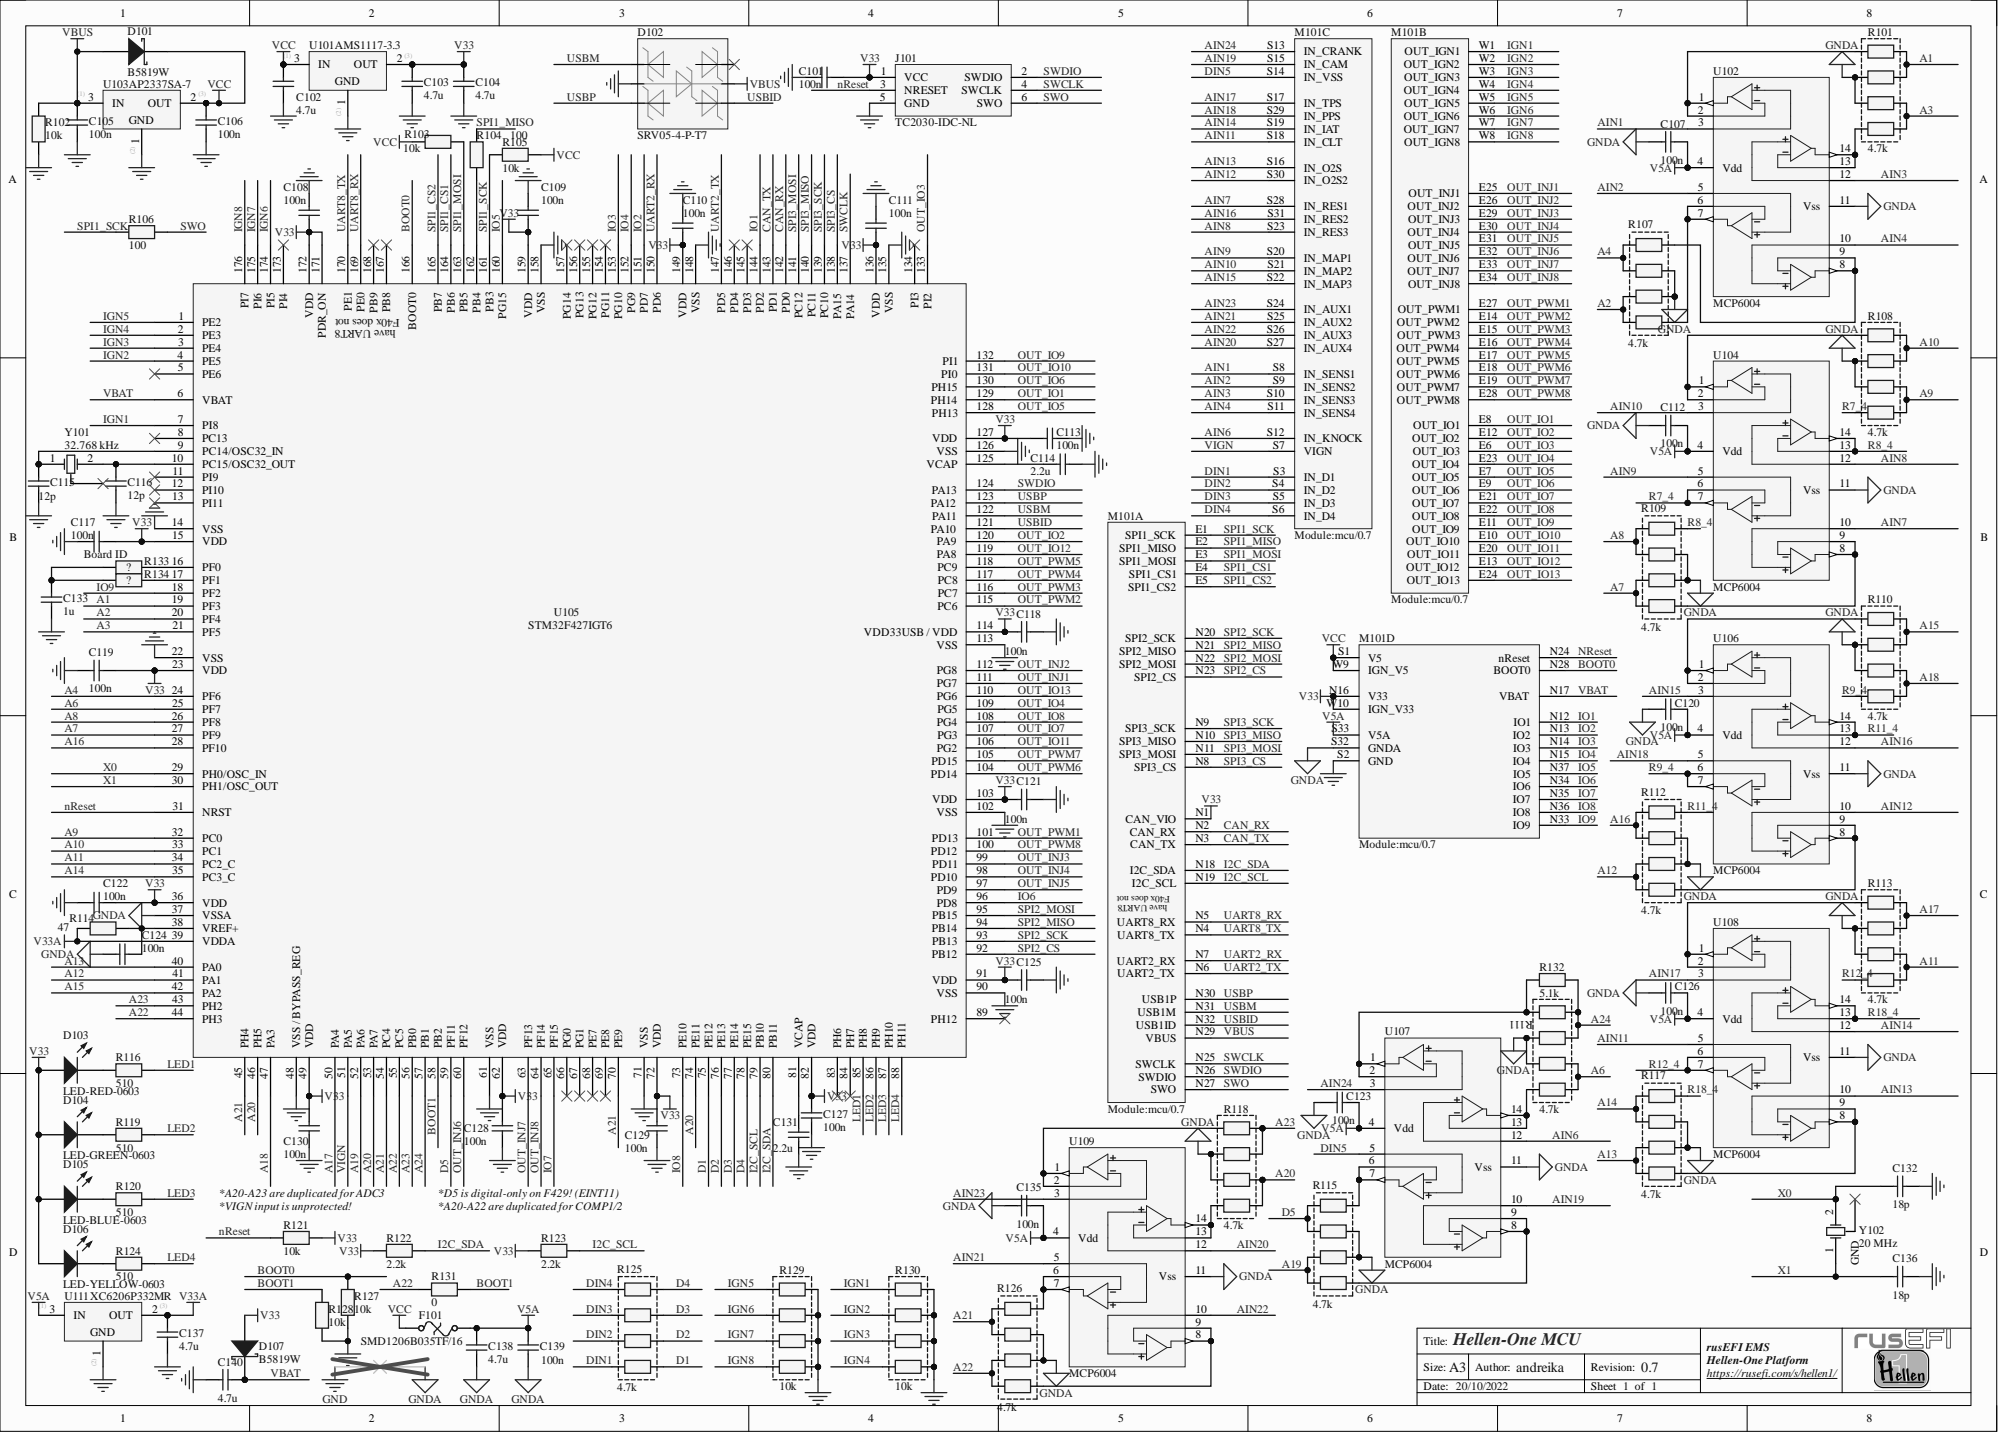
[picture p89: page 1]

VSSA 37 | SPI2_MOSI
VREF+ 38 | SPI2_MISO
C124 | | VDDA 39 | SPI2_SCK
PA0 40 | SPI2_CS

D5 *D5 is digital-only on F429! (EINT11)

*A20-A23 are duplicated for ADC3
*VIGN input is unprotected!
