andreika-git/hellen-one/modules/mcu144/0.7/mcu144-schematic.pdf

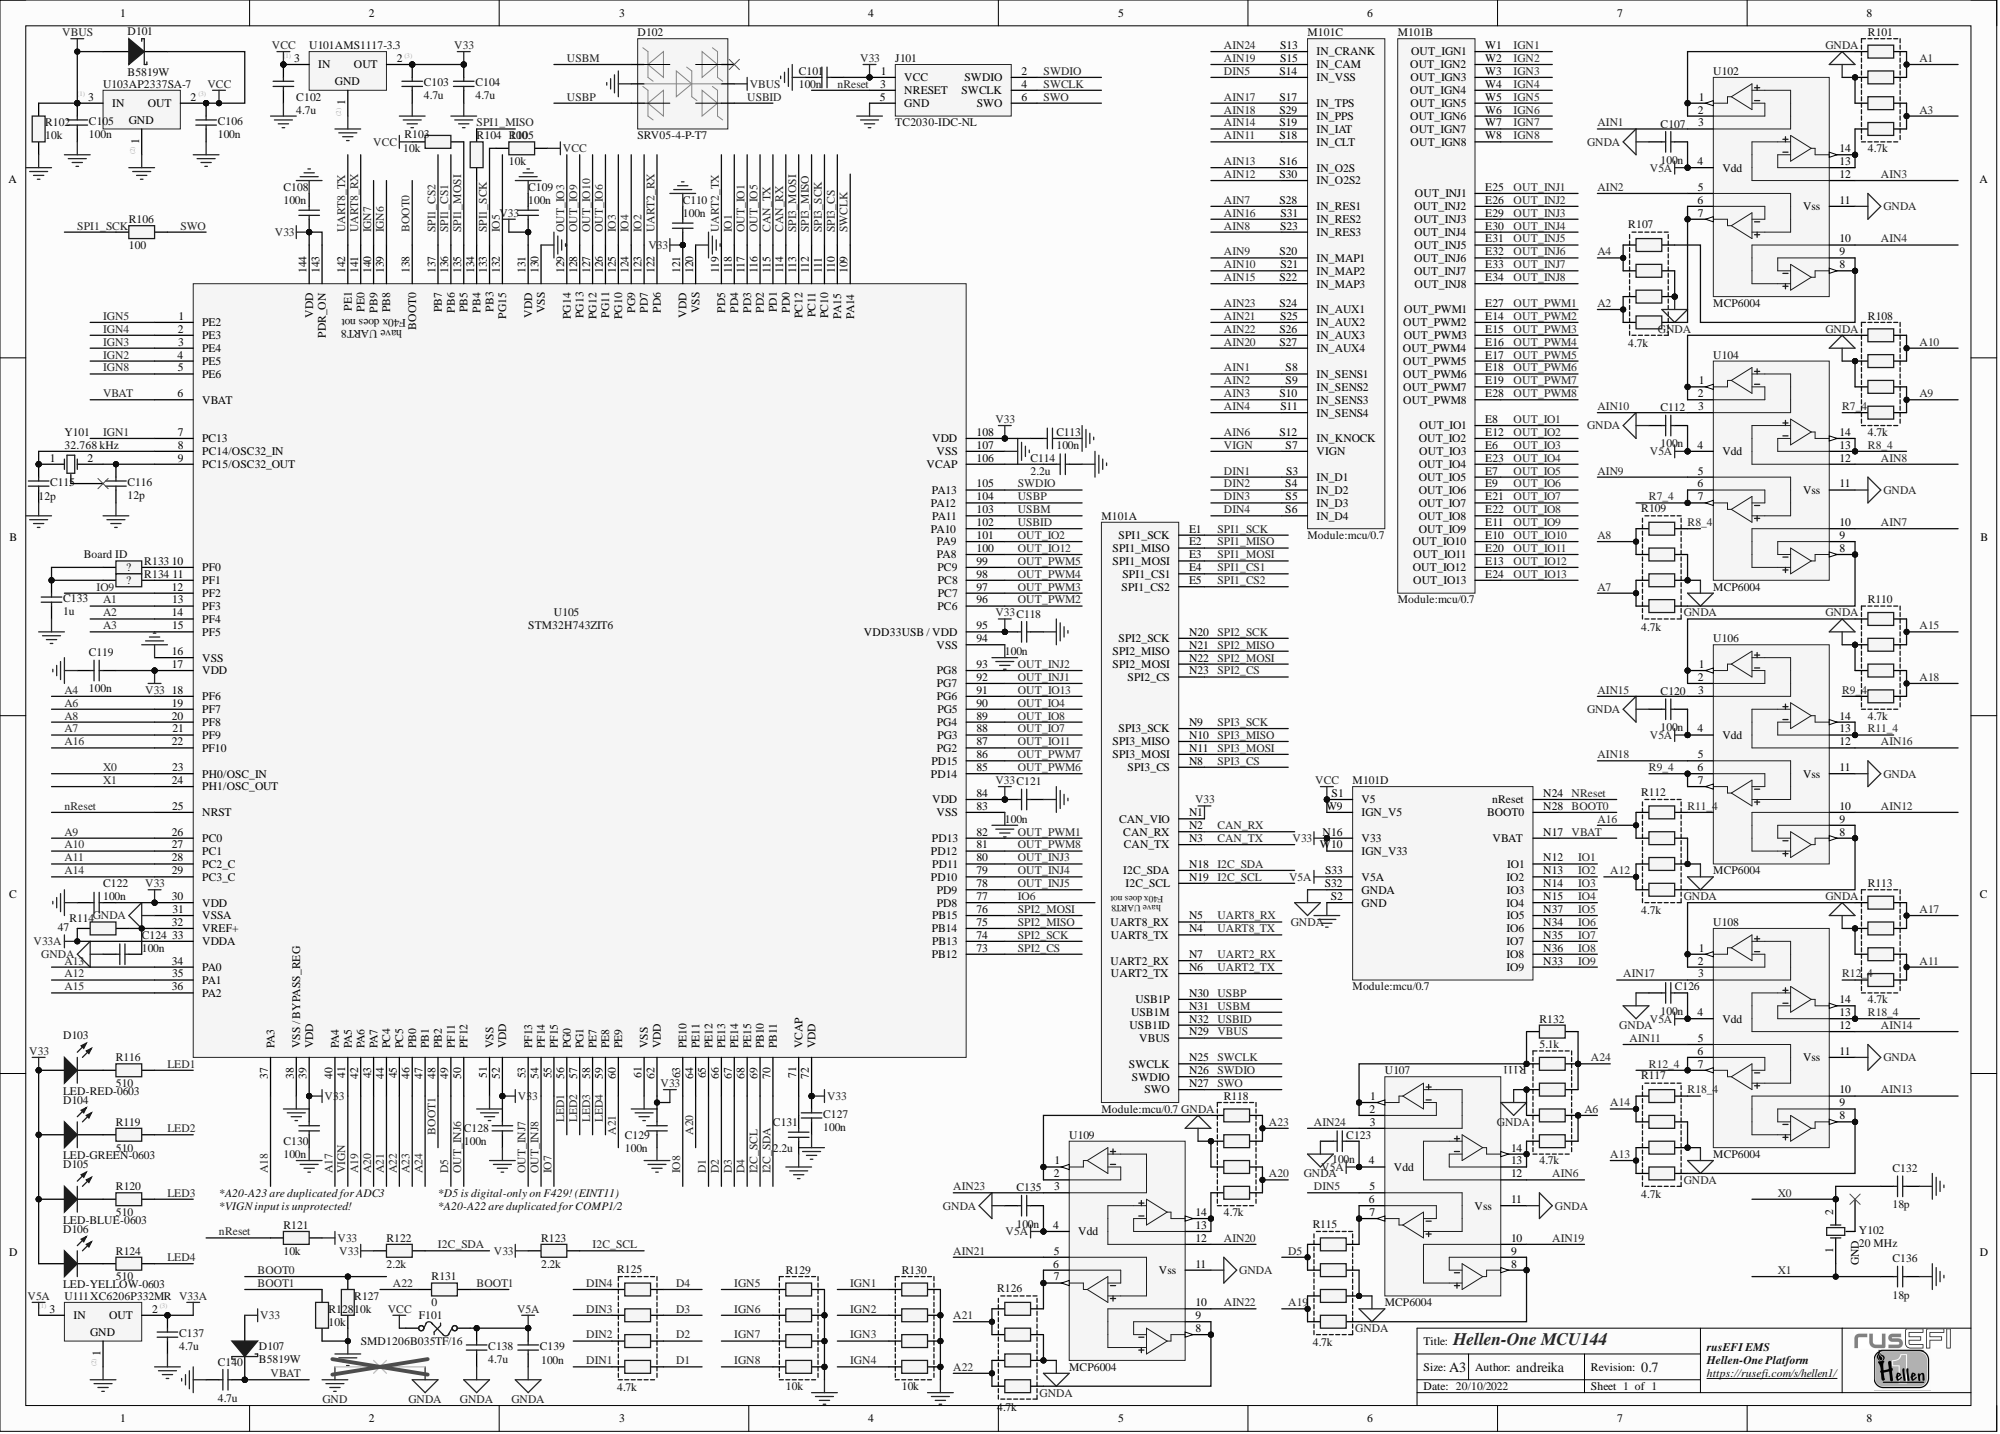
[picture p90: page 1]

VSS 16 | | OUT_INJ2

PF6 18 | OUT_INJ1

VSSA 31 | SPI2_MOSI
VREF+ 32 | SPI2_MISO
C124 | | VDDA 33 | SPI2_SCK
PA0 34 | SPI2_CS

D5 *D5 is digital-only on F429! (EINT11)

*A20-A23 are duplicated for ADC3
*VIGN input is unprotected!

Vdd 4
