andreika-git/hellen-one/modules/ign8/0.2/ign8-schematic.pdf

rusEFI EMS https://rusefi.co
Hellen-One
