andreika-git/hellen-one/modules/mcu144/0.5/mcu144-schematic.pdf

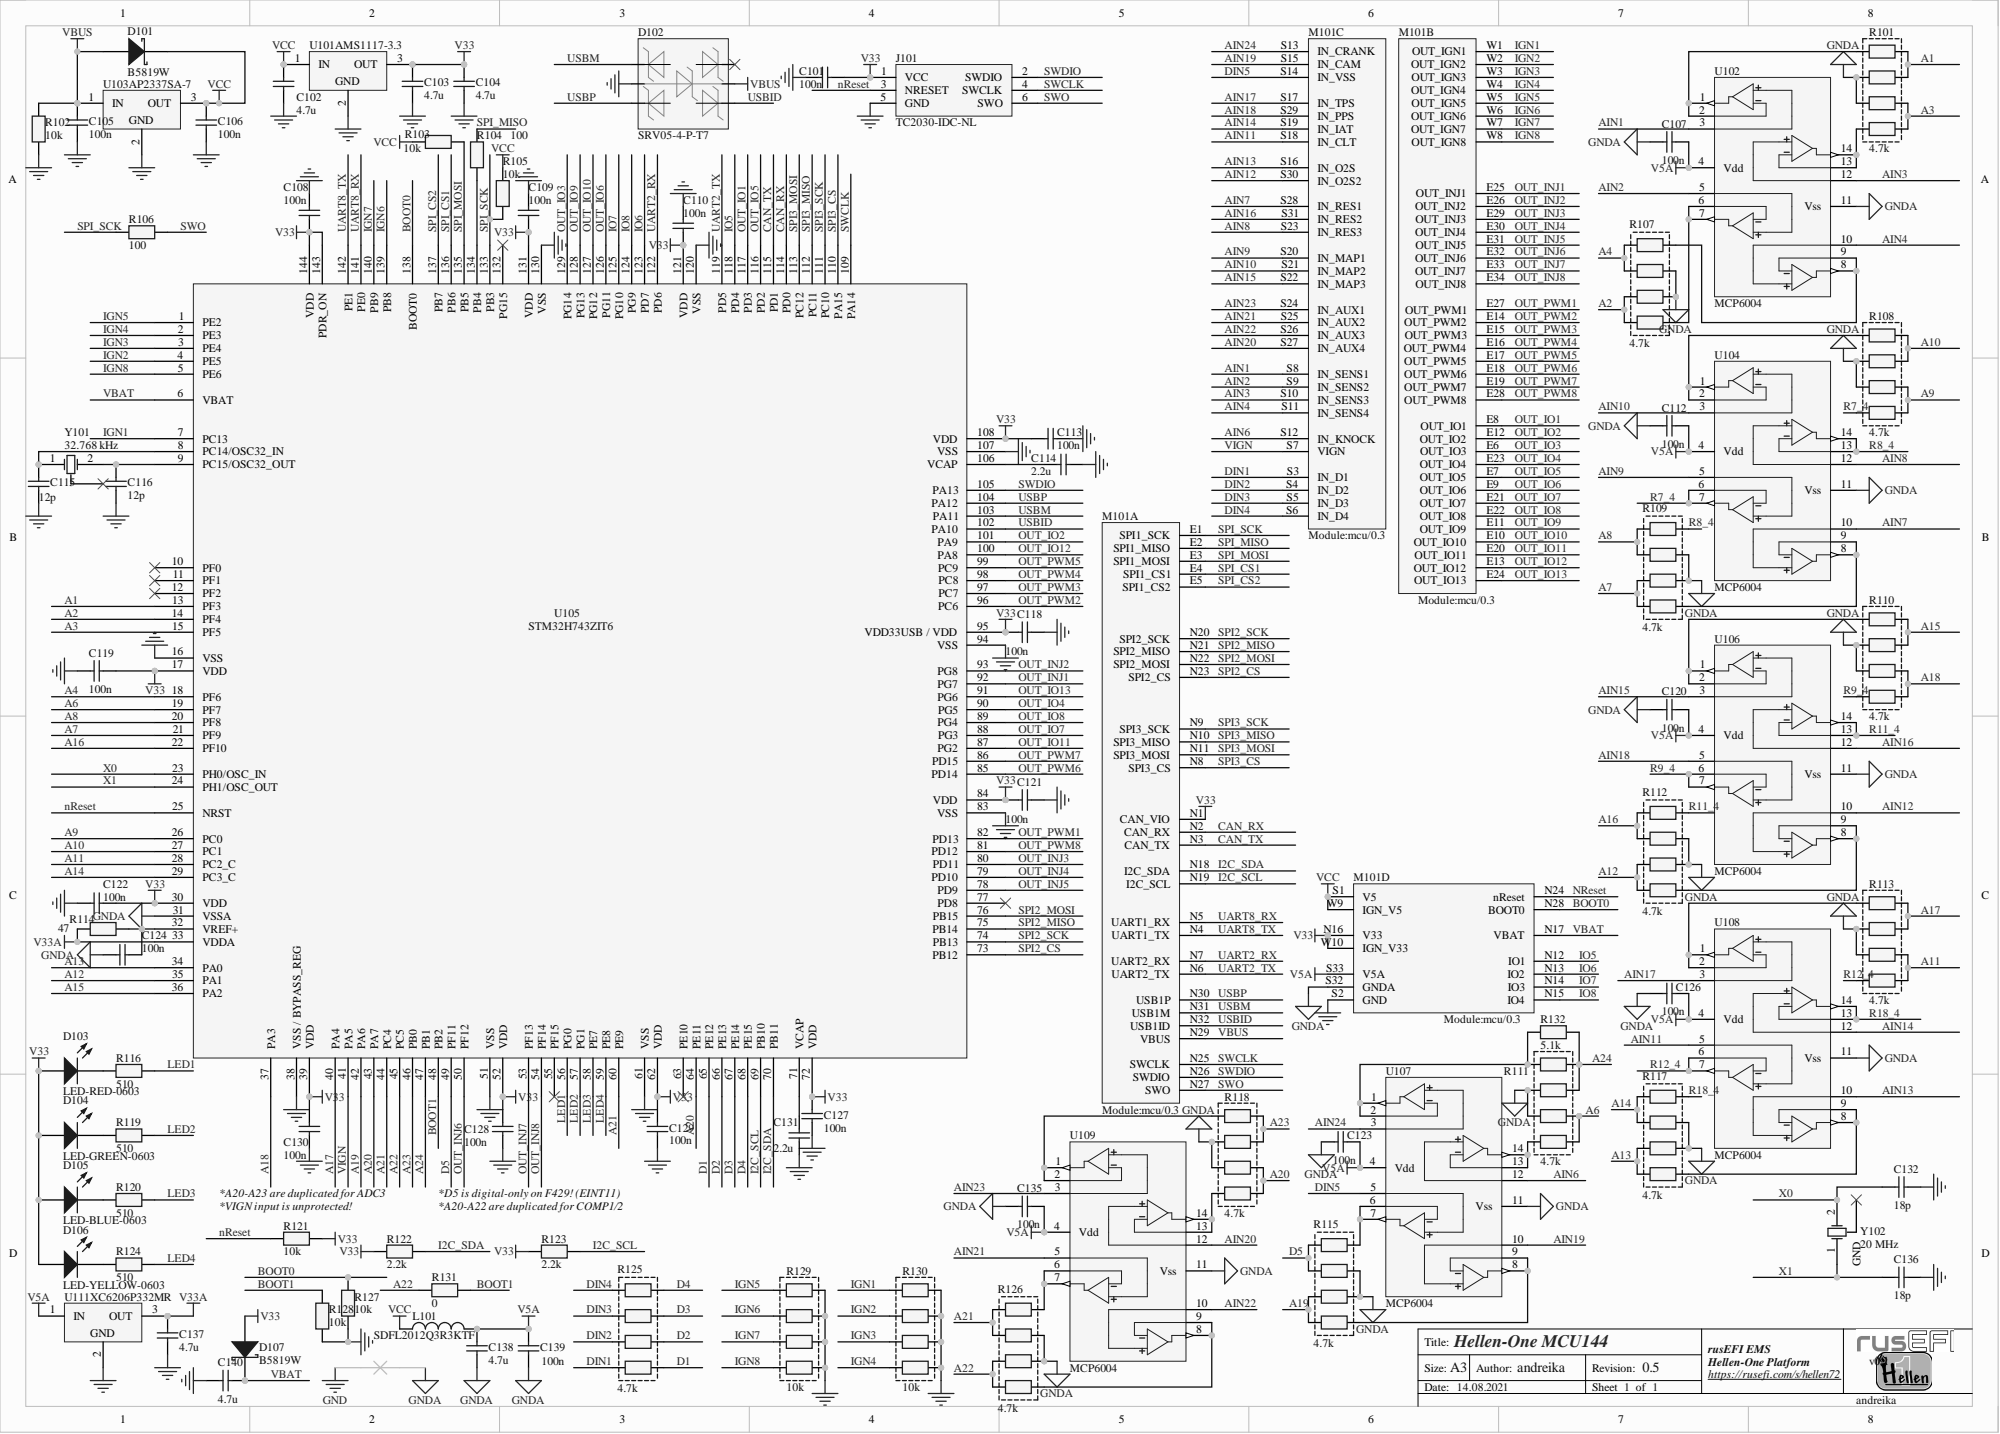
[picture p92: page 1]

VREF+ 32 | SPI2_MISO
C124 | | VDDA 33 | SPI2_SCK
PA0 34 PA1 35 PA2 36 | SPI2_CS

D5 *D5 is digital-only on F429!(EINT11)

*A20-A23 are duplicated for ADC3
*VIGN input is unprotected!

Vdd 4
