andreika-git/hellen-one/modules/power12/0.2/power12-schematic.pdf

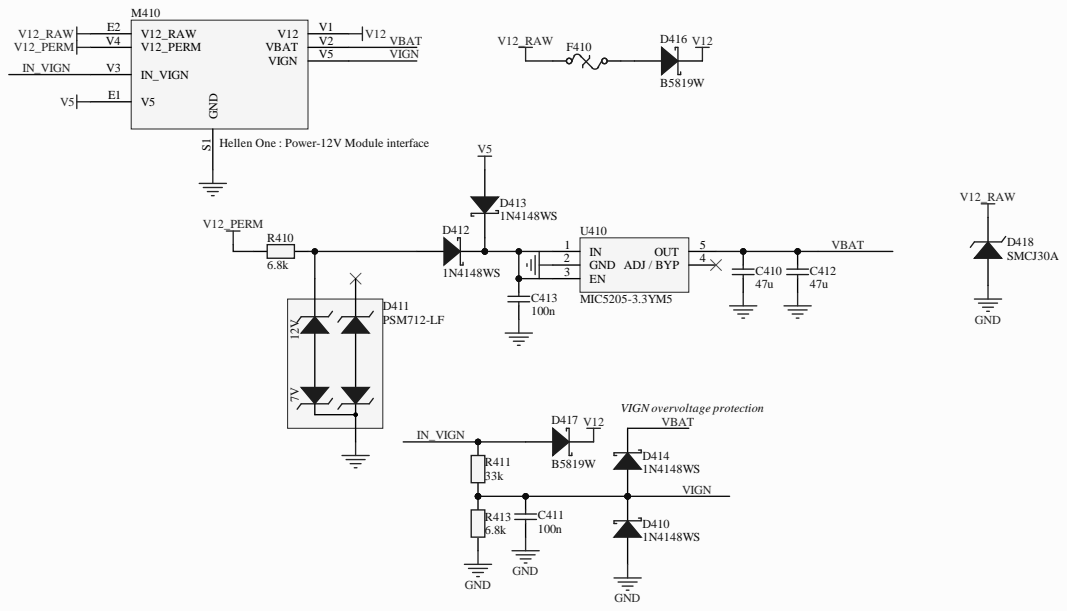
[picture p94: page 1]

rusEFI EMS https://rusefi.co
Hellen-One
