andreika-git/hellen-one/modules/input/0.1/input-schematic.pdf

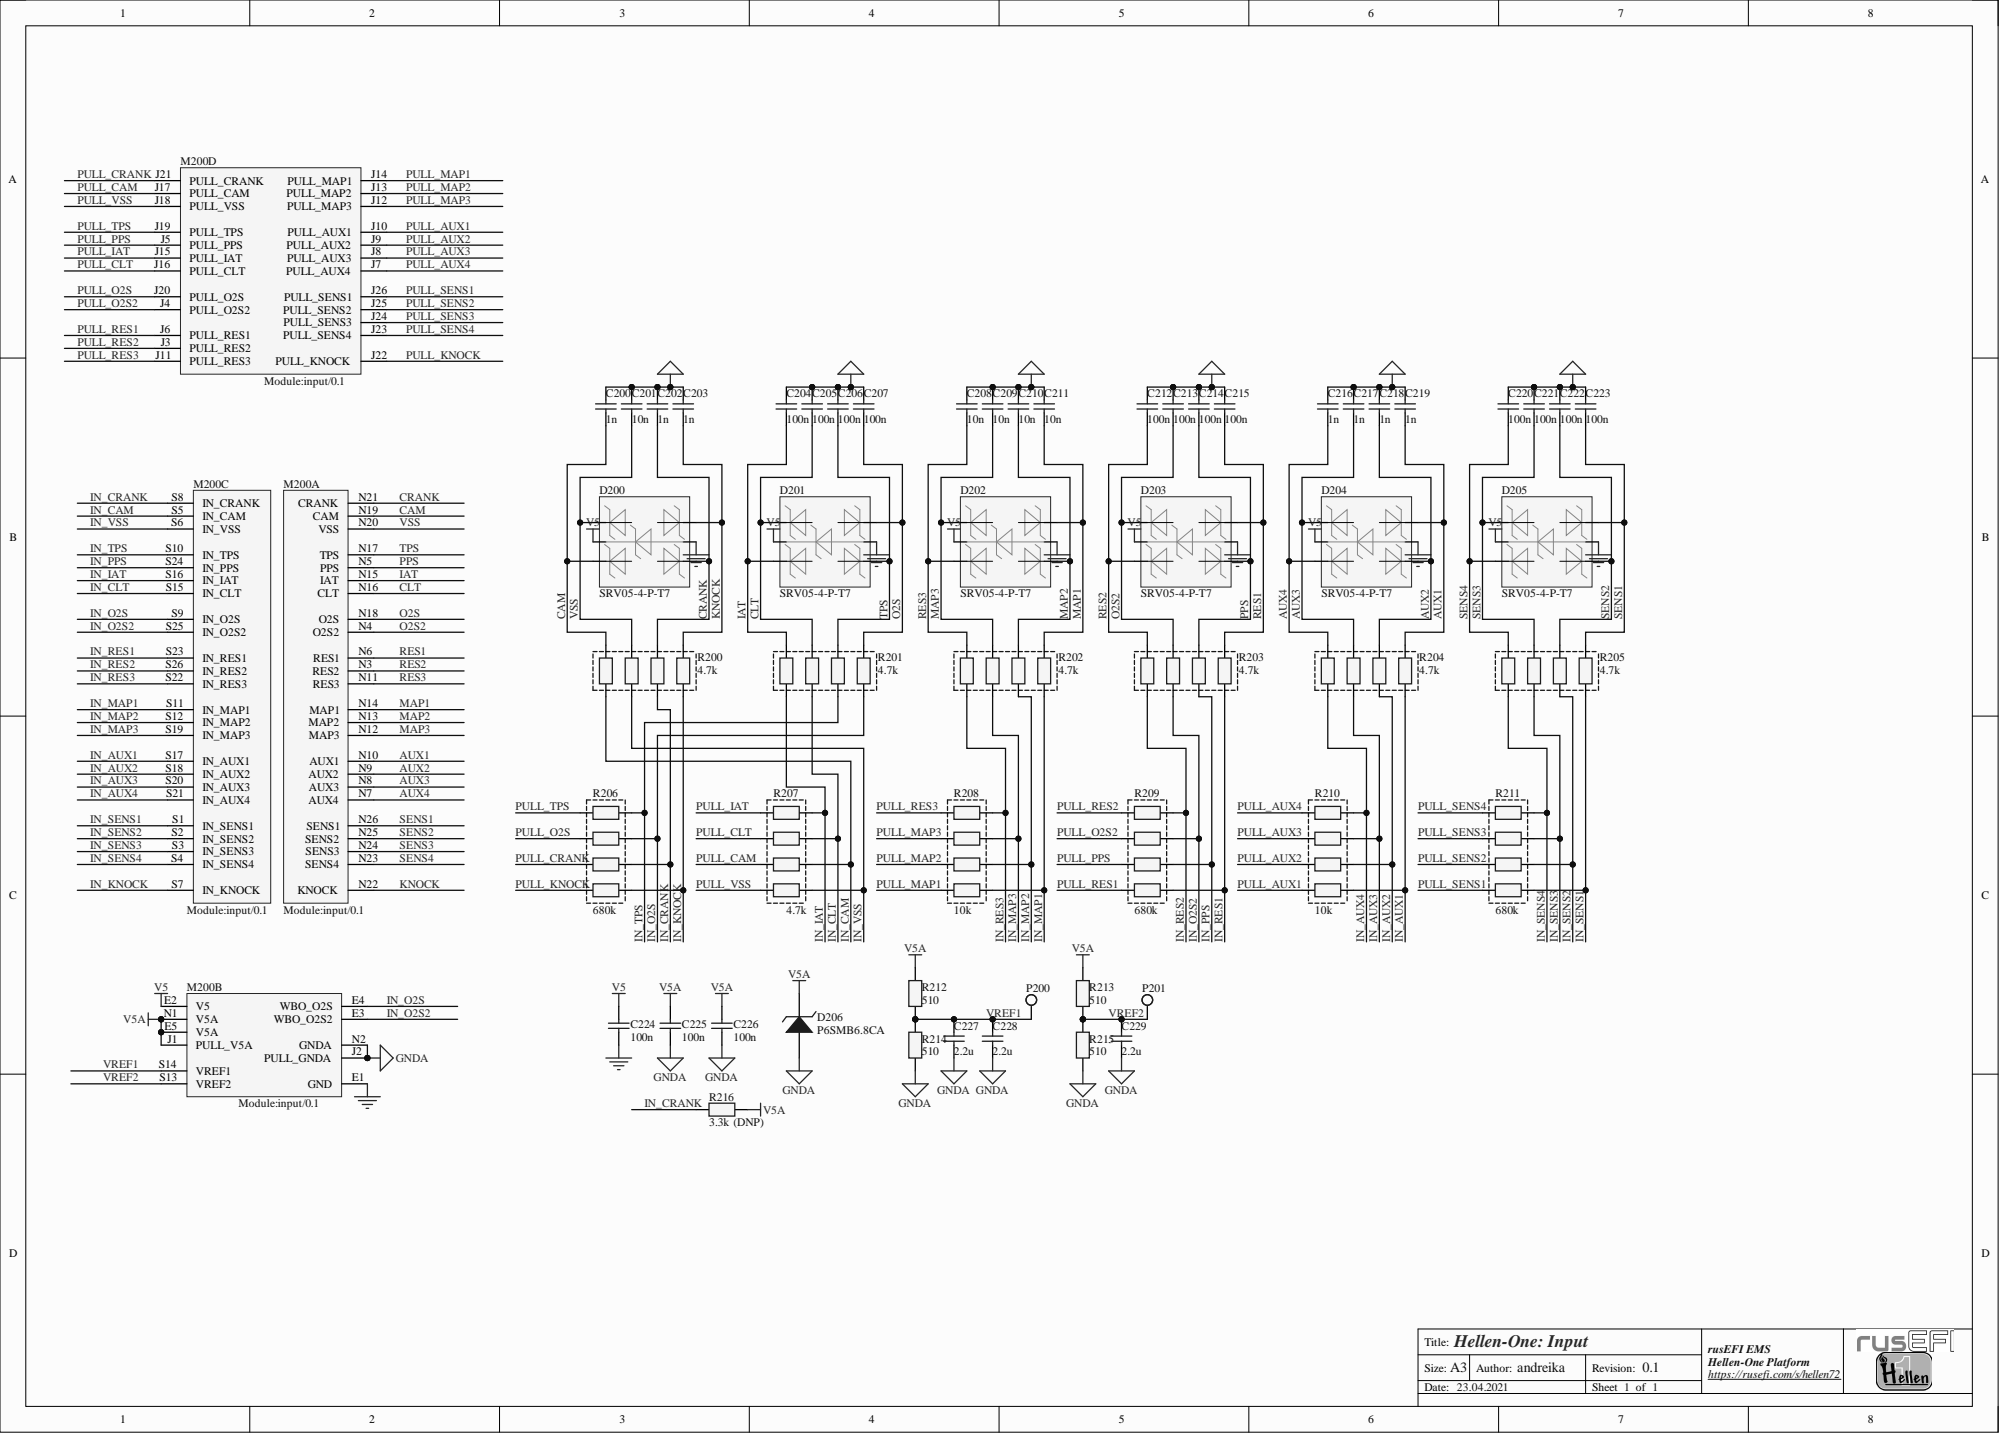
[picture p95: page 1]
