andreika-git/hellen-one/modules/dinput4/0.1/dinput4-schematic.pdf

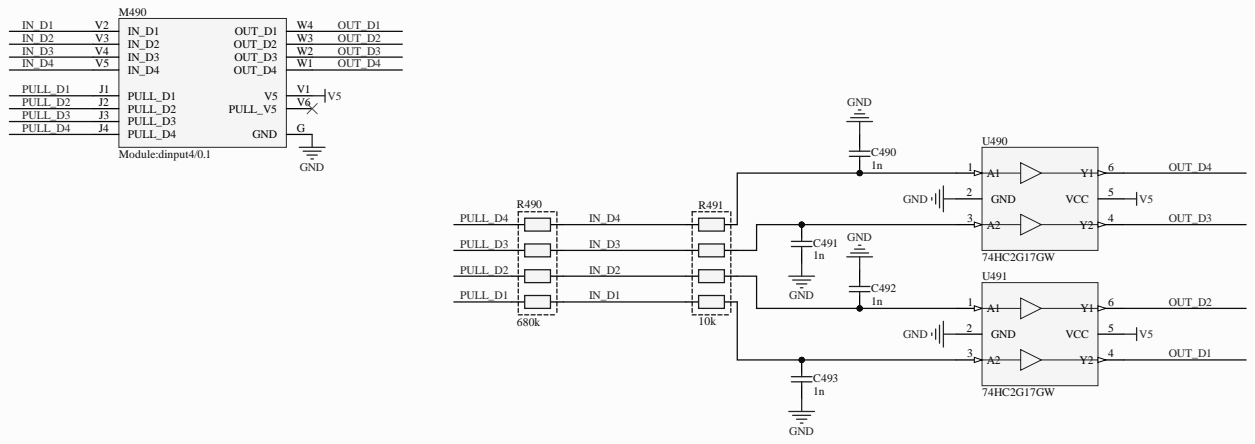
[picture p96: page 1]

Hellen-One VR andreika

rusEFI EMS https://rusefi.co
Hellen-One
