andreika-git/hellen-one/modules/lin/0.1/lin-schematic.pdf

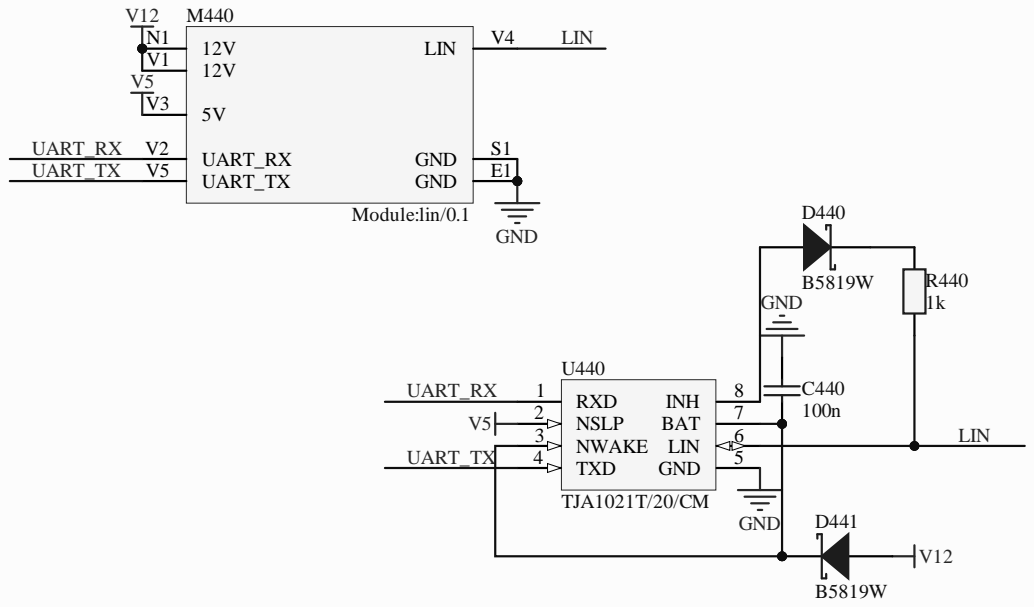
[picture p97: page 1]
