andreika-git/hellen-one/modules/sd/0.1/sd-schematic.pdf

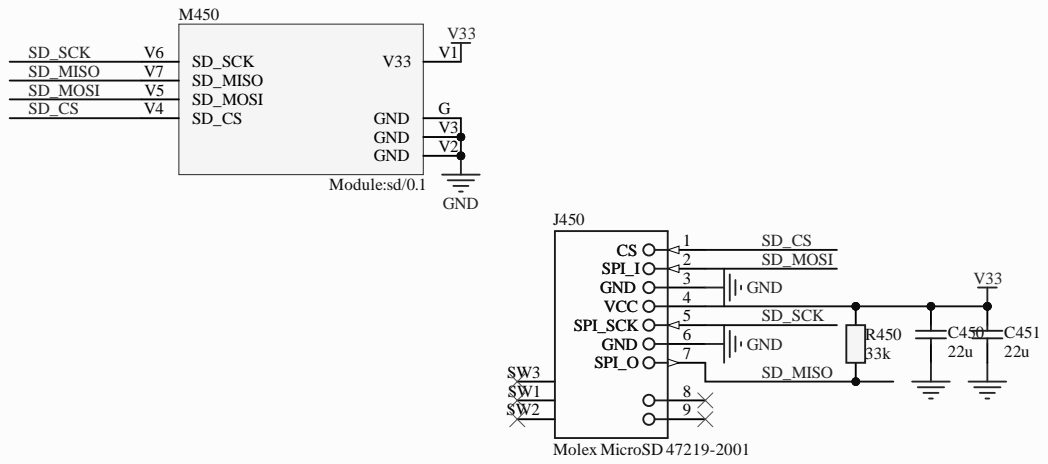
[picture p98: page 1]

Hellen-One SD-Card
Title:
