andreika-git/hellen-one/modules/stlink/0.1/stlink-schematic.pdf

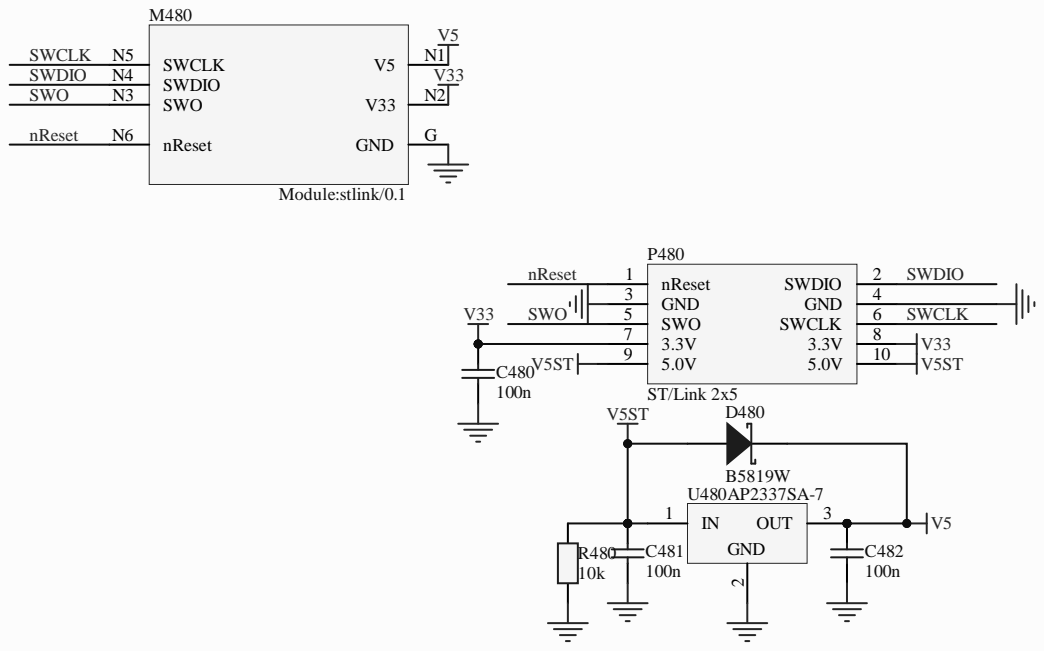
[picture p99: page 1]

Hellen-One ST-Link
Title:
