andreika-git/hellen-one/modules/power5/0.2/power5-schematic.pdf

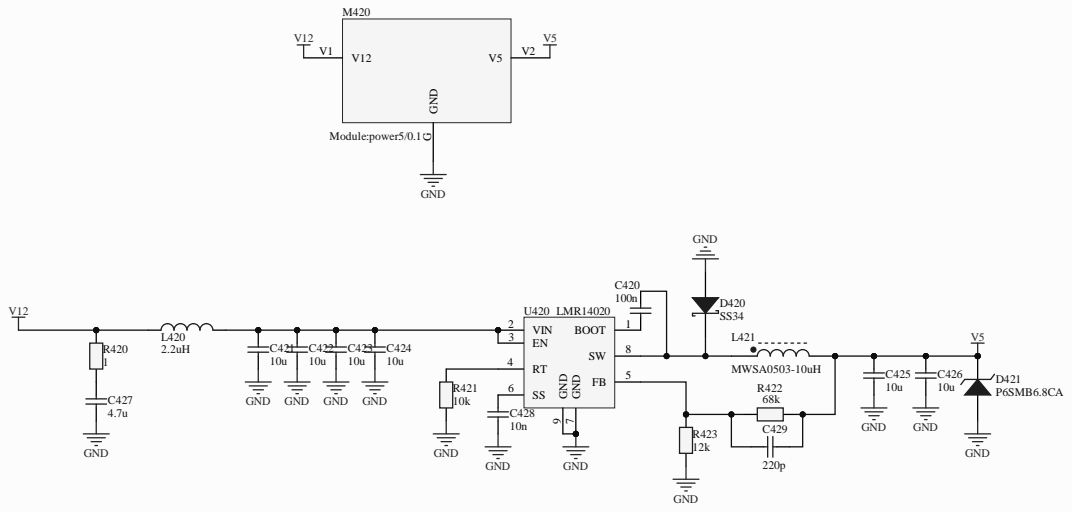
[picture p100: page 1]
