andreika-git/hellen-one/modules/mega-mcu64/0.1/mega-mcu64-pcb3d.pdf

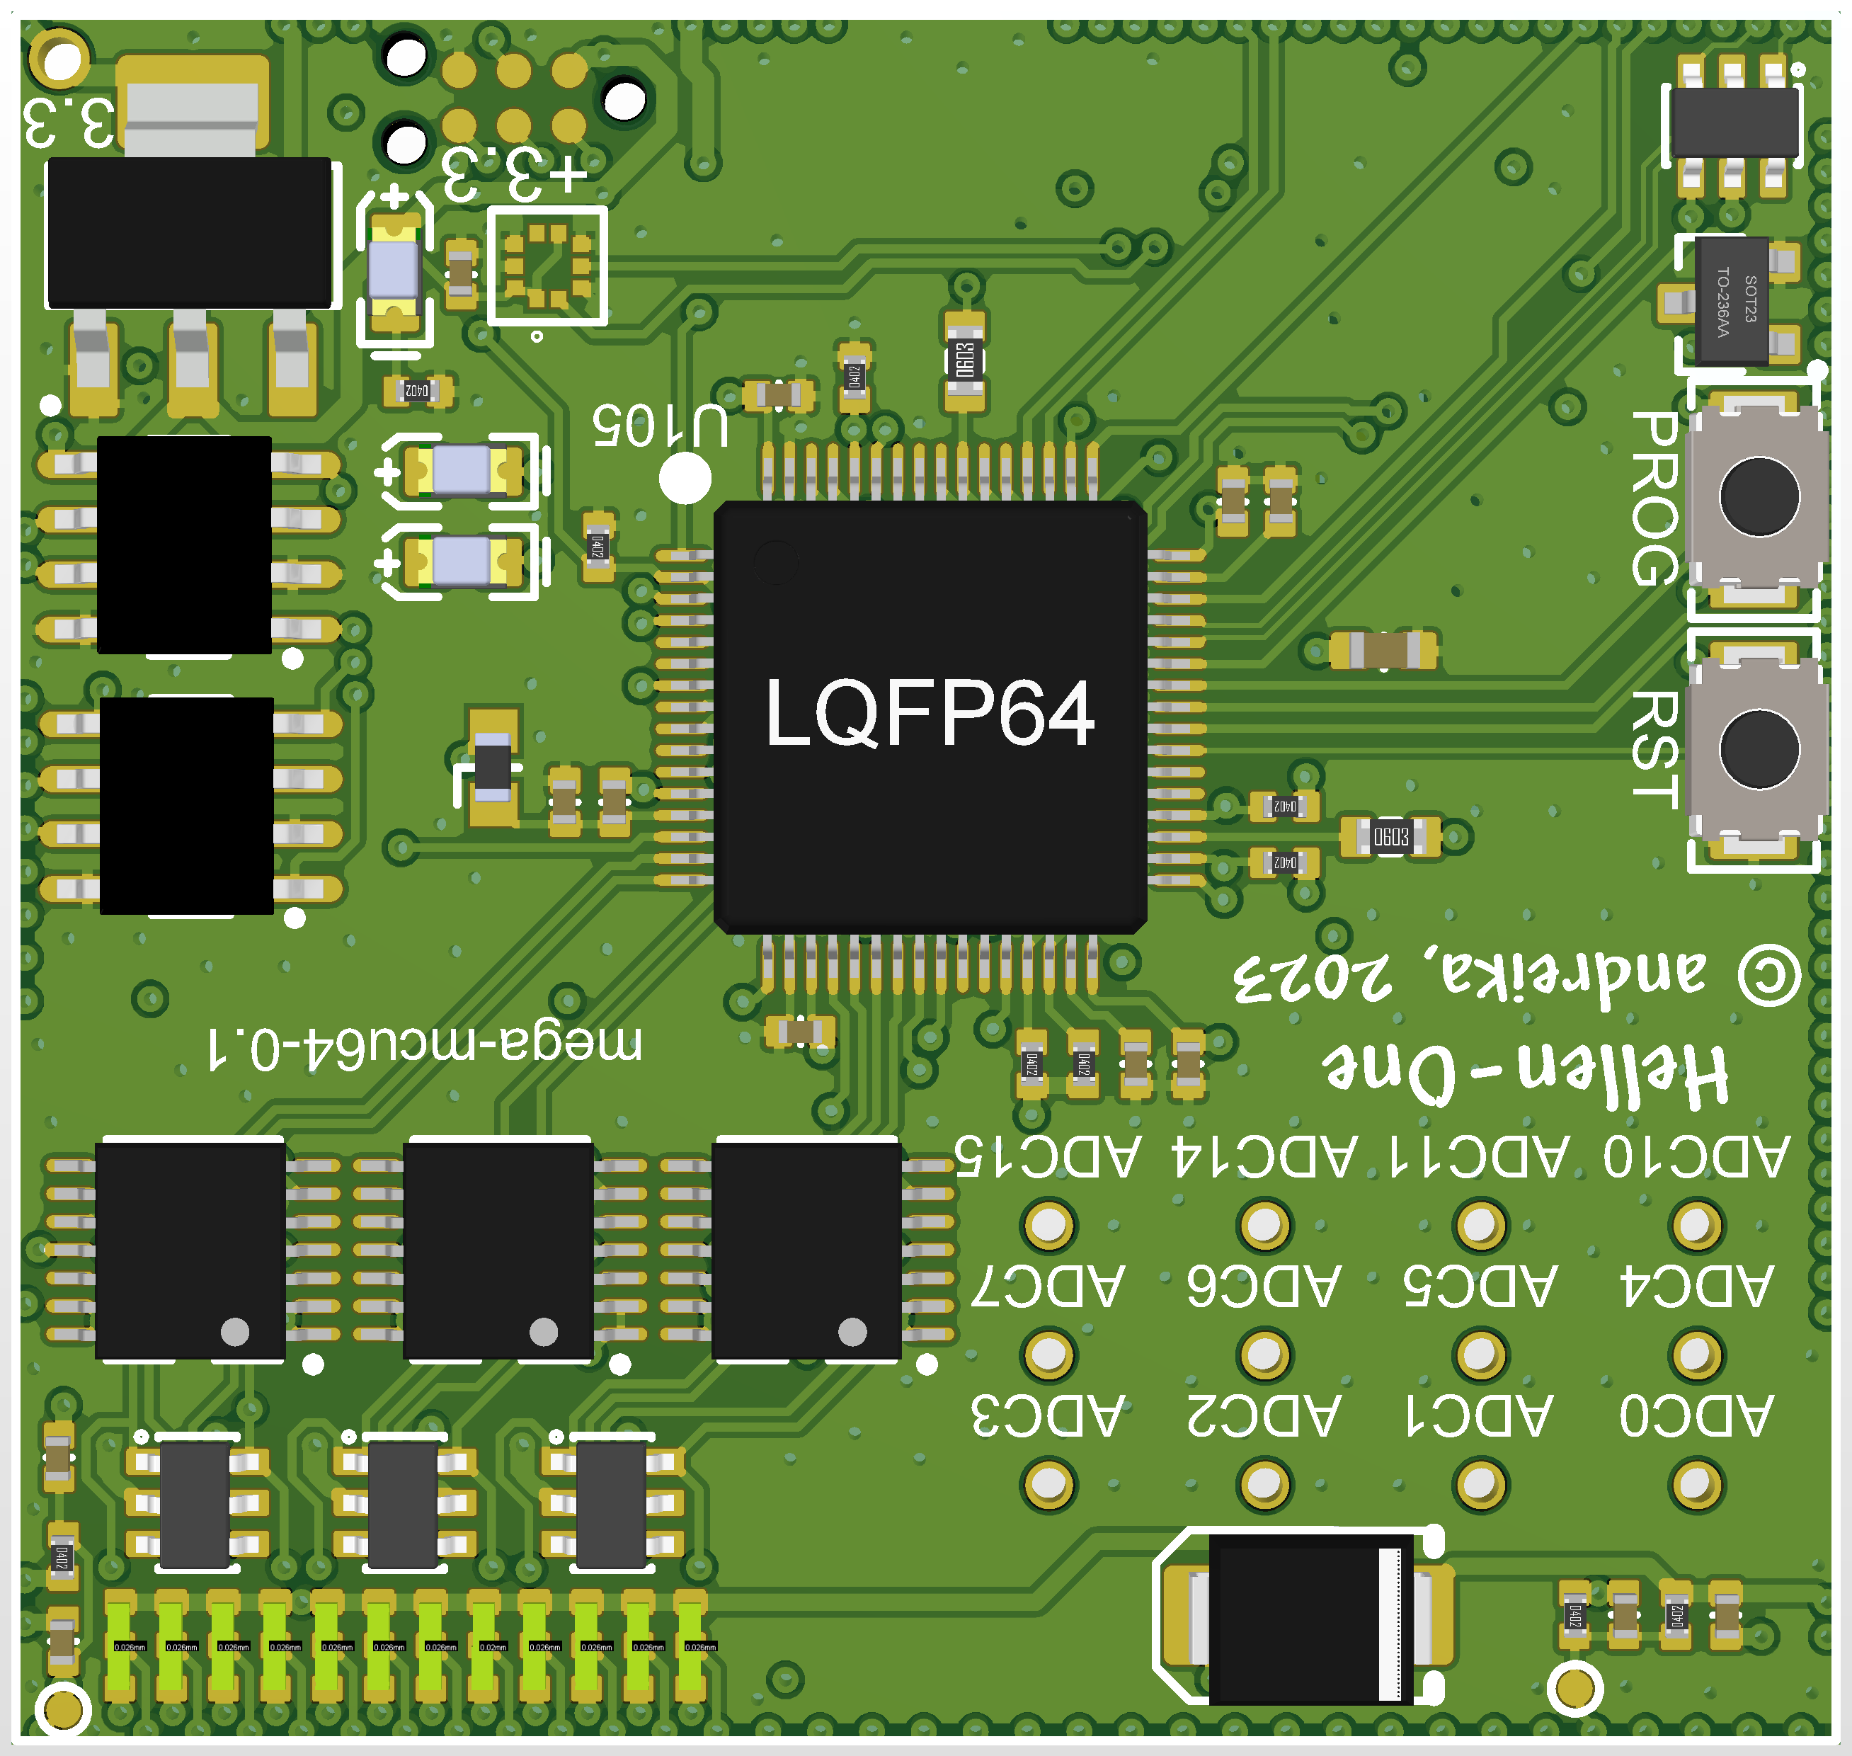
[picture p101: page 1]
