andreika-git/hellen-one/modules/mega-mcu100/0.3/mega-mcu100-pcb3d.pdf

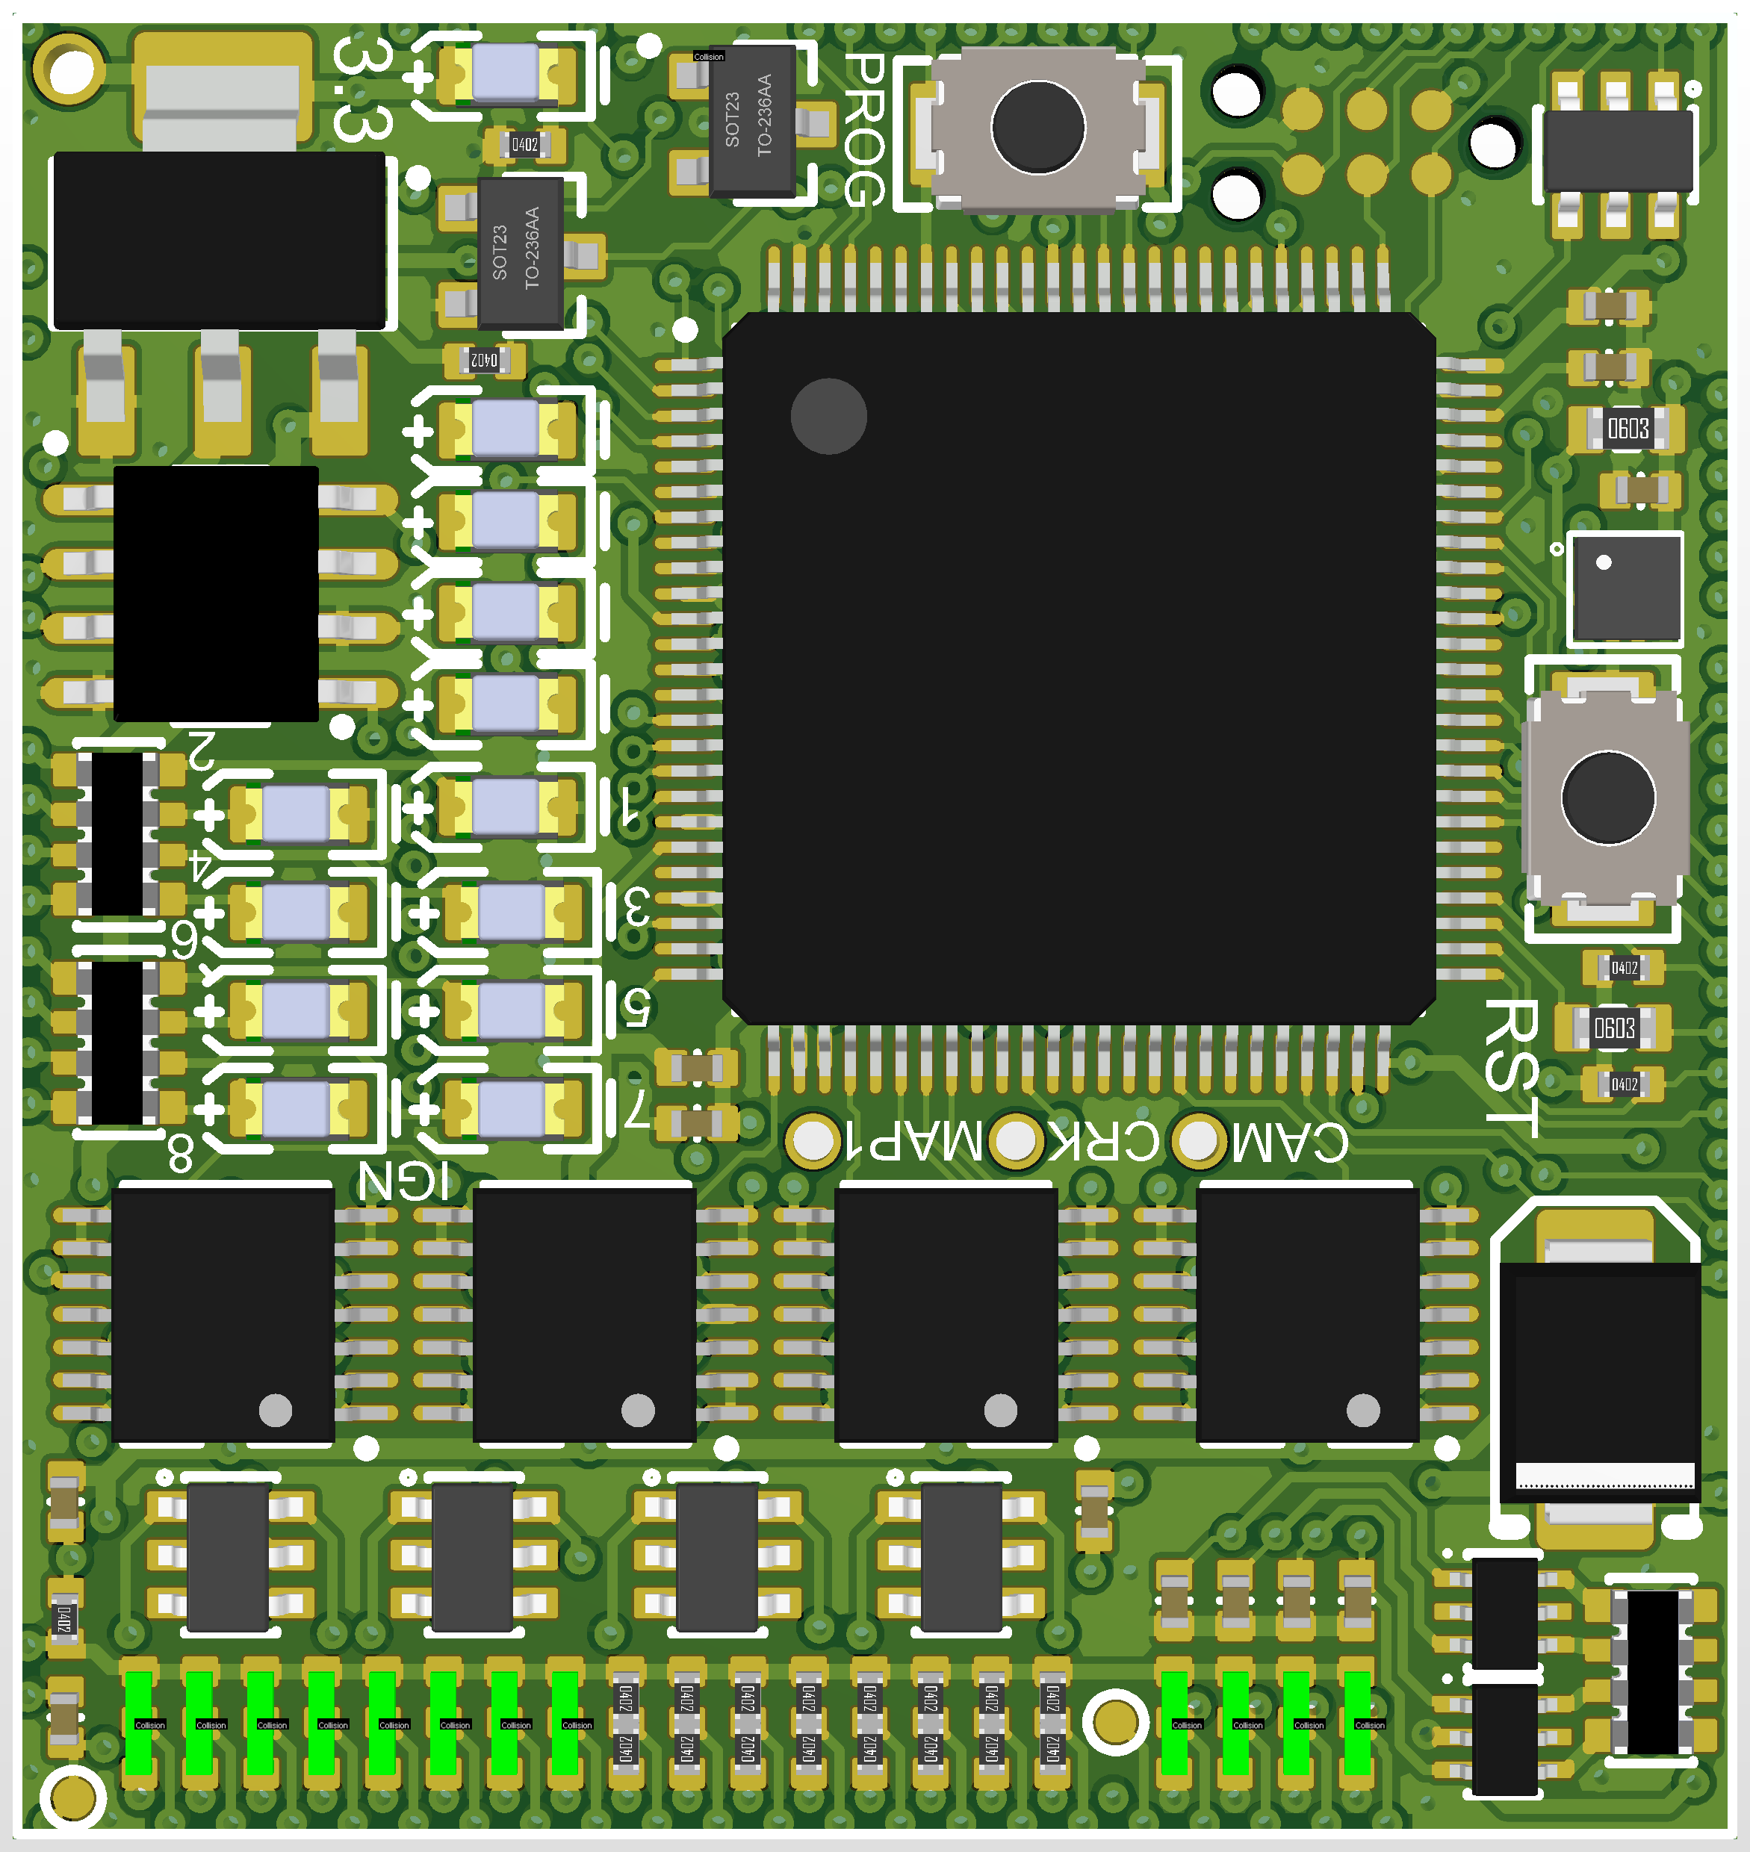
[picture p102: page 1]
