andreika-git/hellen-one/modules/mega-mcu144/0.7/mega-mcu144-pcb3d.pdf

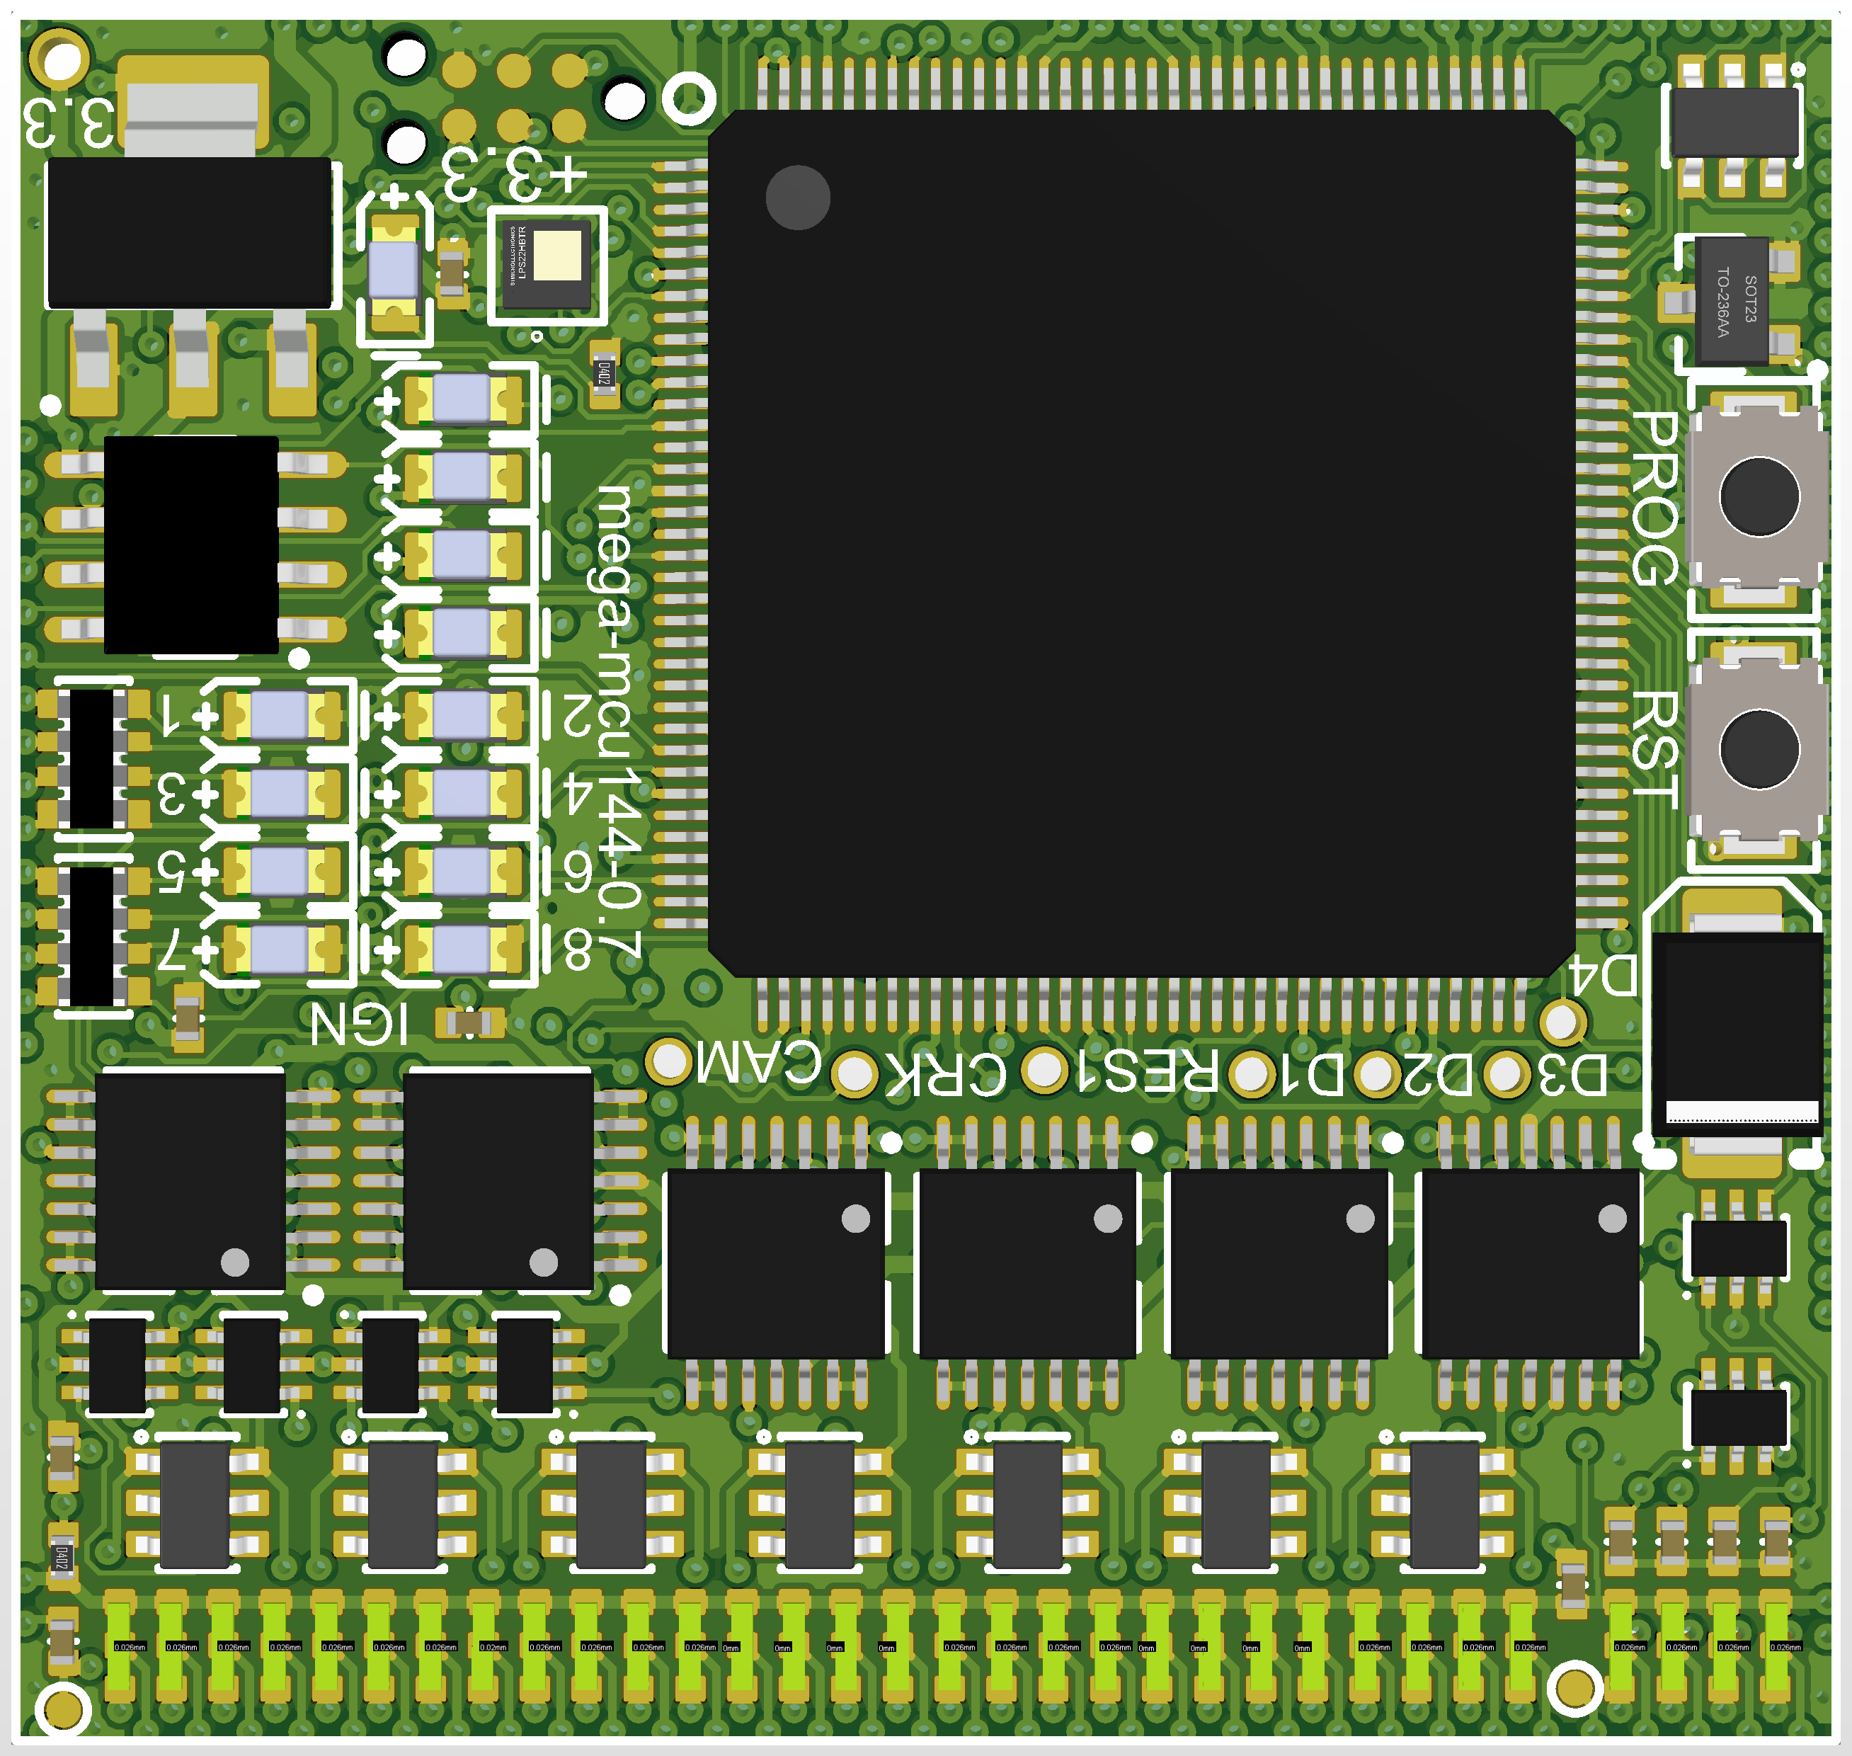
[picture p103: page 1]
