andreika-git/hellen-one/modules/power_12and5V/0.3/power_12and5V-pcb3d.pdf

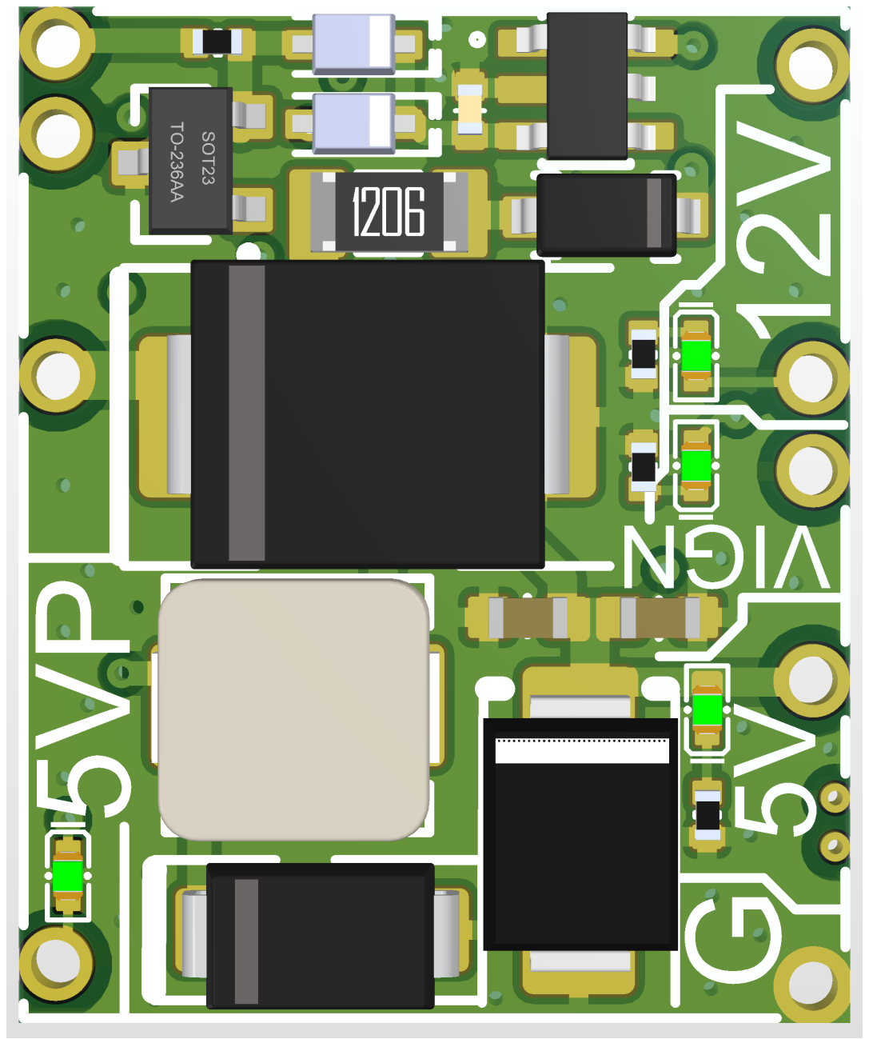
[picture p104: page 1]
