andreika-git/hellen-one/modules/knock/0.2/knock-pcb3d.pdf

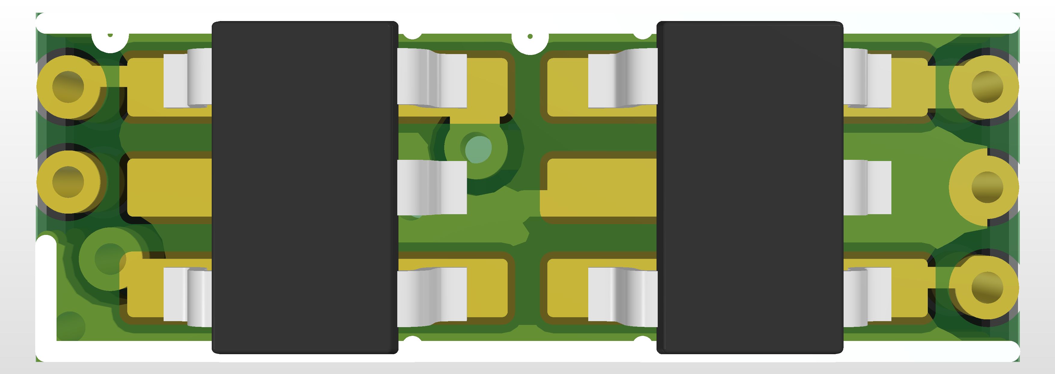
[picture p105: page 1]
