andreika-git/hellen-one/modules/mcu/0.7/mcu-pcb3d.pdf

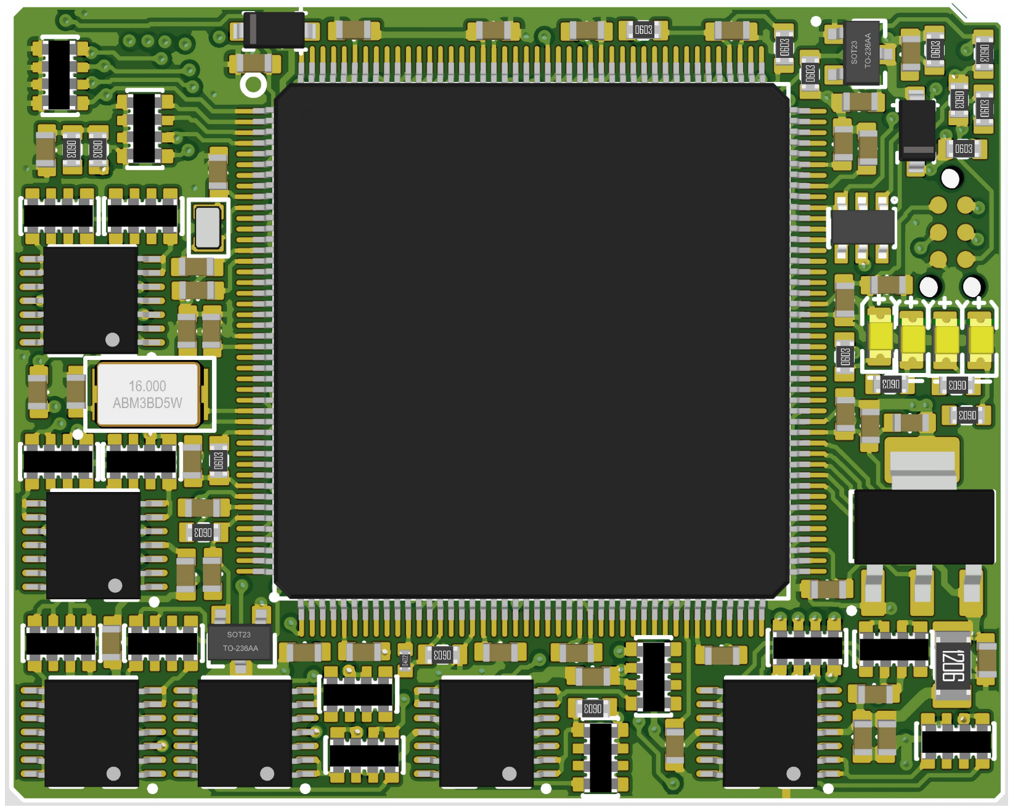
[picture p106: page 1]
