andreika-git/hellen-one/modules/mcu144/0.7/mcu144-pcb3d.pdf

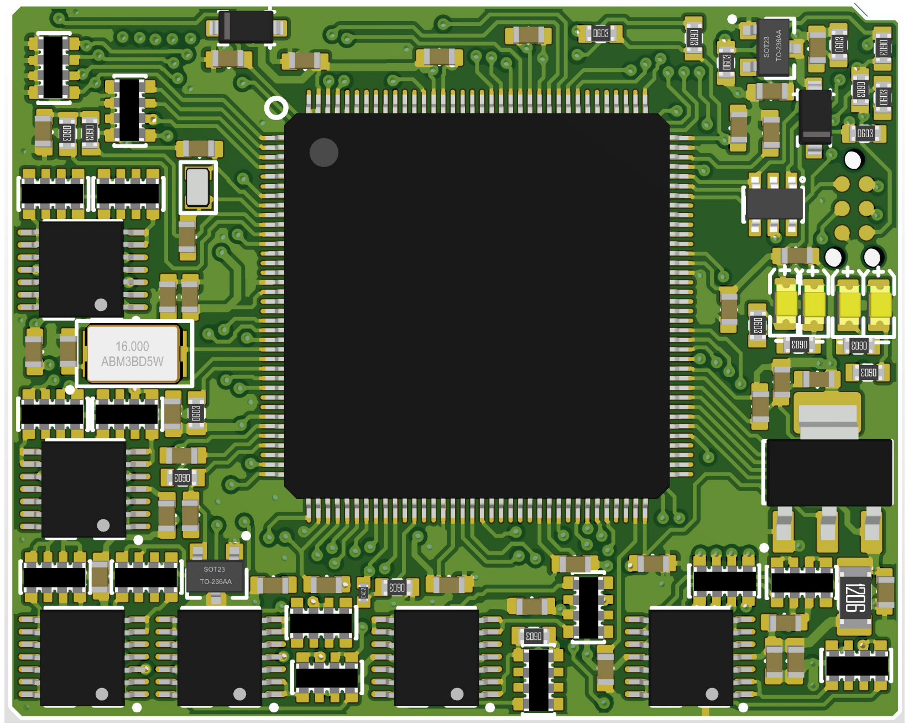
[picture p107: page 1]
