andreika-git/hellen-one/modules/ign8/0.2/ign8-pcb3d.pdf

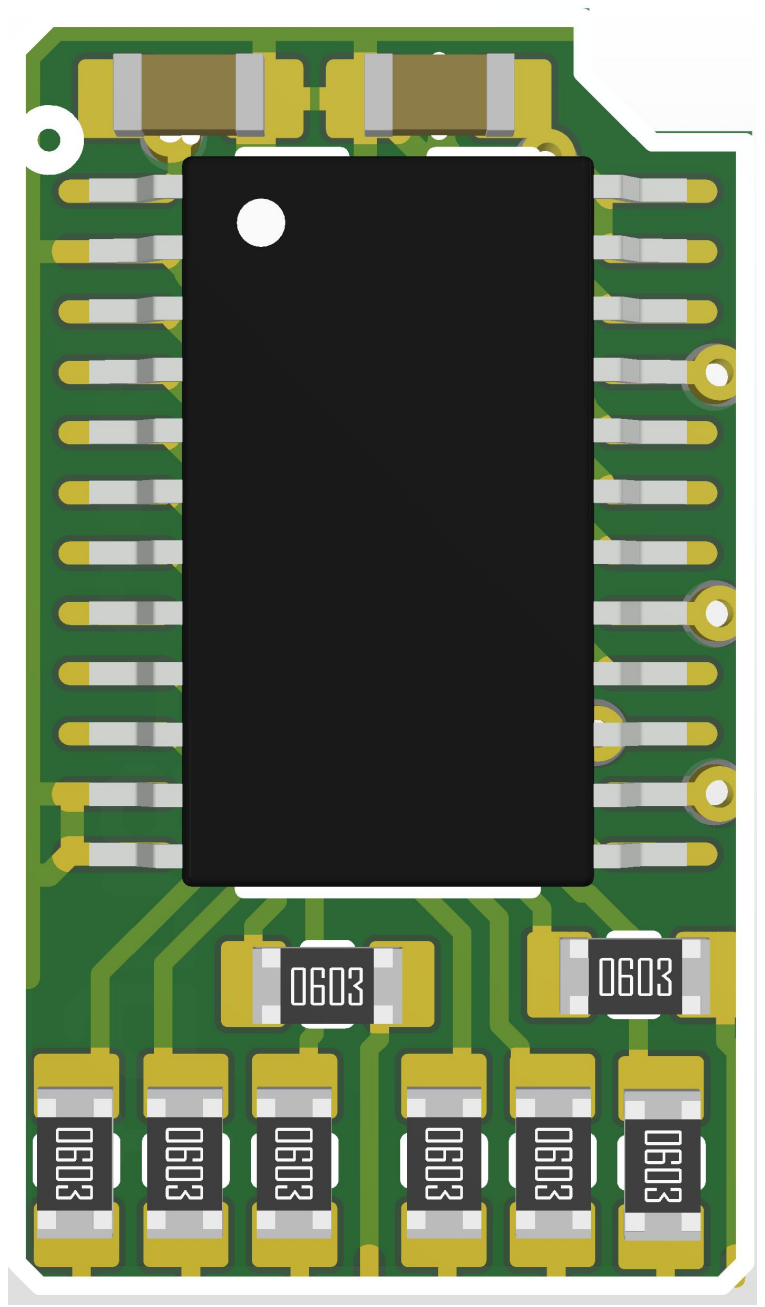
[picture p108: page 1]
