andreika-git/hellen-one/modules/output/0.3/output-pcb3d.pdf

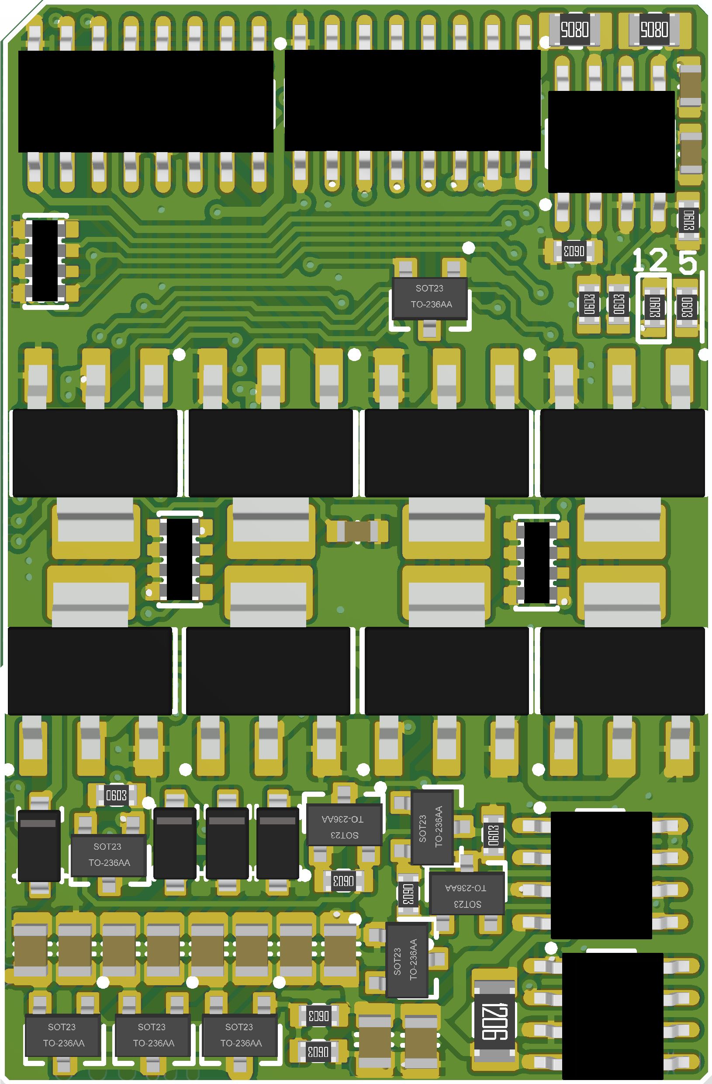
[picture p109: page 1]
