andreika-git/hellen-one/modules/mcu144/0.5/mcu144-pcb3d.pdf

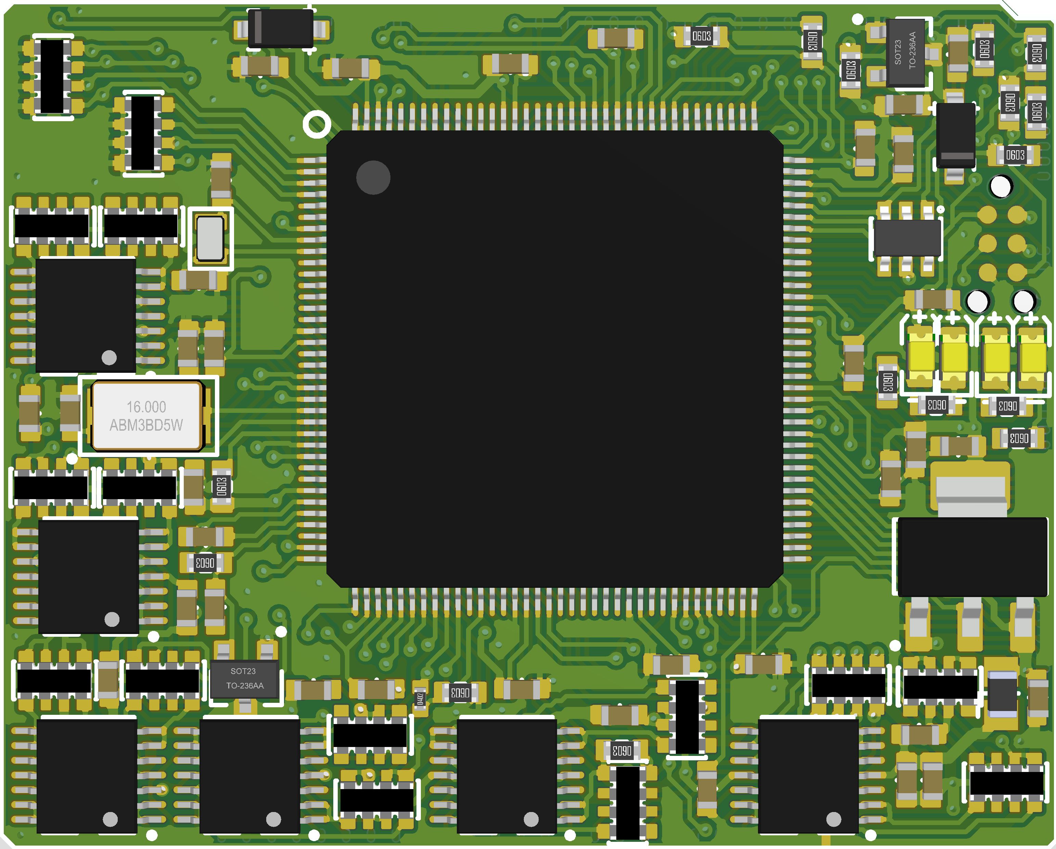
[picture p110: page 1]
