andreika-git/hellen-one/modules/mcu144/0.4/mcu144-pcb3d.pdf

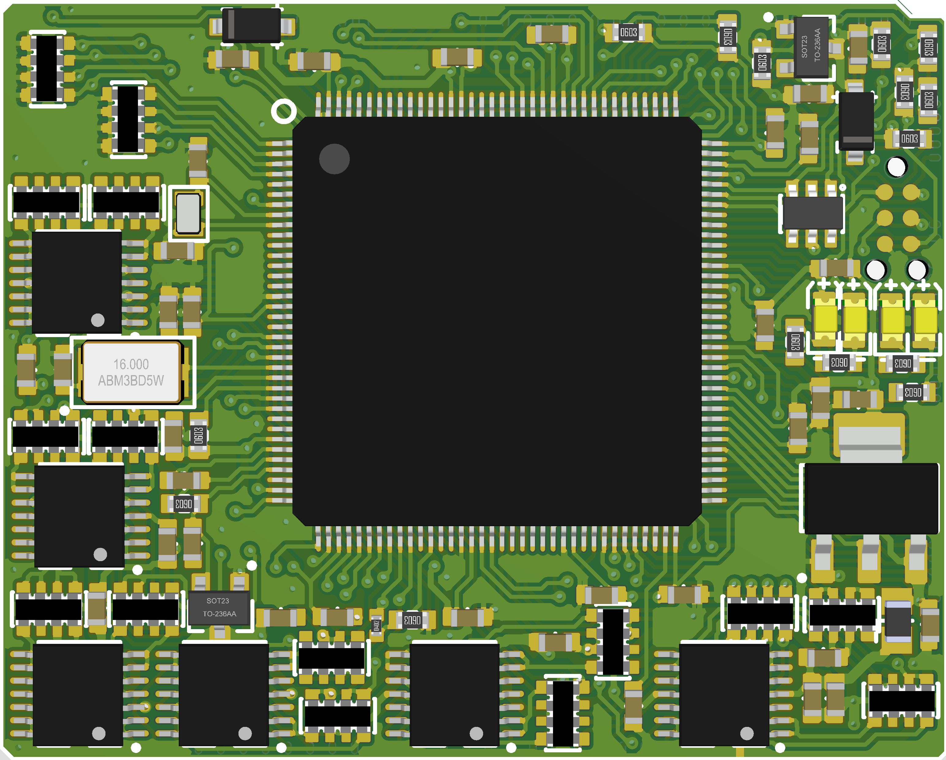
[picture p111: page 1]
