andreika-git/hellen-one/modules/mcu144/0.3/mcu144-pcb3d.pdf

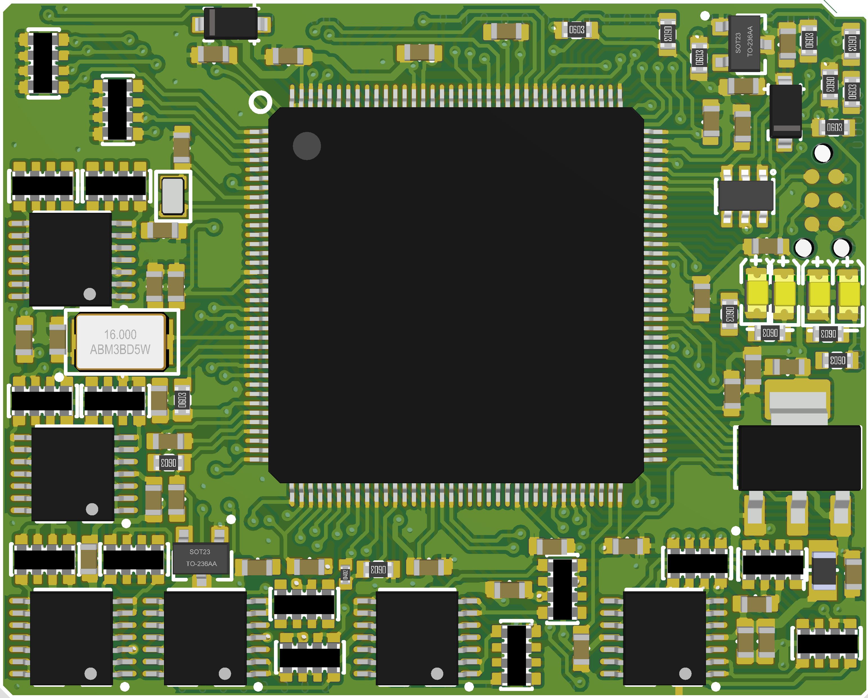
[picture p112: page 1]
