andreika-git/hellen-one/modules/power12/0.2/power12-pcb3d.pdf

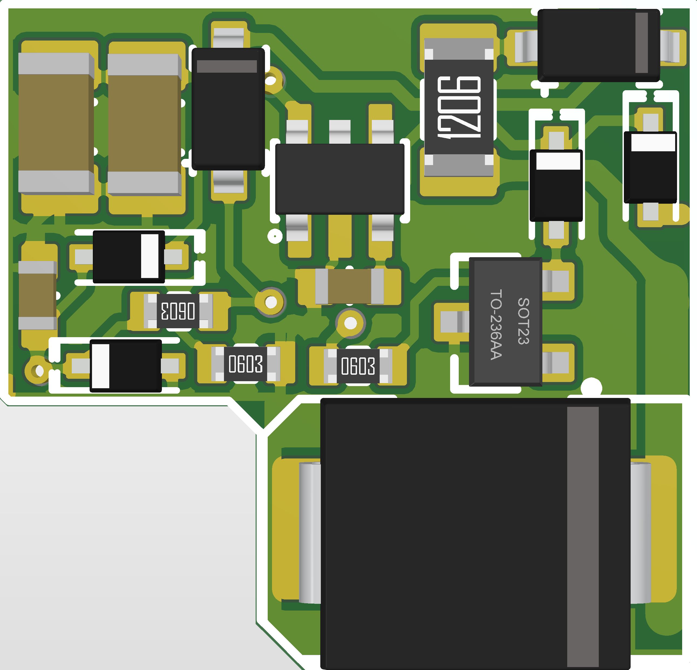
[picture p113: page 1]
