andreika-git/hellen-one/modules/mcu144/0.2/mcu144-pcb3d.pdf

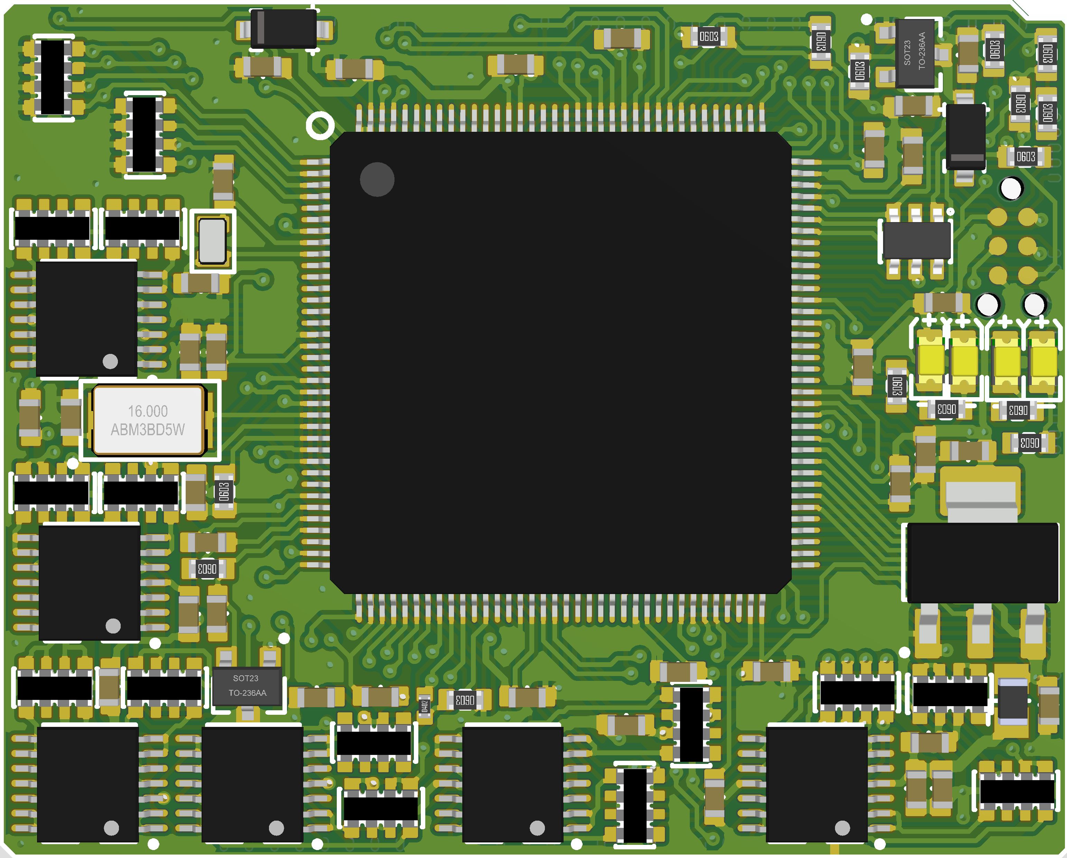
[picture p114: page 1]
