andreika-git/hellen-one/modules/dinput4/0.1/dinput4-pcb3d.pdf

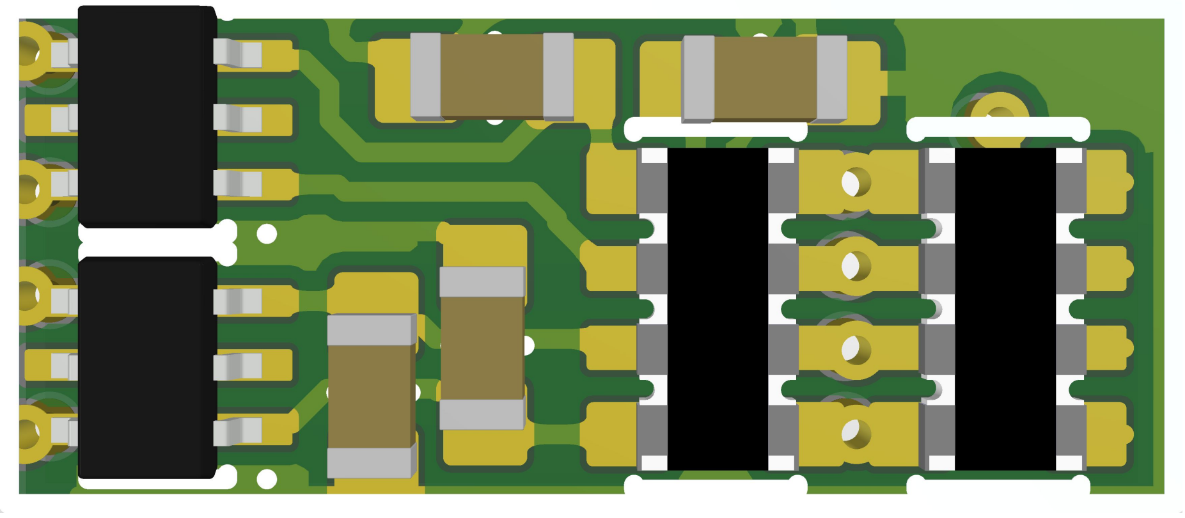
[picture p115: page 1]
