andreika-git/hellen-one/modules/mcu144/0.1/mcu144-pcb3d.pdf

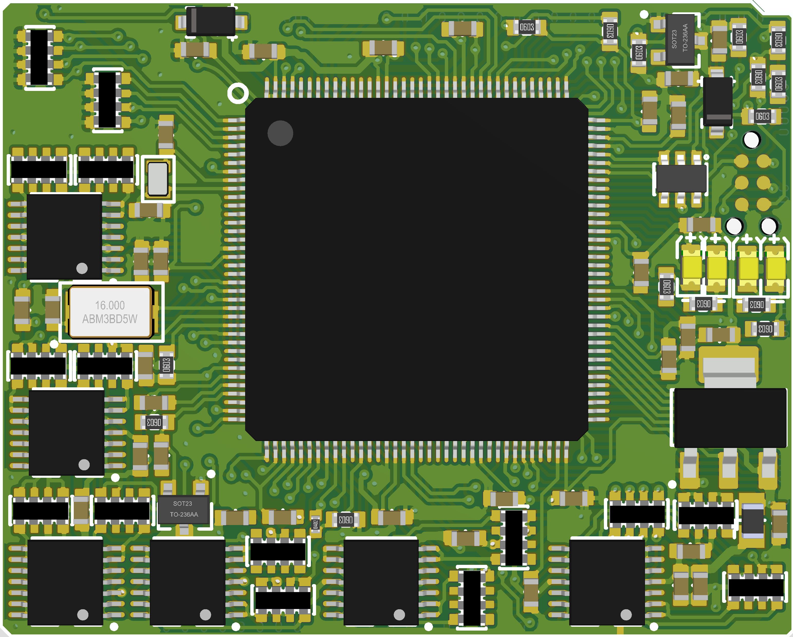
[picture p116: page 1]
