andreika-git/hellen-one/modules/vr/0.1/vr-pcb3d.pdf

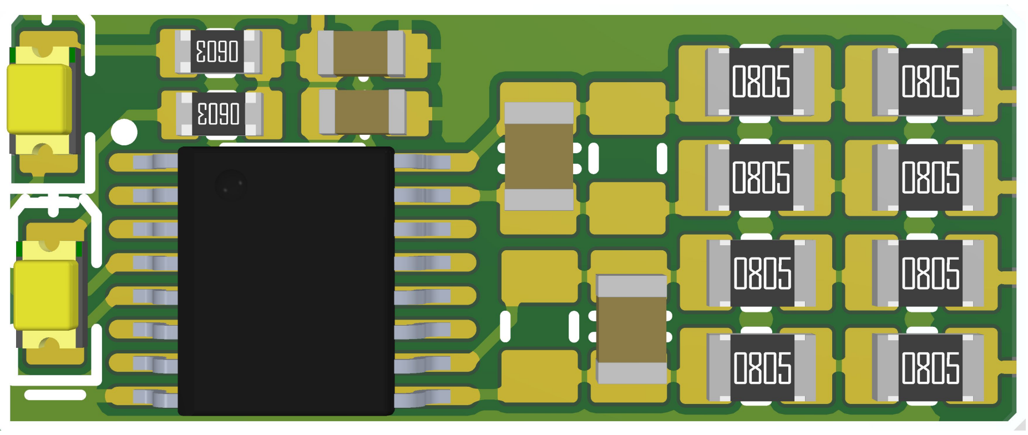
[picture p117: page 1]
