andreika-git/hellen-one/modules/input/0.1/input-pcb3d.pdf

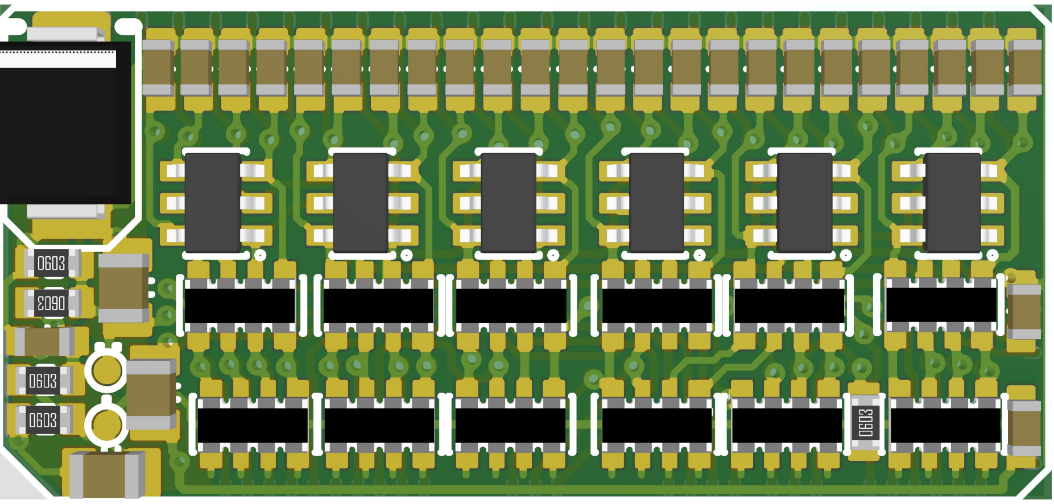
[picture p118: page 1]
