andreika-git/hellen-one/modules/can/0.1/can-pcb3d.pdf

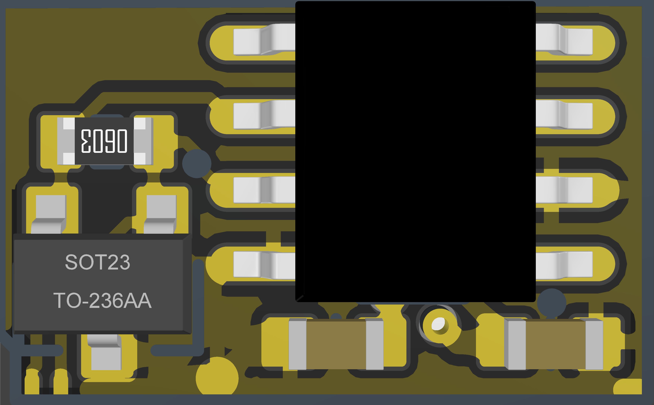
[picture p119: page 1]
