andreika-git/hellen-one/modules/sd/0.1/sd-pcb3d.pdf

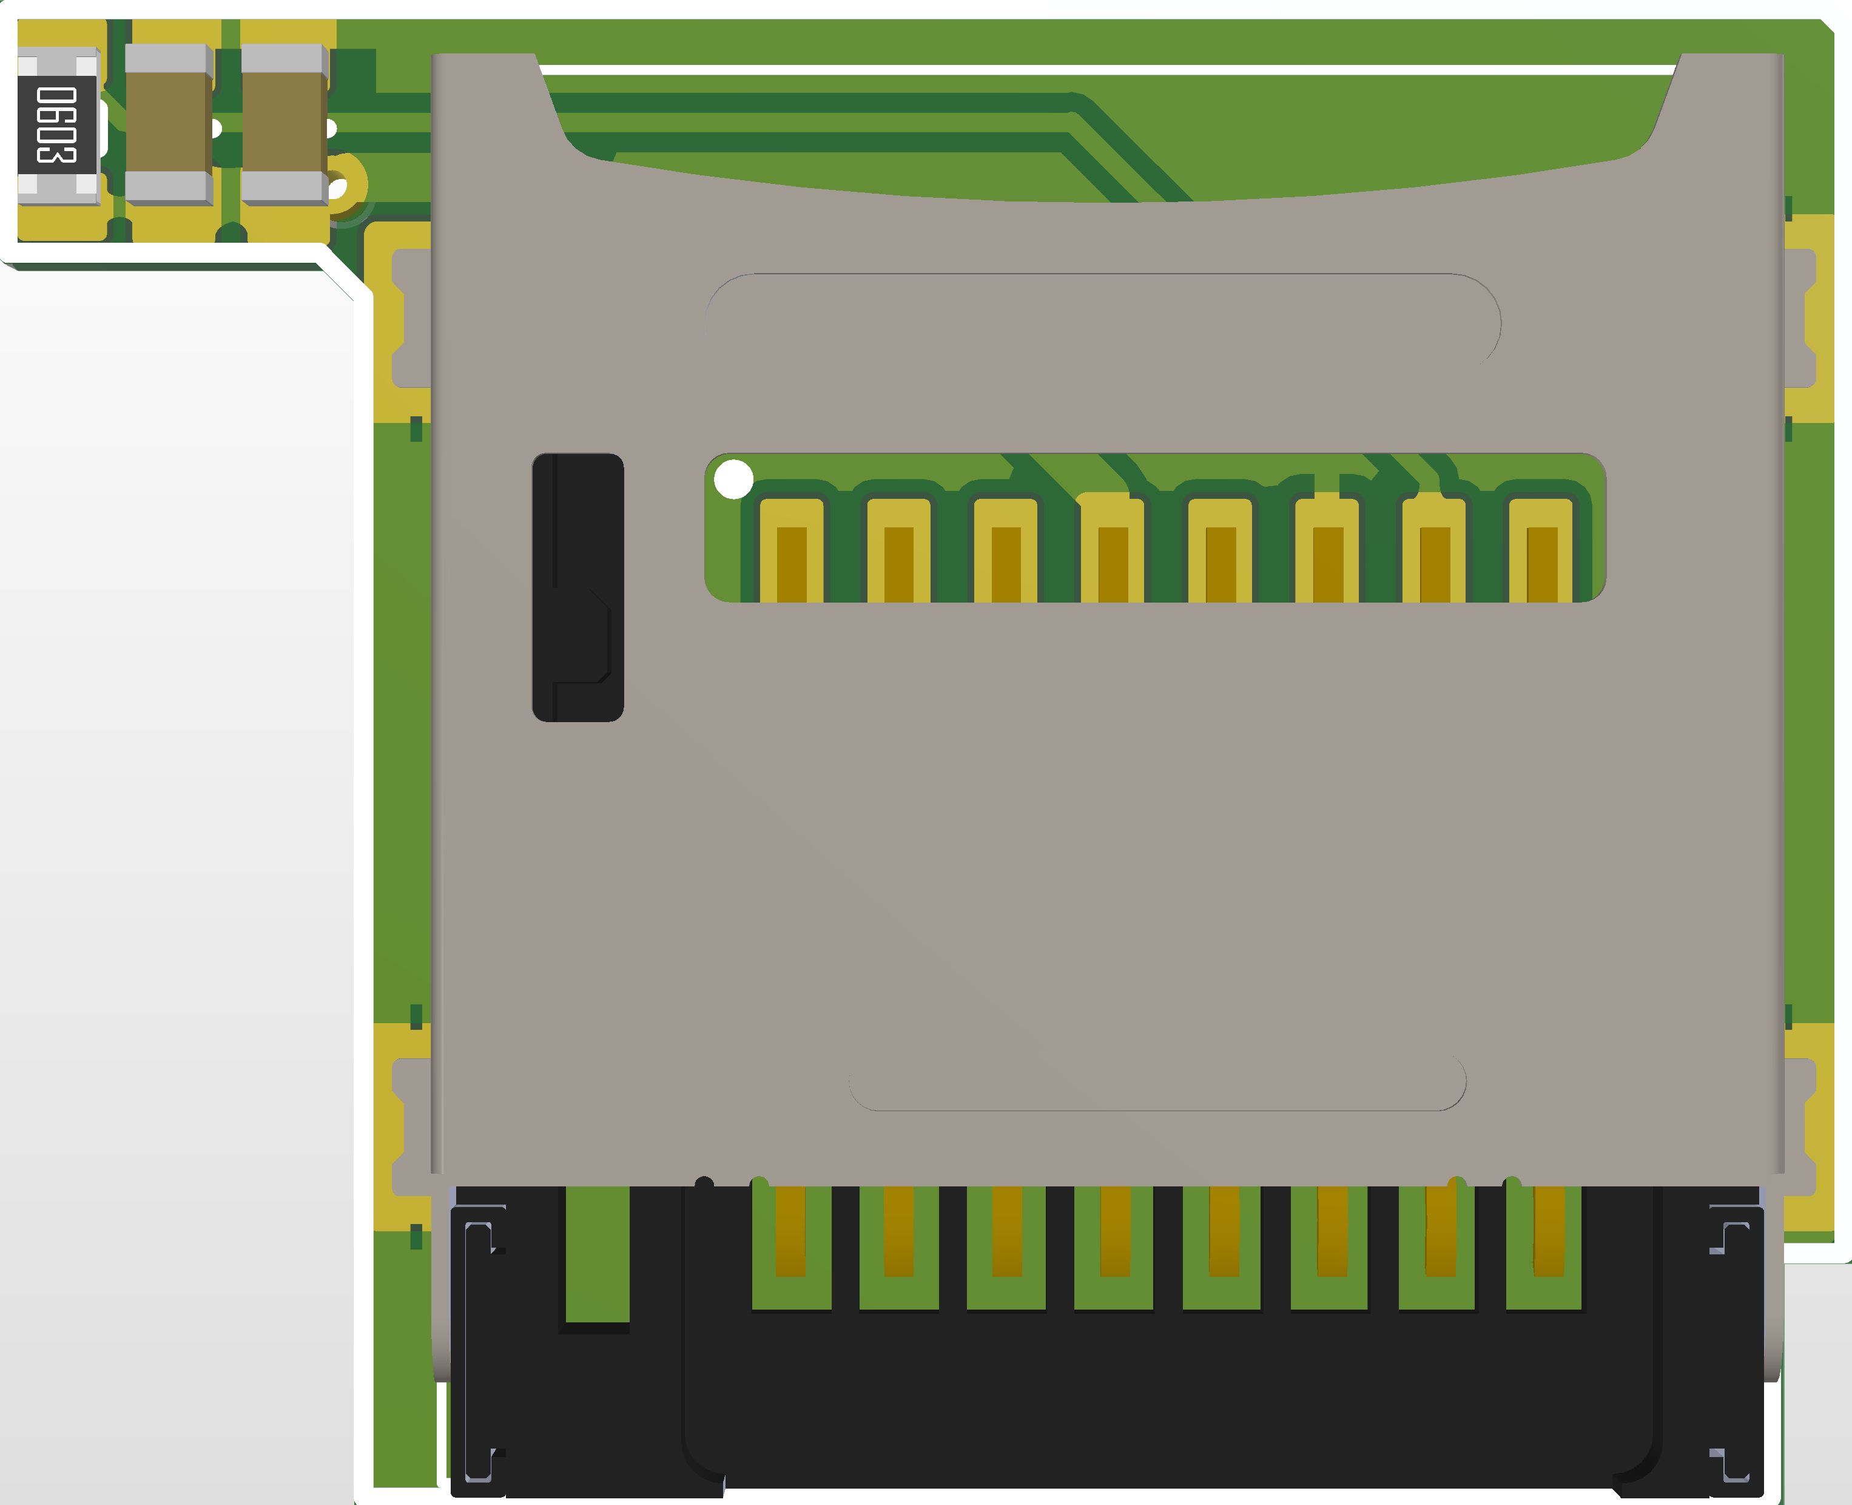
[picture p120: page 1]
