andreika-git/hellen-one/modules/stlink/0.1/stlink-pcb3d.pdf

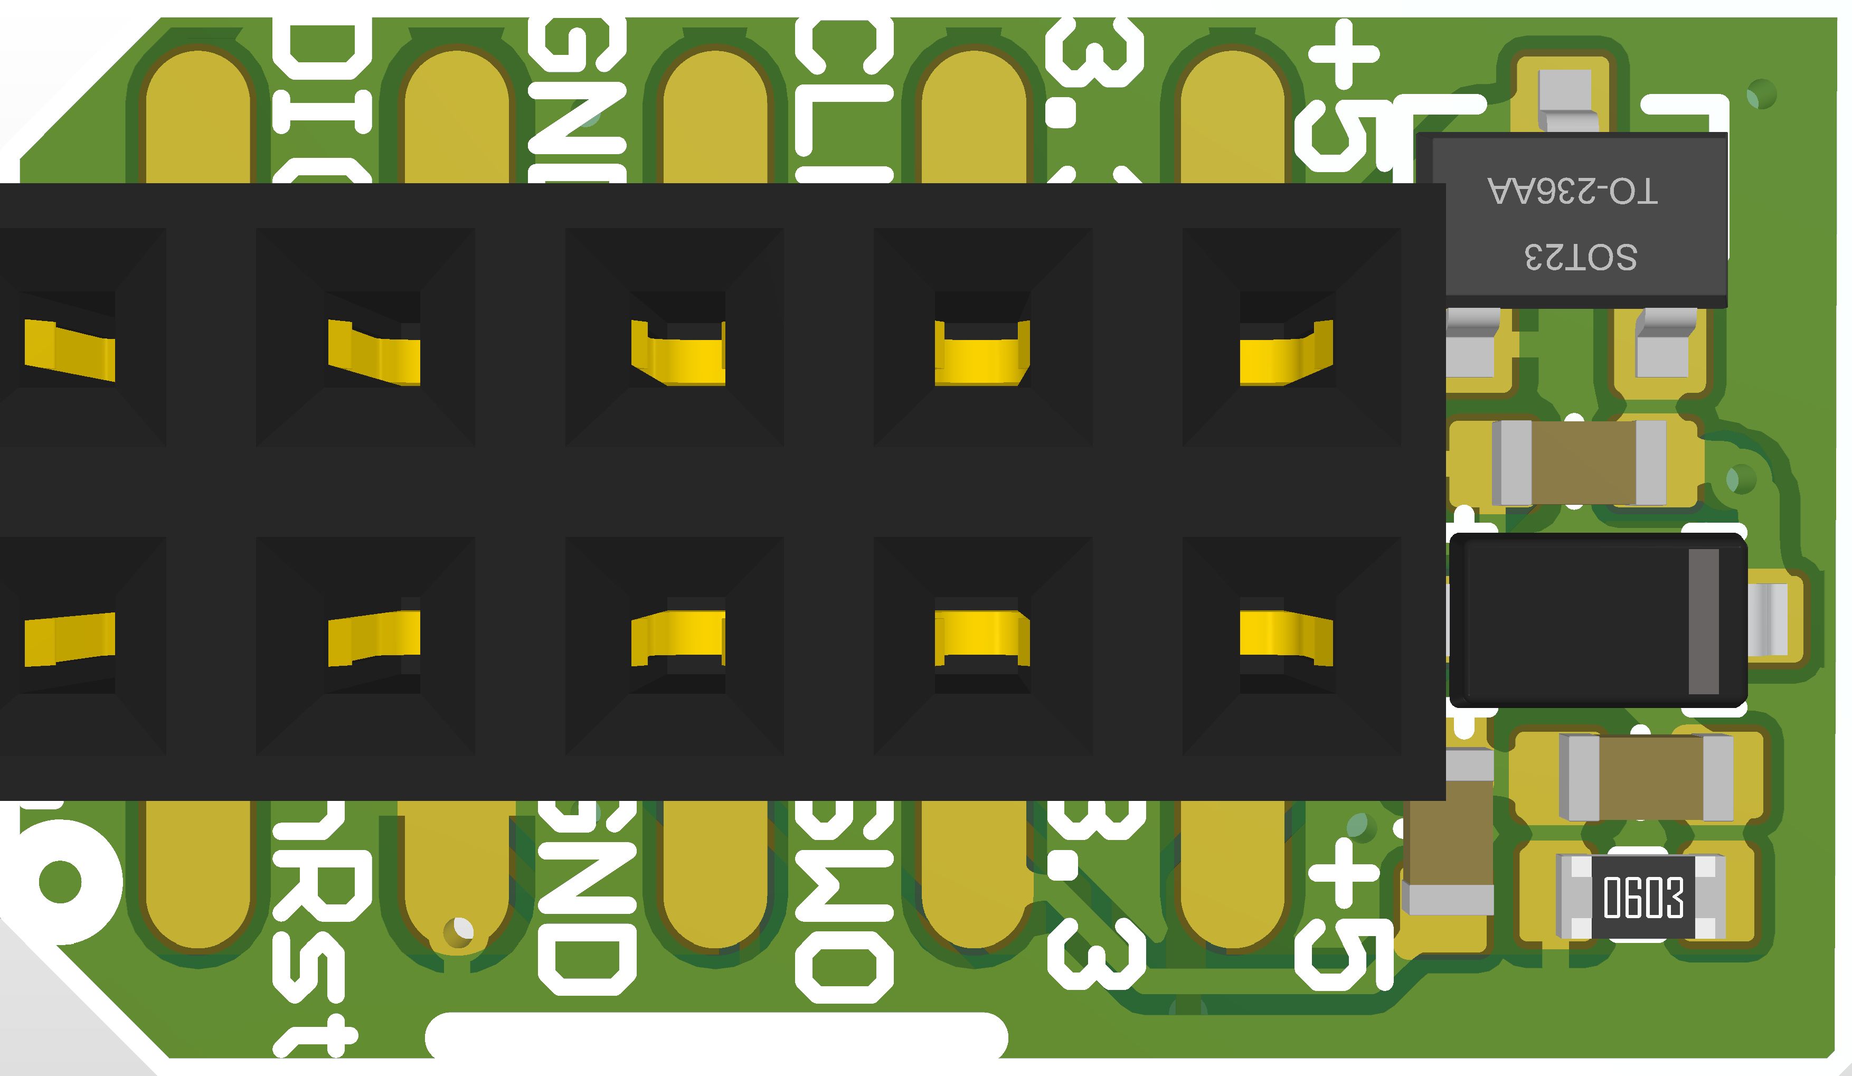
[picture p121: page 1]
