andreika-git/hellen-one/modules/uaefi/0.1/uaefi-schematic.pdf

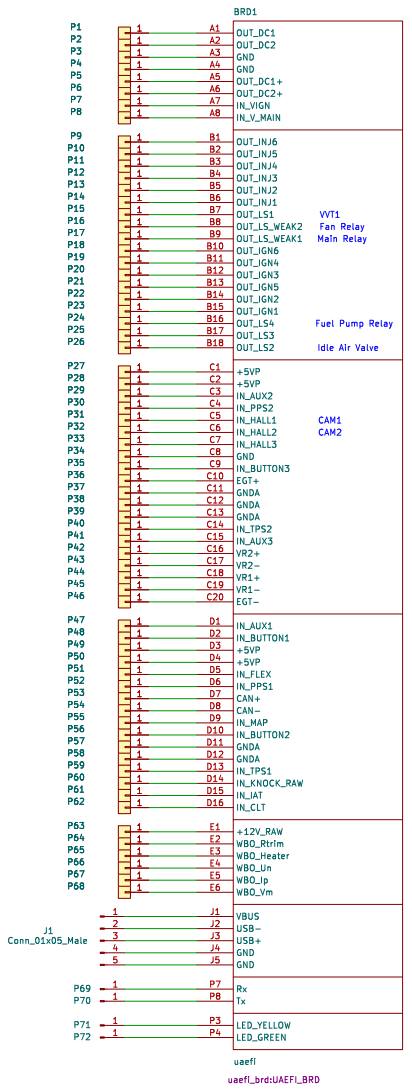
[picture p122: page 1]

BRD1
Idle Air Valve Main Relay VVT1

Id: 1/1 Title: VR MAX9924 module
