andreika-git/hellen-one/modules/mega-mcu100/0.2/mega-mcu100-schematic.pdf

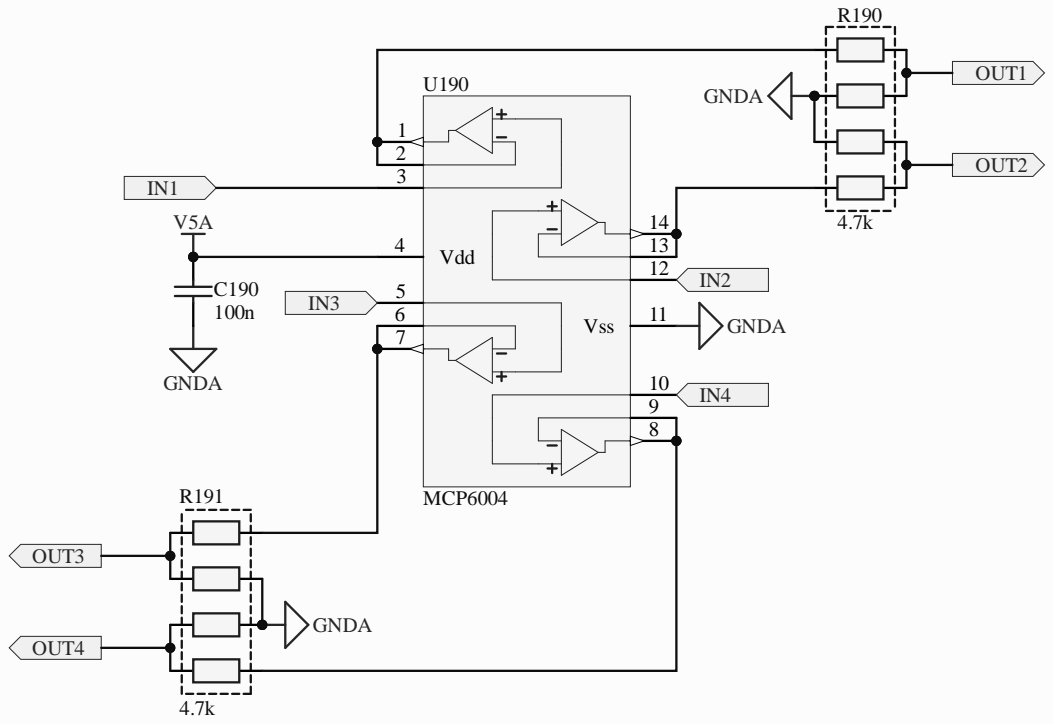
[picture p125: page 3]

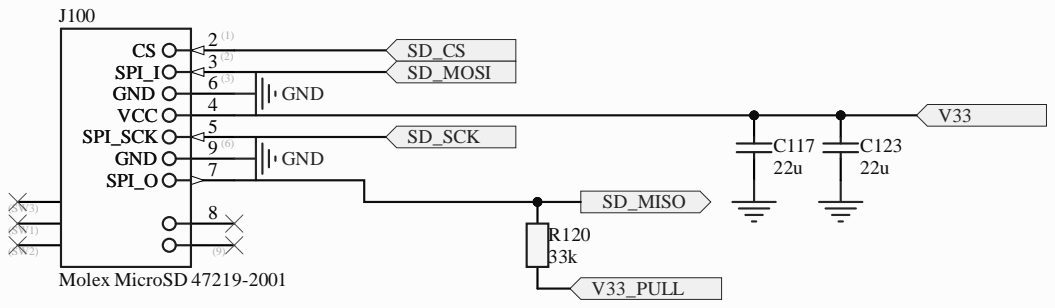
[picture p126: page 4]

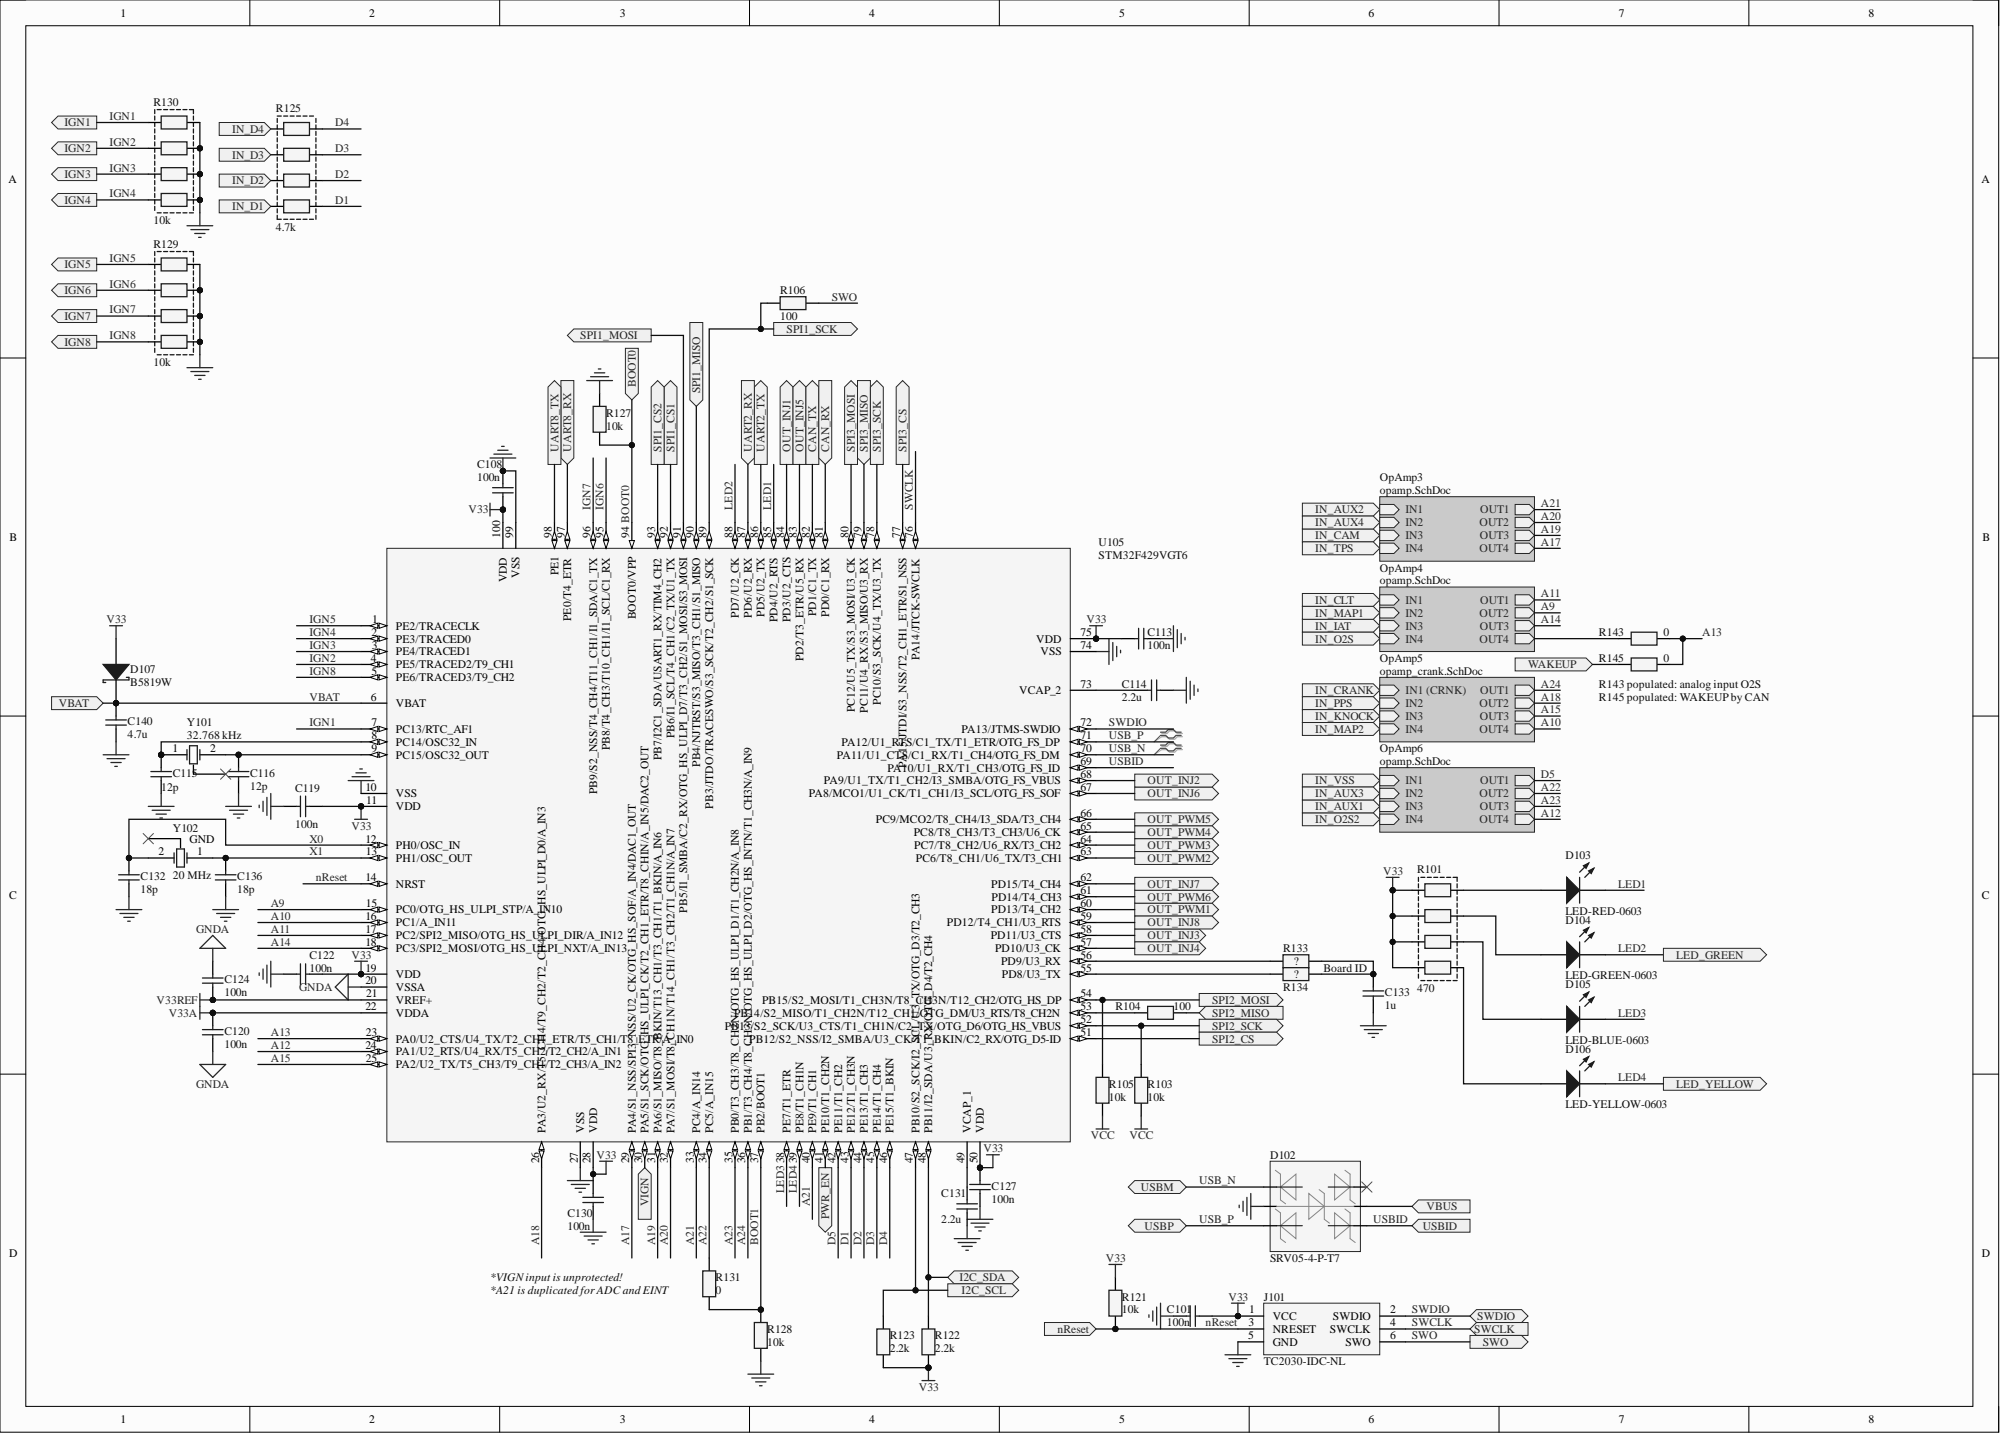
[picture p127: page 5]

R143 populated: analog input O2S
R145 populated: WAKEUP by CAN

PC15/OSC32_OUT 9

VSS 10

*VIGN input is unprotected!
*A21 is duplicated for ADC and EINT

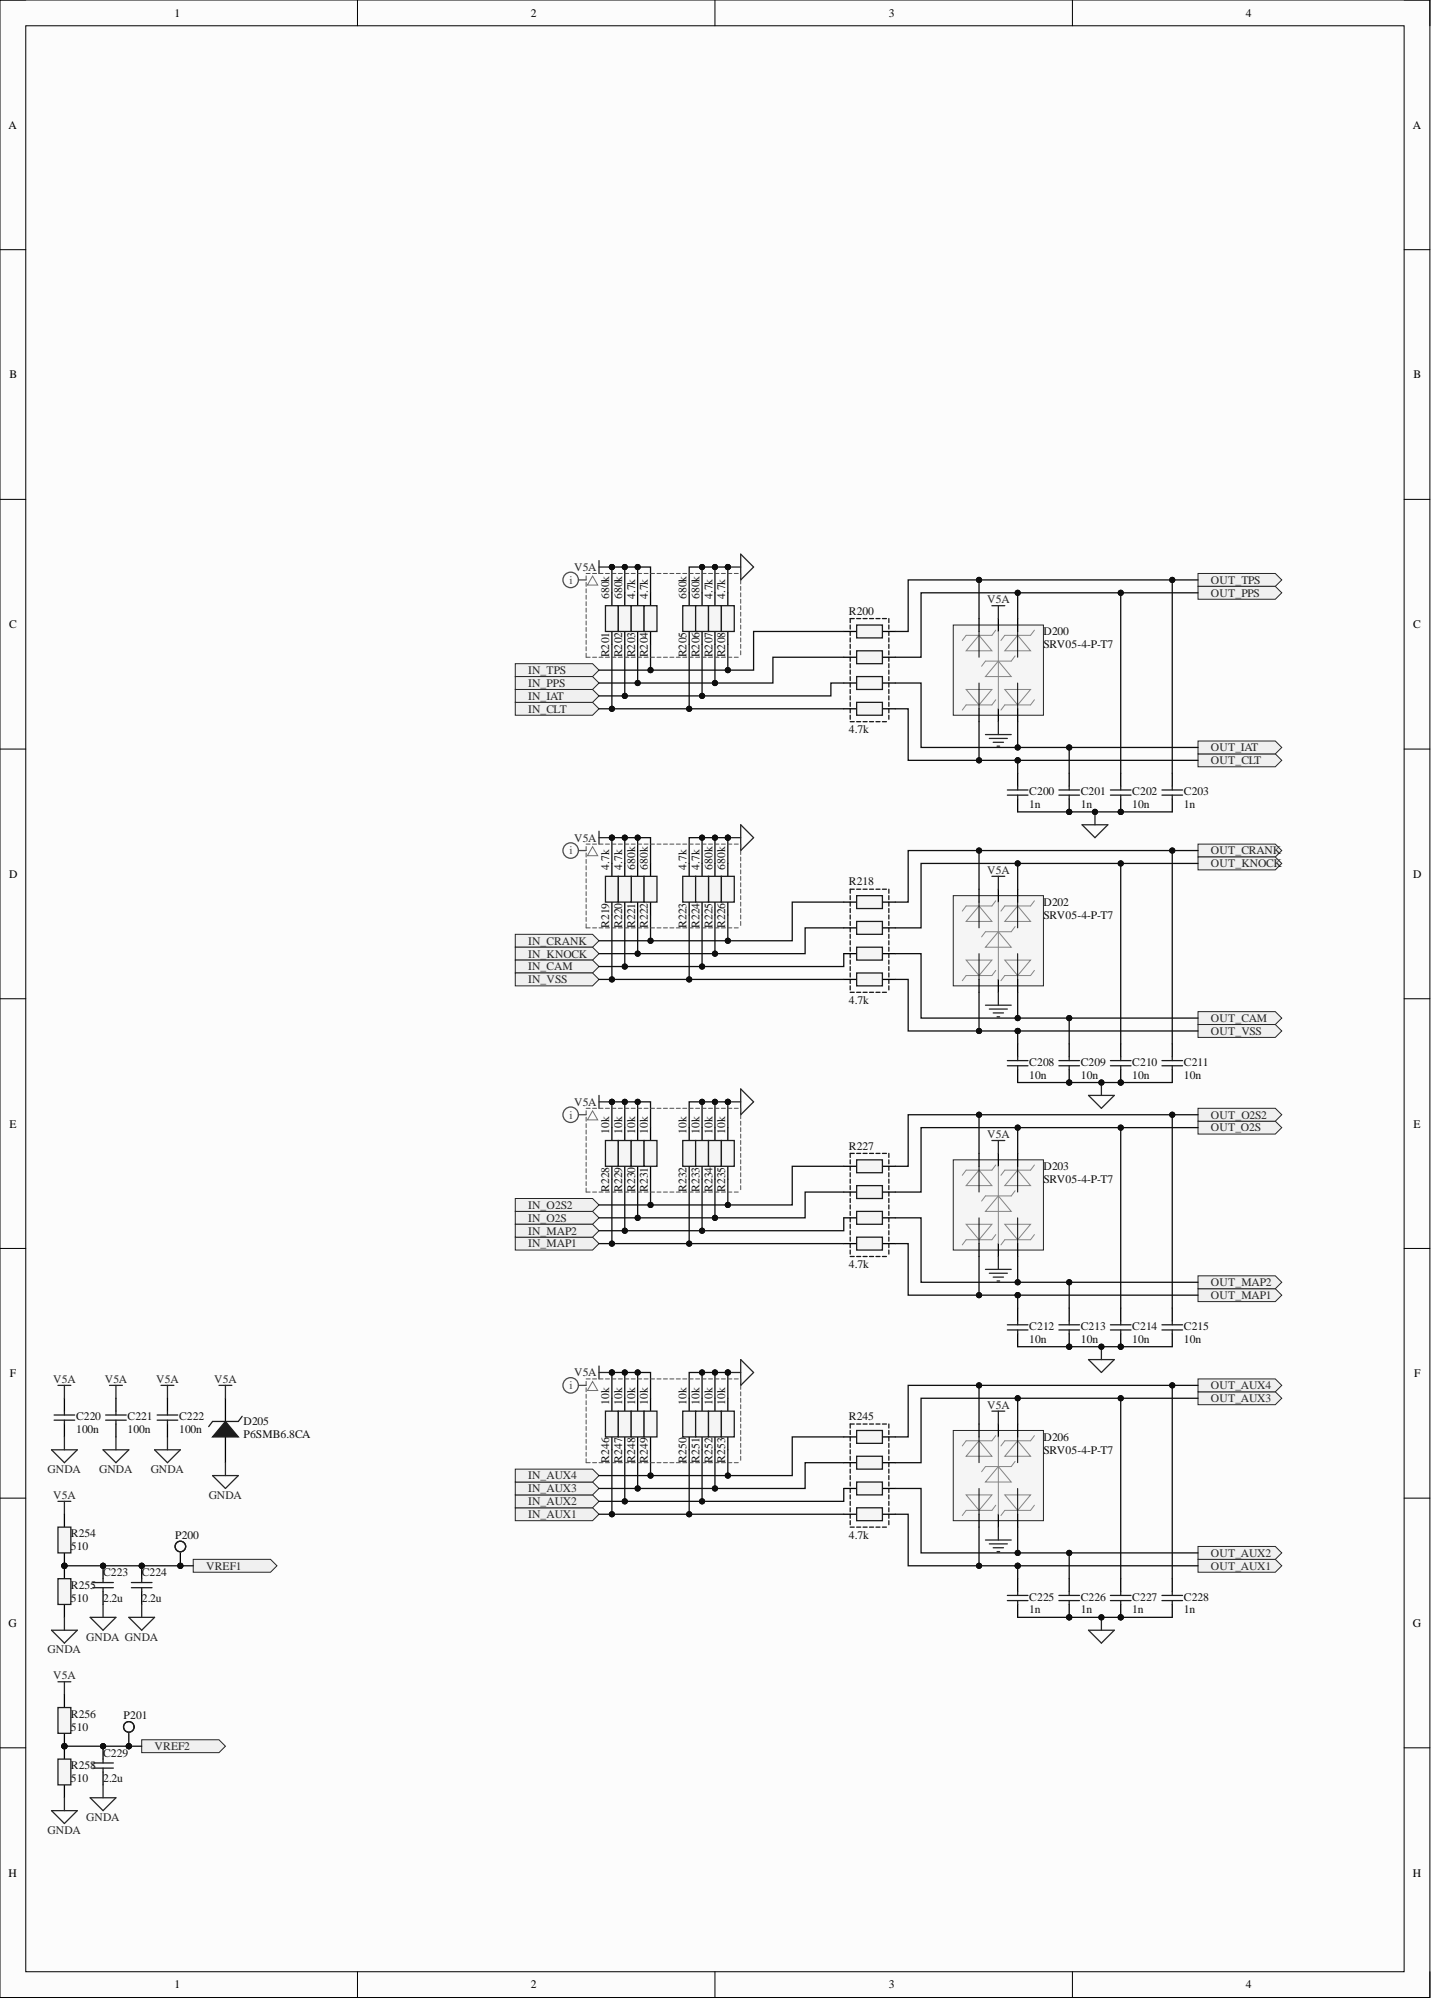
[picture p128: page 6]

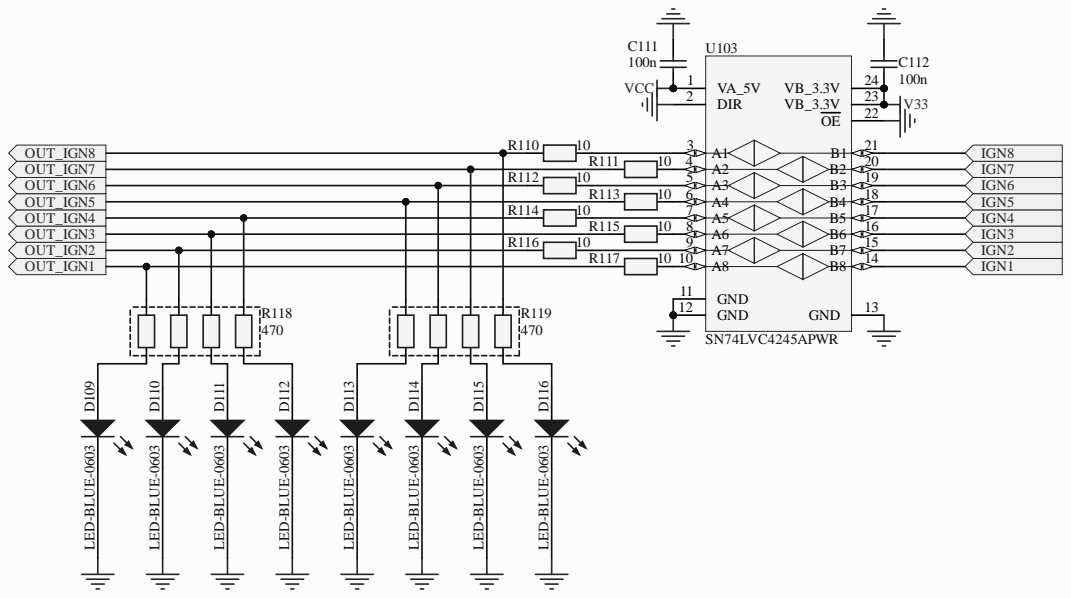
[picture p129: page 7]

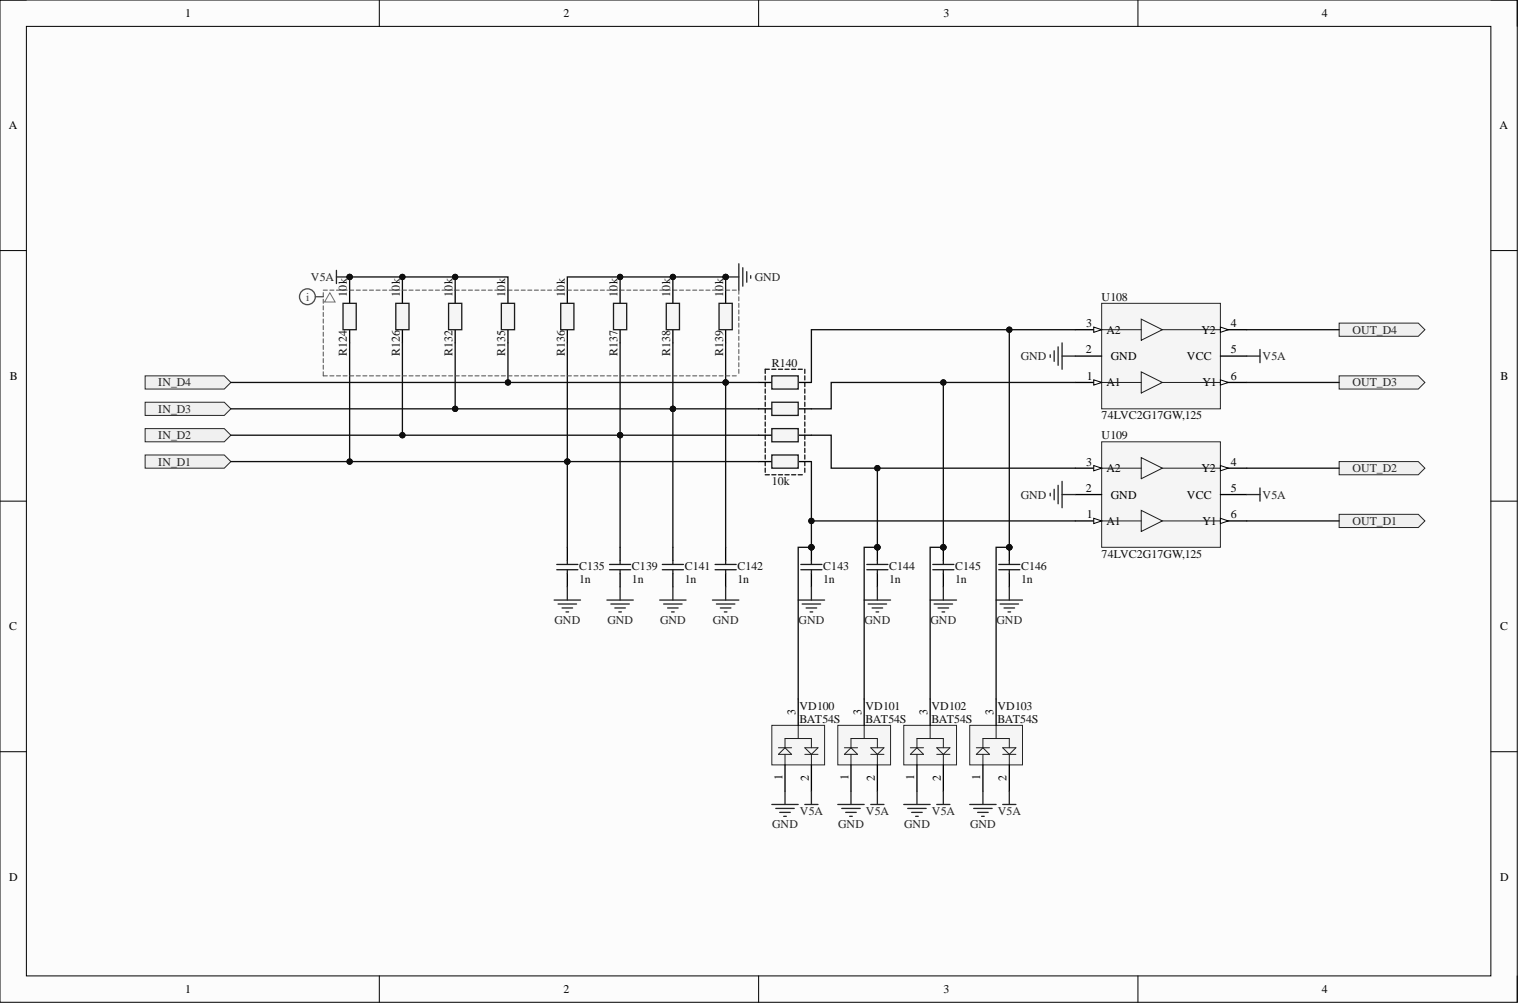
[picture p130: page 8]

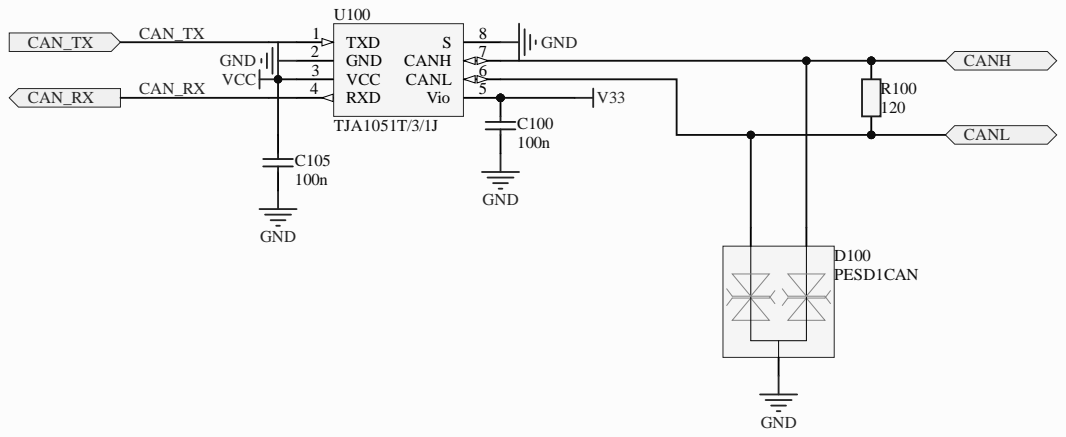
[picture p131: page 9]

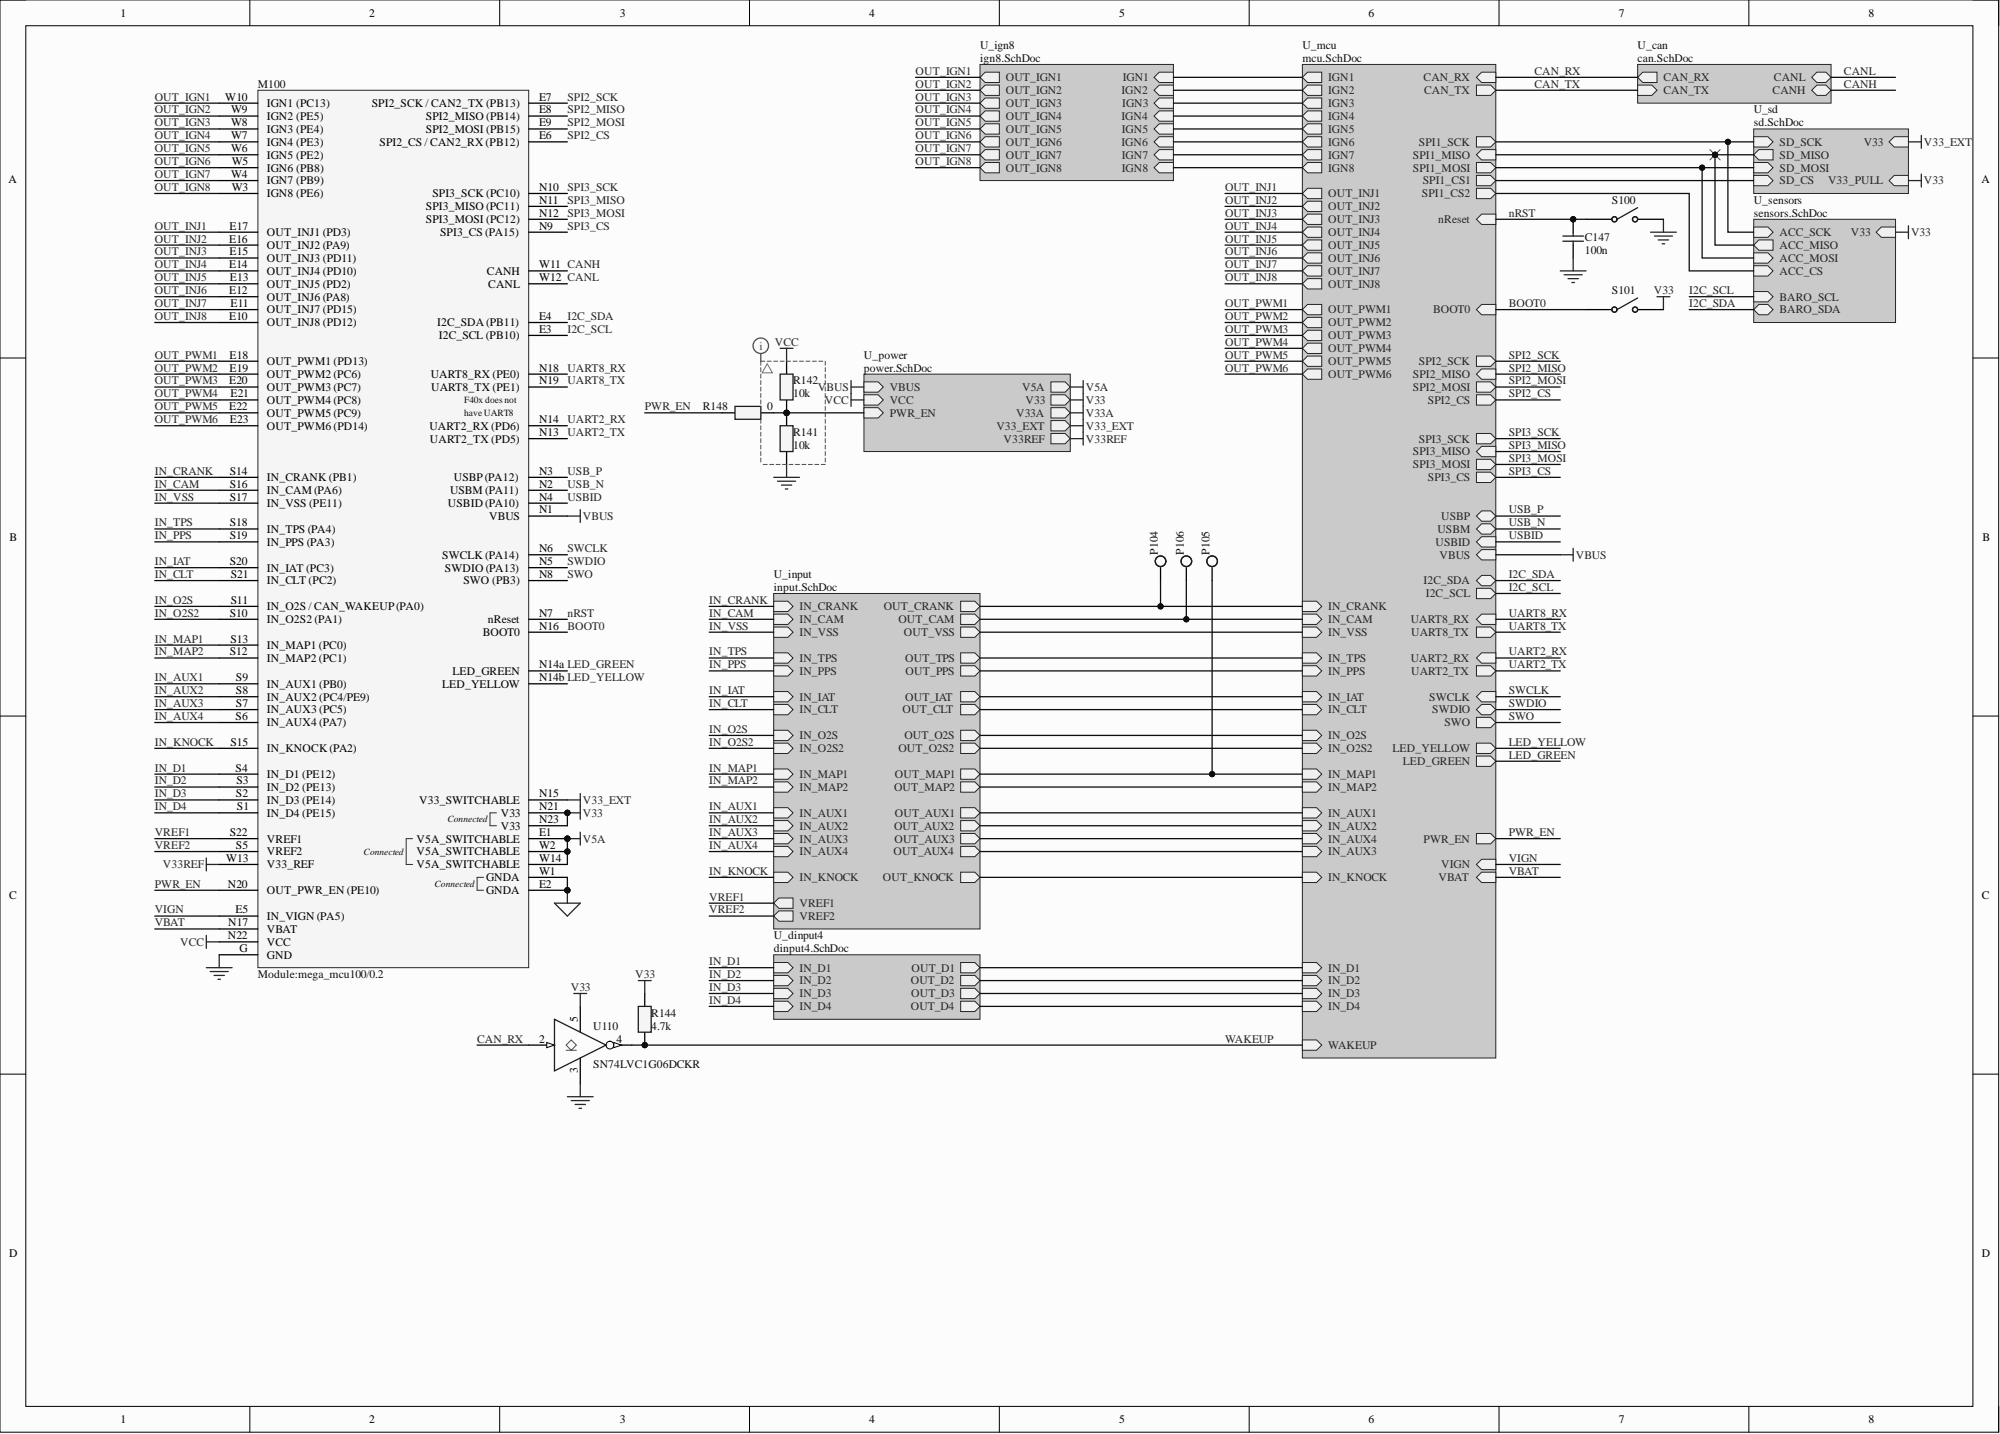
[picture p132: page 10]

USBM USBP USBID VBUS

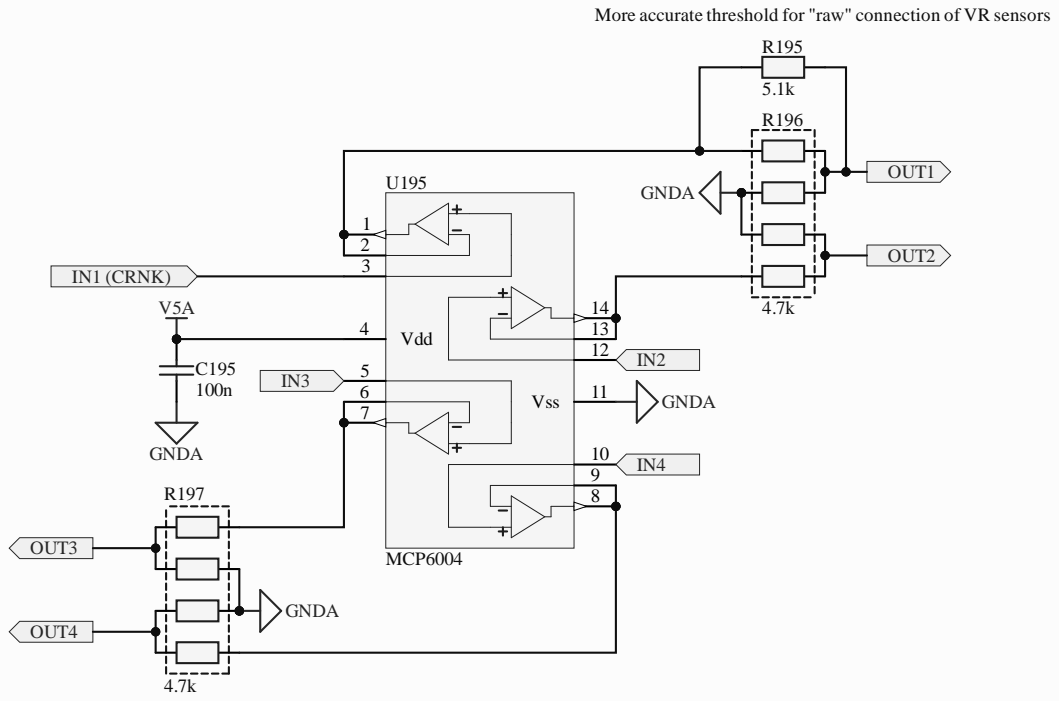
[picture p133: page 11]

More accurate threshold for "raw" connection of VR sensors

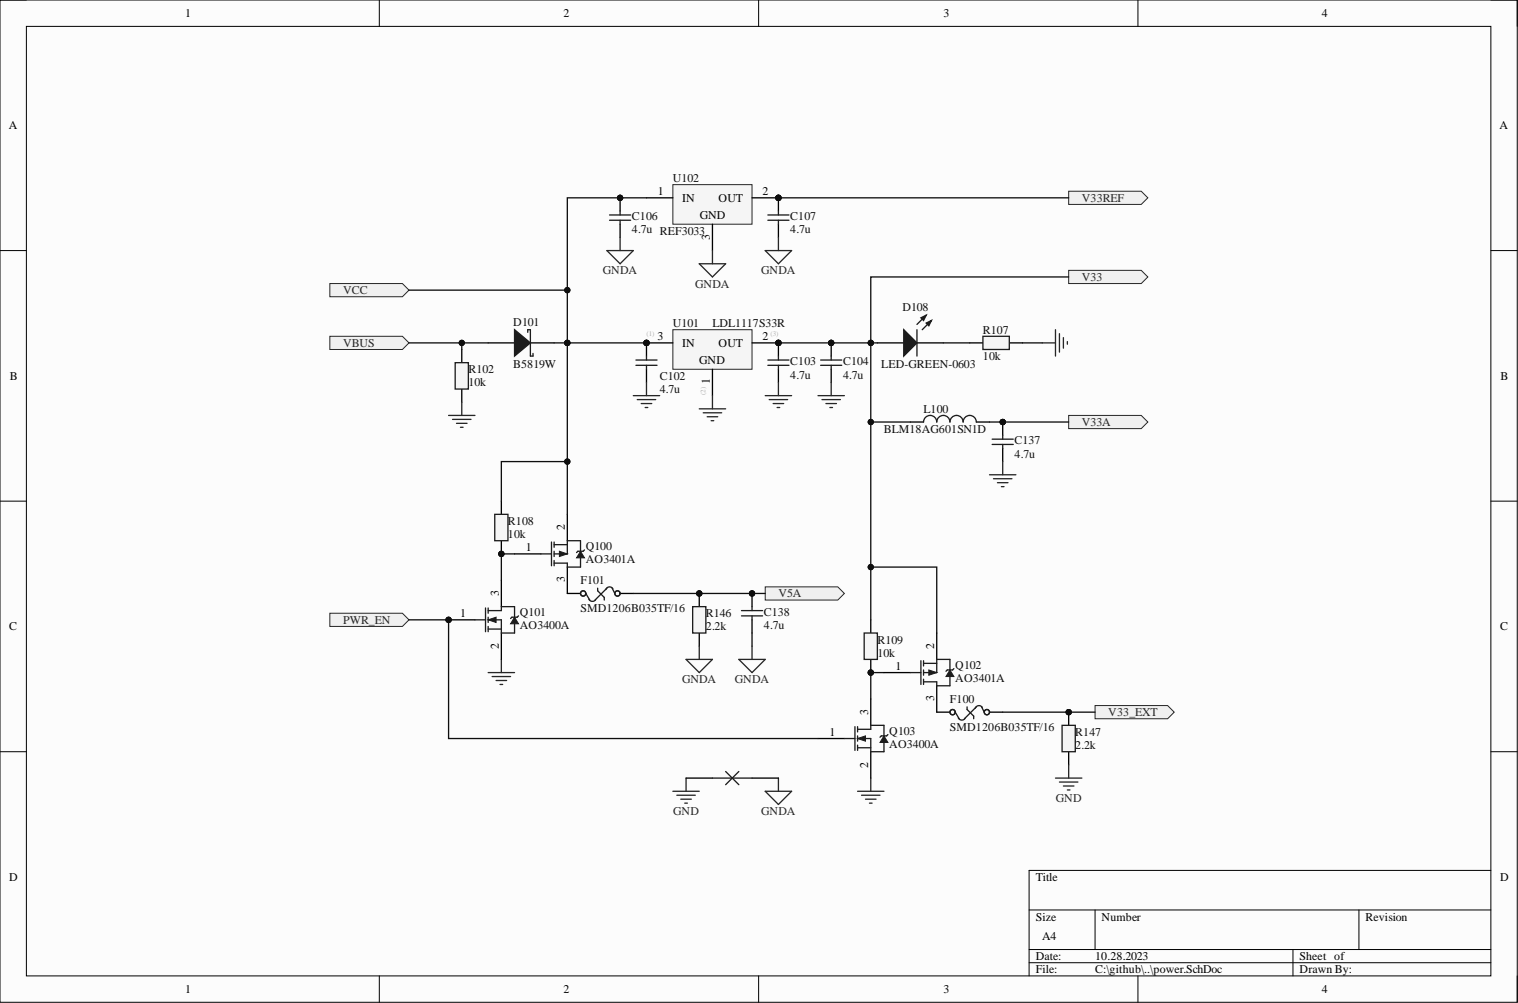
[picture p134: page 12]

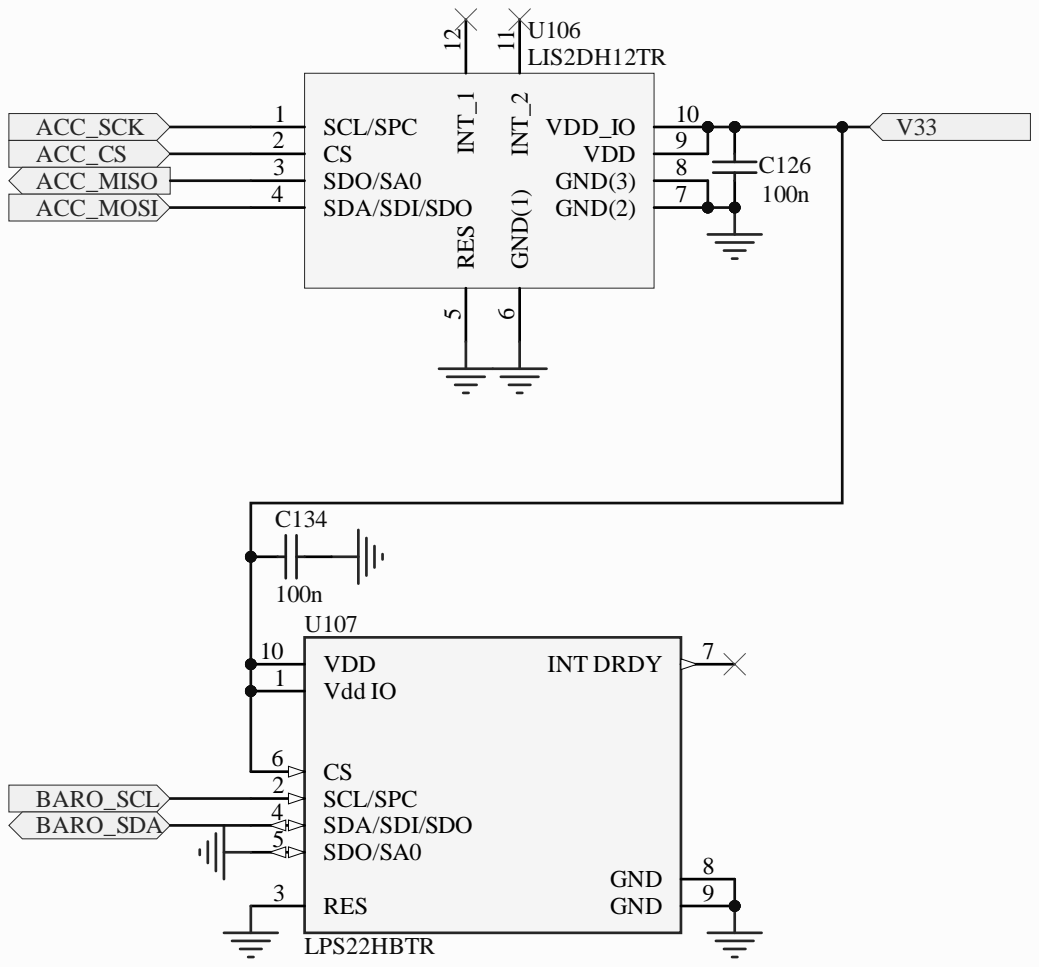
[picture p135: page 13]
