andreika-git/hellen-one/modules/mega-mcu100/0.1/mega-mcu100-schematic.pdf

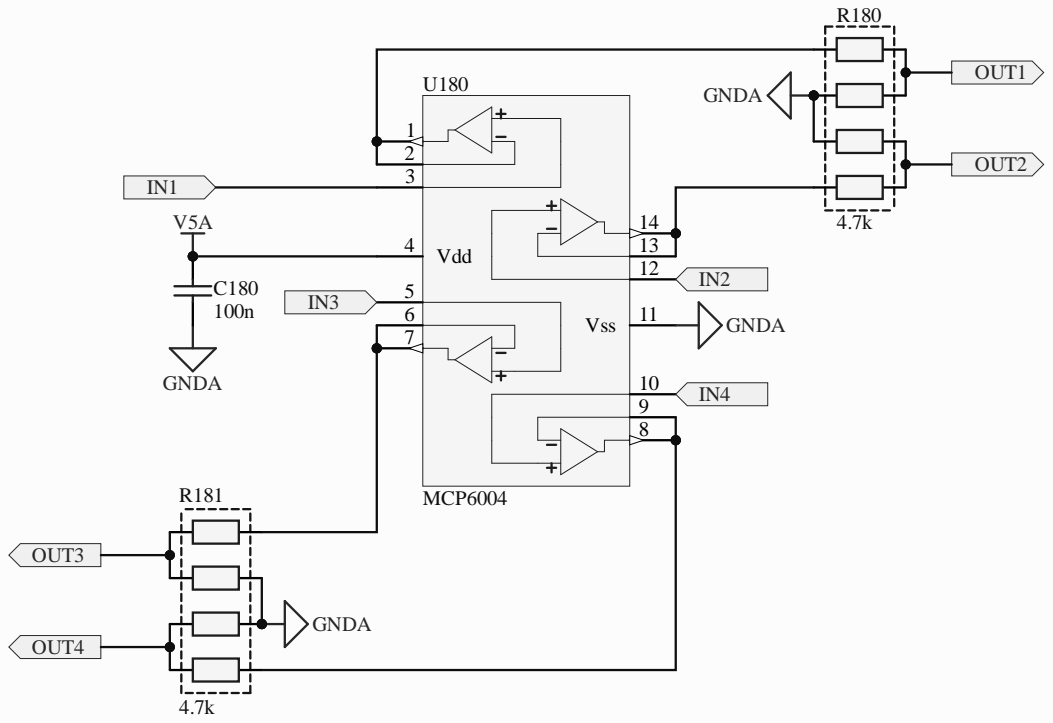
[picture p136: page 1]

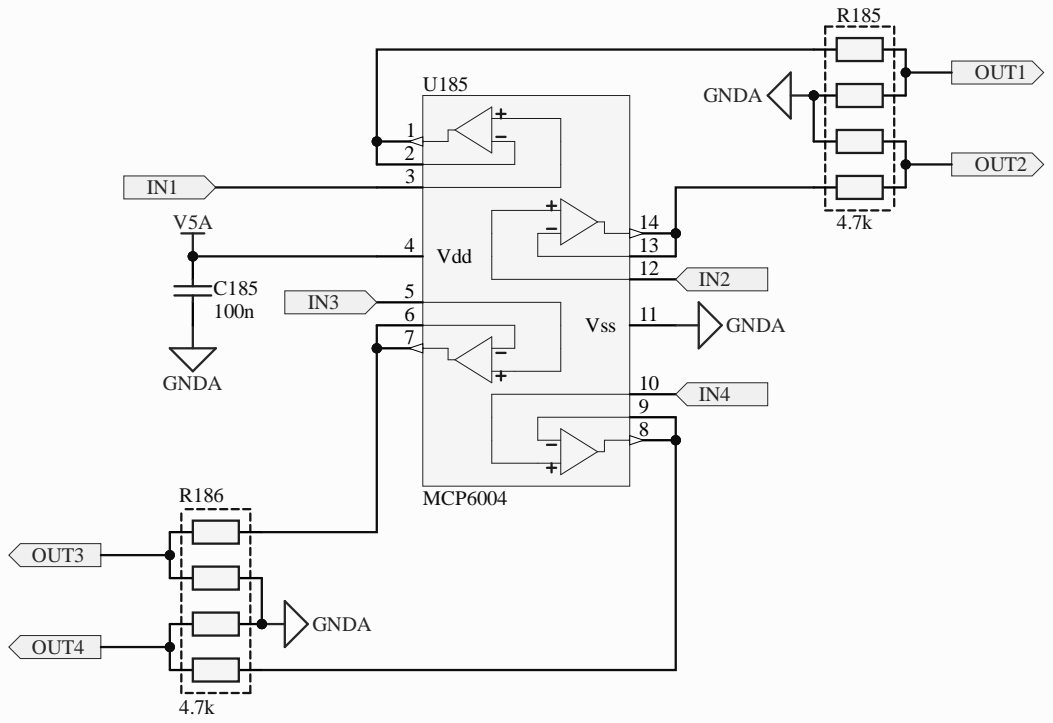
[picture p137: page 2]

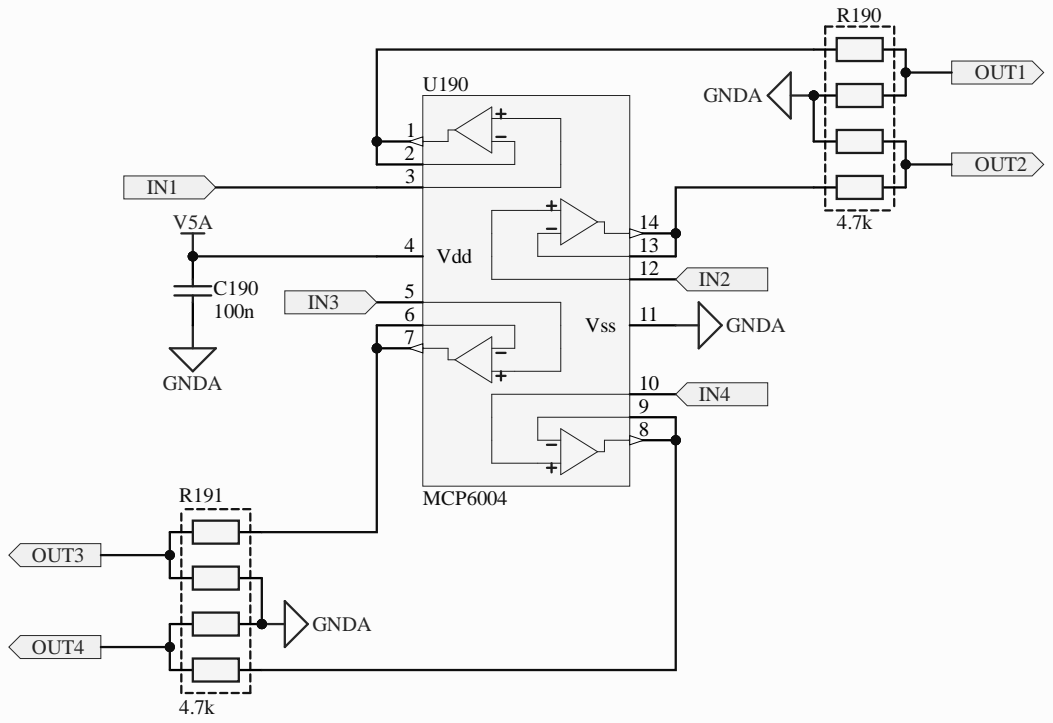
[picture p138: page 3]

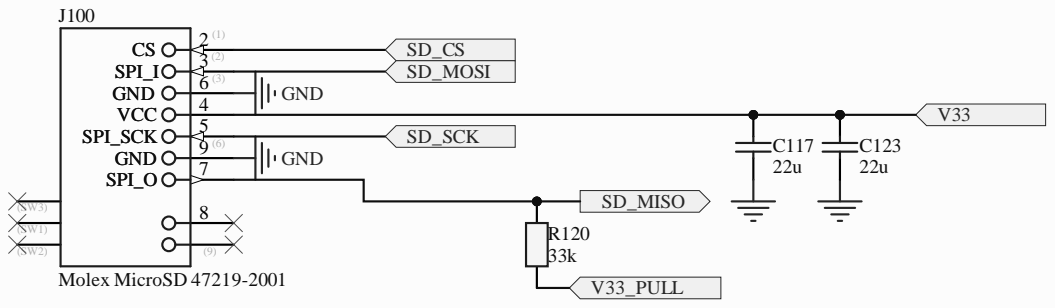
[picture p139: page 4]

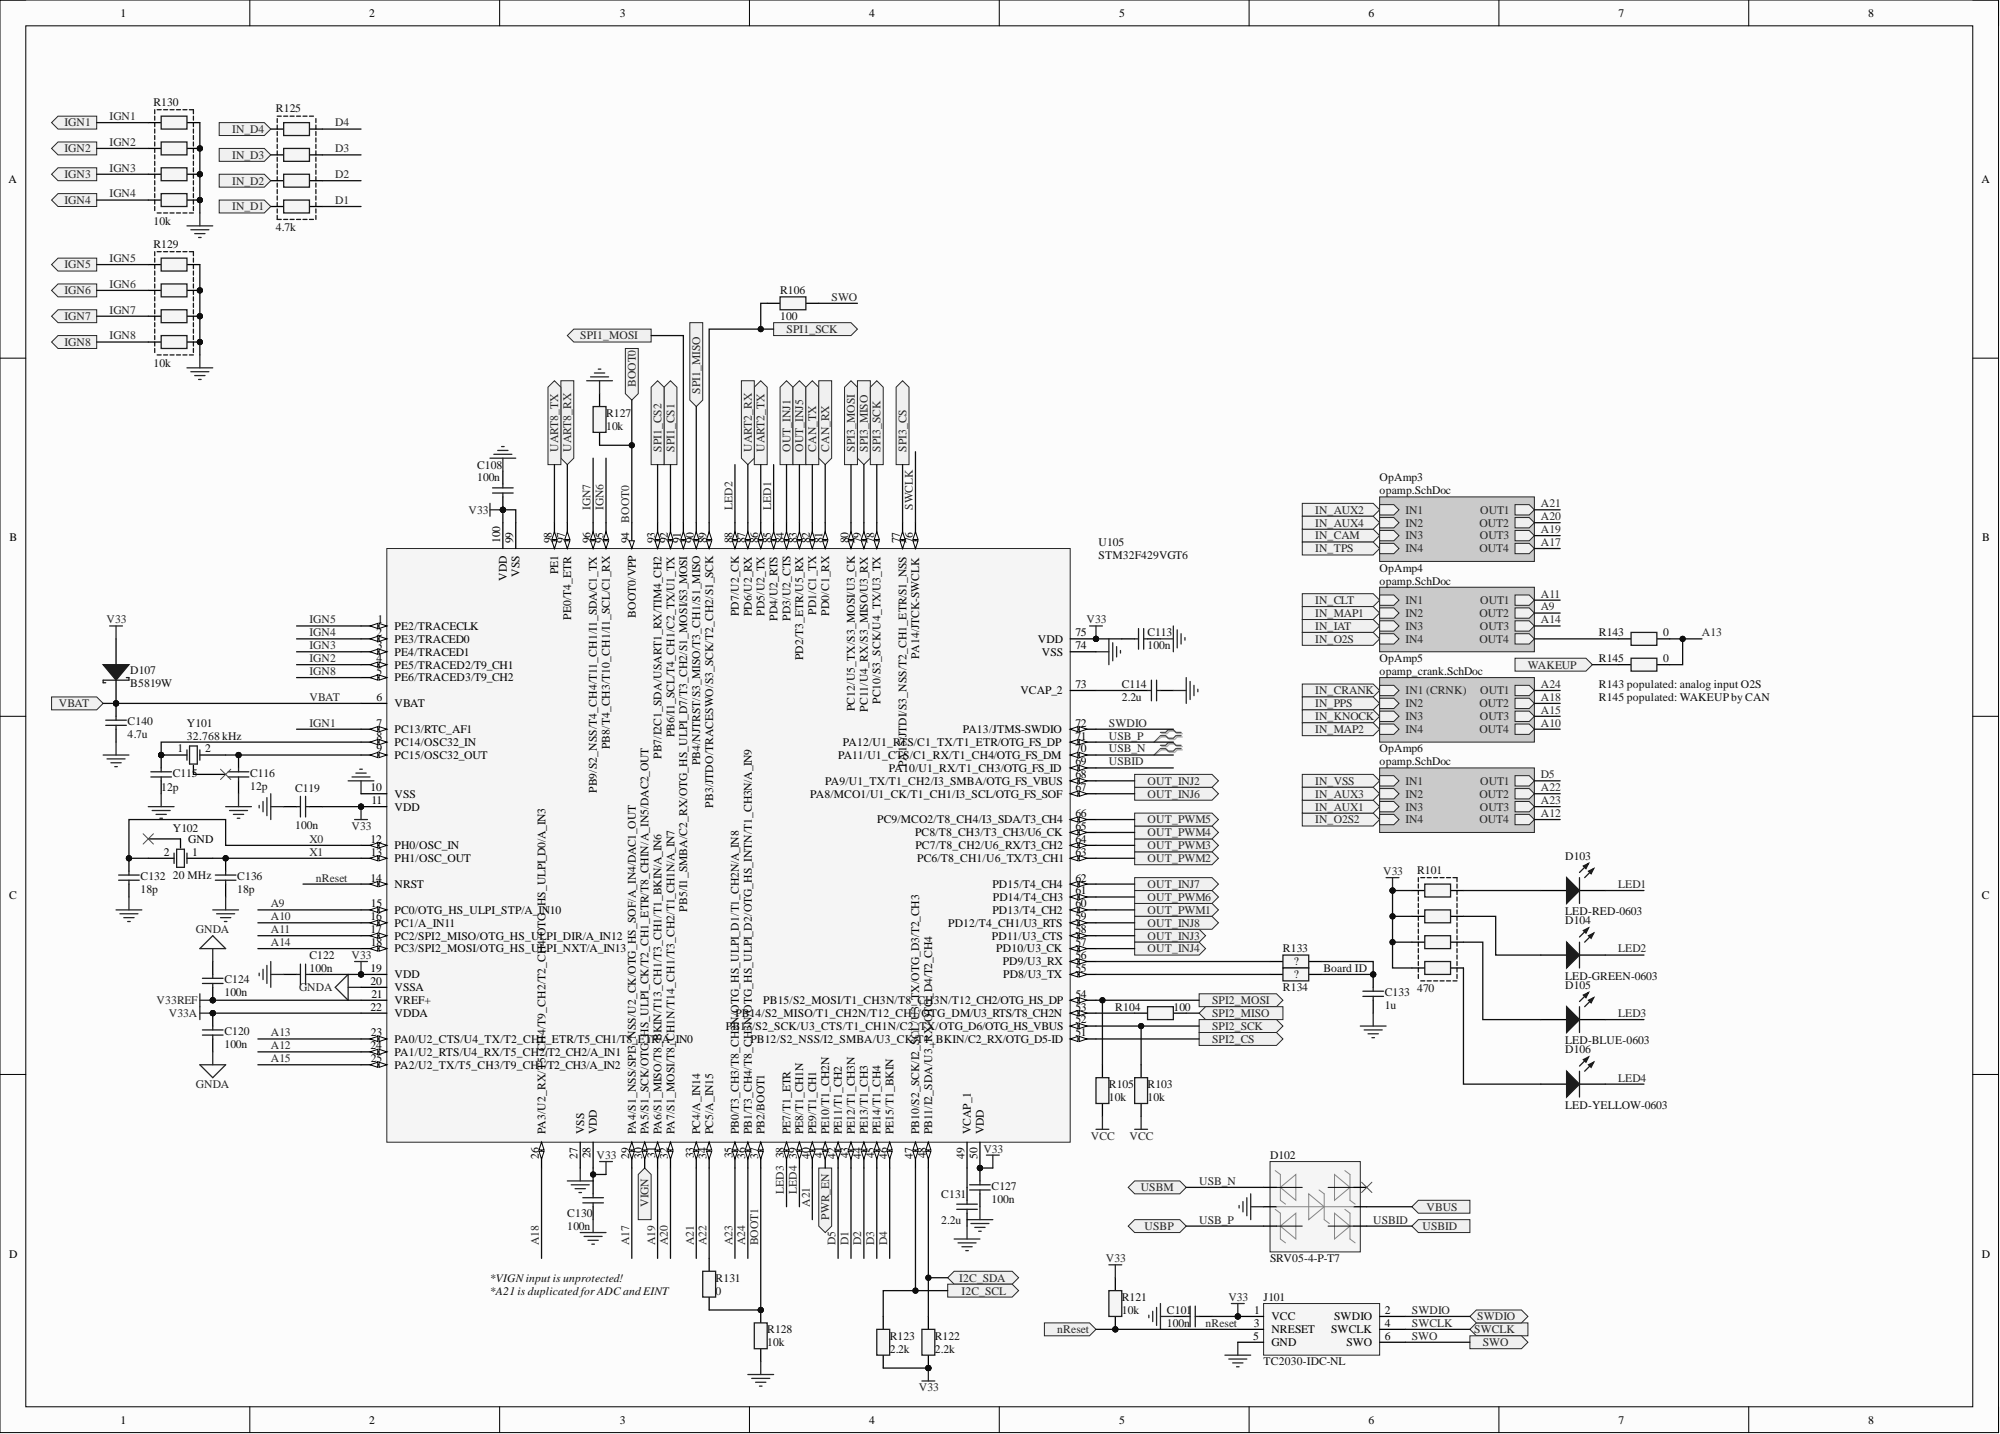
[picture p140: page 5]

R143 populated: analog input O2S
R145 populated: WAKEUP by CAN

*VIGN input is unprotected!
*A21 is duplicated for ADC and EINT

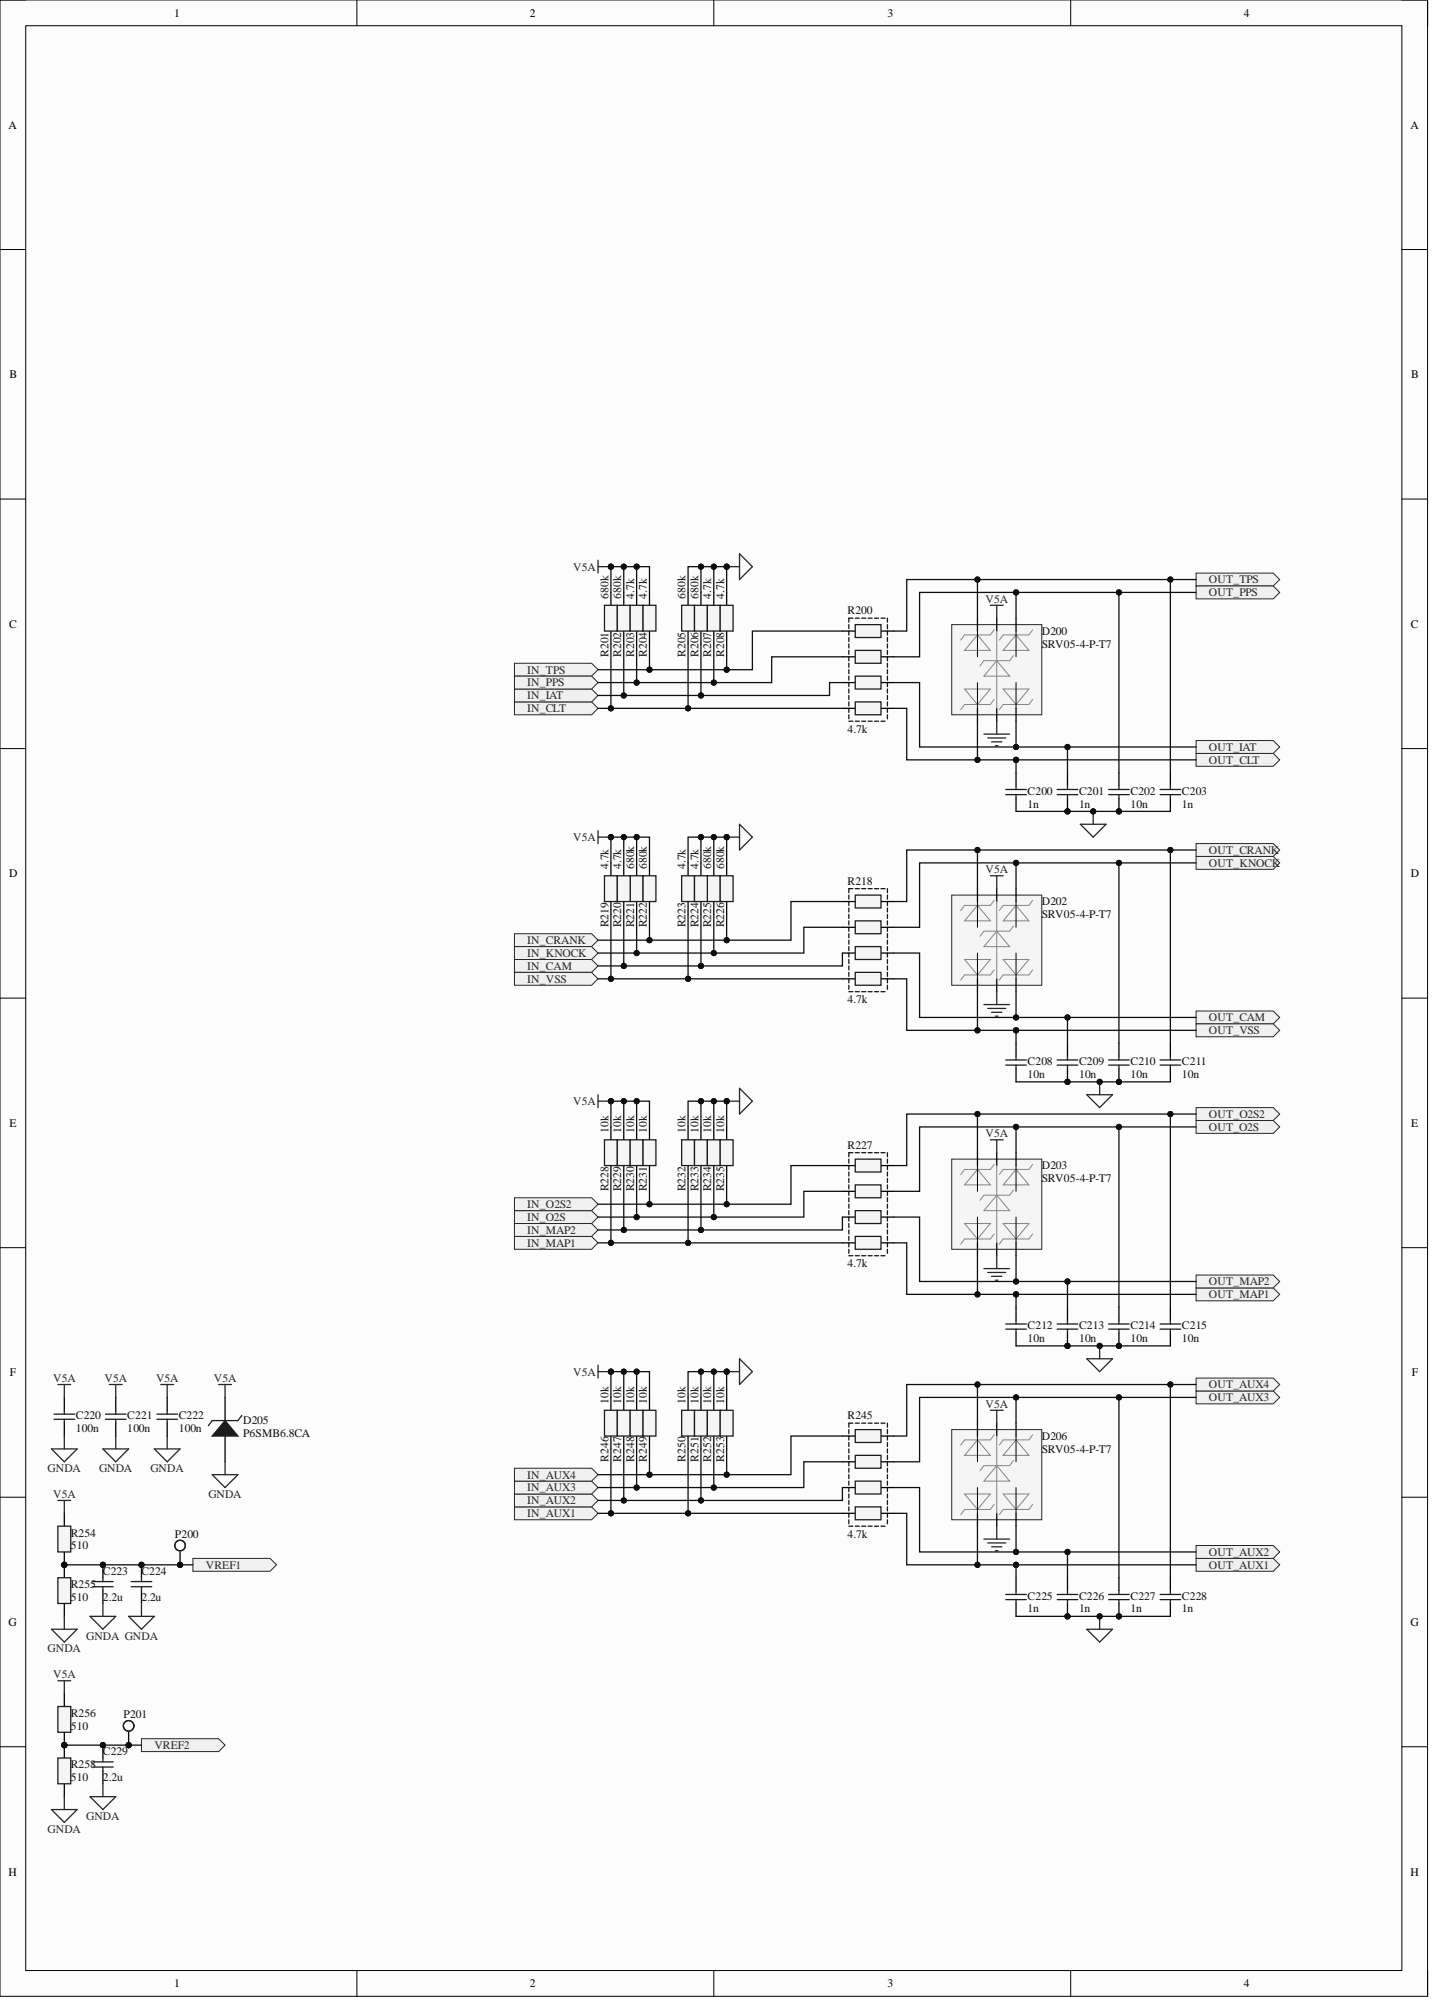
[picture p141: page 6]

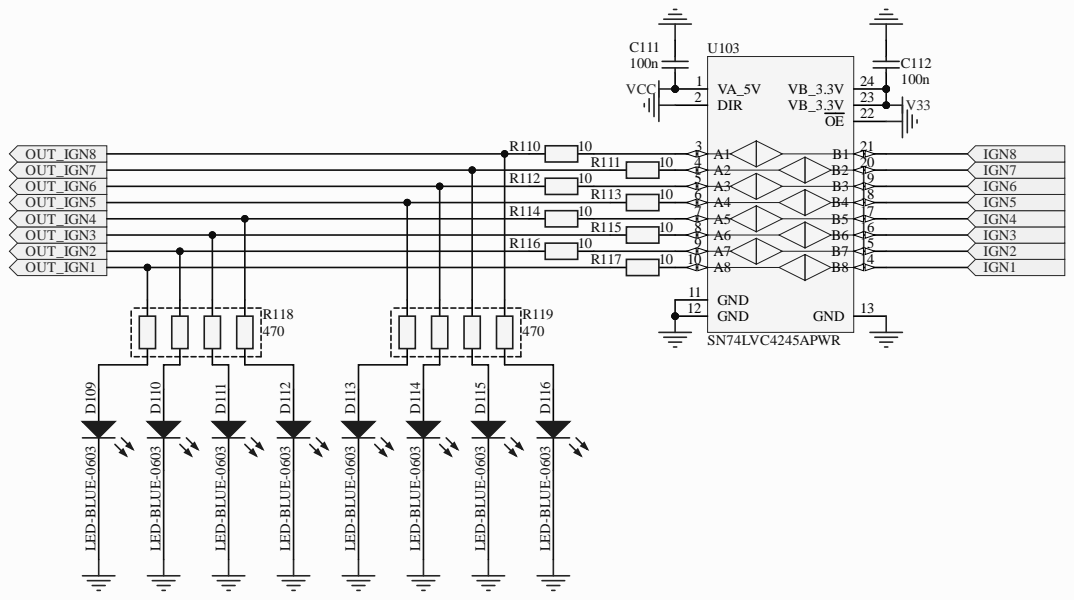
[picture p142: page 7]

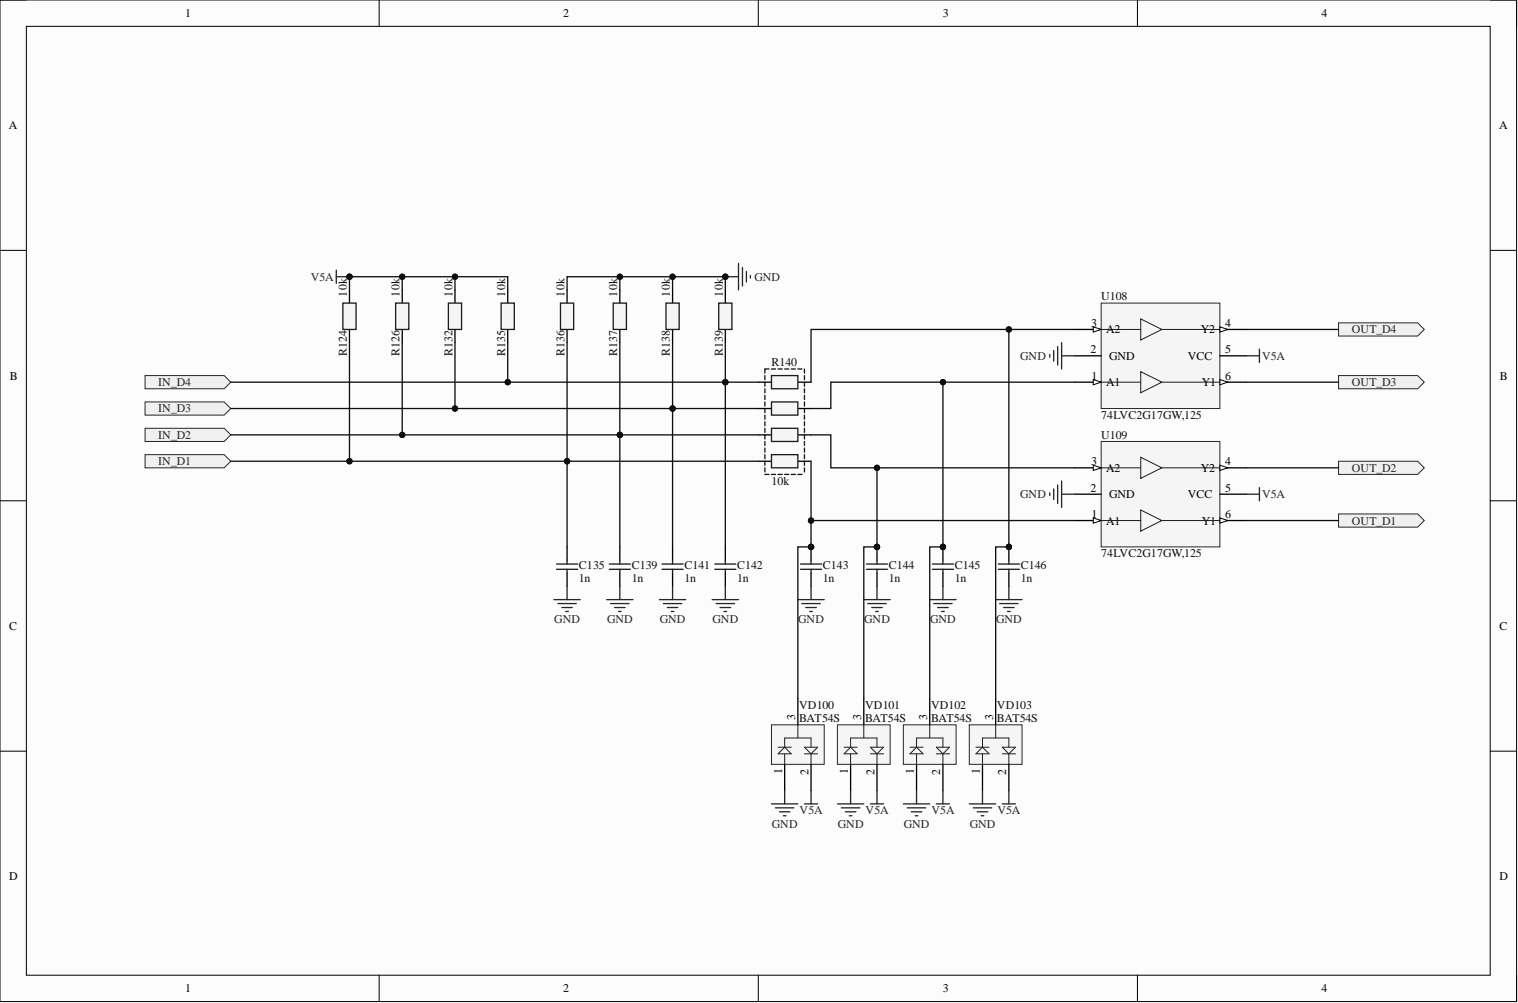
[picture p143: page 8]

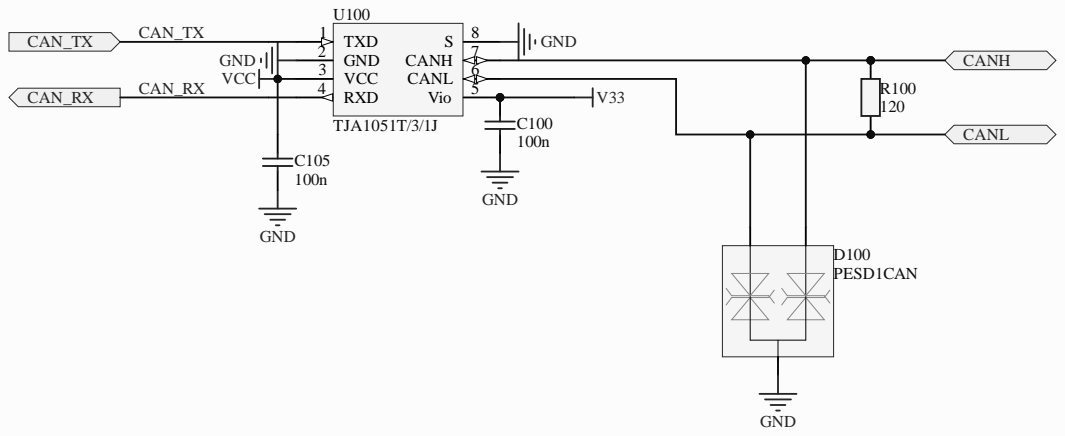
[picture p144: page 9]

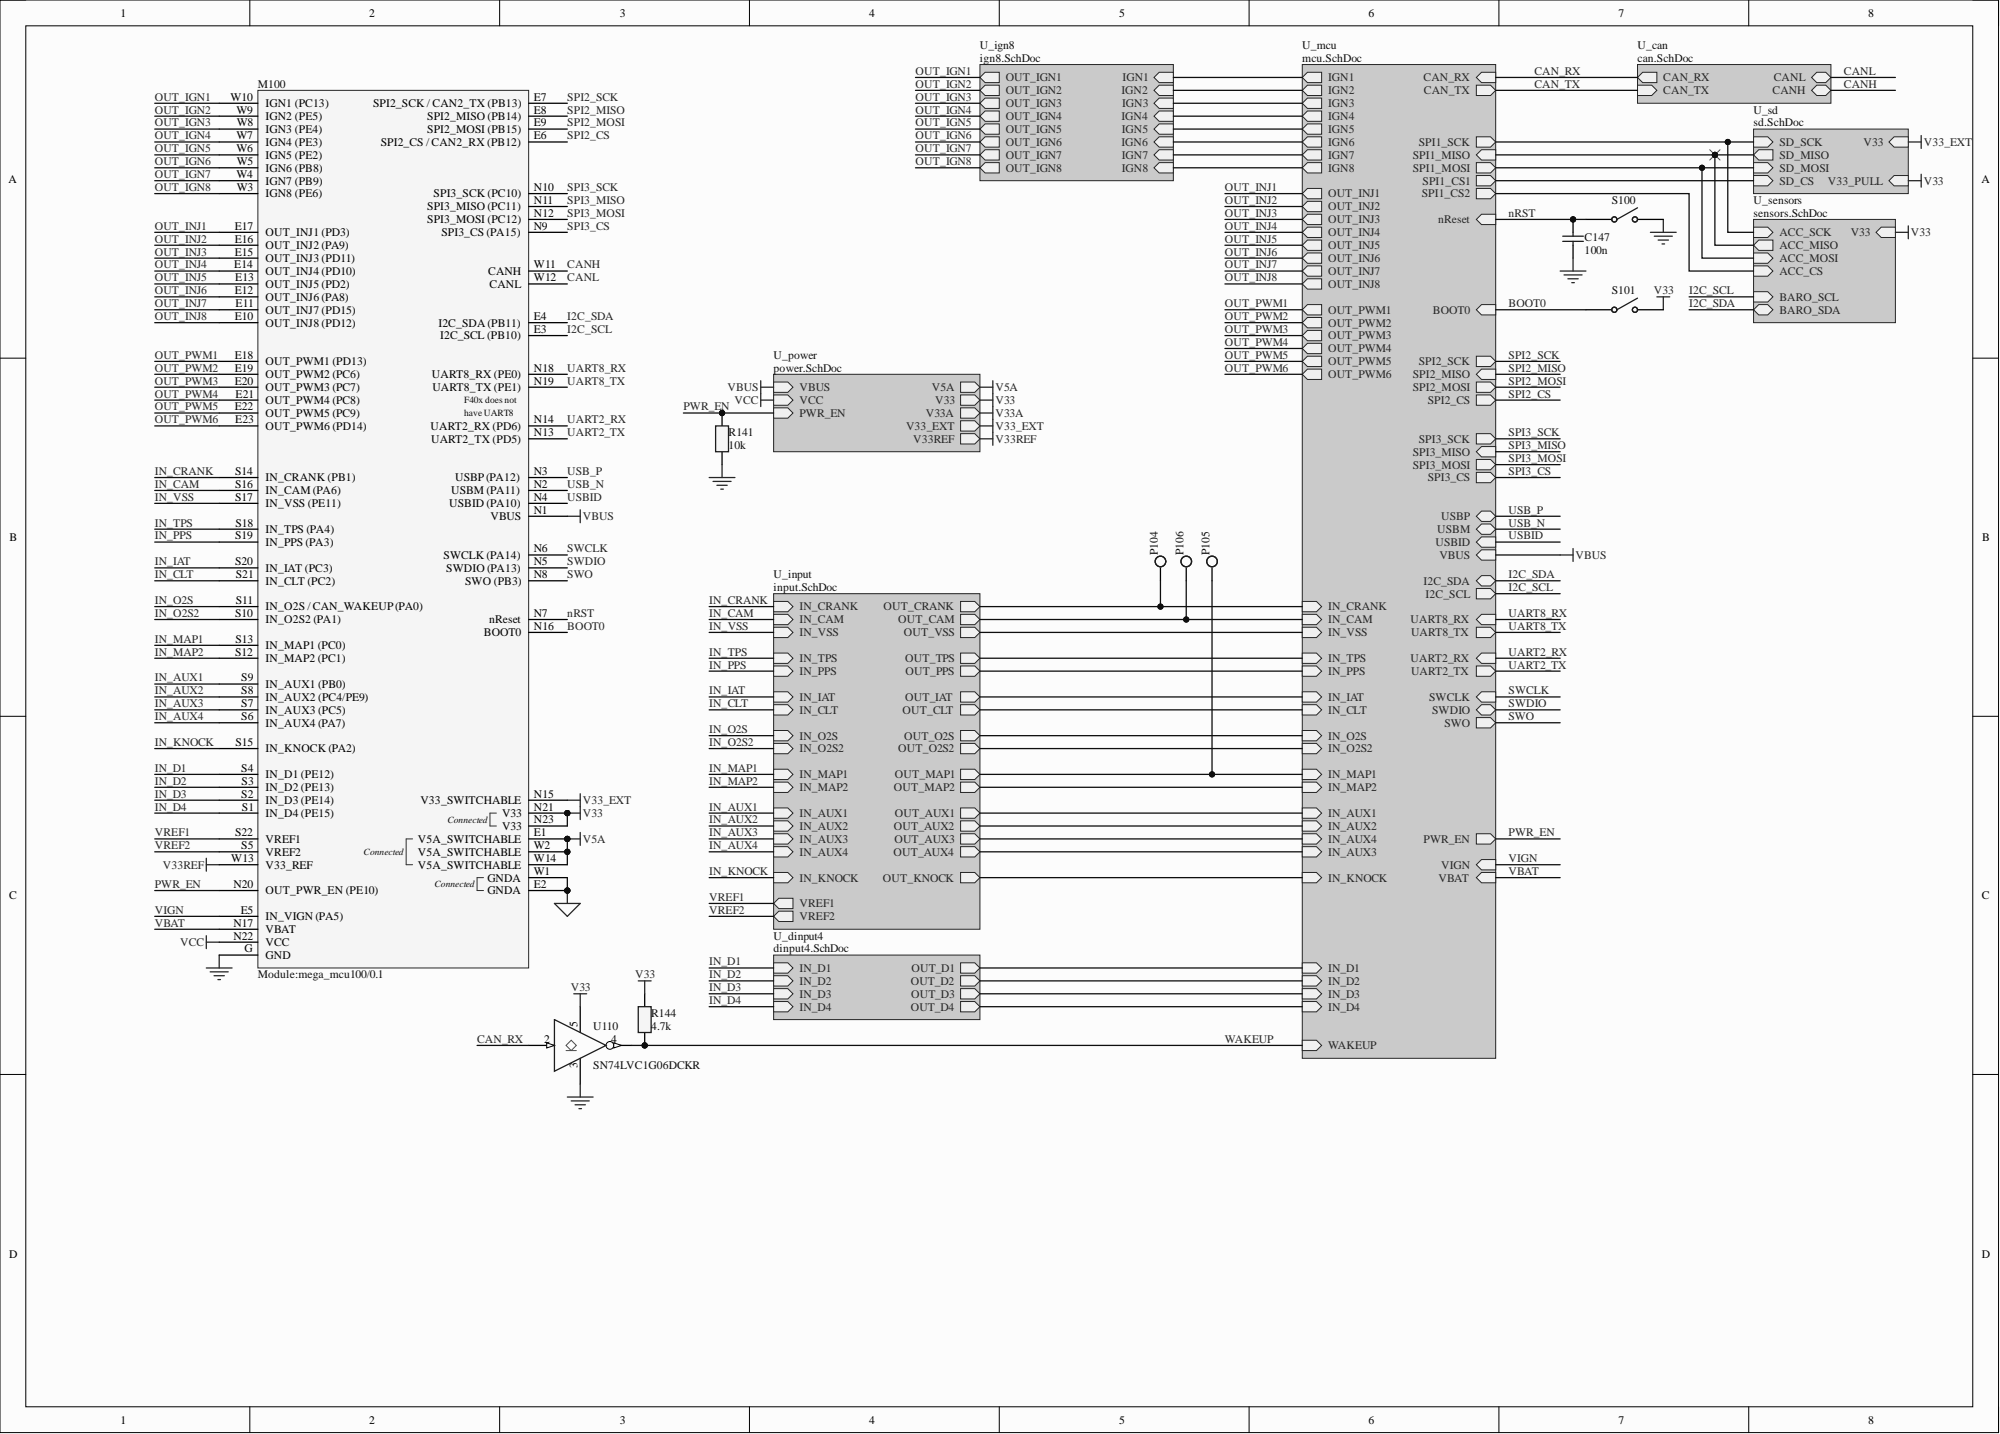
[picture p145: page 10]

USBM USBP USBID VBUS

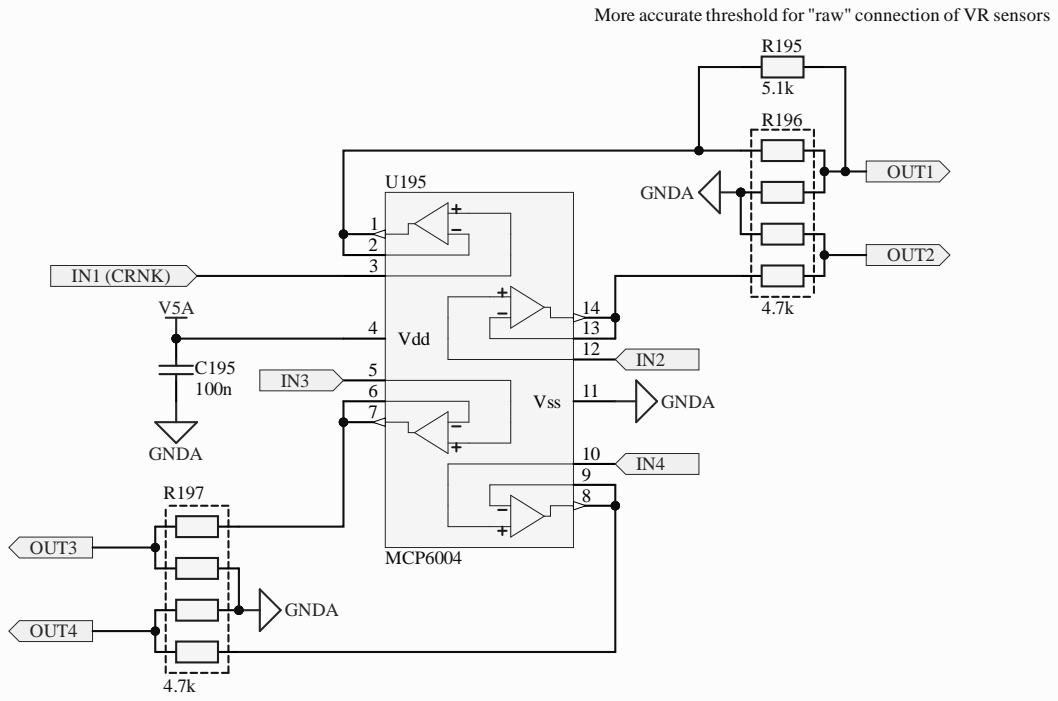
[picture p146: page 11]

More accurate threshold for "raw" connection of VR sensors

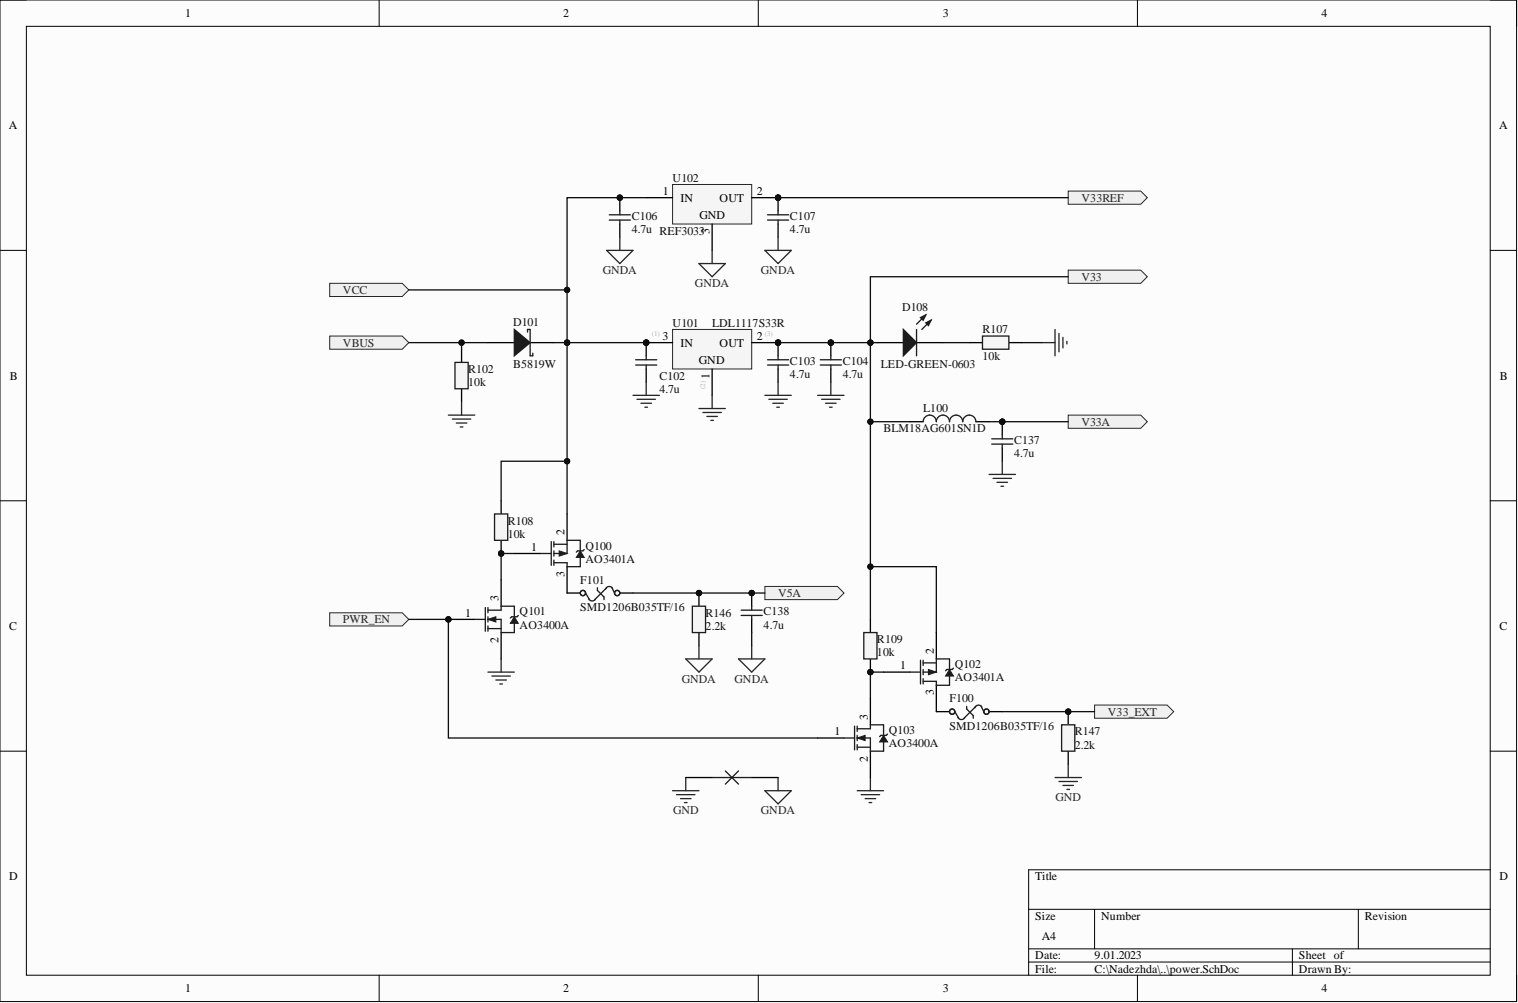
[picture p147: page 12]

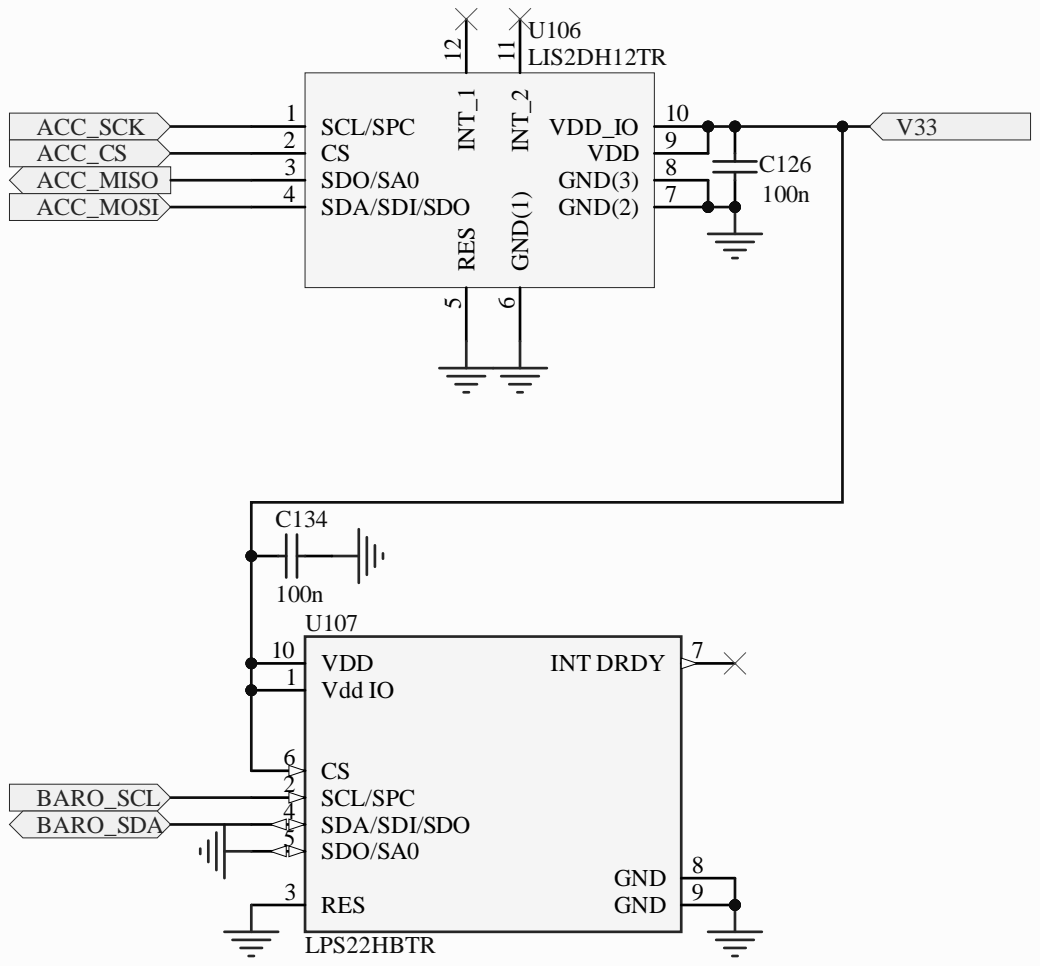
[picture p148: page 13]
