andreika-git/hellen-one/modules/power_12and5V/0.2/power_12and5V-schematic.pdf

Hellen One : Power-Module interface

Reverse polarity and overvoltage protection
F410 V12_RAW

OUT | PG | 1 IN 8 4 ADJ 5
EN 7
