andreika-git/hellen-one/modules/power_12and5V/0.1/power_12and5V-schematic.pdf

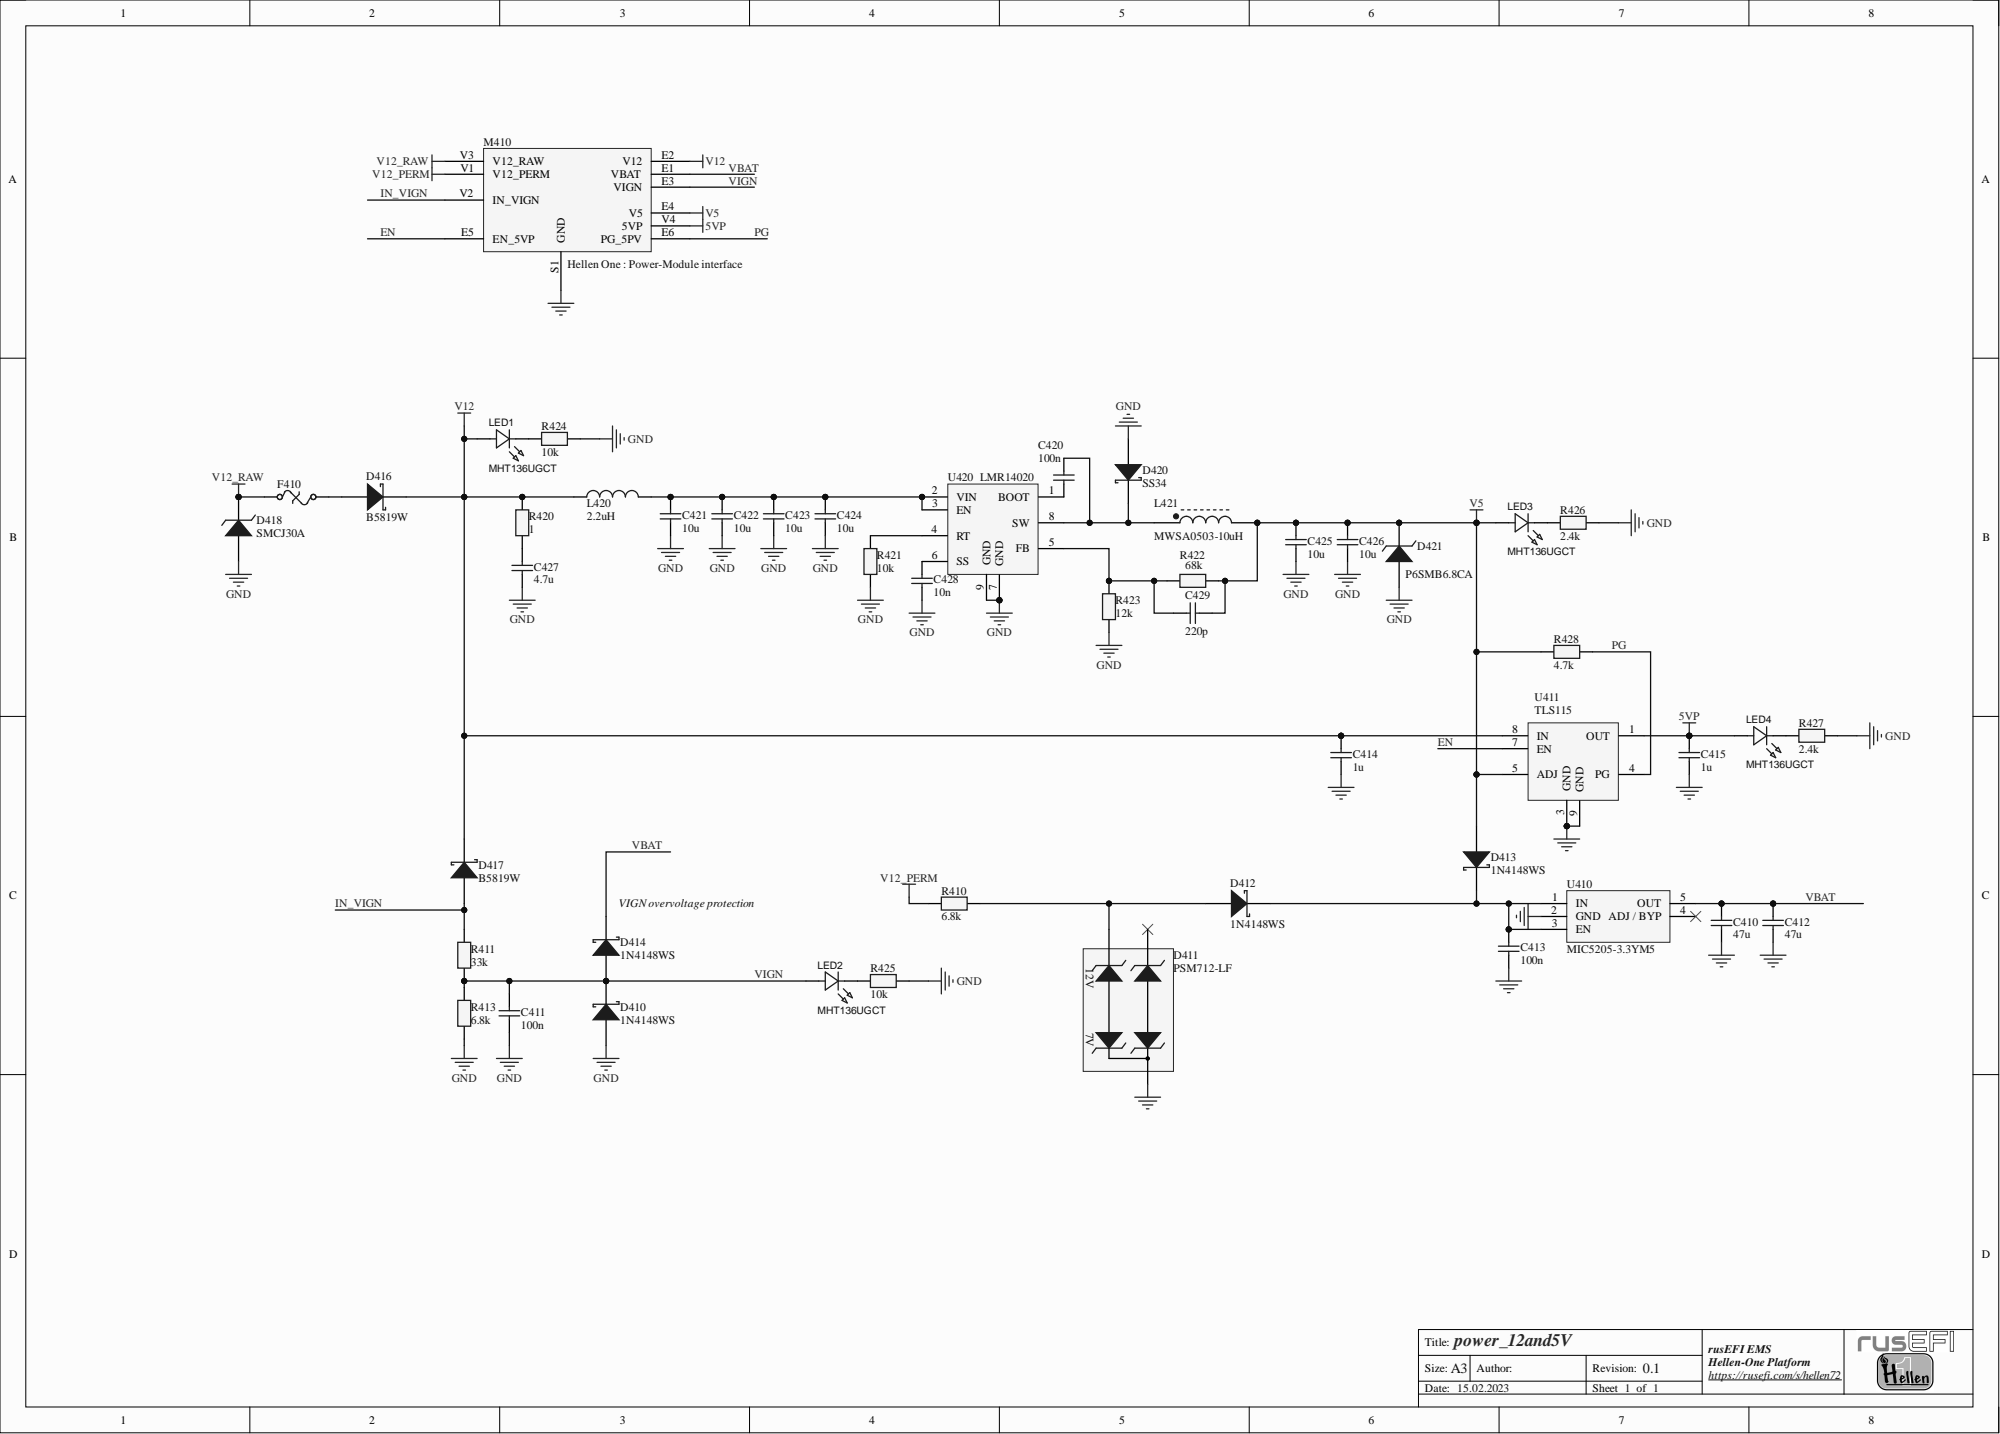
[picture p150: page 1]

Hellen One : Power-Module interface

VBAT | EN 7

OUT | PG | 1 IN 8 4 ADJ 5
