andreika-git/hellen-one/modules/vr-discrete/0.4/vr-discrete-schematic.pdf

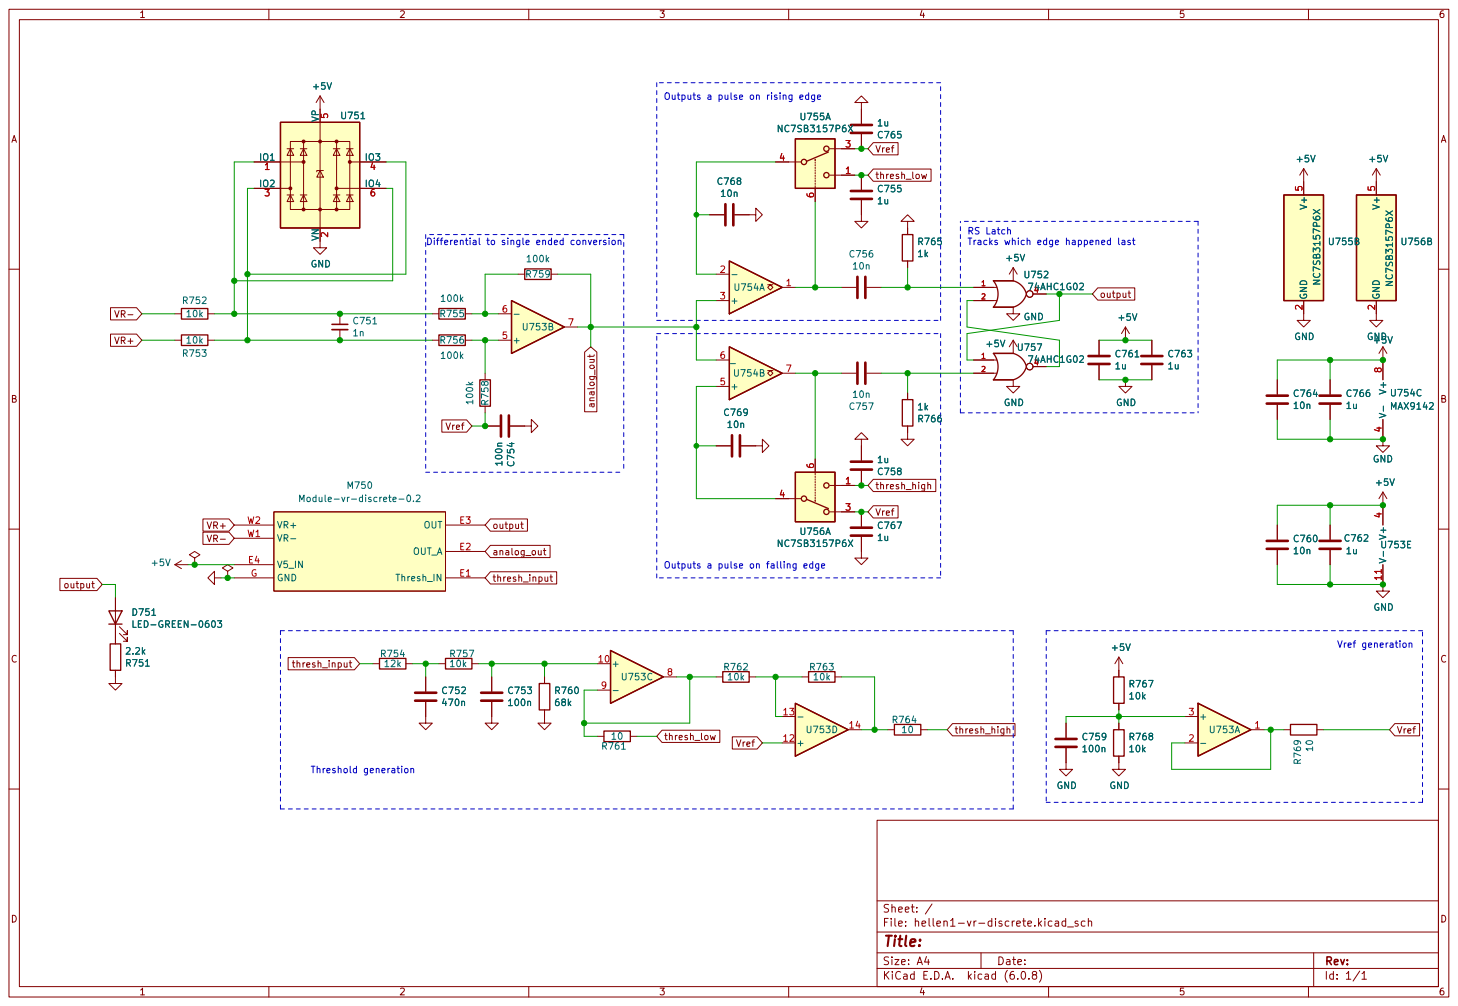
[picture p151: page 1]

Outputs a pulse on rising edge R751

Vref generation RS Latch Tracks which edge happened last
4 GND GND

Differential to single ended conversion

Outputs a pulse on falling edge
