andreika-git/hellen-one/modules/mega-mcu144/0.6/mega-mcu144-schematic.pdf

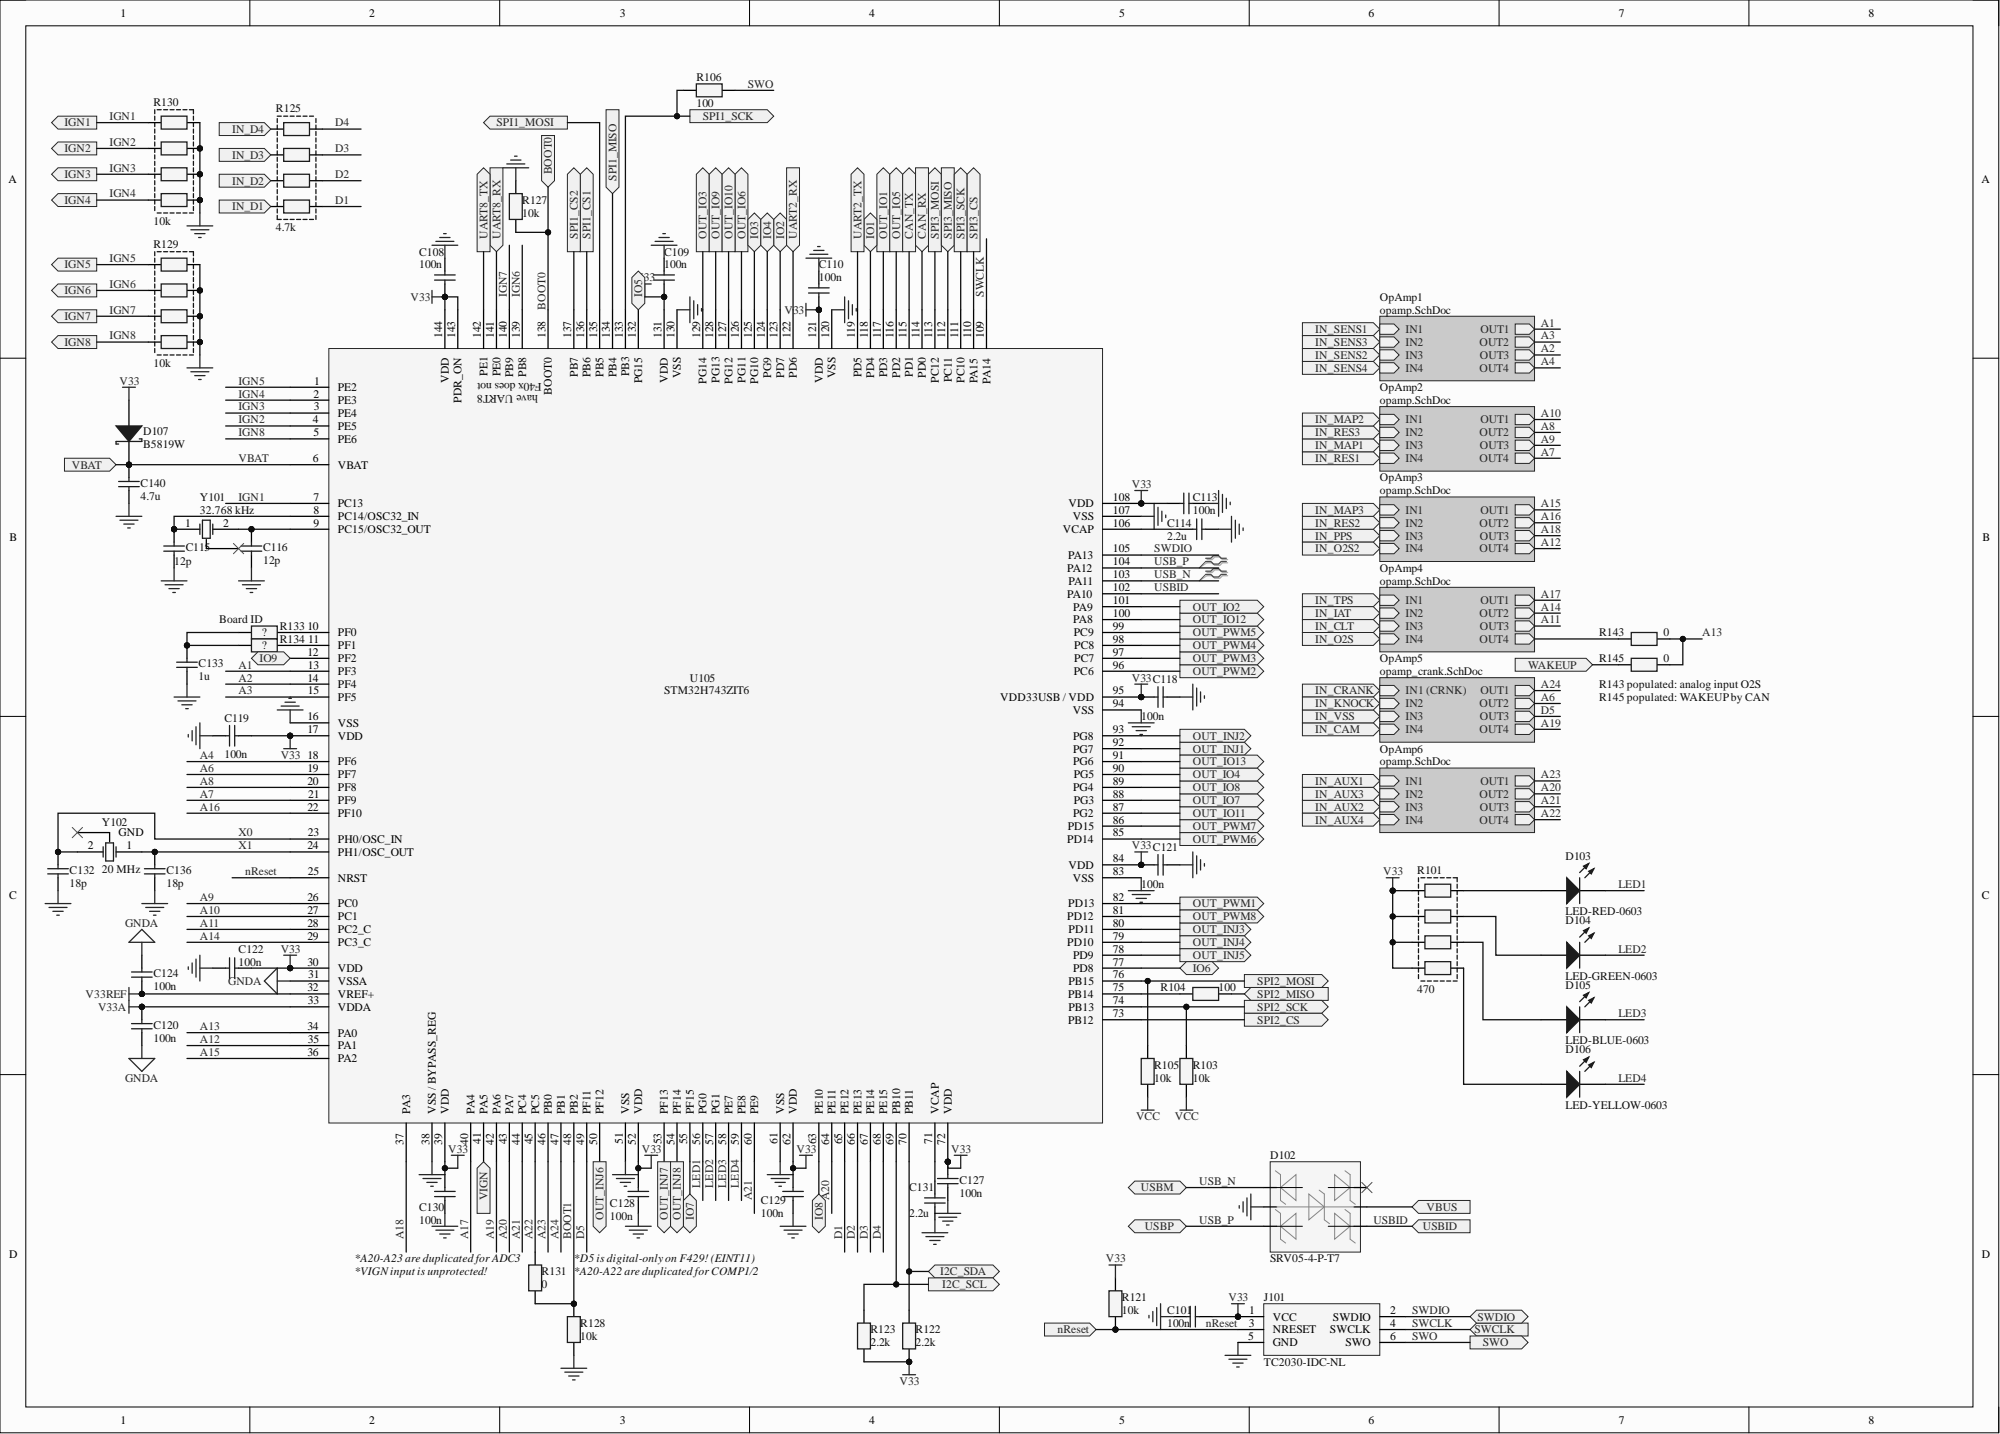
[picture p153: page 11]

R143 populated: analog input O2S
R145 populated: WAKEUP by CAN

D5 *D5 is digital-only on F429! (EINT11)

*VIGN input is unprotected!





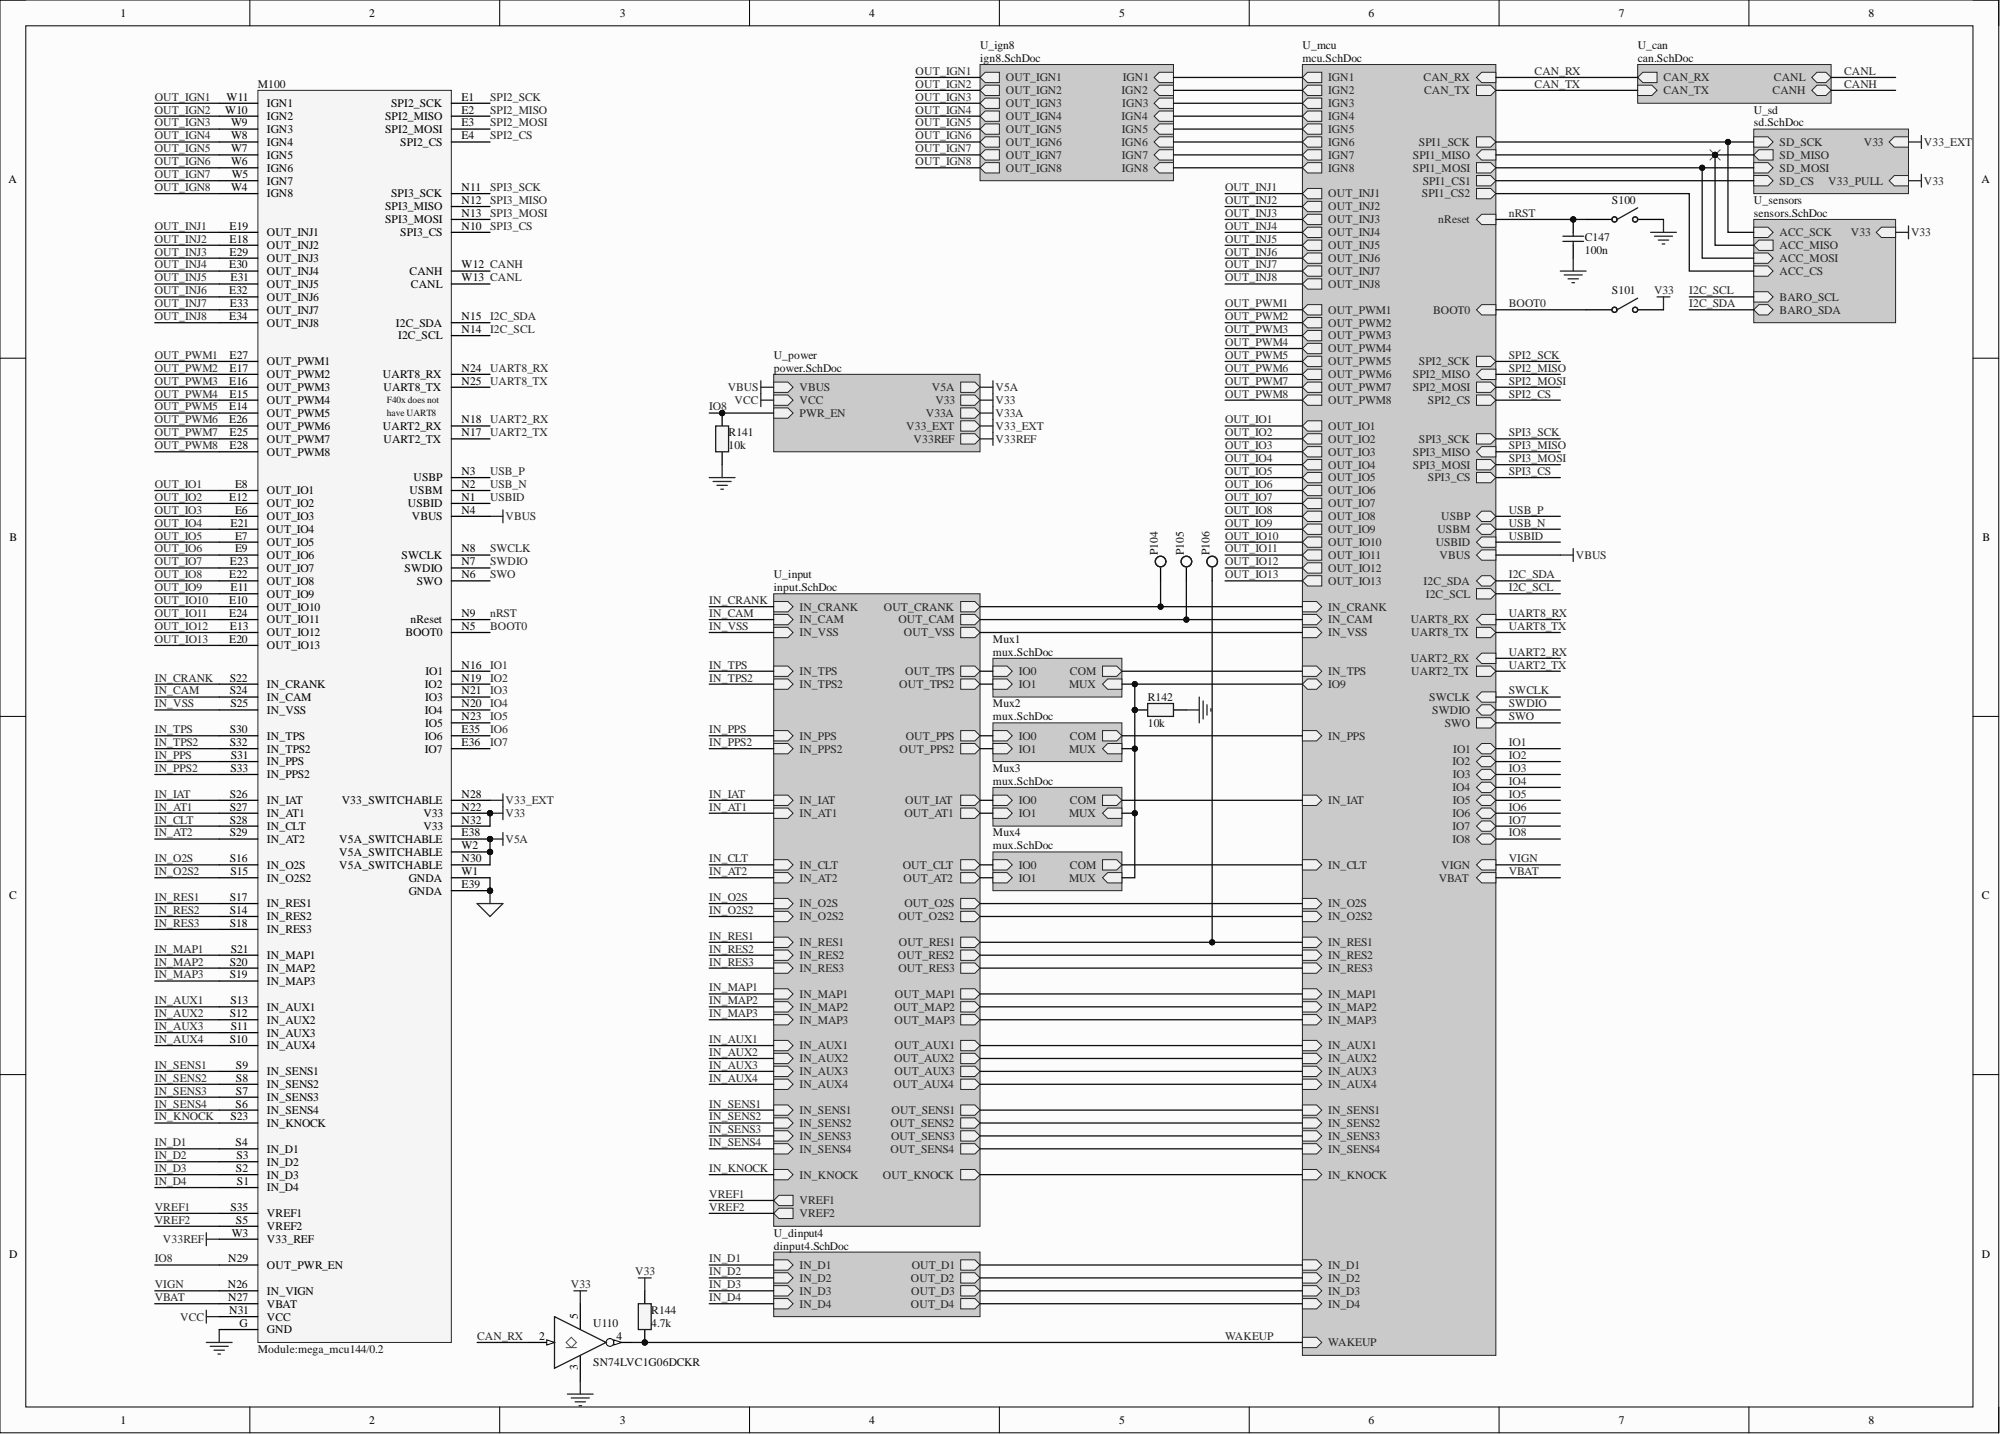
[picture p154: page 16]

USBM USBP USBID VBUS


More accurate threshold for "raw" connection of VR sensors

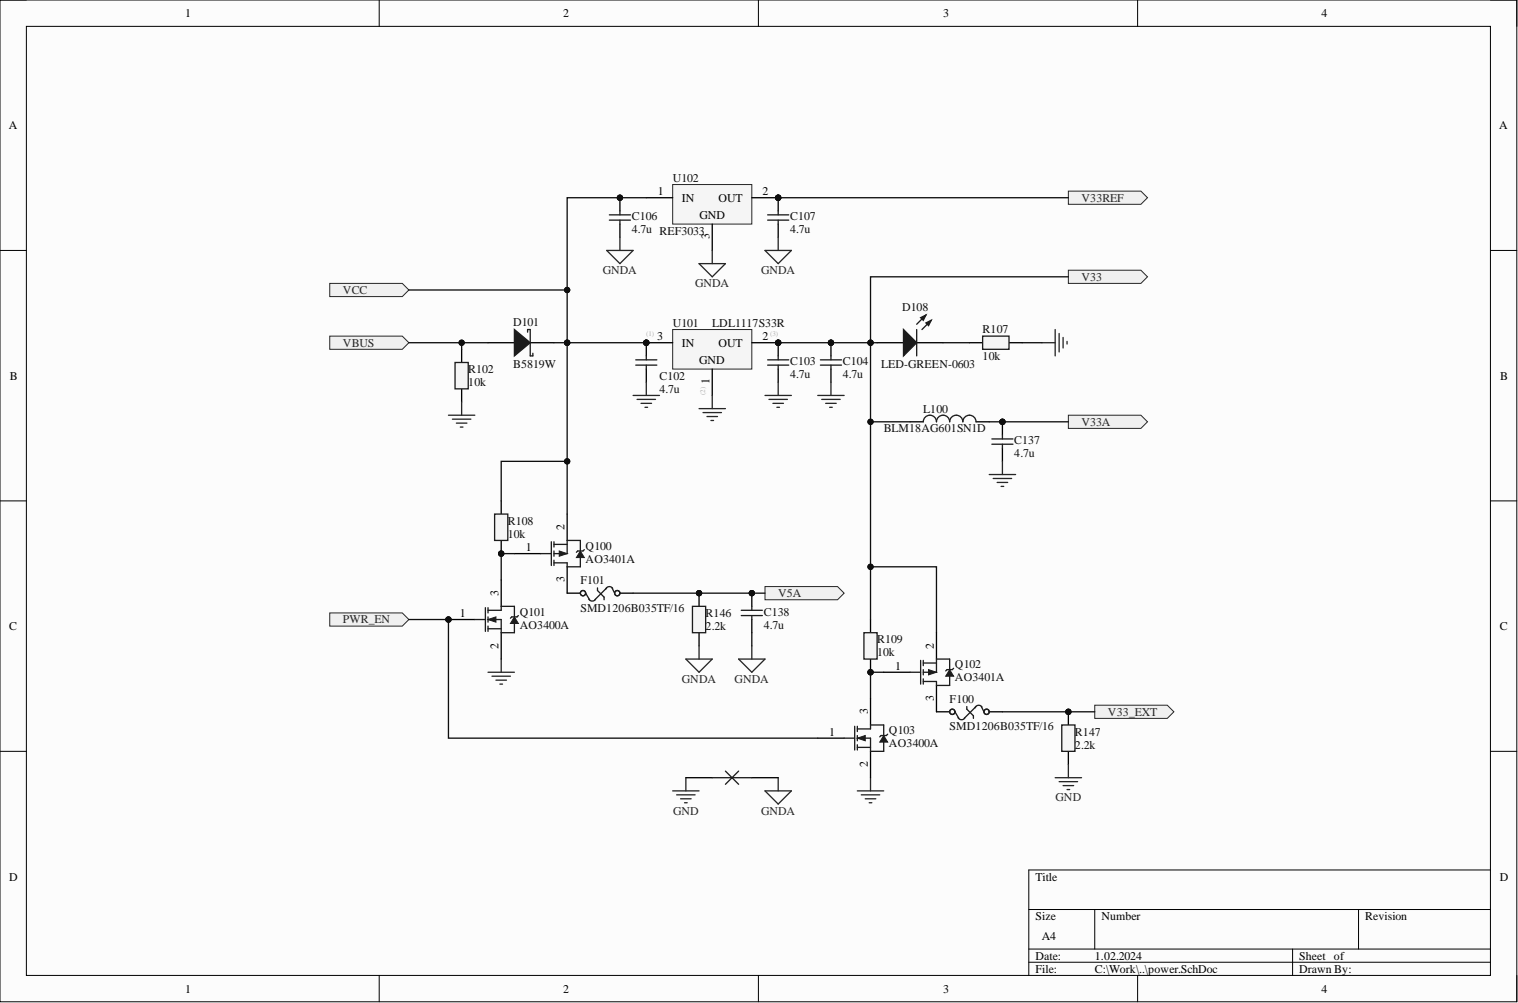
[picture p155: page 18]
