andreika-git/hellen-one/modules/mega-mcu144/0.5/mega-mcu144-schematic.pdf

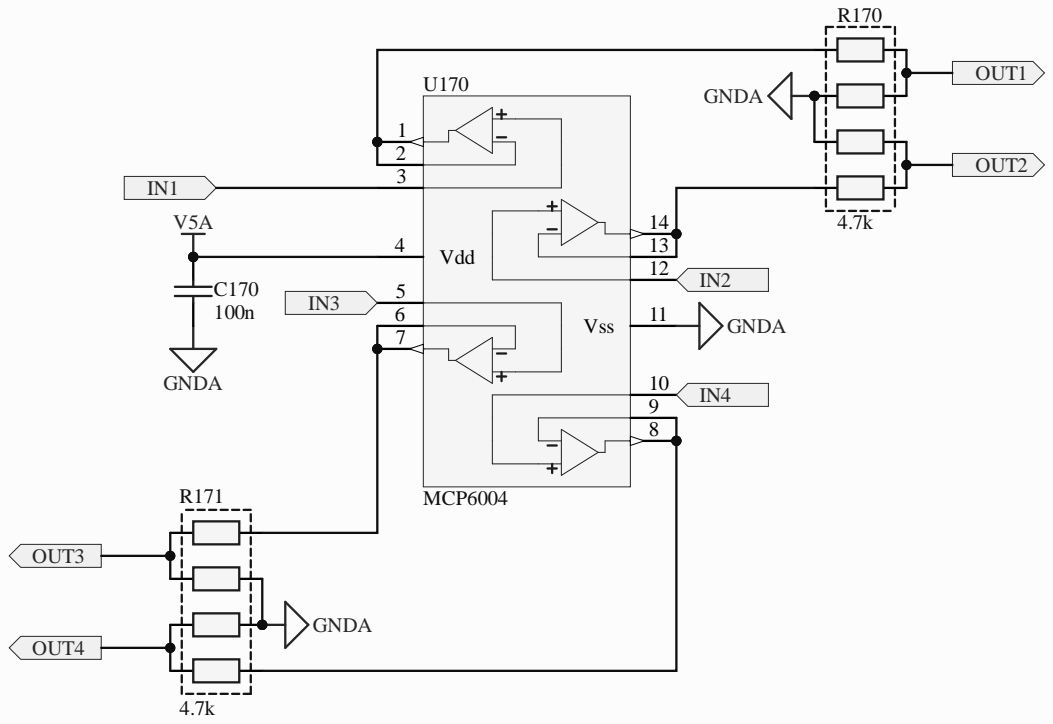
[picture p156: page 1]

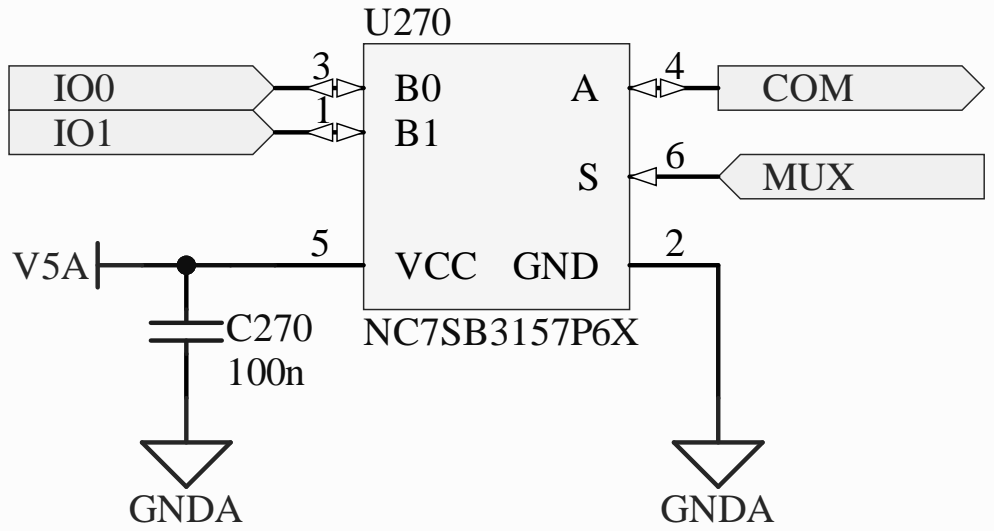
[picture p157: page 2]

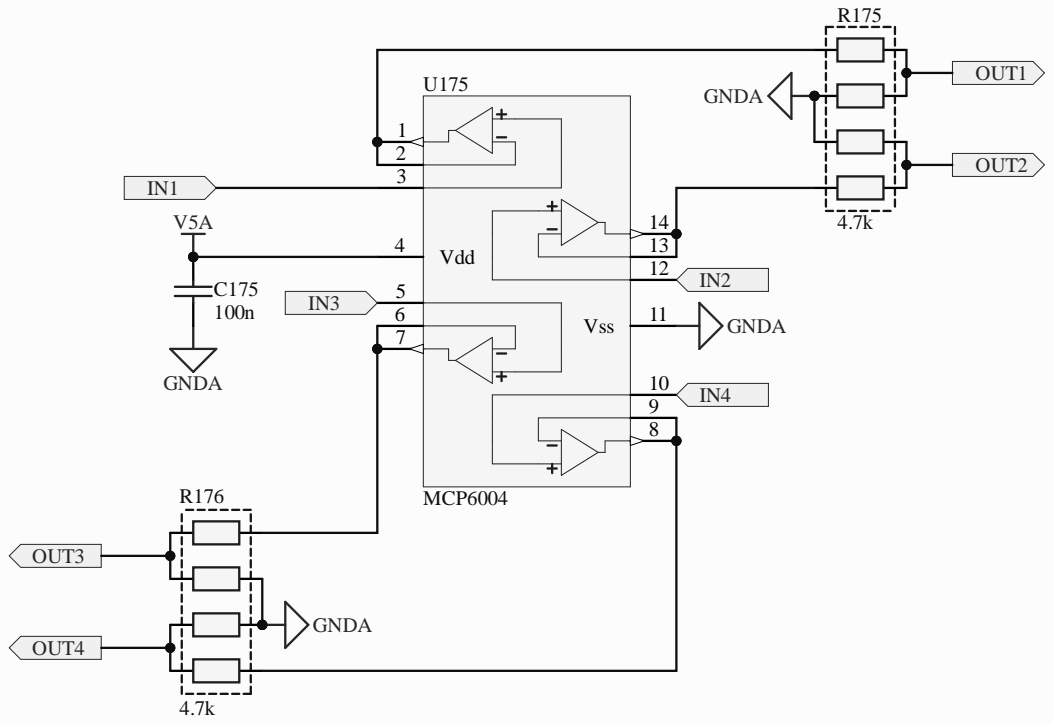
[picture p158: page 3]

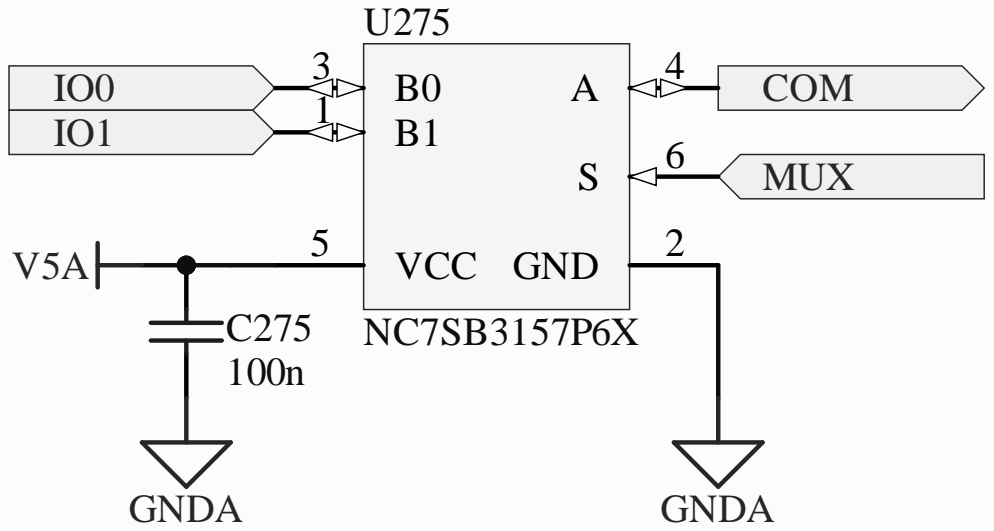
[picture p159: page 4]


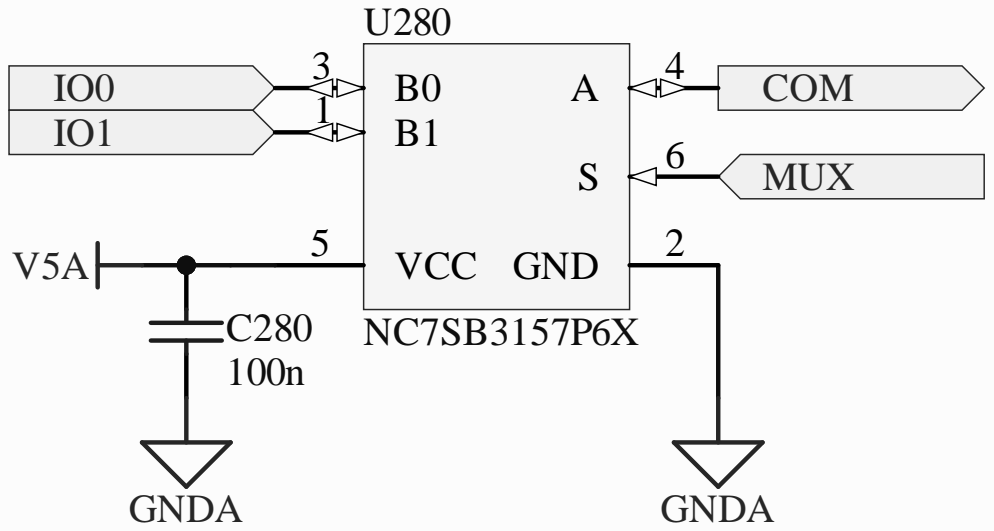
[picture p160: page 6]


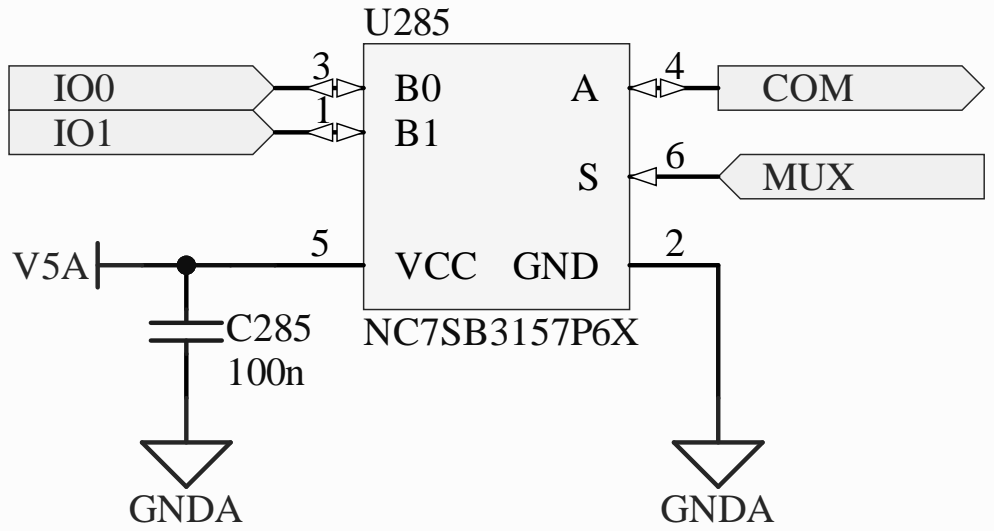
[picture p161: page 8]



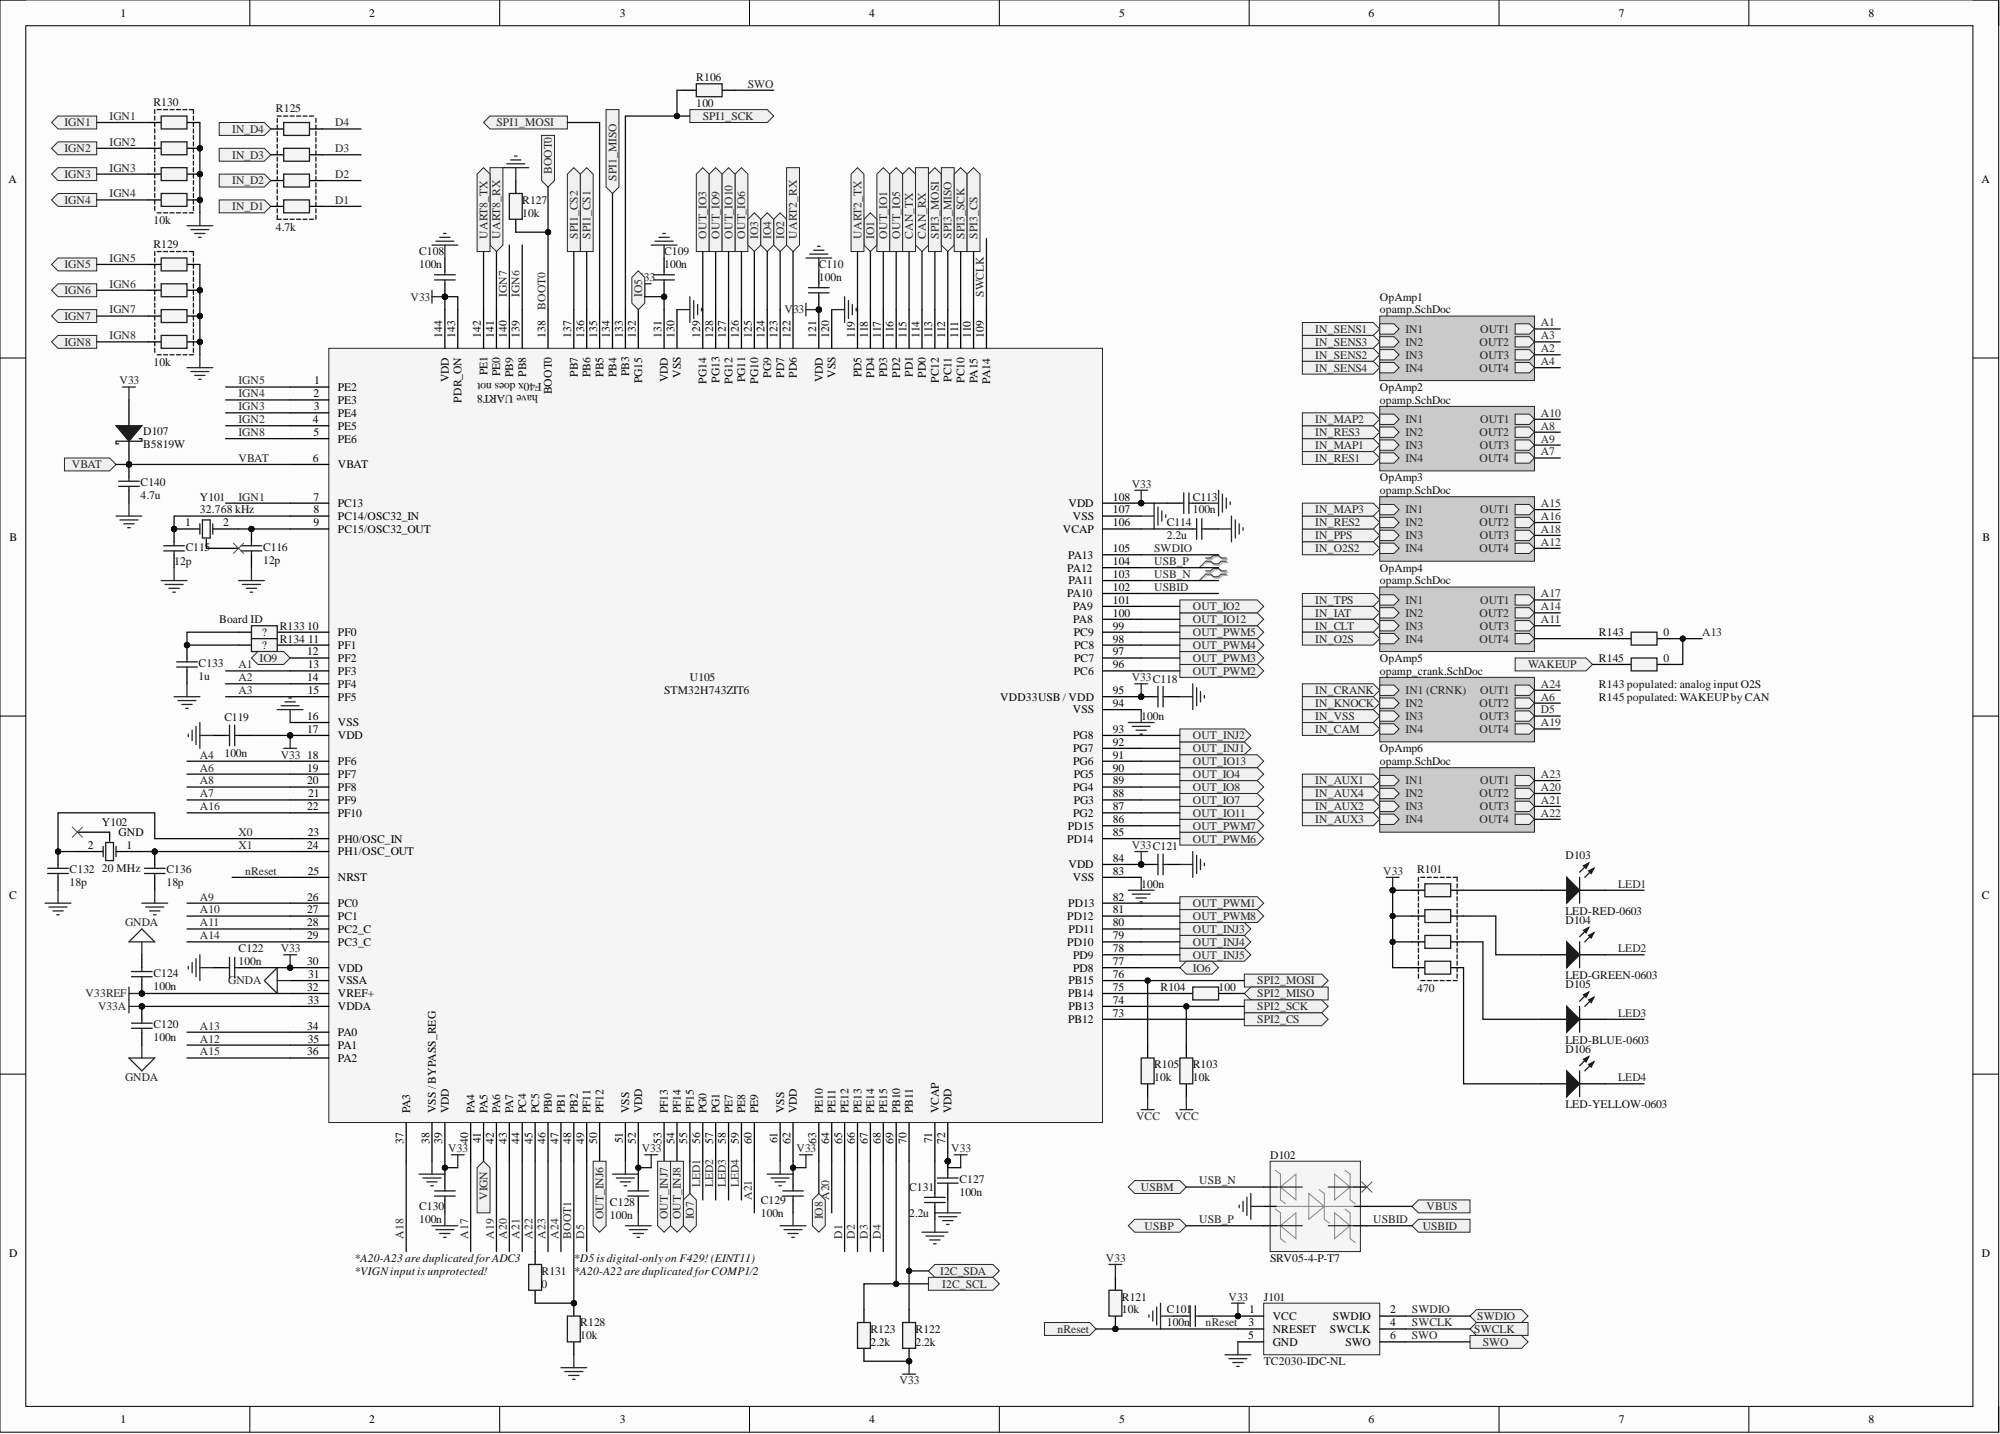
[picture p162: page 11]

R143 populated: analog input O2S
R145 populated: WAKEUP by CAN

D5 *D5 is digital-only on F429! (EINT11)

*VIGN input is unprotected!

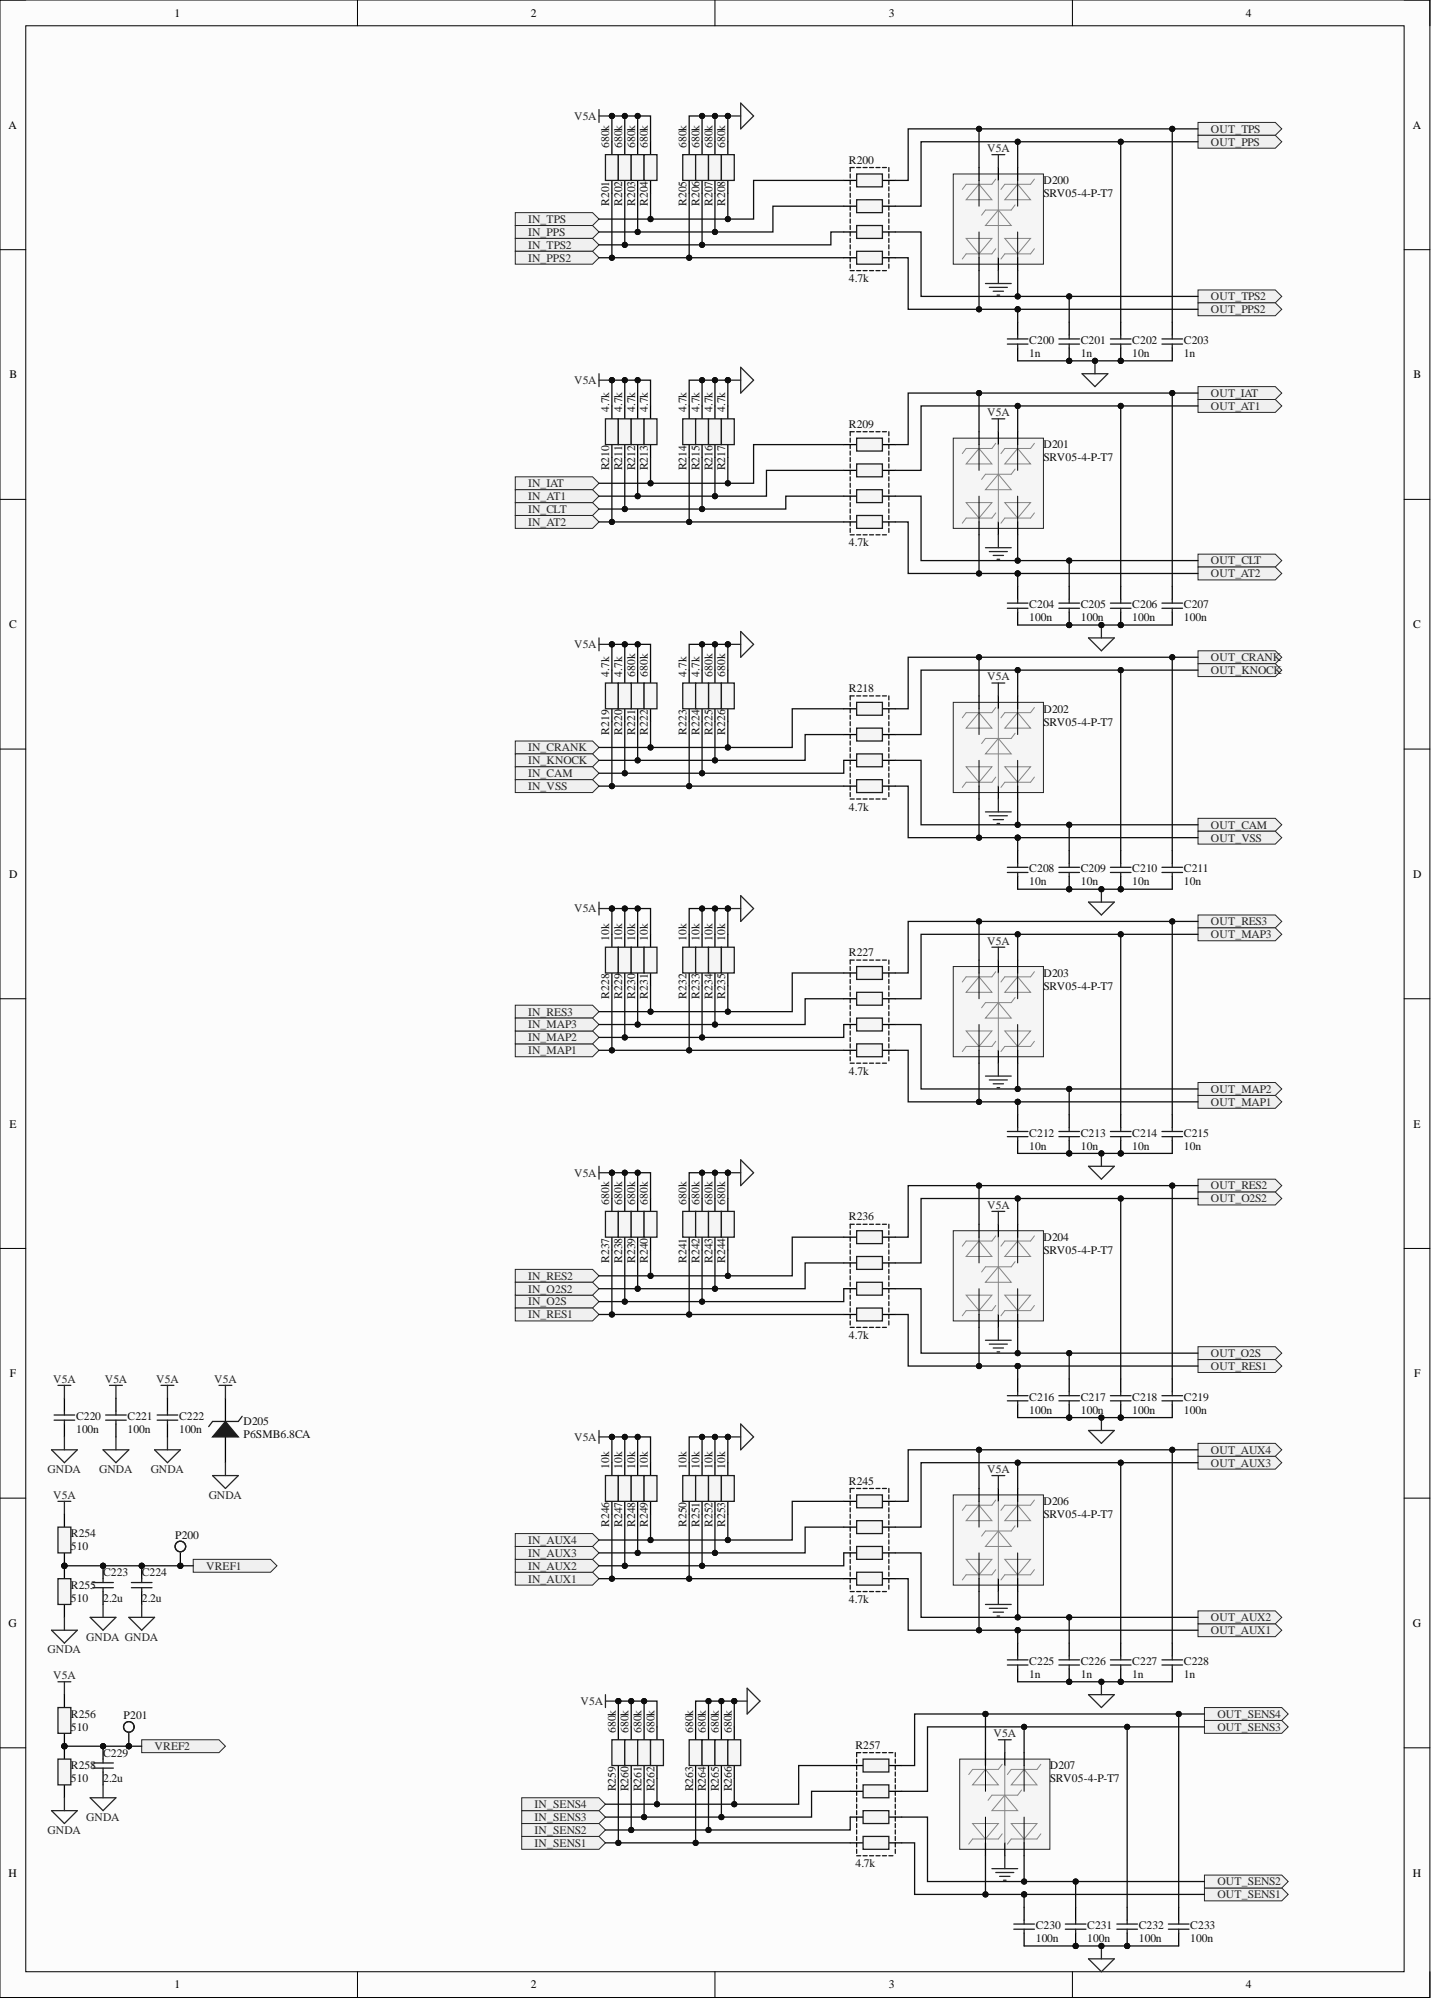
[picture p163: page 12]


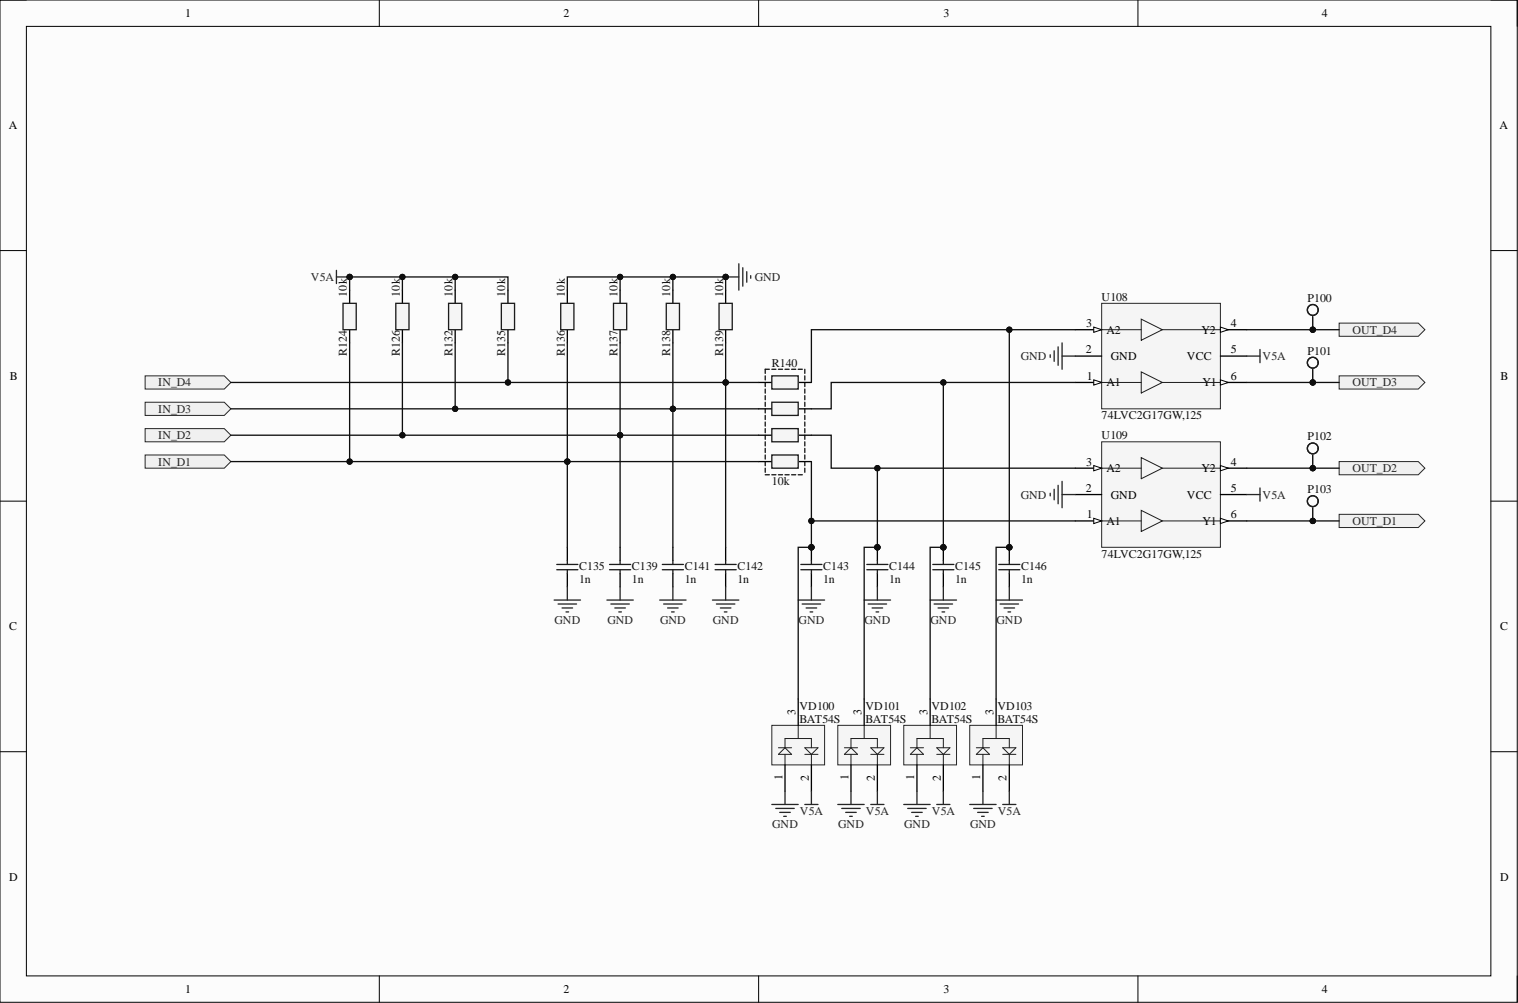
[picture p164: page 14]


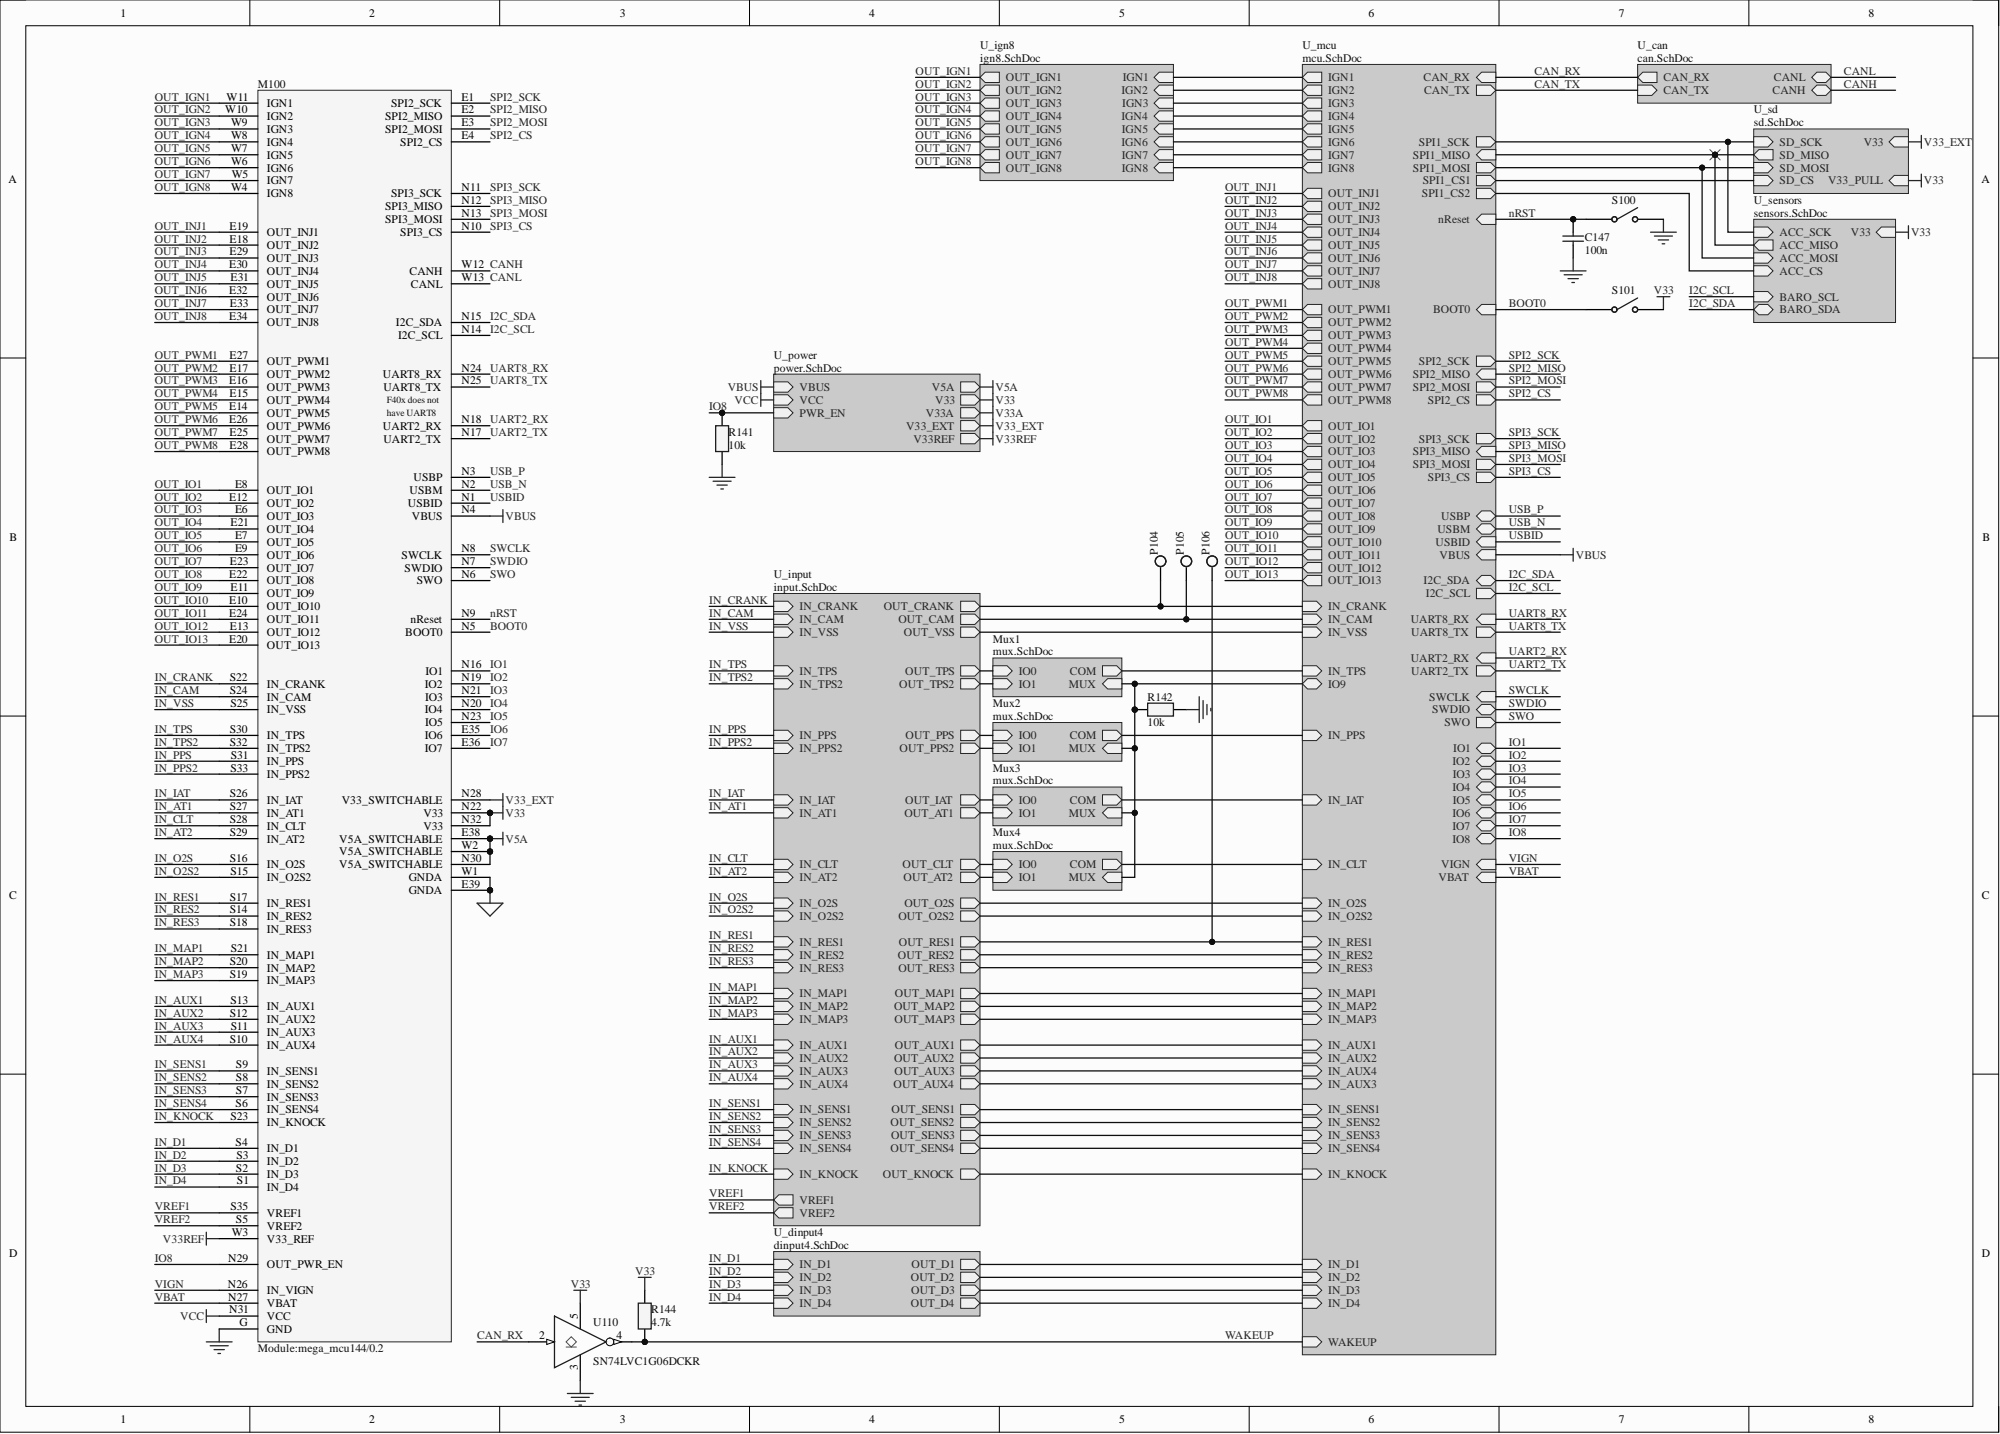
[picture p165: page 16]

USBM USBP USBID VBUS


More accurate threshold for "raw" connection of VR sensors

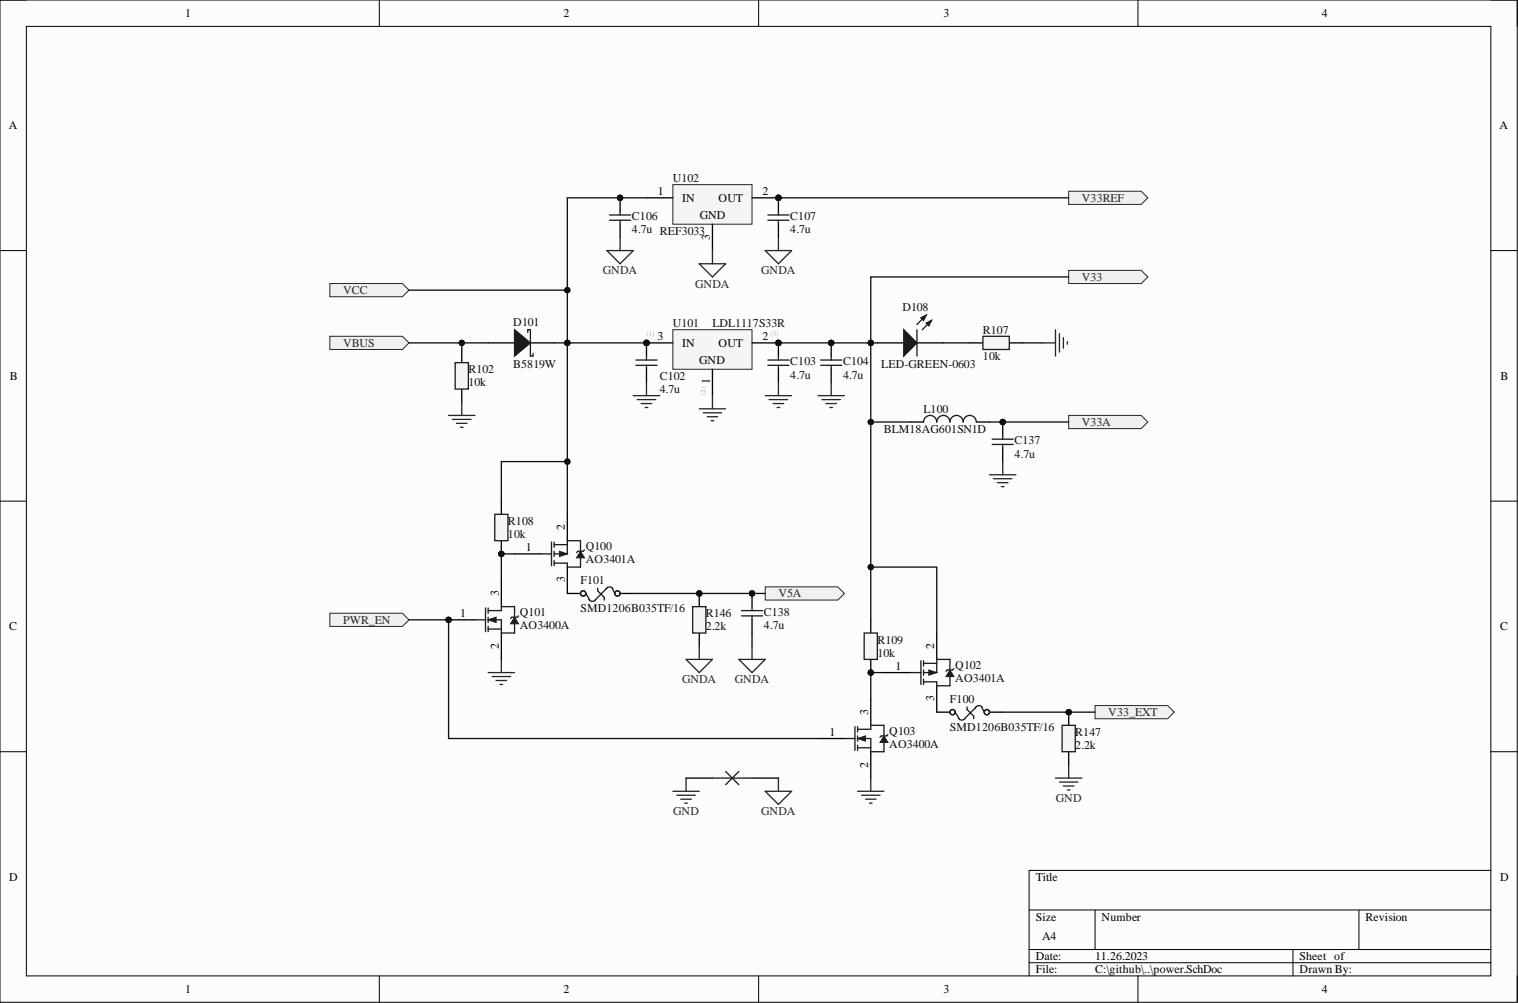
[picture p166: page 18]
