andreika-git/hellen-one/modules/vr-max9924/0.2/vr-max9924-schematic.pdf

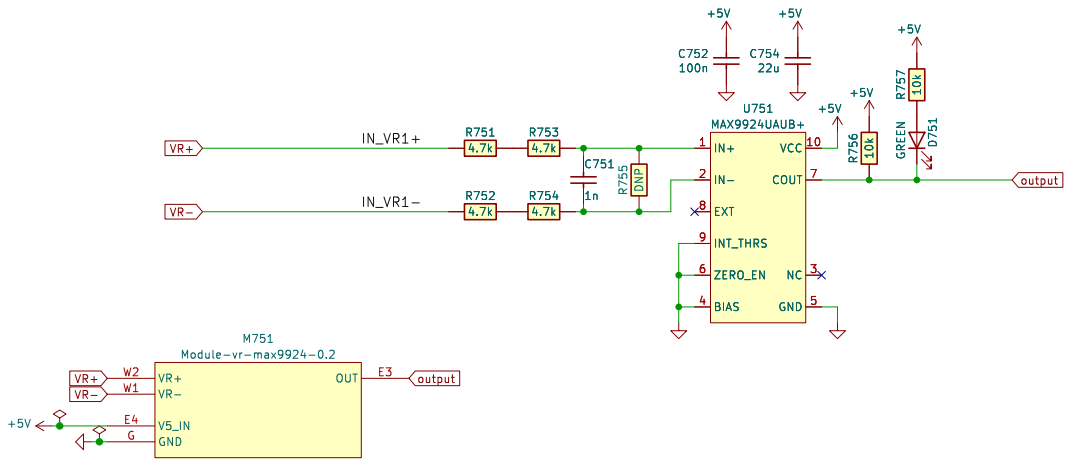
[picture p167: page 1]
