andreika-git/hellen-one/modules/mega-mcu144/0.4/mega-mcu144-schematic.pdf

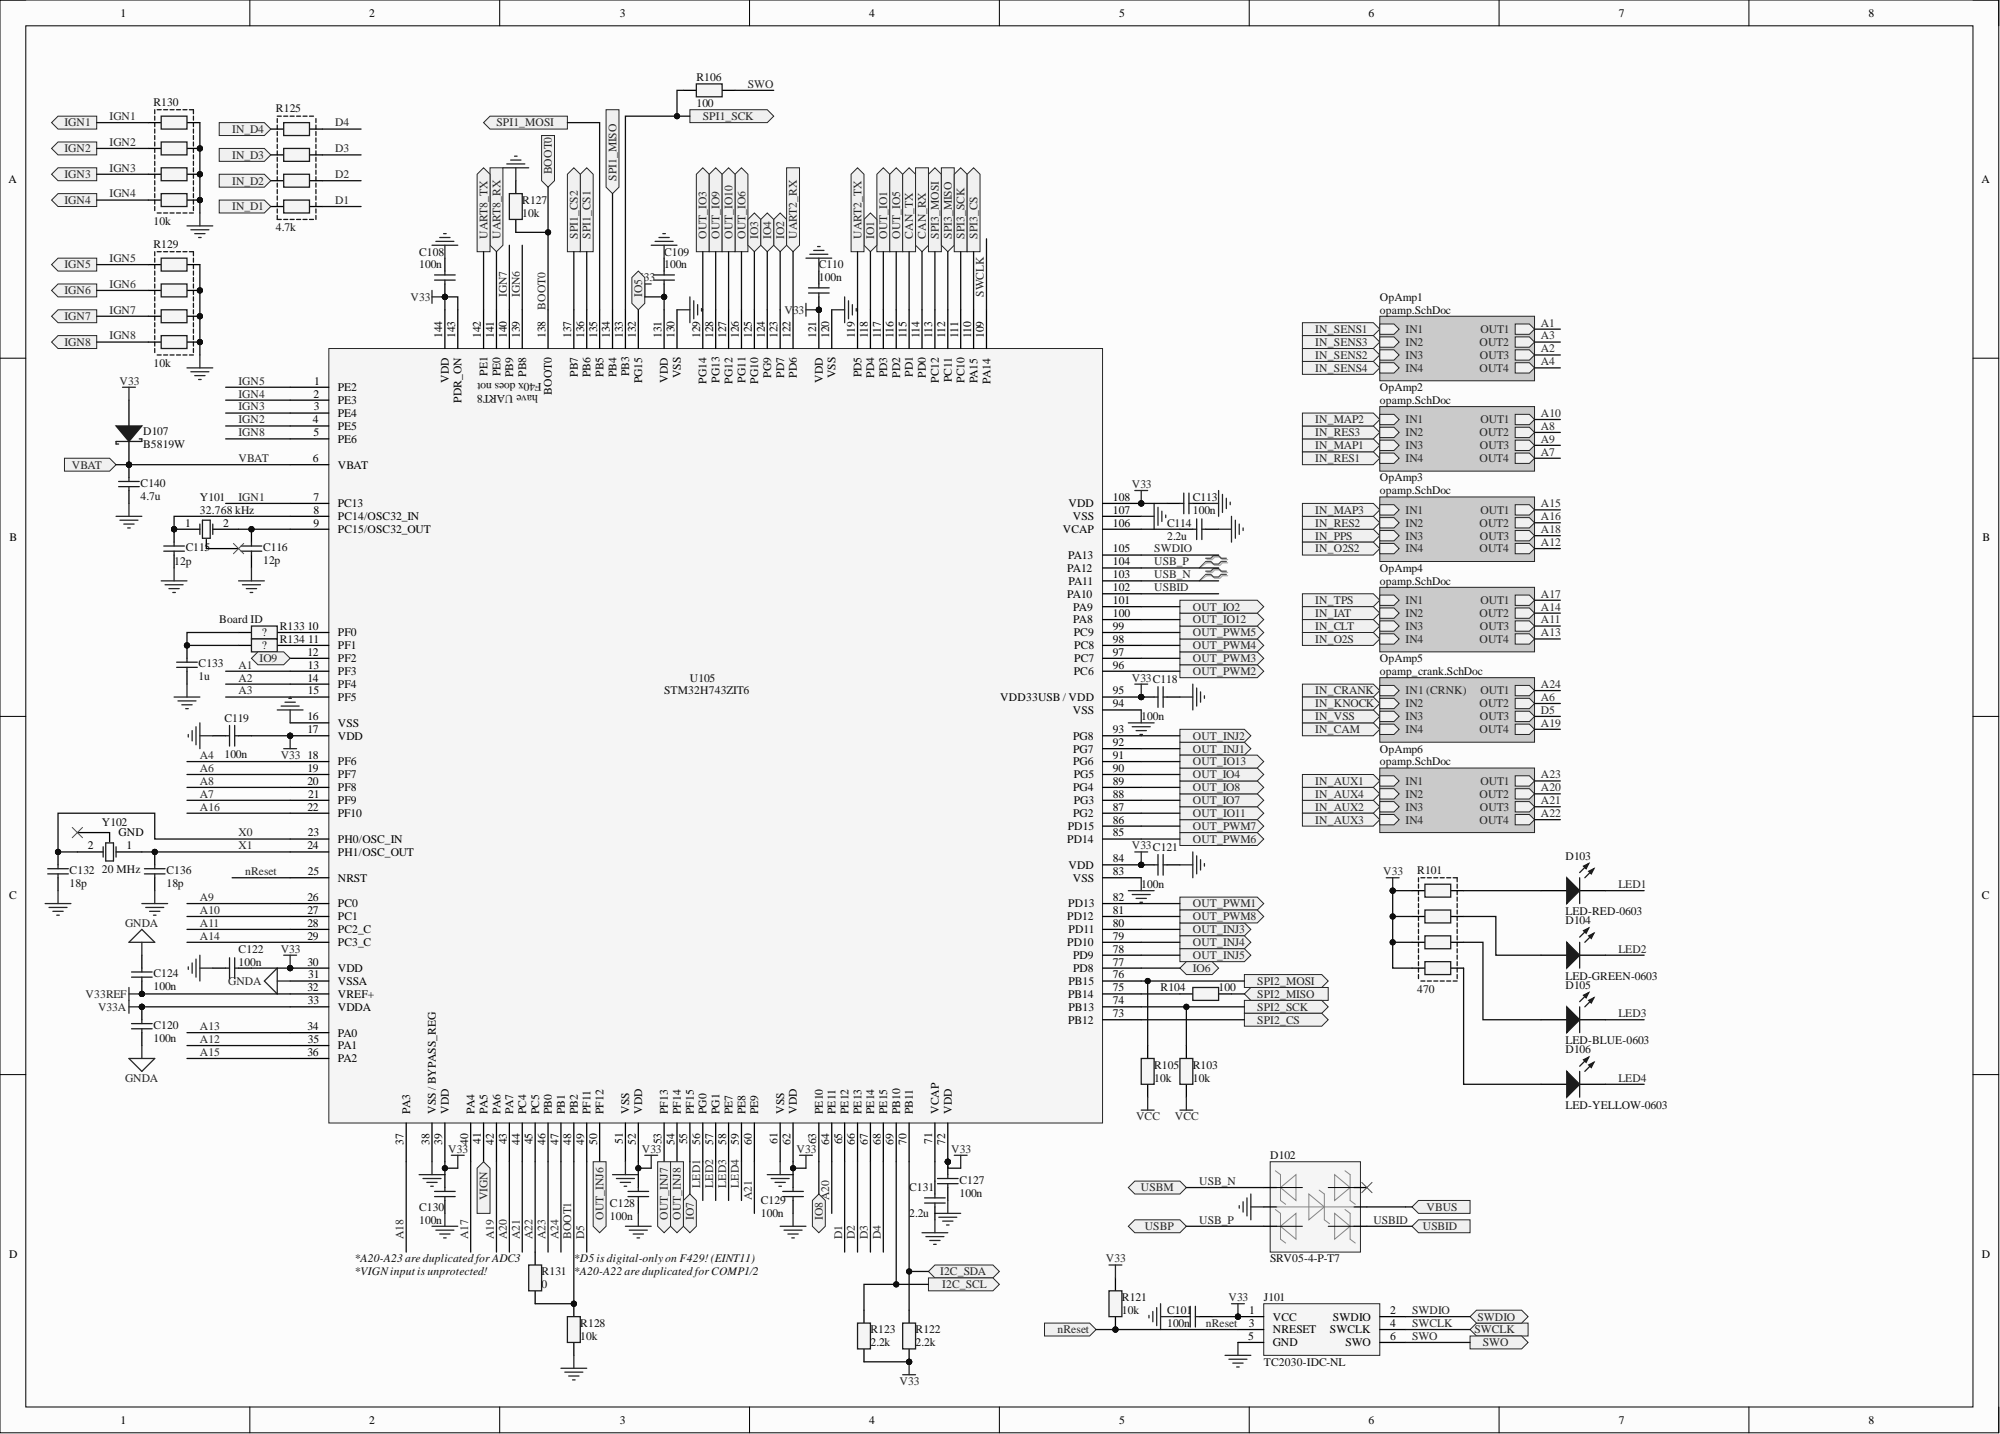
[picture p168: page 11]

D5 *D5 is digital-only on F429! (EINT11)

*VIGN input is unprotected!





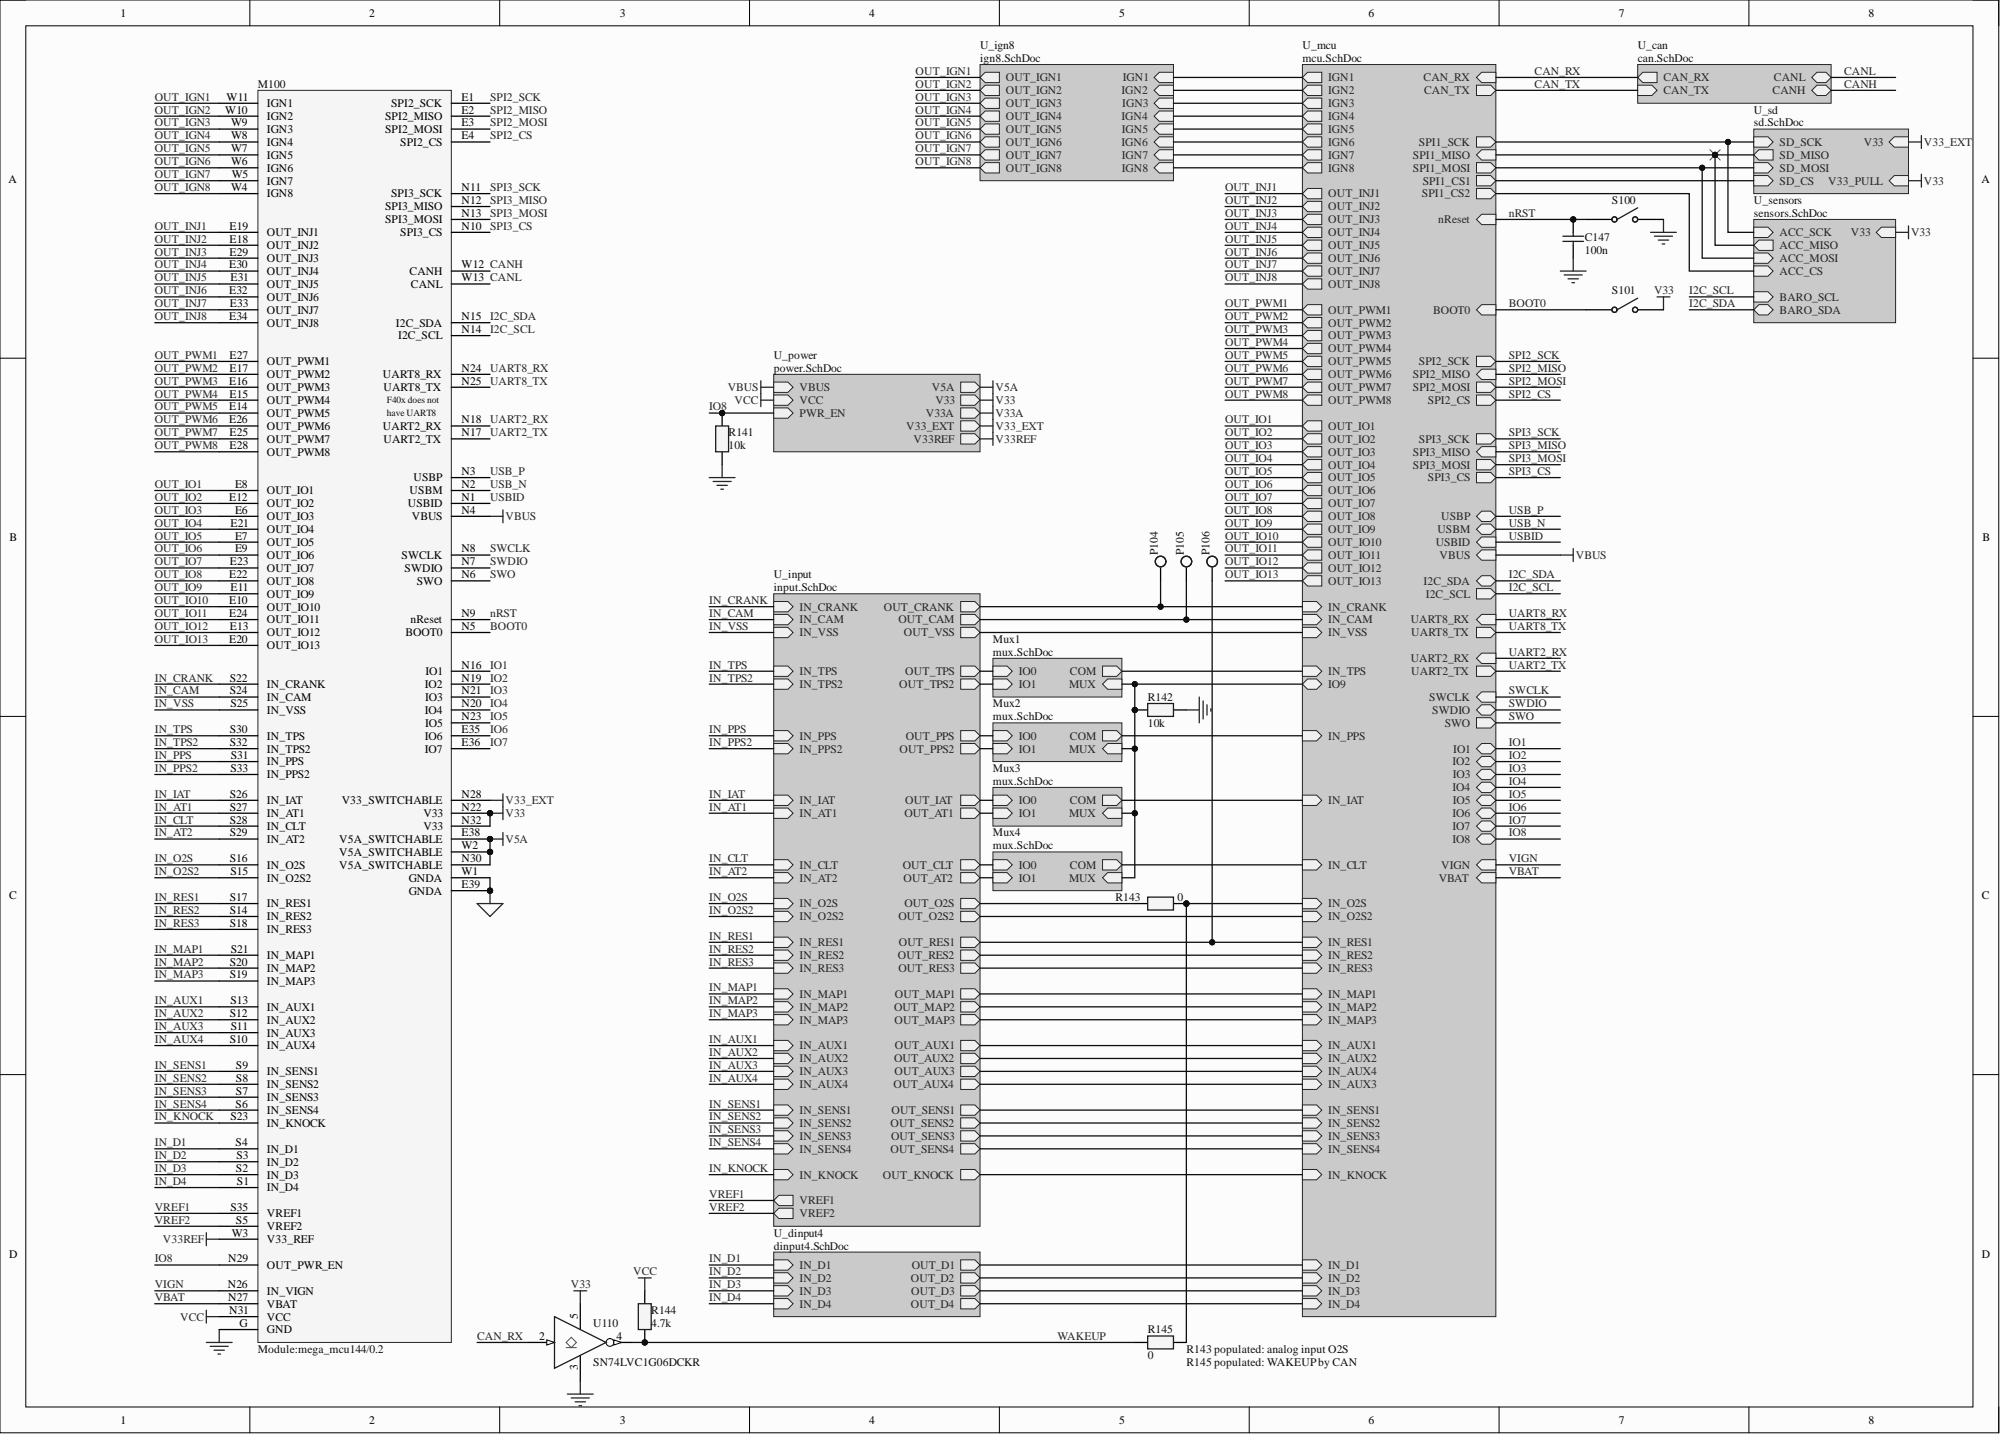
[picture p169: page 16]

USBM USBP USBID VBUS


More accurate threshold for "raw" connection of VR sensors

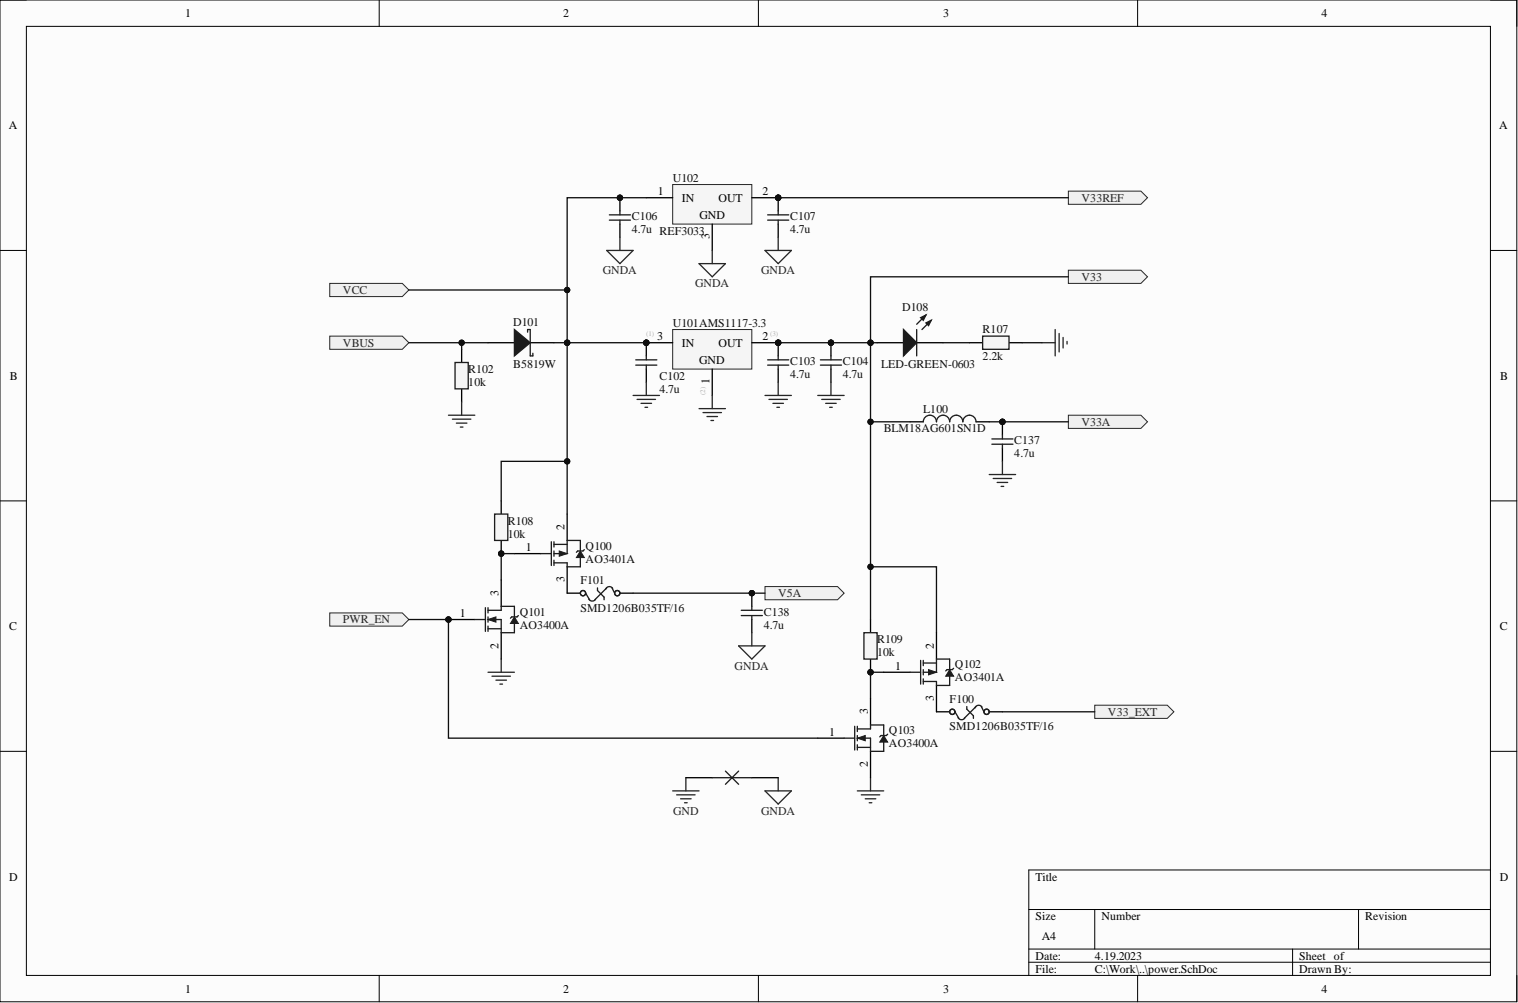
[picture p170: page 18]
