andreika-git/hellen-one/modules/mega-mcu144/0.3/mega-mcu144-schematic.pdf

D5 *D5 is digital-only on F429! (EINT11)

*VIGN input is unprotected!

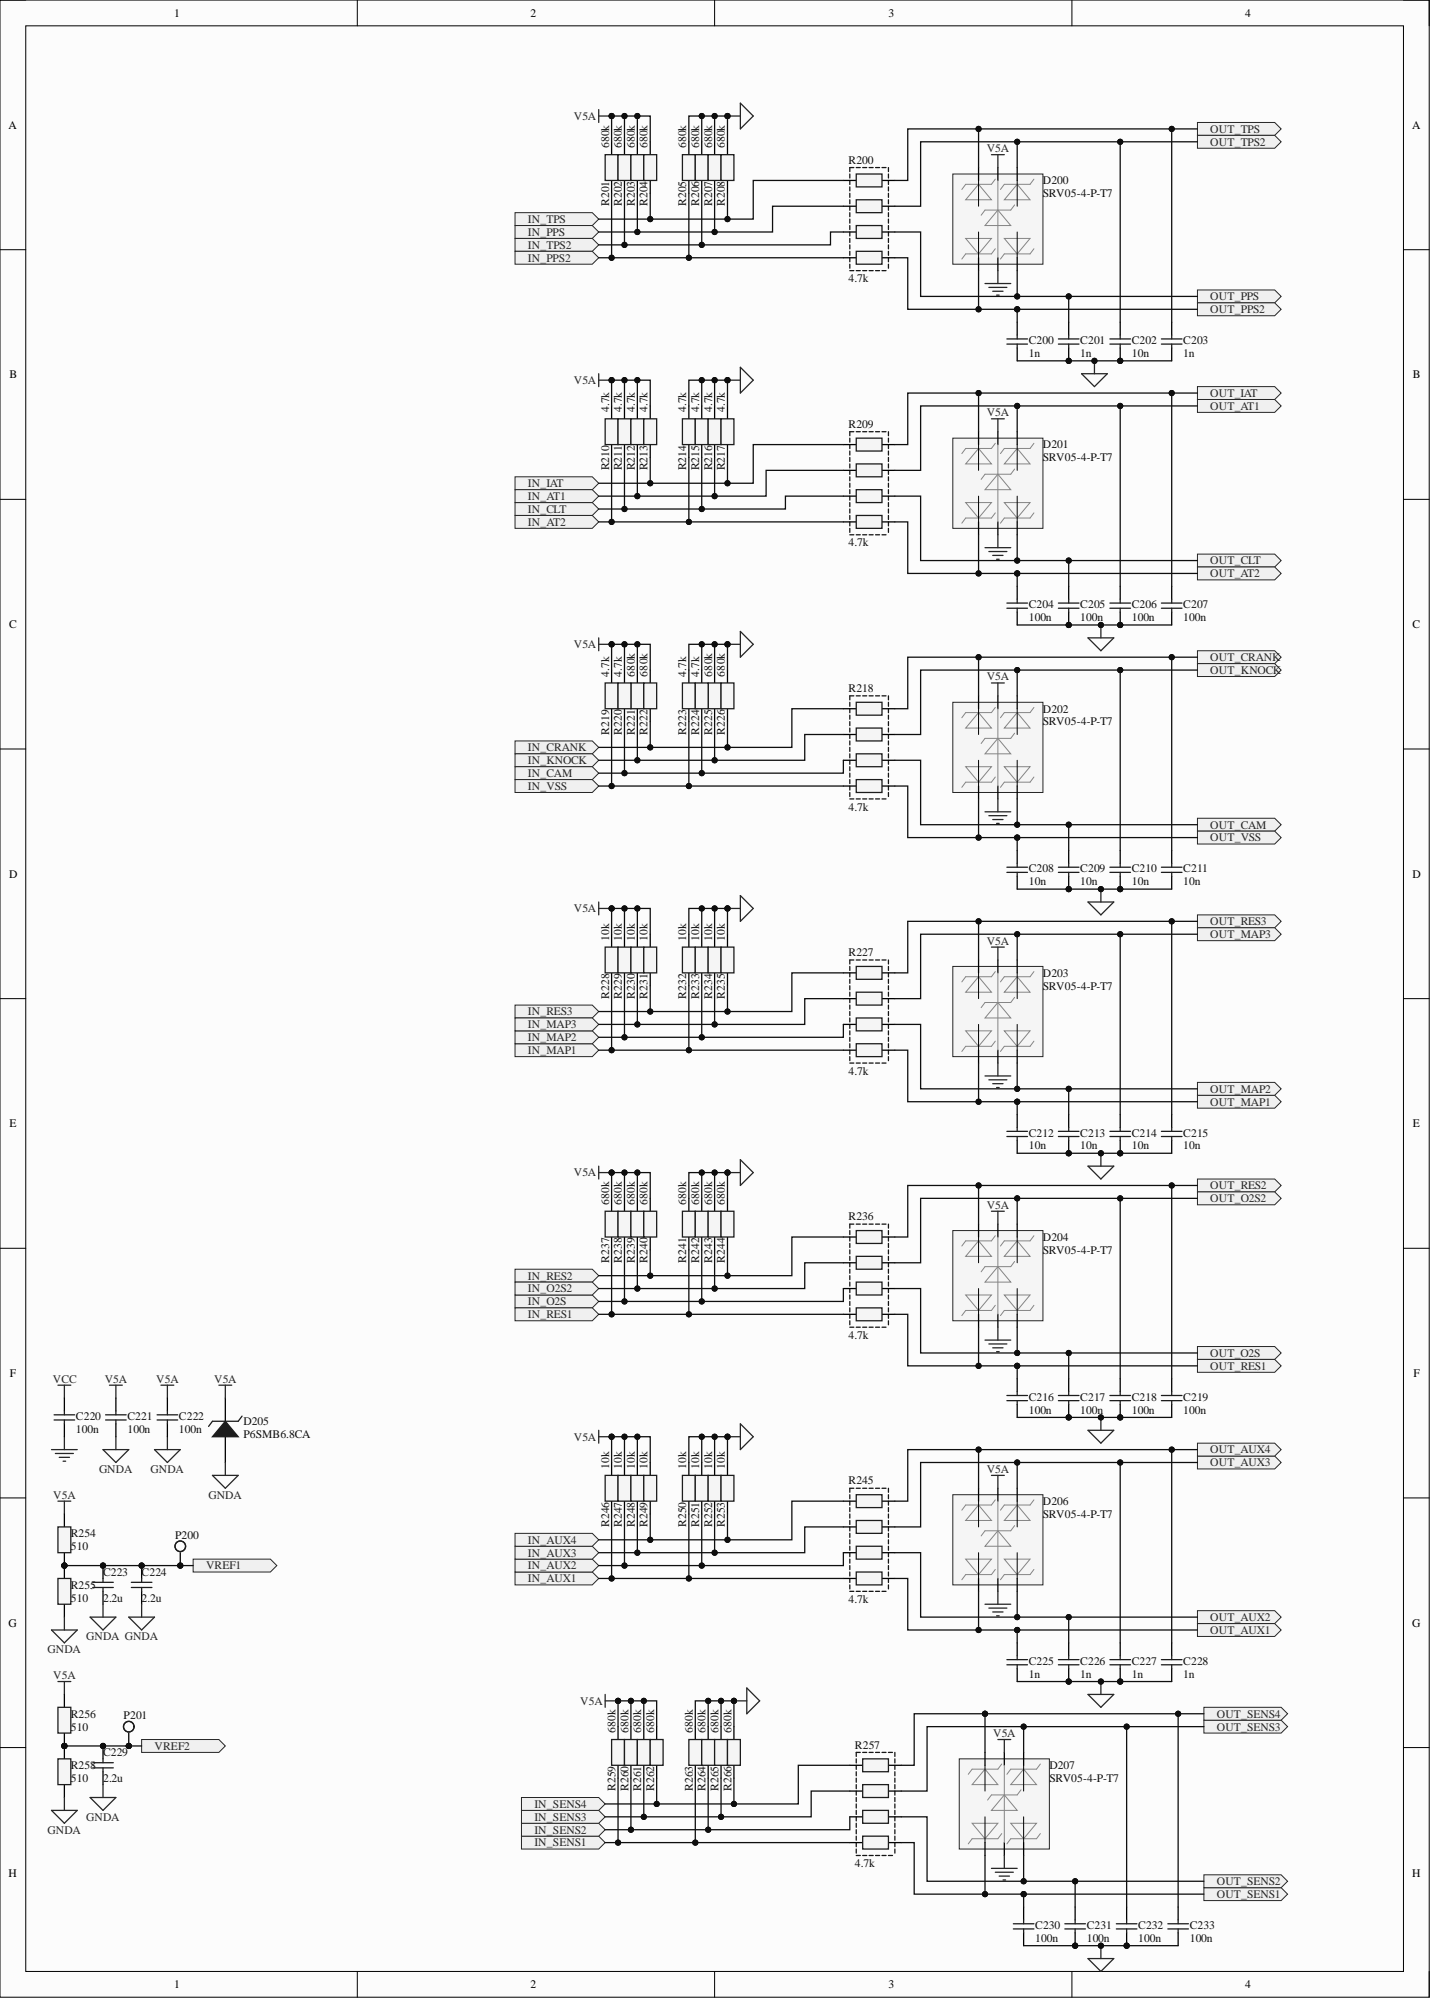
[picture p171: page 12]





USBM USBP USBID VBUS


More accurate threshold for "raw" connection of VR sensors

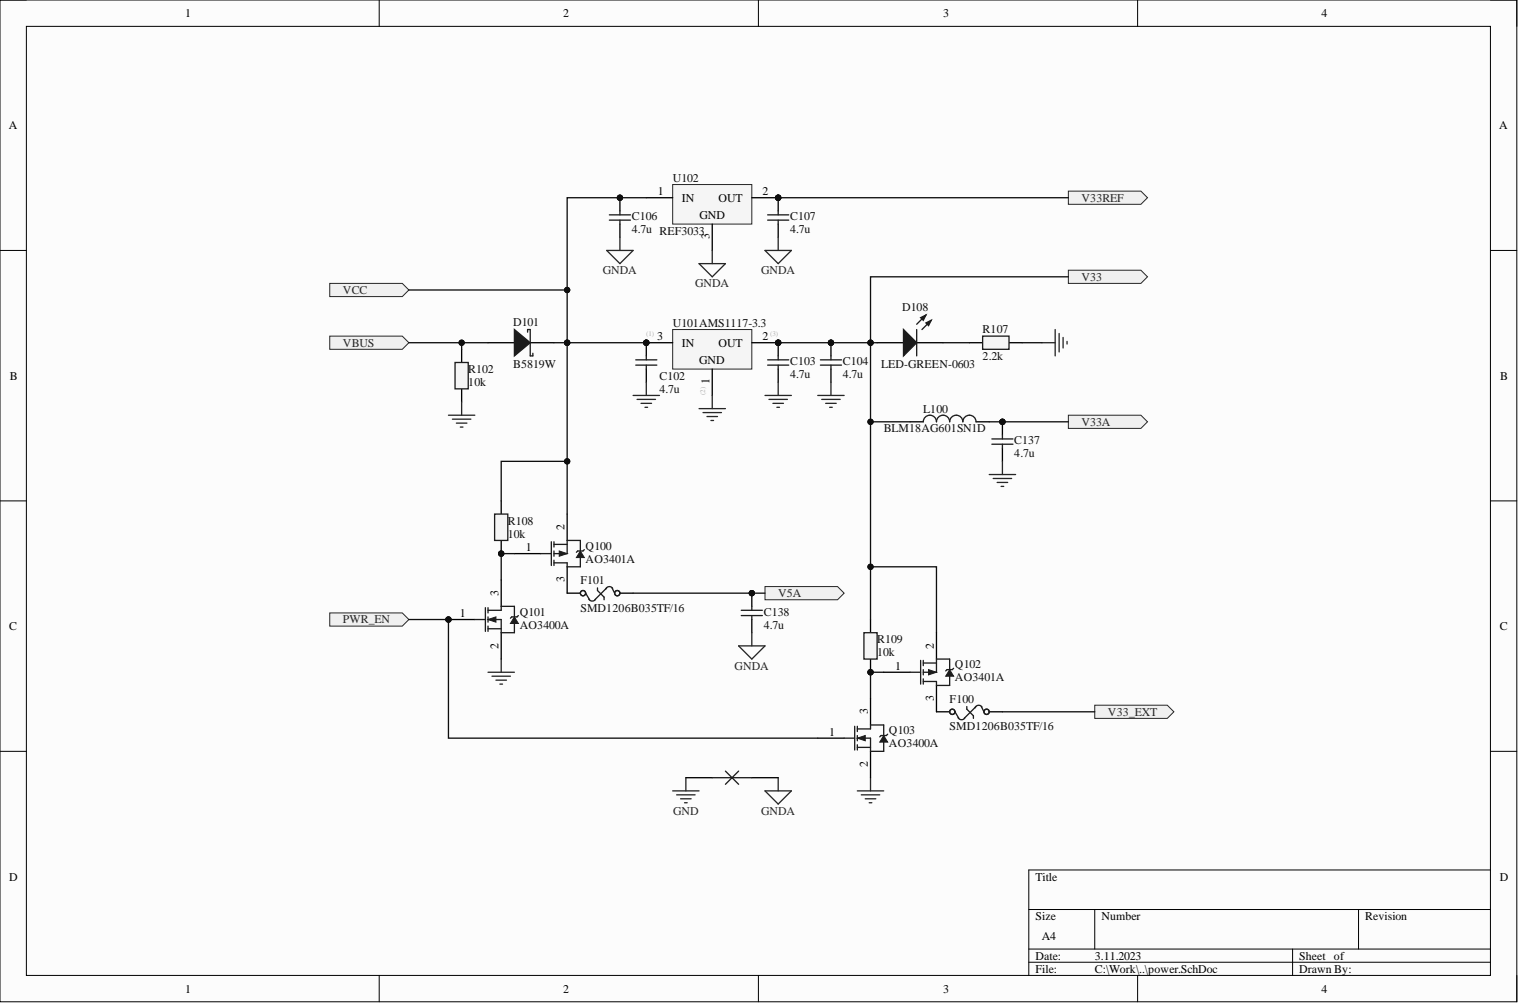
[picture p172: page 18]
