andreika-git/hellen-one/modules/mega-mcu144/0.2/mega-mcu144-schematic.pdf

D5 *D5 is digital-only on F429! (EINT11)

*VIGN input is unprotected!

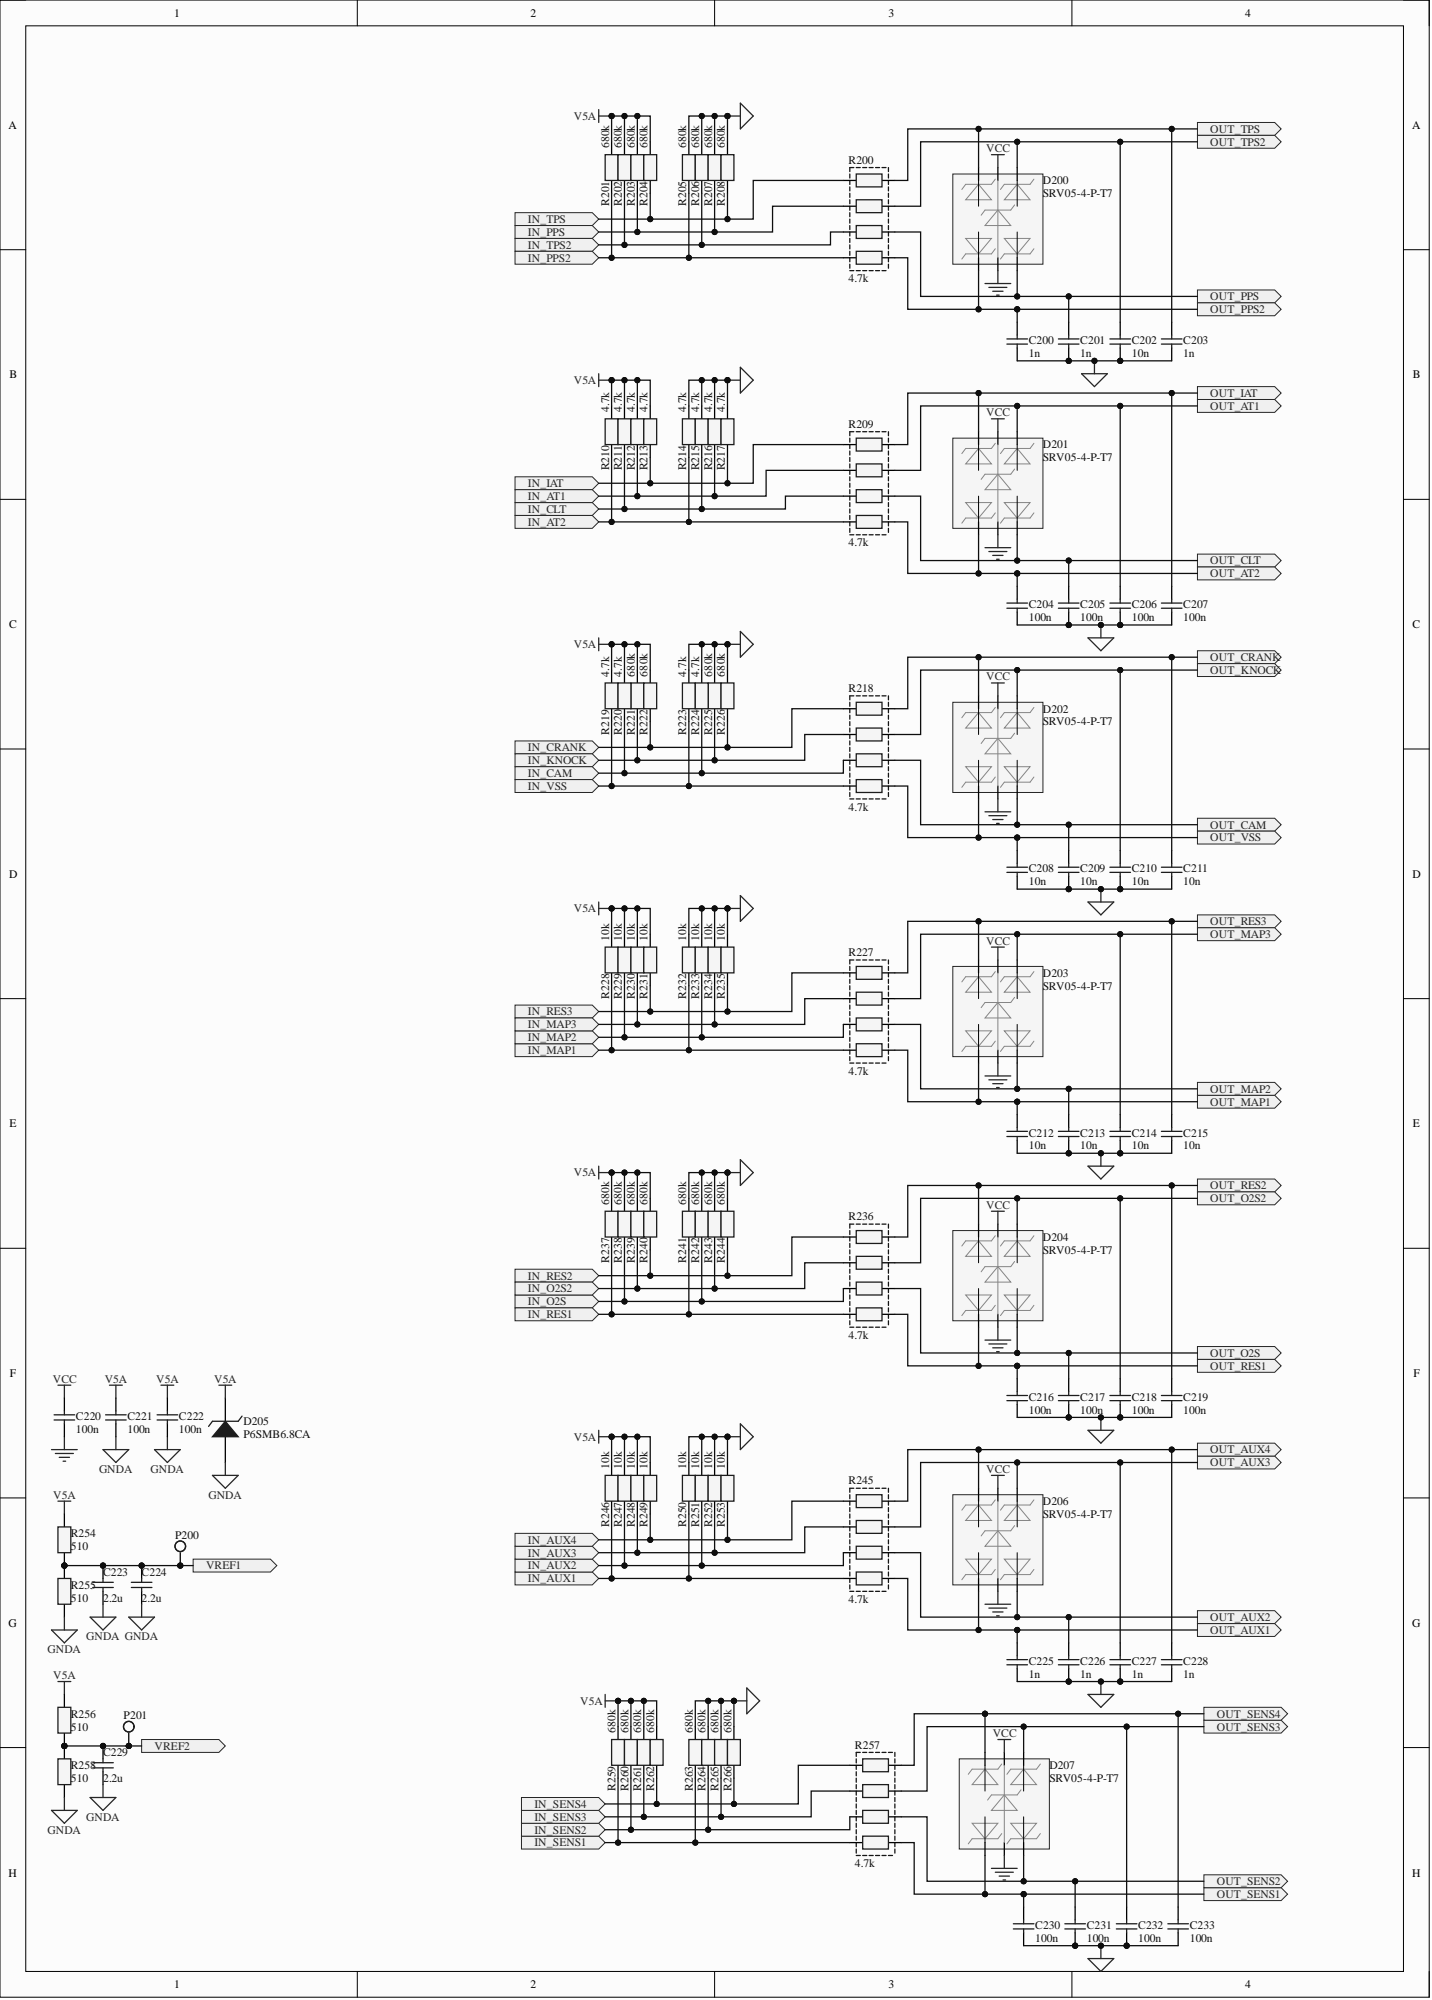
[picture p173: page 12]


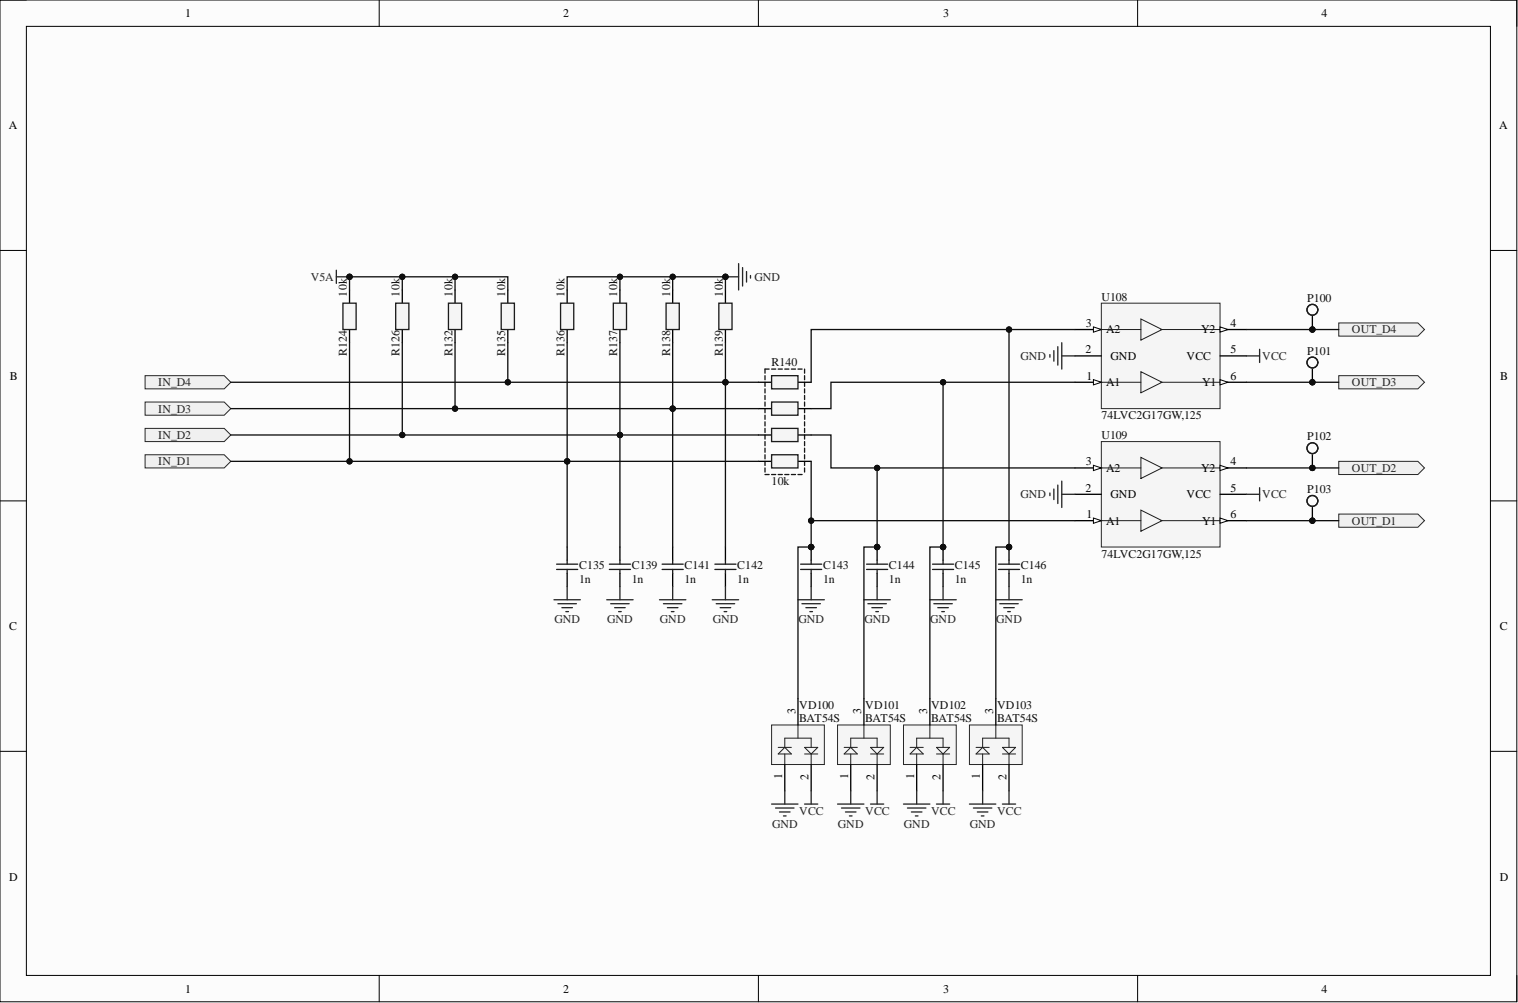
[picture p174: page 14]



USBM USBP USBID VBUS


More accurate threshold for "raw" connection of VR sensors

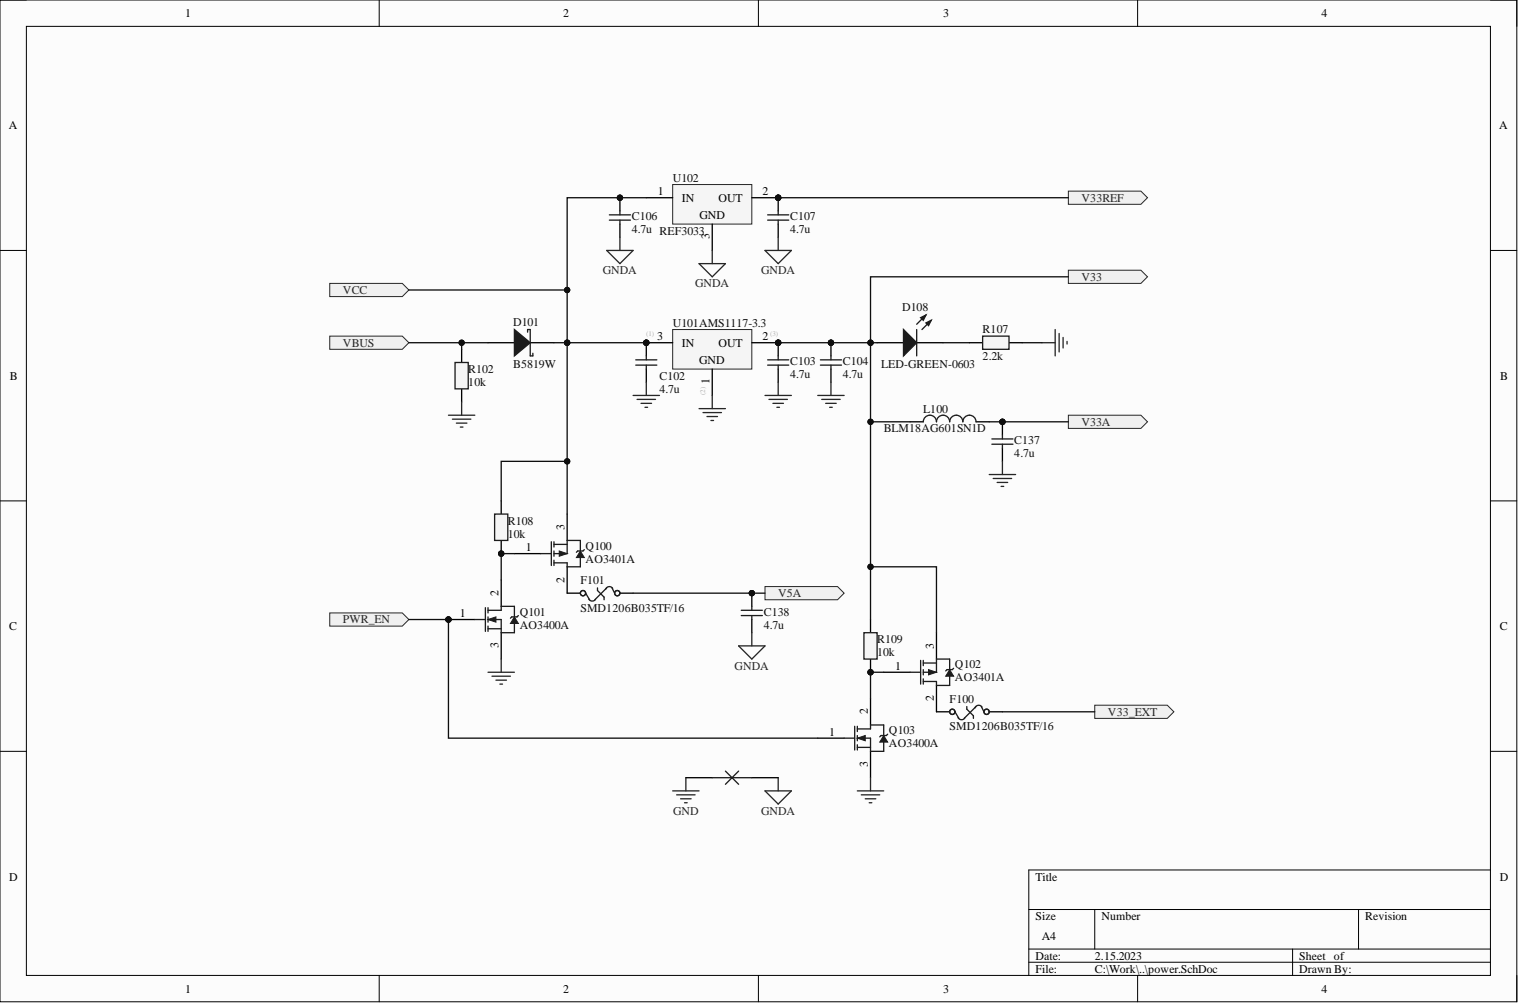
[picture p175: page 18]
