andreika-git/hellen-one/modules/mega-mcu144/0.1/mega-mcu144-schematic.pdf

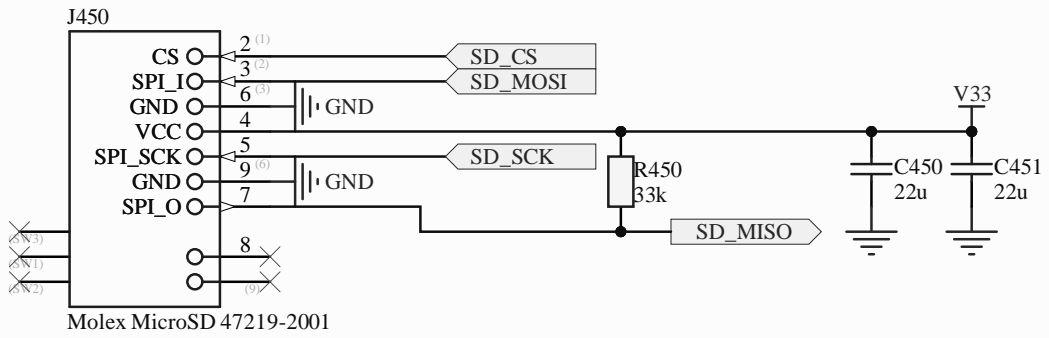
[picture p176: page 10]

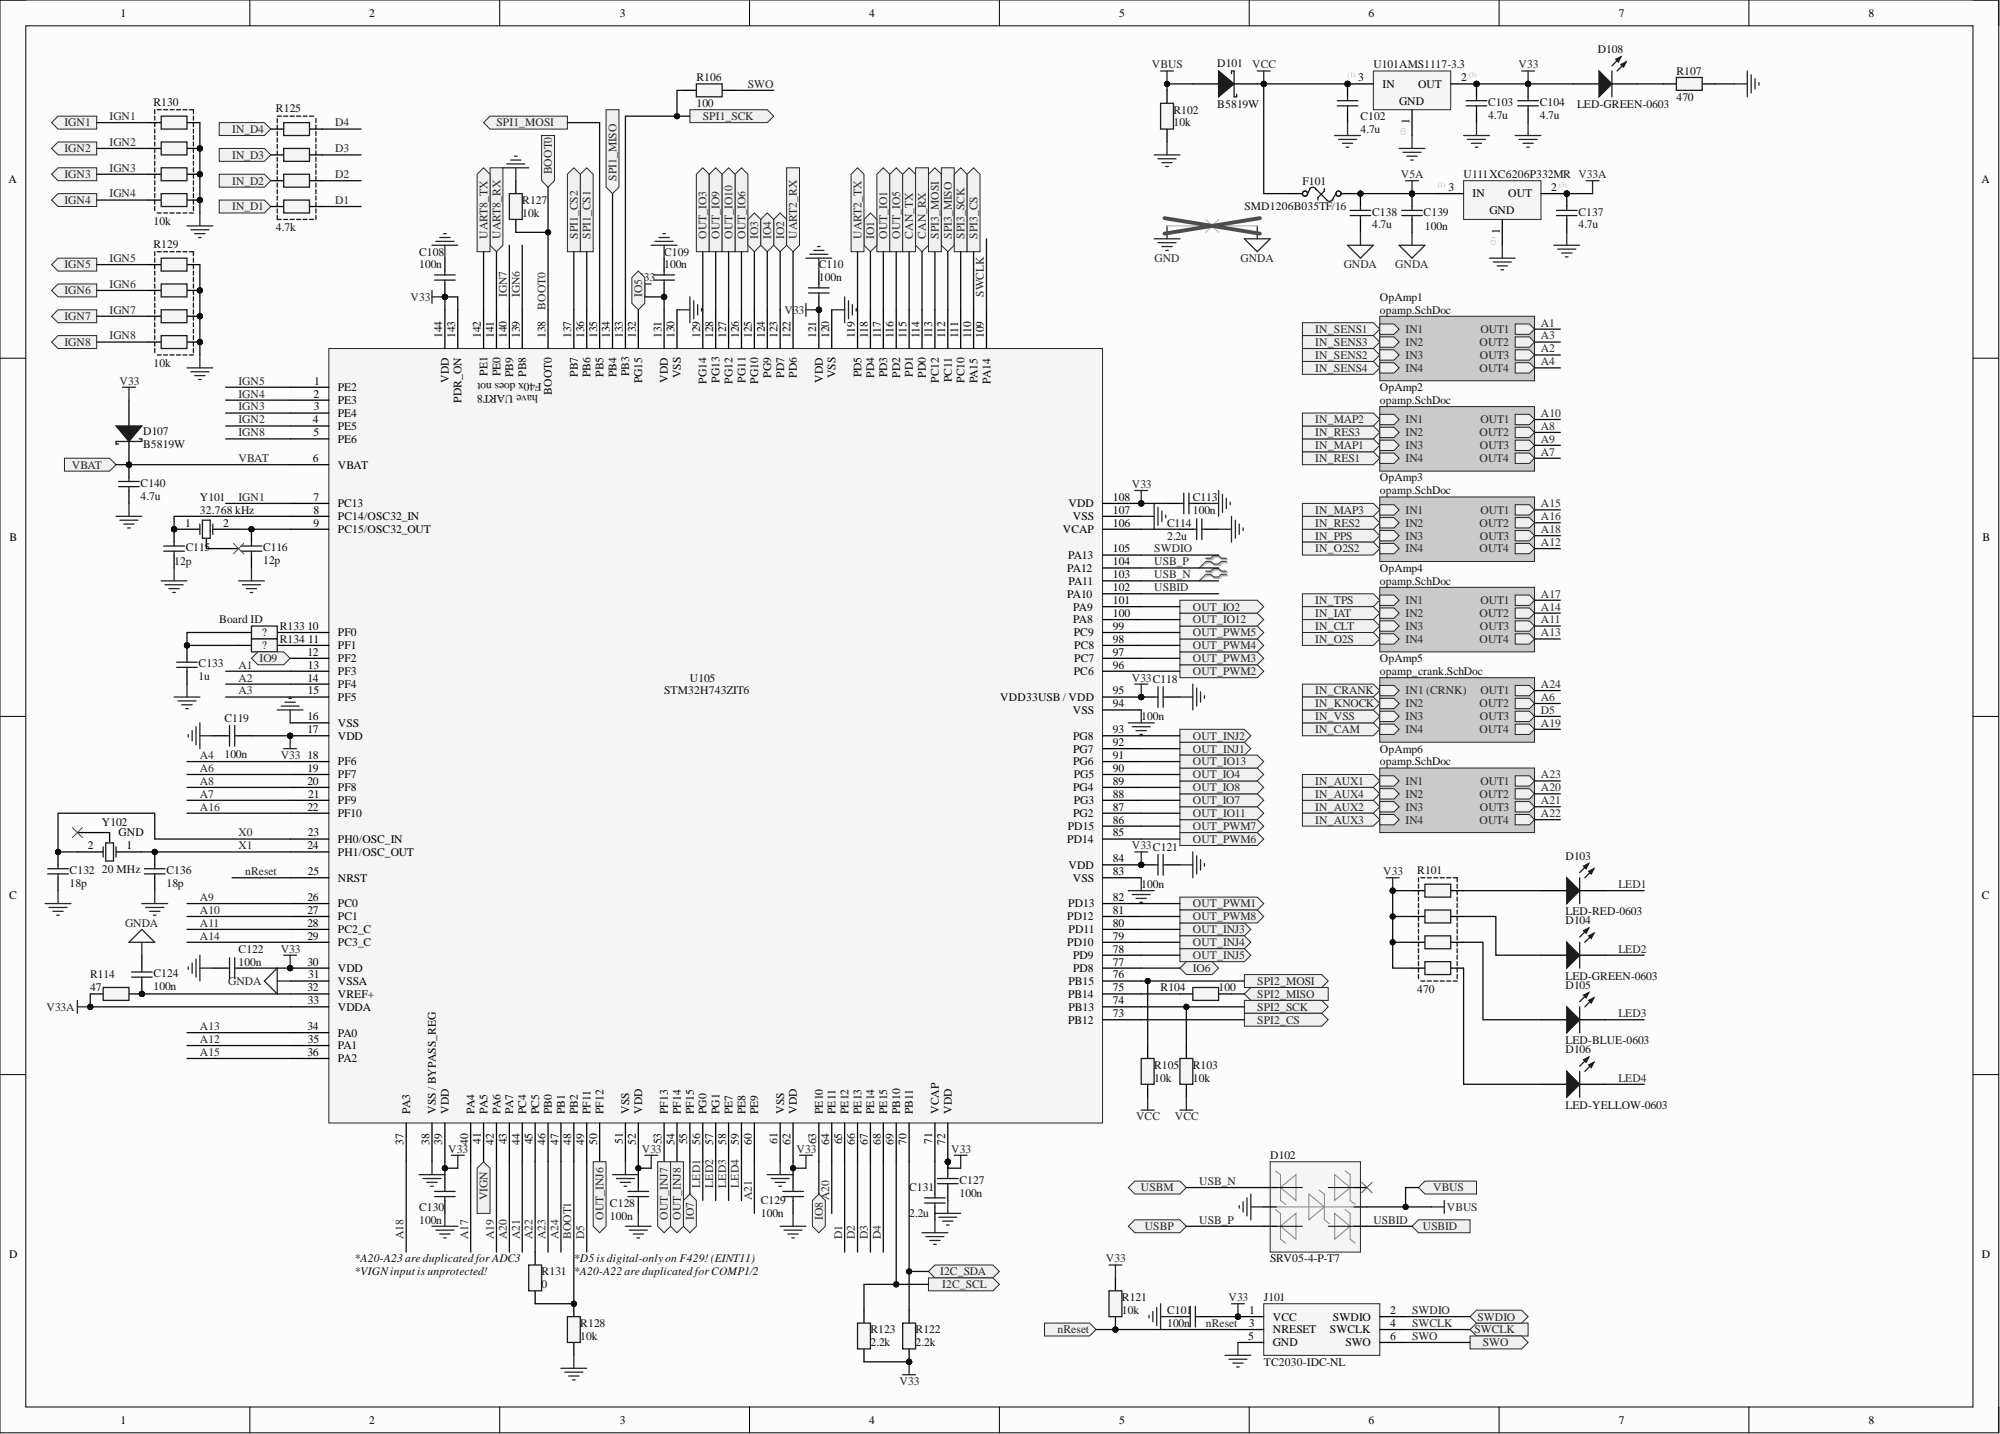
[picture p177: page 11]

D5 *D5 is digital-only on F429! (EINT11)

*VIGN input is unprotected!


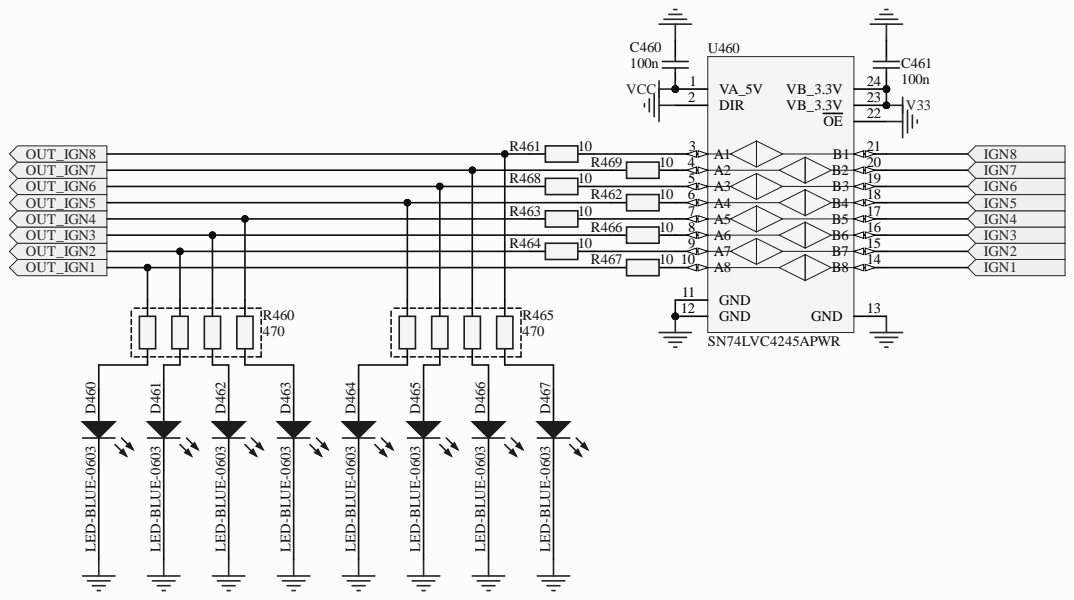
[picture p178: page 13]

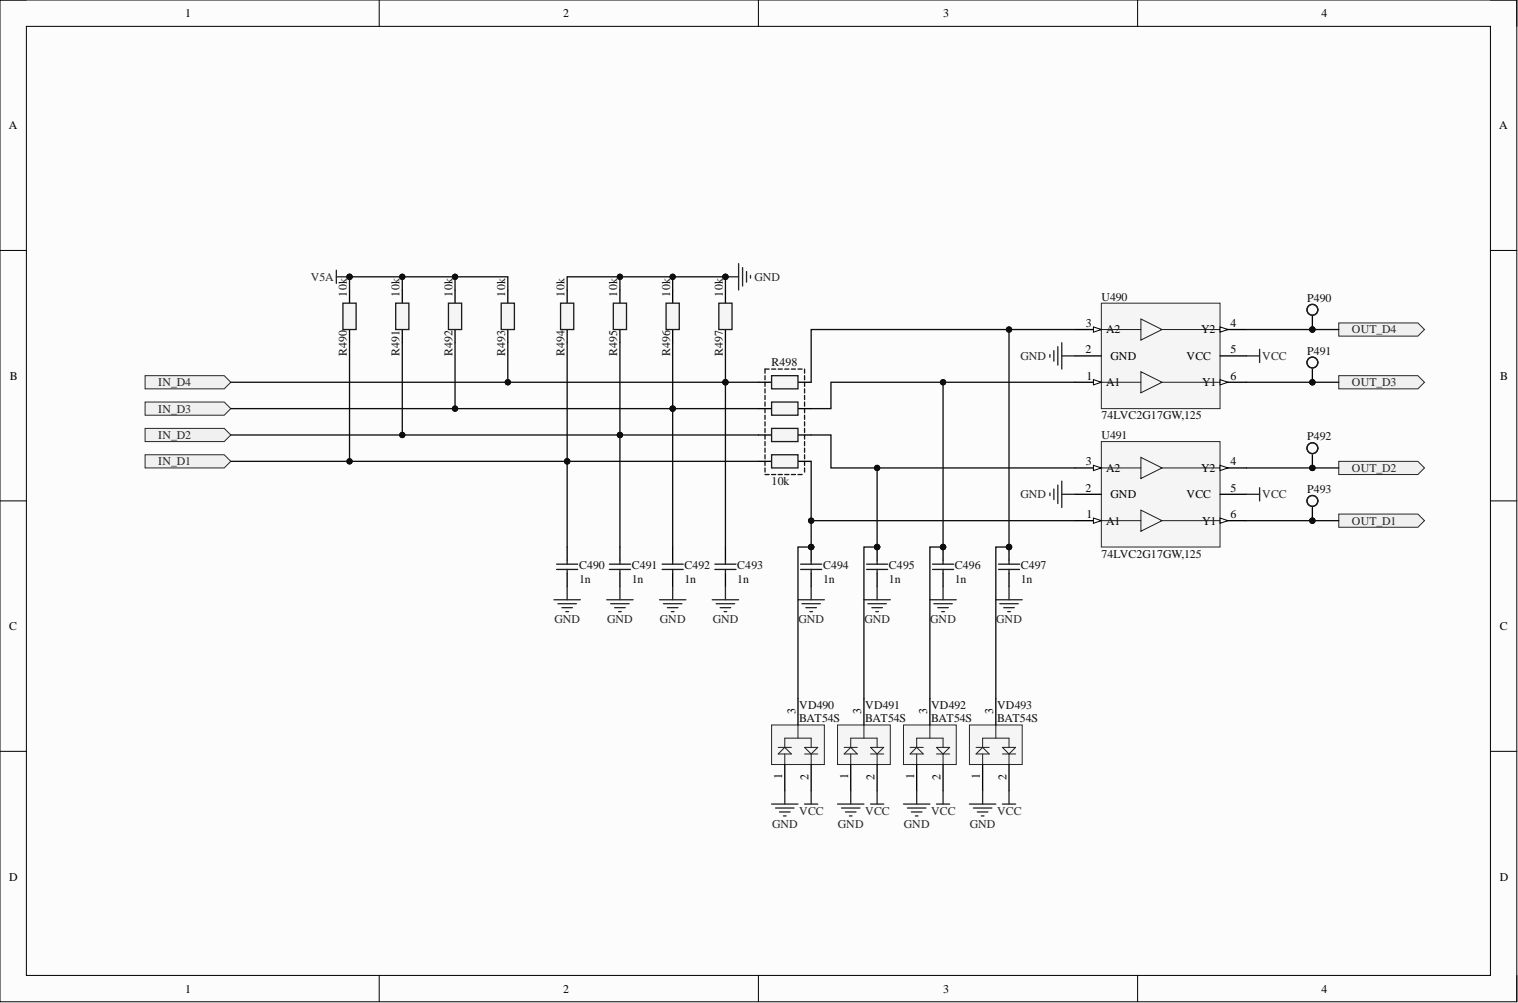
[picture p179: page 14]


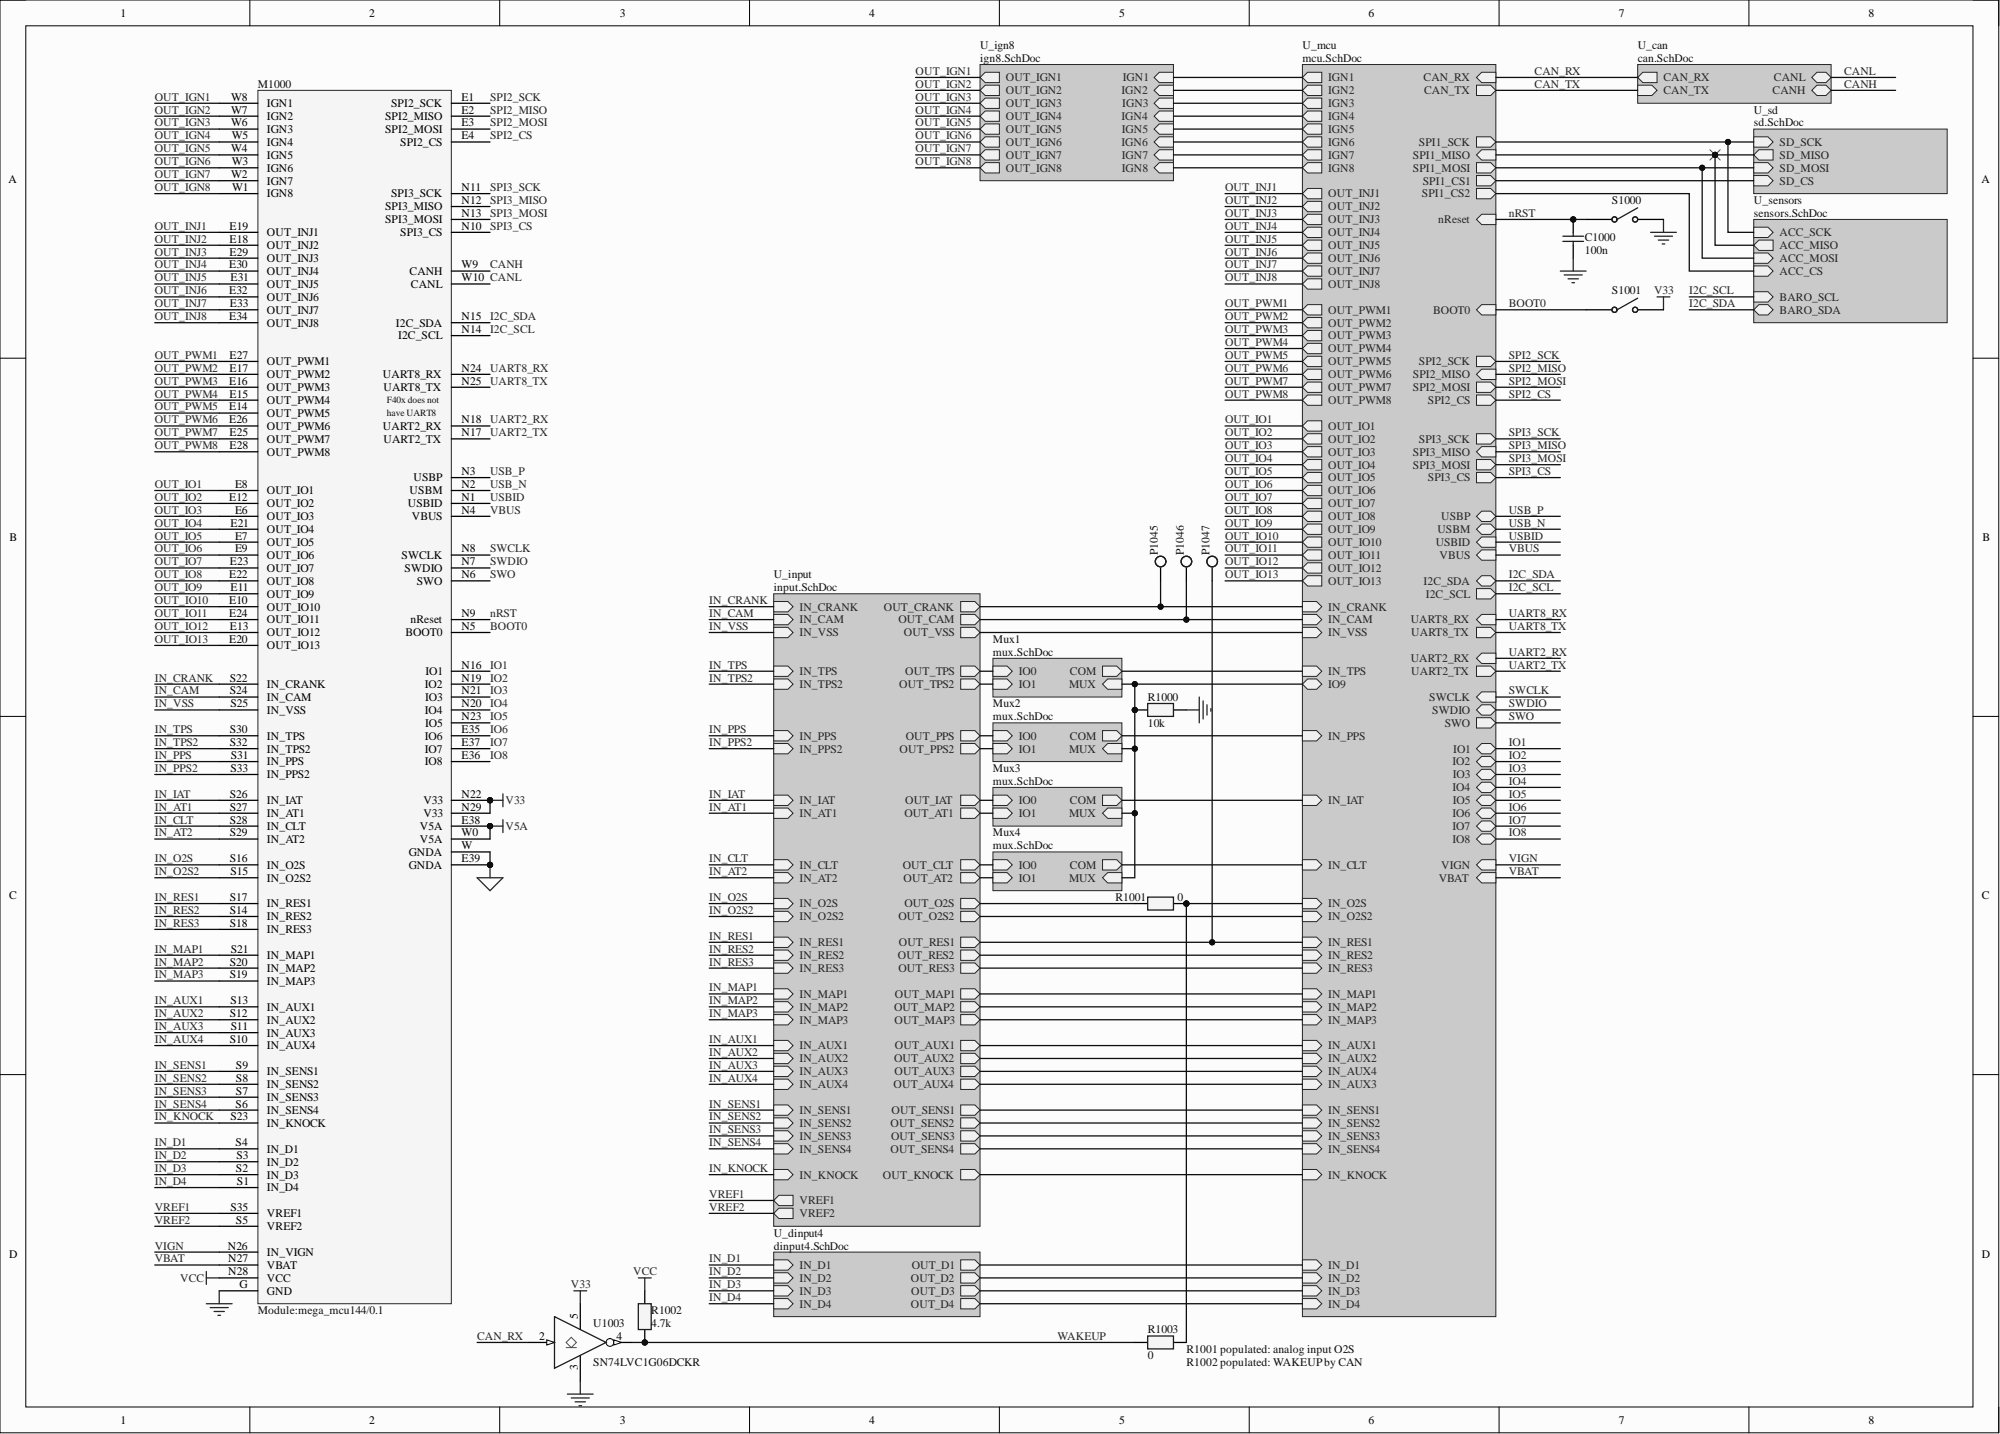
[picture p180: page 16]

USBM USBP USBID VBUS


More accurate threshold for "raw" connection of VR sensors

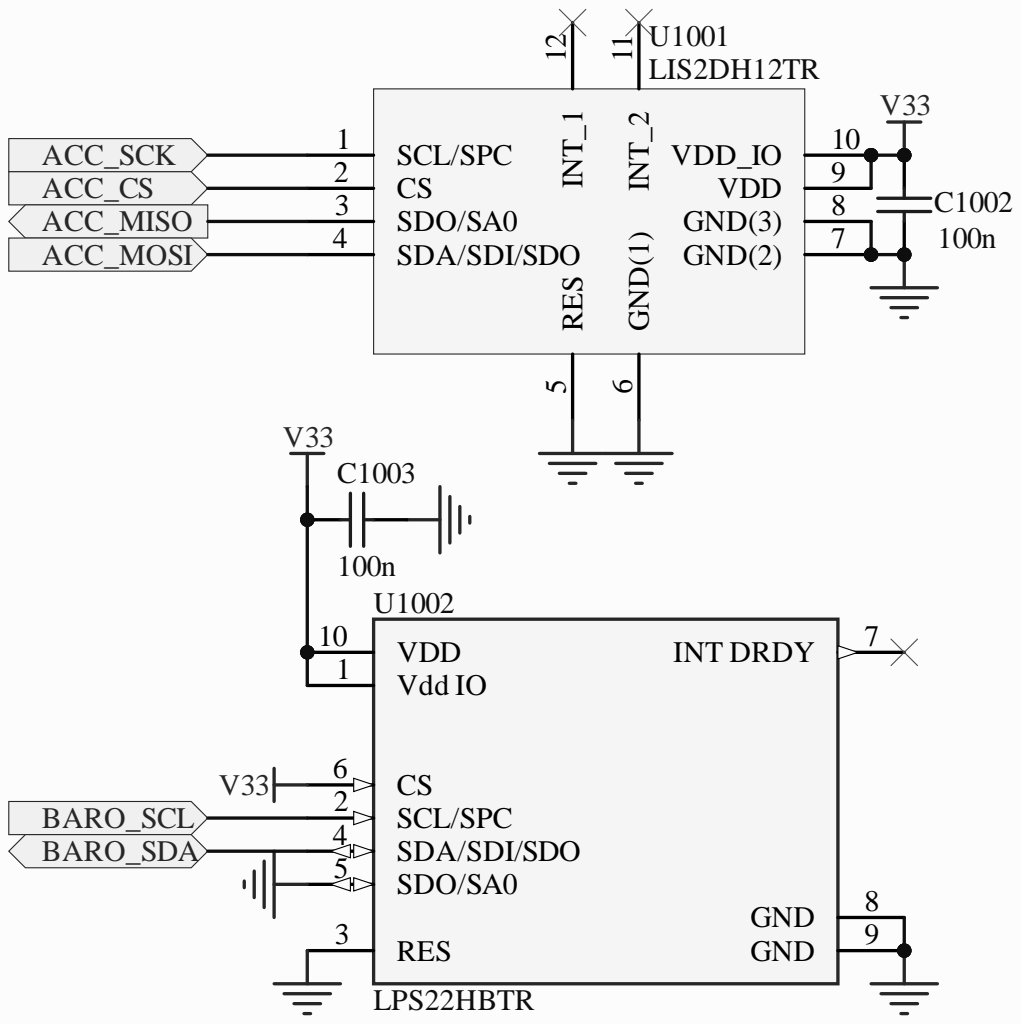
[picture p181: page 18]
