andreika-git/hellen-one/modules/vr-discrete/sim/kb1gtt-VR_inductor_reference_with_noise.asc

C1: cap; 0.001µ; V=50 Irms=55.6m Rser=5.11126 Lser=0 mfg="KEMET" pn="C0603C102K5RAC" type="X7R"
I1: current; PWL(1ms -0.001 2ms 0.001 3ms 0.01 4ms 0.025 5ms 0.05 5.5ms -0.05 6.5ms -0.025 7.5ms -0.01 8.5ms -0.001 9.5ms 0.001 10.0 0.001)
I2: current; SFFM(0A 10uA 100k 1 10k)
L1: ind2; 1m
L2: ind2; 1m
R1: res; 0.001R
R2: res; 10kR
R3: res; 5k
R4: res; 10kR
Named nets: 0
.tran 10ms
K L1 L2 0.9
