andreika-git/hellen-one/(list of files, drawings)

Other design files:
altium.shared/Mod.PcbLib
altium.shared/Mod.SchLib
kicad/modules/hellen1-vr-discrete/vr-discrete-simulation.pdsprj
