andreika-git/hellen-one/(commit log)

2021-02-21 update gerbmerge & kicad scripts
2021-02-21 fix render gerber for outlines
2021-02-23 update modules after refactoring
    [input-BOM.csv, mcu-BOM.csv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]
2021-02-23 Add logo to Kicad libs
2021-02-24 Add more expensive power5 revision 0.2
    [power5-BOM.csv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]
2021-02-24 fix R421 value
    [power5-BOM.csv]
2021-02-24 more GND for power5-0.2
    [power5.GTL]
2021-02-25 Move IO5 from PD4 to PD2 to expose SDIO on mcu
    [mcu.DRL, mcu.GBL, mcu.GTL]
2021-02-25 wbo module template based on mck1117_wideband
    [hellen1-wbo.kicad_pcb, hellen1-wbo.kicad_sch]
2021-02-25 output: fix MR and replace 555 with 4427
    [output-BOM.csv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]
2021-03-03 update wbo module (kicad source files)
    [hellen1-wbo.kicad_pcb, hellen1-wbo.kicad_sch]
2021-03-05 add a new module: vr
    [vr-BOM.csv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]
2021-03-08 update wbo module kicad src
    [hellen1-wbo.kicad_pcb, hellen1-wbo.kicad_sch]
2021-03-09 update copy_from_Kicad.py to process both frames & modules
2021-03-09 correct export path for pdf/vrml in hellen1-wbo.kicad_pro
2021-03-09 Add wbo module to Hellen-One: issue #13
    [wbo-BOM.csv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]
2021-03-09 Add new module dinput4
    [dinput4-BOM.csv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]
2021-03-10 update wbo
    [hellen1-wbo.kicad_pcb, hellen1-wbo.kicad_sch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]
2021-03-13 update wbo footprint (line width)
2021-03-13 A script to convert Kicad modules to AD
2021-03-14 more clearance for vr module footprint
2021-03-14 fix output module footprint zones
2021-03-14 update vr module (better keepout zone)
    [vr.GBL, vr.GBO, vr.GBS, vr.GKO, vr.GTL, vr.GTO, vr.GTP, vr.GTS]
2021-03-19 update wbo iBom footprints
2021-03-21 Add module gerber rotations (partial)
2021-03-21 process kicad footprint names https://github.com/andreika-git/hellen-one/issues/17
    [footprints.csv]
2021-03-21 update wbo module kicad source: https://github.com/andreika-git/hellen-one/issues/13 https://github.com/andreika-git/hellen-one/issues/17
    [hellen1-wbo.kicad_pcb, hellen1-wbo.kicad_sch]
2021-03-21 update modules wbo, vr, mcu https://github.com/andreika-git/hellen-one/issues/17
    [mcu-BOM.csv, vr-BOM.csv, wbo-BOM.csv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]
2021-03-22 Fix power5 border layer https://github.com/andreika-git/hellen-one/issues/18
    [power5.GBL, power5.GBO, power5.GBS, power5.GKO, power5.GTL, power5.GTO, power5.GTP, power5.GTS]
2021-03-22 Change LCSC# for AO3401A (output module BOM)
    [output-BOM.csv]
2021-03-22 add more iBom footprints
2021-03-23 fix for AD slot+round holes
2021-03-23 Move BOM replacements to a separate csv file https://github.com/rusefi/hellen121vag/issues/7
2021-03-23 Added hellen-one-board-creation-process
2021-03-23 Update hellen-one-board-creation-process
2021-03-25 add LED+diode to hellen-one-common kicad lib
2021-04-03 mcu144 initial commit
    [mcu144-BOM.csv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]
2021-04-09 update kicad gerber processing scripts
2021-04-10 fix 4k7->4.7k in BOM
    [input-BOM.csv, mcu-BOM.csv, mcu144-BOM.csv]
2021-04-10 fix for floating kicad rotations
2021-04-10 fix CPL rotation for SOP8 (LMR14020)
    [cpl_rotations_db.csv, power5-CPL.csv]
2021-04-10 JLC is playing with LCSC partnumbers :(
    [output-BOM.csv, power12-BOM.csv]
2021-04-10 Set LCSC# for SD-card
    [sd-BOM.csv]
2021-04-11 fix some BOM names exported from Kicad
2021-04-11 add proto area to kicad lib
2021-04-11 Refactor dinput4 module
    [dinput4.DRL, dinput4.GBL, dinput4.GBO, dinput4.GBS, dinput4.GKO, dinput4.GTL, dinput4.GTO, dinput4.GTP]
2021-04-11 fix scripts for newer Kicad version
2021-04-13 Update USB-mini kicad footprint (centroid)
2021-04-13 temporarily disable vrml&png board rendering
2021-04-16 add SO20POWER to kicad lib
2021-04-17 power12: SMCJ30CA -> SMCJ30A back in stock
    [power12-BOM.csv]
2021-04-17 update SO20POWER footprint
2021-04-24 wbo: add external swd pads
    [hellen1-wbo.kicad_pcb, hellen1-wbo.kicad_sch, wbo-BOM.csv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]
2021-04-27 more kicad footprints
2021-04-27 update kicad sym lib
2021-04-30 fix https://github.com/andreika-git/hellen-one/issues/33
    [dinput4.GBL, dinput4.GBO, dinput4.GBS, dinput4.GKO, dinput4.GTL, dinput4.GTO, dinput4.GTP, dinput4.GTS]
2021-05-01 fix some more JLC footprint rotations
    [cpl_rotations_db.csv]
2021-05-01 kicad lib: added accel.
2021-05-06 fix keepout layer for wbo module
    [wbo.GKO]
2021-05-12 add mcu v0.2 and fix https://github.com/andreika-git/hellen-one/issues/53
    [mcu-BOM.csv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]
2021-05-12 add mcu144 v0.2
    [mcu144-BOM.csv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]
2021-05-13 add vr-discrete module
    [hellen1-vr-discrete.kicad_pcb, hellen1-vr-discrete.kicad_sch, vr-discrete-BOM.csv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]
2021-05-19 add some common 3d models for kicad
    [0402 resistor.STEP, 0603 cap.STEP, 0603 resistor.STEP, 0805 cap.STEP, 0805 resistor.STEP, 1206 resistor.STEP, CAY16-F4.STEP, DO-214AA(SMB).STEP]
2021-05-19 update VRML files for kicad modules wbo and vr-discrete
2021-05-19 copy script was not creating .GKO layer for frames
2021-05-19 more common iBom footprints
    [footprints.csv]
2021-05-19 fix BATTERY-2032 footprint rotation
    [cpl_rotations_db.csv]
2021-05-20 fix footprint names in iBom
2021-05-20 update some kicad footprints https://github.com/rusefi/hellen121nissan/issues/7
2021-05-24 tiny fix for hellen-one-common.kicad_sym/Jumper-Pad-Pad
2021-05-24 vr-discrete: rename SRV05-4-P-T7 in BOM
    [vr-discrete-BOM.csv]
2021-05-24 vr-discrete: rename SRV05-4-P-T7 in kicad
    [hellen1-vr-discrete.kicad_pcb, hellen1-vr-discrete.kicad_sch]
2021-05-24 fix https://github.com/andreika-git/hellen-one/issues/46 and fix https://github.com/andreika-git/hellen-one/issues/47
    [output-BOM.csv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]
2021-05-24 fix BOM/LED-GREEN-0603 for vr-discrete
    [hellen1-vr-discrete.kicad_pcb, hellen1-vr-discrete.kicad_sch, vr-discrete-BOM.csv]
2021-05-24 typo in output.kicad_sym
2021-05-28 wbo 0.2
    [hellen1-wbo.kicad_pcb, hellen1-wbo.kicad_sch, wbo-BOM.csv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]
2021-05-30 vr-discrete: fix designator numbering
    [hellen1-vr-discrete.kicad_pcb, hellen1-vr-discrete.kicad_sch, vr-discrete-BOM.csv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]
2021-06-04 add paste to PAD-1206-PAD.kicad_mod
2021-06-04 update wbo module (fix paste layer for some pads)
    [hellen1-wbo.kicad_pcb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]
2021-06-23 mcu-0.3 & mcu144-0.3: add GND pad to the bottom layer + I2C pullups 2.2k
    [mcu-BOM.csv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]
2021-06-23 Add USB_B symbol+footprint to kicad common lib
2021-06-23 add ibom footprint PAD-TH-2.0
2021-06-23 mcu-0.3 mcu.kicad_mod
2021-07-08 mcu-0.4, mcu144-0.4: MCP6004 is back
    [mcu-BOM.csv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]
2021-07-10 Add 178780-1 footprint to kicad common lib
2021-08-14 mcu-0.5, mcu144-0.5 and Changelog
    [mcu-BOM.csv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]
2021-09-09 Kicad SOD123
    [SOD123F.STEP]
2021-09-28 wbo-0.3 https://github.com/andreika-git/hellen-one/issues/96
    [hellen1-wbo.kicad_pcb, hellen1-wbo.kicad_sch, wbo-BOM.csv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]
2021-09-28 fix wbo-0.3 footprint
2021-10-06 added support for custom board prefixes https://github.com/andreika-git/hellen-one/issues/99
2021-11-01 add PinHeader_1x08_P2.54mm_Vertical.kicad_mod
2021-12-17 add 1123794-2 connector to kicad libs
2021-12-20 MPXH6400A to kicad lib
    [MPXH6400A.STEP]
2021-12-20 more footprints for kicad lib
    [PG-DSO-8.STEP, PinHeader_1x06_P2.54mm_Vertical.STEP, PinHeader_1x08_P2.54mm_Vertical.STEP, PinHeader_2x05_P1.27mm_Vertical_SMD.STEP]
2021-12-22 add TL115 symbol to kicad lib
2021-12-24 more footprints to kicad lib
    [DPAK.STEP, SOT-23.STEP]
2021-12-24 better WL9981TC.kicad_mod
2021-12-27 better WL9981TC footprint
2021-12-28 add MOSFET symbols
2022-01-07 input module: add resistor values to the kicad symbol https://github.com/andreika-git/hellen-one/issues/128
2022-01-15 better iBom footprints
2022-01-15 fix some kicad footprint names
    [footprints.csv, vr-discrete-BOM.csv]
2022-01-15 Don't ignore empty BOM replacements needed for iBom
2022-01-15 more iBom footprints
    [footprints.csv]
2022-01-15 more flexible iBom footprint parser
2022-02-07 repl_BOM board_id include support
2022-02-07 fix 3d model for PAD-0805-PAD kicad footprint
2022-02-07 fix 3d model for PAD-1206-PAD kicad footprint
2022-02-07 mcu-0.6 and mcu144-0.6
    [mcu-BOM.csv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]
2022-02-07 board-id scripts
    [board_id_72_NB2-e.csv, board_id_unknown.csv, board_ids.csv, resistors.csv]
2022-02-07 AD shared module libs
    [Mod.PcbLib, Mod.SchLib]
2022-02-11 a few new board-ids
    [board_id_81hd-a.csv, board_id_alpha2ch-b.csv, board_id_alpha4ch-a.csv, board_ids.csv]
2022-02-14 add DPAK-5 and USB-B-V footprints to Kicad lib
    [DPAK-5.STEP]
2022-02-16 fix USB-MINI-B-HORIZONTAL footprint rotation for JLC
2022-03-04 add PSM712 symbol to kicad lib
2022-03-17 more board IDs
    [board_id_alpha2ch-c.csv, board_id_na6_94-c.csv, board_id_nb1-c.csv, board_ids.csv]
2022-03-17 better padds for SMD-2_2.9x3.9x1.7.kicad_mod
2022-03-18 ign8-0.2: Fixed module border misalignment
    [ign8-BOM.csv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]
2022-03-26 Major update: Python 3.x migration + new board render scripts!
2022-05-16 gm-e67 & 55bmw & gm-e38
    [board_ids.csv]
2022-05-16 Revert "gm-e67 & 55bmw & gm-e38"
    This reverts commit 33aa77ef9b275af73a469eff8a9728f8f8b242a9.
    [board_ids.csv]
2022-05-16 new board_ids: gm-e67-a & 55bmw-a & gm-e38-a (+initial readme)
    [board_id_55bmw-a.csv, board_id_gm-e38-a.csv, board_id_gm-e67-a.csv, board_ids.csv]
2022-05-16 remove python gerber dependency
2022-05-18 test board
    [1test-BOM.csv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]
2022-05-18 new boardid: 72_NB2-f
    [board_id_72_NB2-f.csv, board_ids.csv]
2022-06-10 board_id for alpha4ch-c
    [board_id_alpha4ch-c.csv, board_ids.csv]
2022-06-19 Added 1mm holes under ETB driver L6205PD
2022-06-19 Direct connection for ETB driver
2022-06-19 1mm vias under WBO MOSFET for hand soldering
    [hellen1-wbo.kicad_pcb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]
2022-06-19 rename board_id_81hd-b.csv
    [board_id_81hd-b.csv, board_ids.csv]
2022-06-21 Created 88bmw-b board
    [board_id_88bmw-b.csv, board_ids.csv]
2022-06-29 Board ID for gm-e67-b
    [board_id_gm-e67-b.csv, board_ids.csv]
2022-08-08 Board ID for 121nissan-d https://github.com/rusefi/hellen121nissan/issues/20
    [board_id_154hyundai-d.csv, board_ids.csv]
2022-08-21 Board-ID for 4ch-e
    [board_id_alpha4ch-e.csv, board_ids.csv]
2022-08-24 Board ID for NA6_94-d
    [board_id_na6_94-d.csv, board_ids.csv]
2022-08-30 Board-ID for 2ch-d
    [board_id_alpha2ch-d.csv, board_ids.csv]
2022-08-30 fix JLC orientations for SOT23-6
    [cpl_rotations_db.csv, input-CPL.csv, mcu-CPL.csv, mcu144-CPL.csv, vr-discrete-CPL.csv]
2022-08-30 better silk for power5/D420 (SMA diode)
    [power5.GTO]
2022-09-02 Board id fore67-C #181
    [board_id_gm-e67-c.csv, board_ids.csv]
2022-10-01 mcu-0.7 and mcu144-0.7
    [mcu-BOM.csv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]
2022-10-17 more boards in the pipeline!
    [board_ids.csv]
2022-11-08 Перепланировка на двусторонний монтаж
    4 layers
    Update hellen1-vr-discrete.kicad_pcb
    Обновила контур, доработка внутри
    класс цепей
    сквозные пады GND
    [hellen1-vr-discrete.kicad_pcb]
2022-11-08 add VR 0.2
    [hellen1-vr-discrete.kicad_pcb]
2022-11-08 VR 0.2 progress
    [hellen1-vr-discrete.kicad_pcb, hellen1-vr-discrete.kicad_sch]
2022-11-08 add can
    [hellen1-wbo.kicad_sch]
2022-11-08 adding CAN
    [hellen1-wbo.kicad_pcb, hellen1-wbo.kicad_sch]
2022-11-08 new wbo module
    правки
    финал
    [hellen1-wbo.kicad_pcb, hellen1-wbo.kicad_sch]
2022-11-09 add blue text
    [hellen1-wbo.kicad_sch]
2022-11-09 rename output files
    [vr-discrete-BOM.csv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]
2022-11-09 Add gerbers
    [wbo-BOM.csv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]
2022-11-26 add knock 0.2
    [knock-BOM.csv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]
2022-12-01 mega144 CAN wakeup
    [mega-mcu144-BOM.csv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]
2022-12-02 add module "power"
    [power-BOM.csv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]
2022-12-02 correct file
    [power.DRL]
2022-12-02 correct files
    [knock.DRL]
2022-12-05 #210 CPL without Val column
    [wbo-CPL.csv]
2022-12-05 add knock module
    [Mod.PcbLib, Mod.SchLib]
2022-12-05 Add pins PG, EN for TLS115
    [power-BOM.csv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]
2022-12-05 Revert "add knock module"
    This reverts commit a20d23a5ecdfd47b27c923047c83634a1a1ebb11.
    [Mod.PcbLib, Mod.SchLib]
2022-12-05 add knock 0/2
    [Mod.PcbLib, Mod.SchLib]
2022-12-05 Mega144 CPL, CSV fix
    [mega-mcu144-BOM.csv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]
2022-12-05 Mega144 extra GNDA, 5VA pins
    [Mod.PcbLib, Mod.SchLib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]
2022-12-06 Honda K
    [board_ids.csv]
2022-12-06 removed column "package"
    [vr-discrete-CPL.csv]
2022-12-06 changed the order
    [knock-CPL.csv]
2022-12-06 removed "Layer" from columns "Layer"
    [knock-CPL.csv]
2022-12-06 power -> power_12and5V
    [power_12and5V-BOM.csv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]
2022-12-06 changed the order again
    [knock-CPL.csv]
2022-12-06 gerber files for kicad modules
    [hellen1-vr-discrete-B_Cu.gbl, hellen1-vr-discrete-B_Mask.gbs, hellen1-vr-discrete-B_Silkscreen.gbo, hellen1-vr-discrete-Edge_Cuts.gm1, hellen1-vr-discrete-F_Cu.gtl, hellen1-vr-discrete-F_Mask.gts, hellen1-vr-discrete-F_Paste.gtp, hellen1-vr-discrete-F_Silkscreen.gto]
2022-12-06 add batch files to copy kicad modules
2022-12-07 actual gerbers
    [hellen1-vr-discrete-B_Cu.gbl, hellen1-vr-discrete-B_Mask.gbs, hellen1-vr-discrete-B_Silkscreen.gbo, hellen1-vr-discrete-F_Cu.gtl, hellen1-vr-discrete-F_Mask.gts, hellen1-vr-discrete-F_Paste.gtp, hellen1-vr-discrete-F_Silkscreen.gto, hellen1-vr-discrete-Module_Edge.gbr]
2022-12-07 4 layer kicad modules support #223
    [vr-discrete-BOM.csv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]
2022-12-07 manual 2l 4l fix
    [vr-discrete.GBP, vr-discrete.GM1]
2022-12-07 correct gerbers
    [hellen1-wbo-B_Cu.gbl, hellen1-wbo-B_Paste.gbp, hellen1-wbo-B_Silkscreen.gbo, hellen1-wbo-Edge_Cuts.gm1, hellen1-wbo-F_Cu.gtl, hellen1-wbo-F_Mask.gts, hellen1-wbo-F_Paste.gtp, hellen1-wbo-F_Silkscreen.gto]
2022-12-07 used the script
    [wbo-BOM.csv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]
2022-12-07 Revert "used the script"
    This reverts commit adbd5d21c663720b0bb395b9eb4dc17947f9a619.
    [wbo-BOM.csv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]
2022-12-07 used the script in v0.4
    [wbo-BOM.csv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]
2022-12-08 footprint link
2022-12-08 added power module
    [Mod.PcbLib, Mod.SchLib]
2022-12-09 some fresh boards
    [board_id_alpha2ch-e.csv, board_id_alpha4ch-f.csv, board_id_hellen-honda-k-a.csv]
2022-12-09 added 9th input pin - VDDA
    [hellen1-wbo-B_Cu.gbl, hellen1-wbo-B_Mask.gbs, hellen1-wbo-B_Paste.gbp, hellen1-wbo-B_Silkscreen.gbo, hellen1-wbo-Edge_Cuts.gm1, hellen1-wbo-F_Cu.gtl, hellen1-wbo-F_Mask.gts, hellen1-wbo-F_Paste.gtp]
2022-12-09 generated .bat and removed .G3 (old file)
    [wbo-BOM.csv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]
2022-12-09 GBP fix
    [wbo.GBP]
2022-12-09 BOM mega144 fix
    [mega-mcu144-BOM.csv]
2022-12-10 Fix button value, CPL, symbol value
    [mega-mcu144-BOM.csv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]
2022-12-10 Rotate 180 mega-mcu144
    [mega-mcu144-CPL.csv, mega-mcu144.DRL, mega-mcu144.GBL, mega-mcu144.GBO, mega-mcu144.GBP, mega-mcu144.GBS, mega-mcu144.GKO, mega-mcu144.GTL]
2022-12-10 mega144 GM15 outline
    [mega-mcu144.GBL, mega-mcu144.GBO, mega-mcu144.GBP, mega-mcu144.GBS, mega-mcu144.GKO, mega-mcu144.GTL, mega-mcu144.GTO, mega-mcu144.GTP]
2022-12-10 Slide power12_5 footprint
2022-12-10 Mega144 designators fix
    [mega-mcu144-BOM.csv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]
2022-12-11 Update JLC rotations
    [cpl_rotations_db.csv]
2022-12-11 Mega144 BOM footprint fix
    [mega-mcu144-BOM.csv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]
2022-12-11 Fix knock 0.2 footprint
    [cpl_rotations_db.csv]
2022-12-14 removed via
    [hellen1-wbo-B_Cu.gbl, hellen1-wbo-B_Mask.gbs, hellen1-wbo-B_Paste.gbp, hellen1-wbo-B_Silkscreen.gbo, hellen1-wbo-Edge_Cuts.gm1, hellen1-wbo-F_Cu.gtl, hellen1-wbo-F_Mask.gts, hellen1-wbo-F_Paste.gtp]
2022-12-14 new gerbers
    [wbo.DRL, wbo.GBL, wbo.GBO, wbo.GBS, wbo.GTL, wbo.GTO, wbo.GTP, wbo.GTS]
2022-12-14 removed LCSC number for DNP
    [hellen1-wbo.csv, hellen1-wbo.kicad_pcb, hellen1-wbo.kicad_sch, wbo-BOM.csv]
2022-12-15 new gerbers (without edge)
    [hellen1-vr-discrete-B_Cu.gbl, hellen1-vr-discrete-B_Mask.gbs, hellen1-vr-discrete-B_Paste.gbp, hellen1-vr-discrete-B_Silkscreen.gbo, hellen1-vr-discrete-Edge_Cuts.gm1, hellen1-vr-discrete-F_Cu.gtl, hellen1-vr-discrete-F_Mask.gts, hellen1-vr-discrete-F_Paste.gtp]
2022-12-27 MM-0.2 footprint and symbol
    [Mod.PcbLib, Mod.SchLib]
2022-12-27 MM-0.2 kicad sym and fp
2023-01-03 Explicit error in case of duplicated designator #244
2023-01-09 MM-0.2 PWR_EN pulldown
    [mega-mcu144-BOM.csv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]
2023-01-16 ver 0.4
    add C768, C769 (#247)
    [hellen1-vr-discrete-B_Cu.gbl, hellen1-vr-discrete-B_Mask.gbs, hellen1-vr-discrete-B_Paste.gbp, hellen1-vr-discrete-B_Silkscreen.gbo, hellen1-vr-discrete-Edge_Cuts.gm1, hellen1-vr-discrete-F_Cu.gtl, hellen1-vr-discrete-F_Mask.gts, hellen1-vr-discrete-F_Paste.gtp]
2023-01-16 add ver 0.4
    [vr-discrete-BOM.csv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]
2023-01-31 case matters? how did it work on 8chan-rev-A?
2023-02-01 more boards :)
    [board_id_154hyundai-d.csv, board_id_hellen-honda-k-b.csv, board_ids.csv]
2023-02-01 100k knock fix
    [knock-BOM.csv]
2023-02-01 Upd MM-0.2 designators
    [mega-mcu144-BOM.csv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]
2023-02-15 Decrease 3.3v LED brightness
    [mega-mcu144-BOM.csv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]
2023-02-15 Decrease 5V LEDs brightness
    [power_12and5V-BOM.csv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]
2023-02-15 100k JLC part fix
    [knock-CPL.csv, knock.GBL, knock.GBO, knock.GBP, knock.GBS, knock.GKO, knock.GTL, knock.GTO]
2023-02-15 honda125-b id
    [board_id_honda125-b.csv, board_ids.csv]
2023-03-01 MM-0.2 4.7k BOM fix
    [mega-mcu144-BOM.csv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]
2023-03-10 MM-0.3
    Changelog:
    - Fixed Q100-103 pinout
    - SRV05-4 input protection, BAT54S digital protection and Schmitt triggers connected to switchable 5VA (instead of always on 5V)
    [mega-mcu144-BOM.csv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]
2023-03-17 use pcb-tools fork
2023-04-01 #281 CANH and CANL aren`t flipped now
    [hellen1-wbo.kicad_pcb, hellen1-wbo.kicad_sch]
2023-04-02 SMD type footprint
2023-04-03 vr-discrete vrml origin fix #266
    [hellen1-vr-discrete.kicad_pcb]
2023-04-03 Revert "rev.0.5"
    This reverts commit 1b065dd6b0a4051696db8f6f467e779232f4034e.
    [hellen1-wbo-B_Cu.gbl, hellen1-wbo-B_Mask.gbs, hellen1-wbo-B_Paste.gbp, hellen1-wbo-B_Silkscreen.gbo, hellen1-wbo-Edge_Cuts.gm1, hellen1-wbo-F_Cu.gtl, hellen1-wbo-F_Mask.gts, hellen1-wbo-F_Paste.gtp]
2023-04-03 Revert " #281 CANH and CANL aren`t flipped now"
    This reverts commit b4a43784c1362e00eb4d70aed0e0eed805cb37d1.
    [hellen1-wbo.kicad_pcb, hellen1-wbo.kicad_sch]
2023-04-03 Revert "rev.0.5"
    This reverts commit b22bcf23b6024c6822f90be4ccf93951eb7eb129.
    [hellen1-wbo-B_Cu.gbl, hellen1-wbo-B_Mask.gbs, hellen1-wbo-B_Paste.gbp, hellen1-wbo-B_Silkscreen.gbo, hellen1-wbo-Edge_Cuts.gm1, hellen1-wbo-F_Cu.gtl, hellen1-wbo-F_Mask.gts, hellen1-wbo-F_Paste.gtp]
2023-04-03 add wbo 0.5
    [wbo-BOM.csv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]
2023-04-04 reusing duplicates
    [board_id_alpha4ch-h.csv, board_id_honda125-c.csv, board_ids.csv]
2023-04-06 Full skip of BOM lines without JLC PN #287
2023-04-12 vr-discrete simulation
    [vr-discrete-simulation.pdsprj]
2023-04-18 MM-0.4
    PPS <-> TPS2 fixed
    [mega-mcu144-BOM.csv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]
2023-05-11 MM 10k partnumber fix
    [mega-mcu144-BOM.csv]
2023-05-18 Board-ID for 4chan-i
    [board_id_alpha4ch-i.csv, board_ids.csv]
2023-05-19 honda d,e
    [board_ids.csv]
2023-05-19 MM-0.5
    Wakeup/O2S jumpers fix
    5VA, 3V3A discharge resistors
    Reduced 3V3 LED brightness
    Low quiescent current LDO
    [mega-mcu144-BOM.csv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]
2023-05-19 power-12and5V-0.2
    Reduced LED brightness
    Fixed VIGN LED connection
    [power_12and5V-BOM.csv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]
2023-05-19 Honda125 d, e ID
    [board_id_honda125-d.csv, board_id_honda125-e.csv]
2023-06-06 MM-64 symbol
    [Mod.SchLib]
2023-06-09 MM64 kicad symbol and footprint
2023-06-09 MM-64 BOOT1 pin, test vias
    [Mod.SchLib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]
2023-06-10 MM64 GM15 fix
    [mega-mcu64.GBL, mega-mcu64.GBO, mega-mcu64.GBP, mega-mcu64.GBS, mega-mcu64.GKO, mega-mcu64.GTL, mega-mcu64.GTO, mega-mcu64.GTP]
2023-06-15 add PG-DSO-12-11_VIA
    [cpl_rotations_db.csv]
2023-06-28 max9924 VR
    0.1 vr-discrete footprint compatible
    0.2 small-size version
    [hellen1-vr-max9924-B_Cu.gbl, hellen1-vr-max9924-B_Mask.gbs, hellen1-vr-max9924-B_Paste.gbp, hellen1-vr-max9924-B_Silkscreen.gbo, hellen1-vr-max9924-Edge_Cuts.gm1, hellen1-vr-max9924-F_Cu.gtl, hellen1-vr-max9924-F_Mask.gts, hellen1-vr-max9924-F_Paste.gtp]
2023-07-12 use pcbnew instead of pcbnewTransition
2023-07-12 use inch units for drill file
2023-07-13 don't have board name in yaml
2023-07-13 use revision.txt for board name
2023-07-13 reset kicad_pro file
2023-07-15 failing to export gerbers, failing to fail after failing to export gerbers #219 verbose messages
2023-07-25 vr-max9924 hall support
    [hellen1-vr-max9924-B_Cu.gbl, hellen1-vr-max9924-B_Mask.gbs, hellen1-vr-max9924-B_Paste.gbp, hellen1-vr-max9924-B_Silkscreen.gbo, hellen1-vr-max9924-Edge_Cuts.gm1, hellen1-vr-max9924-F_Cu.gtl, hellen1-vr-max9924-F_Mask.gts, hellen1-vr-max9924-F_Paste.gtp]
2023-07-25 max9924-0.3 hall support
    [hellen1-vr-max9924-B_Cu.gbl, hellen1-vr-max9924-B_Mask.gbs, hellen1-vr-max9924-B_Paste.gbp, hellen1-vr-max9924-B_Silkscreen.gbo, hellen1-vr-max9924-F_Cu.gtl, hellen1-vr-max9924-F_Mask.gts, hellen1-vr-max9924-F_Paste.gtp, hellen1-vr-max9924-F_Silkscreen.gto]
2023-07-25 Green led value fix
    [hellen1-vr-max9924-B_Cu.gbl, hellen1-vr-max9924-B_Mask.gbs, hellen1-vr-max9924-B_Paste.gbp, hellen1-vr-max9924-B_Silkscreen.gbo, hellen1-vr-max9924-Edge_Cuts.gm1, hellen1-vr-max9924-F_Cu.gtl, hellen1-vr-max9924-F_Mask.gts, hellen1-vr-max9924-F_Paste.gtp]
2023-07-25 2chan-g ID
    [board_id_alpha2ch-g.csv, board_ids.csv]
2023-07-30 Diode silk fix
    [power_12and5V.GBL, power_12and5V.GBO, power_12and5V.GBP, power_12and5V.GBS, power_12and5V.GKO, power_12and5V.GTL, power_12and5V.GTO, power_12and5V.GTP]
2023-08-02 Error if board prefix or suffix was not set https://github.com/andreika-git/hellen-one/issues/318
2023-08-02 export.sh should print helpful message if aux_axis_origin is missing fix #317
2023-08-15 MM176 symbol
    [Mod.SchLib]
2023-08-15 Upd mm-176 symbol
    [Mod.SchLib]
2023-08-18 generate board_ids.h
2023-08-26 MM100 symbol
    [Mod.SchLib]
2023-08-27 Upd MM176 footprint and symbol
    [Mod.PcbLib, Mod.SchLib]
2023-09-01 Upd MM176
    [mega-mcu176.GBL, mega-mcu176.GBO, mega-mcu176.GBP, mega-mcu176.GBS, mega-mcu176.GKO, mega-mcu176.GTL, mega-mcu176.GTO, mega-mcu176.GTP]
2023-09-01 add mega-mcu100
    [Mod.PcbLib, Mod.SchLib]
2023-09-04 DC_MOTOR page
    [DC_MOTOR.kicad_sch]
2023-09-08 vr-max9924 change designators >770
    [hellen1-vr-max9924-B_Cu.gbl, hellen1-vr-max9924-B_Mask.gbs, hellen1-vr-max9924-B_Paste.gbp, hellen1-vr-max9924-B_Silkscreen.gbo, hellen1-vr-max9924-Edge_Cuts.gm1, hellen1-vr-max9924-F_Cu.gtl, hellen1-vr-max9924-F_Mask.gts, hellen1-vr-max9924-F_Paste.gtp]
2023-09-08 MM176 designators fix
    [mega-mcu176-BOM.csv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]
2023-09-09 h112 boards
    [board_ids.csv]
2023-09-10 MM100 gnd poly fix
    [mega-mcu100-CPL.csv, mega-mcu100.DRL, mega-mcu100.GBL, mega-mcu100.GBO, mega-mcu100.GBP, mega-mcu100.GBS, mega-mcu100.GKO, mega-mcu100.GTL]
2023-09-26 MM100_0.2 sym & fp
    [Mod.PcbLib, Mod.SchLib]
2023-09-26 MM100_0.2 export
    [mega-mcu100-BOM.csv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]
2023-10-01 MM100 kicad sym & fp
2023-10-03 MM 176 0.2
    3.3V short circuit fix
    [mega-mcu176-BOM.csv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]
2023-10-03 Board ID 8ch-c
    [board_id_alpha8ch-c.csv, board_ids.csv]
2023-10-28 #342 5% board ID capacitor
    [mega-mcu100-BOM.csv, mega-mcu100-f7-BOM.csv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]
2023-11-26 MM144 board ID 5% capacitor #342
    Revision not changed
    [mega-mcu144-BOM.csv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]
2023-11-26 MM144 schematics transparency
    https://github.com/rusefi/alphax-4chan/issues/168
2023-11-30 hd81 board id
    [board_id_hd81-a.csv, board_ids.csv]
2023-12-02 Readability, #343
    [wbo-BOM.csv]
2023-12-09 Verbose error for negative positions in gerbers when the origin is wrong https://github.com/andreika-git/hellen-one/issues/350
2023-12-10 Pages moved to kicad6-libraries
    [DC_MOTOR_0.1.kicad_sch]
2023-12-11 unintended *.kicad_pro push #351
2023-12-11 working on unintended *.kicad_pro push #351
2024-01-01 more IDs
    [board_id_gdi4chan-a.csv, board_id_uaefi-b.csv, board_ids.csv]
2024-01-02 Fix #356
    [mega-mcu100-BOM.csv, mega-mcu100-f7-BOM.csv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]
2024-01-21 AlphaX Bronze ID
    [board_id_alphax_bronze-a.csv, board_ids.csv]
2024-01-28 #353
    https://github.com/rusefi/uaefi/issues/32
    [mega-mcu100-BOM.csv, mega-mcu100-f7-BOM.csv, mega-mcu144-BOM.csv, mega-mcu176-BOM.csv, mega-mcu64-BOM.csv]
2024-02-01 add uaefi module
    (cherry picked from commit 4367e12cdd49009b2596e7554abdf29bfed9a960)
    [uaefi-module-B_Cu.gbl, uaefi-module-B_Mask.gbs, uaefi-module-B_Paste.gbp, uaefi-module-B_Silkscreen.gbo, uaefi-module-Edge_Cuts.gm1, uaefi-module-F_Cu.gtl, uaefi-module-F_Mask.gts, uaefi-module-F_Paste.gtp]
2024-02-01 upd
    (cherry picked from commit 4f970e196f9c5e040285cea777dc780da0cf0971)
    [uaefi-module-B_Cu.gbl, uaefi-module-B_Mask.gbs, uaefi-module-B_Paste.gbp, uaefi-module-B_Silkscreen.gbo, uaefi-module-Edge_Cuts.gm1, uaefi-module-F_Cu.gtl, uaefi-module-F_Mask.gts, uaefi-module-F_Paste.gtp]
2024-02-01 upd
    (cherry picked from commit b8ea7a44fceb485a4d7f0aa9c45853e21ed6fed2)
    [uaefi-module-B_Cu.gbl, uaefi-module-B_Mask.gbs, uaefi-module-B_Paste.gbp, uaefi-module-B_Silkscreen.gbo, uaefi-module-Edge_Cuts.gm1, uaefi-module-F_Cu.gtl, uaefi-module-F_Mask.gts, uaefi-module-F_Paste.gtp]
2024-02-01 upd
    (cherry picked from commit f72cb8a7aa8f51ad14642465540268cf9a83f84a)
    [hellen1-uaefi-B_Cu.gbl, hellen1-uaefi-B_Mask.gbs, hellen1-uaefi-B_Paste.gbp, hellen1-uaefi-B_Silkscreen.gbo, hellen1-uaefi-Edge_Cuts.gm1, hellen1-uaefi-F_Cu.gtl, hellen1-uaefi-F_Mask.gts, hellen1-uaefi-F_Paste.gtp]
2024-02-01 upd
    (cherry picked from commit bbad4693f95ac5f2020cb44a34657bb3311a26fc)
    [uaefi.DRL, uaefi.GBL, uaefi.GBO, uaefi.GBP, uaefi.GBS, uaefi.GKO, uaefi.GTL, uaefi.GTO]
2024-02-03 Uaefi BOM
    [hellen1-uaefi.csv, uaefi-BOM.csv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]
2024-02-04 Add excludeBOM=True to hellen-one-kicad-bom-plugin.py https://github.com/andreika-git/hellen-one/issues/363
2024-02-06 C123 DNP fix
    [mega-mcu100-BOM.csv, mega-mcu100-f7-BOM.csv, mega-mcu144-BOM.csv, mega-mcu176-BOM.csv, mega-mcu64-BOM.csv]
2024-02-13 UAEFI module 0.2
    [hellen1-uaefi.csv, hellen1-uaefi.kicad_pcb, hellen1-uaefi.kicad_sch, uaefi-BOM.csv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]
2024-02-13 Update uaefi footprint
2024-02-13 Upd uaefi module
    [hellen1-uaefi-B_Cu.gbl, hellen1-uaefi-B_Mask.gbs, hellen1-uaefi-B_Paste.gbp, hellen1-uaefi-B_Silkscreen.gbo, hellen1-uaefi-Edge_Cuts.gm1, hellen1-uaefi-F_Cu.gtl, hellen1-uaefi-F_Mask.gts, hellen1-uaefi-F_Paste.gtp]
2024-02-16 Uaefi module square pads short fix
    [hellen1-uaefi-B_Cu.gbl, hellen1-uaefi-B_Mask.gbs, hellen1-uaefi-B_Paste.gbp, hellen1-uaefi-B_Silkscreen.gbo, hellen1-uaefi-Edge_Cuts.gm1, hellen1-uaefi-F_Cu.gtl, hellen1-uaefi-F_Mask.gts, hellen1-uaefi-F_Paste.gtp]
2024-03-10 33810 module
    [hellen1-mcz33810-B_Cu.gbl, hellen1-mcz33810-B_Mask.gbs, hellen1-mcz33810-B_Paste.gbp, hellen1-mcz33810-B_Silkscreen.gbo, hellen1-mcz33810-Edge_Cuts.gm1, hellen1-mcz33810-F_Cu.gtl, hellen1-mcz33810-F_Mask.gts, hellen1-mcz33810-F_Paste.gtp]
2024-03-10 DC driver module, upd mcz33810
    [hellen1-mcz33810-B_Cu.gbl, hellen1-mcz33810-B_Mask.gbs, hellen1-mcz33810-B_Paste.gbp, hellen1-mcz33810-B_Silkscreen.gbo, hellen1-mcz33810-Edge_Cuts.gm1, hellen1-mcz33810-F_Cu.gtl, hellen1-mcz33810-F_Mask.gts, hellen1-mcz33810-F_Paste.gtp]
2024-03-11 Upd uaefi module #372
    [hellen1-uaefi-B_Cu.gbl, hellen1-uaefi-B_Mask.gbs, hellen1-uaefi-B_Paste.gbp, hellen1-uaefi-B_Silkscreen.gbo, hellen1-uaefi-Edge_Cuts.gm1, hellen1-uaefi-F_Cu.gtl, hellen1-uaefi-F_Mask.gts, hellen1-uaefi-F_Paste.gtp]
2024-03-26 Upd mcz33810 borders #376
    [hellen1-mcz33810-B_Cu.gbl, hellen1-mcz33810-B_Mask.gbs, hellen1-mcz33810-B_Paste.gbp, hellen1-mcz33810-B_Silkscreen.gbo, hellen1-mcz33810-Edge_Cuts.gm1, hellen1-mcz33810-F_Cu.gtl, hellen1-mcz33810-F_Mask.gts, hellen1-mcz33810-F_Paste.gtp]
2024-03-26 #376 motor-driver
    [hellen1-motor-driver-B_Cu.gbl, hellen1-motor-driver-B_Mask.gbs, hellen1-motor-driver-B_Paste.gbp, hellen1-motor-driver-B_Silkscreen.gbo, hellen1-motor-driver-Edge_Cuts.gm1, hellen1-motor-driver-F_Cu.gtl, hellen1-motor-driver-F_Mask.gts, hellen1-motor-driver-F_Paste.gtp]
2024-03-27 Typo fix
    [hellen1-vr-max9924.kicad_sch]
2024-03-27 vr-discrete 0.5 #375
    [hellen1-vr-discrete.csv, hellen1-vr-discrete.kicad_pcb, hellen1-vr-discrete.kicad_sch, vr-discrete-BOM.csv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]
2024-04-03 hd81-b ID
    [board_id_hd81-b.csv, board_ids.csv]
2024-04-12 install kicad 8
2024-04-12 Turn tabs into spaces for Kicad 8
2024-04-16 Revert "Turn tabs into spaces for Kicad 8"
    This reverts commit 1cc79bec8c438d7a05ef36f1a818c5a984a02696.
2024-04-16 Revert "install kicad 8"
    This reverts commit 8ebad9188c8b2a8bc4b0ac1647d824db7aaa80bd.
2024-04-17 Turn tabs into spaces for Kicad 8
    (cherry picked from commit 1cc79bec8c438d7a05ef36f1a818c5a984a02696)
2024-04-17 install kicad 8
    (cherry picked from commit 8ebad9188c8b2a8bc4b0ac1647d824db7aaa80bd)
2024-04-17 Revert "Turn tabs into spaces for Kicad 8"
    This reverts commit 7abdf7c3bdf04f039d9991a359d069a8ed3db7f3.
2024-04-17 Revert "Revert "Turn tabs into spaces for Kicad 8""
    This reverts commit 99740ac85a89b26658599ab65ca55de59843b8e1.
2024-05-13 shared replace
    [unified-replace-power-supply.csv, unified-replace-wbo.csv]
2024-05-13 154hyundai-e ID
    [board_id_154hyundai-e.csv, board_ids.csv]
2024-05-14 #353 1uf
    [mega-mcu144-BOM.csv]
2024-05-25 too much to support
    [mega-mcu176-BOM.csv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]
2024-06-03 uaefi121-a ID
    [board_id_uaefi121-a.csv, board_ids.csv]
2024-06-04 Power 12&5 changelog
2024-07-02 polaris-112-a ID
    [board_id_polaris-112-a.csv, board_ids.csv]
2024-07-25 uniform replaces
    [unified-replace-wbo.csv, unified-replace.csv]
2024-08-22 Better error handling of non-ASCII chars in BOM https://github.com/rusefi/hd81/issues/53
2024-09-11 GDI-4chan-b ID
    [board_id_gdi4chan-b.csv, board_ids.csv]
2024-09-13 F410 replacement
    [unified-replace-power-supply.csv]
2024-10-28 hd81-d ID
    [board_id_hd81-d.csv, board_ids.csv]
2024-12-17 Silver-b ID
    [board_id_alphax_silver-b.csv, board_ids.csv]
2025-01-02 Chuma ID
    [board_id_chuma-a.csv, board_ids.csv]
2025-01-18 power-0.3 VBAT reverse diode
    [power_12and5V-BOM.csv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]
2025-01-24 Gold ID
    [board_id_alphax_gold-a.csv, board_ids.csv]
2025-01-25 #398 BAS416
    [power_12and5V-BOM.csv]
2025-02-02 E92 ID
    [board_id_gm-e92-a.csv, board_ids.csv]
2025-02-14 hd81-e ID
    [board_id_hd81-e.csv, board_ids.csv]
2025-02-14 mm144-0.7 upd
    [mega-mcu144.GBL, mega-mcu144.GBO, mega-mcu144.GBP, mega-mcu144.GBS, mega-mcu144.GKO, mega-mcu144.GTL, mega-mcu144.GTO, mega-mcu144.GTP]
2025-03-13 some board have three!
    [unified-replace.csv]
2025-03-21 ID ua-OBD1
    [board_id_uaefi-Honda-OBD1-c.csv, board_ids.csv]
2025-04-16 135 Subaru 2011 ID
    [board_id_135subaru2011-a.csv, board_ids.csv]
2025-04-27 hw-nano ID
    [board_id_hw-nano-a.csv, board_ids.csv]
2025-04-30 U110 JLC footprint warning
    [mega-mcu100-BOM.csv]
2025-05-02 Export mod
    [mega-mcu100-f7-BOM.csv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]
2025-05-03 #353 mm100
    [mega-mcu100-BOM.csv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]
2025-05-03 #353 mm64
    [mega-mcu64-BOM.csv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]
2025-05-03 uaefi-pro ID
    [board_id_uaefi-pro-e.csv, board_ids.csv]
2025-05-12 super-uaefi ID
    [board_id_super-uaefi-a.csv, board_ids.csv]
2025-06-30 subaru135-b ID 407
    [board_id_135subaru2011-b.csv, board_ids.csv]
2025-06-30 e38-b ID 408
    [board_id_gm-e38-b.csv, board_ids.csv]
2025-08-21 e38-c ID
    [board_id_gm-e38-c.csv, board_ids.csv]
2025-11-05 power12-5 increase 5V capacitance
    [power_12and5V-BOM.csv]
2025-11-19 uaefi: simplified pattern for uaefi board
2025-12-21 MM100 2MB
    [mega-mcu100-BOM.csv]
2026-02-07 112 ID
    [board_id_polaris-112-b.csv, board_ids.csv]
2026-02-18 e92-b ID
    [board_id_gm-e92-b.csv, board_ids.csv]
2026-03-22 wbo 0.6
    [hellen1-wbo-B_Cu.gbl, hellen1-wbo-B_Mask.gbs, hellen1-wbo-B_Paste.gbp, hellen1-wbo-B_Silkscreen.gbo, hellen1-wbo-Edge_Cuts.gm1, hellen1-wbo-F_Cu.gtl, hellen1-wbo-F_Mask.gts, hellen1-wbo-F_Paste.gtp]
2026-03-29 ID gold-b
    [board_id_alphax_gold-b.csv, board_ids.csv]
2026-04-03 WBO CPL negative bottom fix
    [hellen1-wbo-all-pos.csv, wbo-CPL.csv]
2026-05-09 6.8k 0402
    [global-replace.csv]
2026-05-28 Upd global replace
    [Mod.SchLib, global-replace.csv]
2026-06-11 z31 ID
    [board_id_z31-a.csv, board_ids.csv]
2026-06-17 Upd replace
    [Mod.PcbLib, Mod.SchLib, global-replace.csv]
2026-06-24 Upd global-replace, Mod lib
    [Mod.PcbLib, Mod.SchLib, global-replace.csv]
2026-08-12 uaBrain a ID
    [Mod.PcbLib, Mod.SchLib, board_id_uaBrain-a.csv, board_ids.csv]
2026-08-14 hd54 ID
    [board_id_hd54-a.csv, board_ids.csv]
2026-09-05 KiCad 10
2026-09-10 KiCad 10 fix (some file names have changed)
2026-09-28 3D WBO, VR, Motor thickness fix
    [hellen1-motor-driver.kicad_pcb, hellen1-vr-discrete.kicad_pcb, hellen1-vr-max9924.kicad_pcb, hellen1-wbo.kicad_pcb]
